yilo425/wheel-leg-robot-delivery/arm/k230_20261018/arm_k230_release_20261018/docs/evidence/cam_detect.jpg

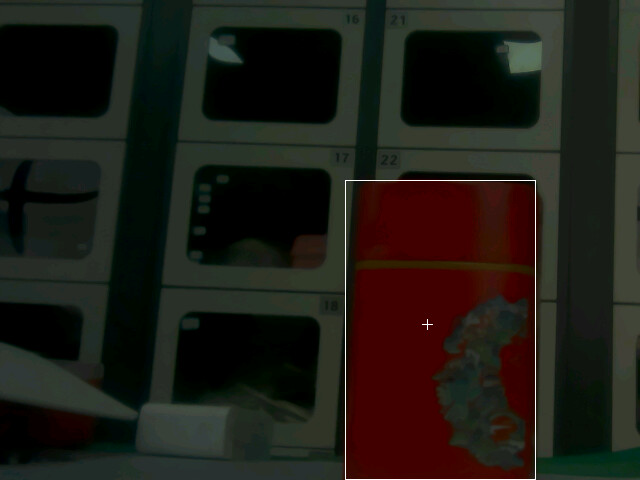
arm/k230_20261018/arm_k230_release_20261018/docs/evidence/cam_detect.jpg
