yilo425/wheel-leg-robot-delivery/doc/board_pinout.md

# ACG720 / GW5AT-138 板载资源与引脚分配

> 来源：`ACG720-138&60K通用管脚分配表.xlsx` + `ACG720-138&60K通用原理图.pdf`
> 器件：**GW5AT-138**（PBGA484A，484 球，22×22）
> 提取日期：2026-10-13

---

## 1. 器件型号的确认过程

**型号走过两次弯路，最终靠芯片自己报的 ID 定案**（详见 §8）：

| 阶段 | 判断 | 依据 | 结果 |
|---|---|---|---|
| 1 | `GW5A-25A` | 口头信息 | ❌ |
| 2 | `GW5AST-138` | 原理图 + 球号范围（22×22 需 PBGA484A） | ❌ 漏看 "S" |
| 3 | **`GW5AT-138`** | **芯片实测 ID = `0x0011081B` = `GW5AT_138_ID`** | ✅ |

### 支持这个判断的证据

| 证据 | 内容 |
|---|---|
| **芯片实测 ID** ★ | `0x0011081B`，对应高云 ID 表里的 `GW5AT_138_ID` |
| 原理图 `U1A/U1B/U1D` | `GW5AT-138K-PG484A`（**没有 S**）|
| 文件名 | "ACG720-**138&60K**通用" |
| 球号范围 | 表里有 `Y18`/`AA21`/`AB20` → 需要 **22 行**（PBGA484A）<br>GW5A-25A 的 UBGA324 只有 **18 行**，装不下 |
| 官网开发板列表 | 同时存在 `DK_START_GW5AST-LV138...` 和 `DK_START_GW5AT-LV138...` —— **两个器件都真实存在** |

> ⚠️ **注意区分**：`GW5AT-138` 和 `GW5AST-138` 是**两个不同的器件**，ID 差一位：
> ```
> 0x0011081B  GW5AT_138_ID     ← 本板
> 0x0001081B  GW5AST_138_ID
> ```

### ⚠️ 但当前装的 Gowin 版本不支持它

**Gowin EDA V1.9.11.03 Education 的器件列表里没有 `GW5AT-138`**，
所以**现在既不能综合、也不能烧录**。需要装 V1.9.12+（建议 Standard 版）。

**详见 §8。**

仿真库**仍然用 `gw5a`** —— `IDE\simlib` 下只有 `gw1n`/`gw2a`/`gw5a` 三个目录。

---

## 2. 板载固定资源（这些引脚不可改）

| 资源 | 球号 | 备注 |
|---|---|---|
| **系统时钟 50MHz** | `Y18` | FPGA_GCLK1，MRCC 时钟专用脚 |
| **按键 S0** | `F15` | |
| **按键 S1** | `A20` | |
| 按键 S2 / S3 | `B20` / `A21` | 备用 |
| **按键 S4** | `B21` | 板上标注为**复位键** |
| **LED0~LED3** | `M22` `N22` `L21` `K21` | 本工程用 |
| LED4~LED8 | `K22` `J22` `H22` `M21` `N19` | 本工程借来做状态指示 |
| **串口 RX** | `F16` | FPGA_UART_RX ← ARM TX （**2026-10-17 从 J21 改到 GPIO0_26**）|
| **串口 TX** | `C19` | FPGA_UART_TX → ARM RX （**2026-10-17 从 M15 改到 GPIO0_25**）|
| I2C SDA / SCL | `D19` / `C20` | **已接 TOF（VL53L0X）**。★ 2026-10-17 从板载 I2C 排针（`M16`/`M13`）**改到 GPIO0 扩展口**：板载那排的针序在丝印上无法确认（标签只覆盖部分列），没有万用表时插错 3V3/GND 会**烧模块**；GPIO0 每个孔都印着球号，零歧义。代价：没有板载 4.7k 上拉，靠模块自带 10k → **I2C 速率降到 100kHz** |
| 调试串口 TX | `M15` | `uart_tx_dbg`（和发给 ARM 的是同一路数据）。⚠️ 实测**接板载 USB 转串口收不到数据**，要接 USB-TTL 才能用 |
| 红外 IR | `F21` | |
| 蜂鸣器 BEEP | `N19` | ⚠️ 与 LED8 同球，需确认 |

### ⚠️ 两处要上板确认

1. **`LED8` 和 `BEEP` 都是 `N19`** —— 可能表笔误，也可能跳线二选一。
   冲突的话把 `speed_scale_dbg[1]` 改到 `GPIO0_22`（`B17`）。
2. **按键极性** —— 表里没写，本工程按**低有效**（按下=0，靠上拉）。
   上板先点灯验证：不按应该是高电平。

---

## 3. GPIO0 扩展排针（36 针，本工程的主战场）

```
GPIO0_0  = A13     GPIO0_9  = E14     GPIO0_18 = D17     GPIO0_27 = E17
GPIO0_1  = A14     GPIO0_10 = C13     GPIO0_19 = C17     GPIO0_28 = D20
GPIO0_2  = A15     GPIO0_11 = B13     GPIO0_20 = E16     GPIO0_29 = C20
GPIO0_3  = A16     GPIO0_12 = D14     GPIO0_21 = D16     GPIO0_30 = E19
GPIO0_4  = A18     GPIO0_13 = D15     GPIO0_22 = B17     GPIO0_31 = D19
GPIO0_5  = A19     GPIO0_14 = C14     GPIO0_23 = B18     GPIO0_32 = F18
GPIO0_6  = F13     GPIO0_15 = C15     GPIO0_24 = C18     GPIO0_33 = E18
GPIO0_7  = F14     GPIO0_16 = B15     GPIO0_25 = C19     GPIO0_34 = F19
GPIO0_8  = E13     GPIO0_17 = B16     GPIO0_26 = F16     GPIO0_35 = F20
```

> 这些球号同时也是**并口 AD/DA、VGA 子板**的引脚（表里 `ad_data[0]=C13` 等）。
> **不插那块子板**才能这么用。

---

## 4. 本工程的引脚分配（`constraints/pin_table.csv`）

**42 个引脚，全部来自板上真实资源，无一处猜测。**

> ⚠️ **本表以 `constraints/pin_table.csv` 为准**（综合时真正用它生成 `top.cst`）。
> 两处曾经不一致、已修（2026-10-17）：升降腿从 3 根线扩成了 6 根
> （`lift_pwm[2]` + `lift_lim_n[2]` + `lift_fault_n[2]`），这里差点没跟上。
> 图片/Excel 里的旧编号不要拿来接线。

### 4.1 板上固定（不可改）

> ⚠️ **串口已经不算"固定"了**（2026-10-17 改）：原本的 `uart_tx/uart_rx`
> 是 `M15`/`J21`，但实测照片确认它们引到板子右上角标着 `UART / TXD / RXD`
> 的**两个小焊盘**上，**插不了杜邦线**。已改到 GPIO0 扩展口的两个空闲脚
> （`C19` / `F16`），见 §4.2。板载 USB 转串口那条路这版固件不再使用。

| 信号 | 引脚 | 说明 |
|---|---|---|
| `clk_50m` | `Y18` | |
| `rst_key_n` | `B21` | S4 |
| `key[0]` / `key[1]` | `F15` / `A20` | S0 / S1 |
| `led[0..3]` | `M22` `N22` `L21` `K21` | |
| ~~`uart_tx` / `uart_rx`~~ | ~~`M15` / `J21`~~ | ❌ 只有焊盘，插不了线 → 已改到 `C19`/`F16` |

### 4.2 GPIO0 —— **建议分配，请按此接线**

> ★ **轮子编号（按位置，全项目统一）**：
> ```
> 0 = 左前 FL -> 左轮   1 = 右前 FR -> 右轮
> 2 = 左后 RL -> 左轮   3 = 右后 RR -> 右轮
> ```
> `STEER_COEF` = `+1, -1, +1, -1`（左 +1 / 右 −1）。
> **必须和 `rtl/app/motion_decision.v` 保持一致** —— 不一致会让转向整个反过来。
>
> 这是**接线约定**，不是板上固定接线。谁先定谁省事。
> 下标约定：**0=左前 1=右前 2=左后 3=右后**。
> ⚠️ 装反了车会原地打转。接好线后**先架空轮子验证转向**。

| 信号 | 引脚 | GPIO0 | 说明 |
|---|---|---|---|
| `m_pwm[0..3]` | `A13` `A14` `A15` `A16` | _0~3 | 四路 PWM |
| `m_dir[0..3]` | `A18` `A19` `F13` `F14` | _4~7 | 四路方向 |
| `m_en` | `E13` | _8 | 驱动使能（**默认下拉=上电停车**）|
| `enc_a[0]` / `enc_b[0]` | `E14` / `C13` | _9 / _10 | 左前 |
| `enc_a[1]` / `enc_b[1]` | `B13` / `D14` | _11 / _12 | 右前 |
| `enc_a[2]` / `enc_b[2]` | `D15` / `C14` | _13 / _14 | 左后 |
| `enc_a[3]` / `enc_b[3]` | `C15` / `B15` | _15 / _16 | 右后 |
| `lift_pwm[0]` / `lift_pwm[1]` | `B16` / `D17` | _17 / _18 | 输出：前腿组 / 后腿组舵机 PWM |
| `lift_lim_n[0]` / `lift_lim_n[1]` | `C17` / `B17` | _19 / _22 | 输入：前/后腿抬起到位（**低有效**）|
| `lift_fault_n[0]` / `lift_fault_n[1]` | `B18` / `C18` | _23 / _24 | 输入：前/后腿舵机故障（**低有效**，不接=1=正常）|
| `goal_reached` | `E16` | _20 | 输入：终点限位（**低有效**，接地=到达；未接=上拉=未到达）|
| `error_flag` | `D16` | _21 | 输出：故障指示 |
| **`uart_tx`** | **`C19`** | **_25** | 输出：→ ARM 的 **RX**（2026-10-17 新增）|
| **`uart_rx`** | **`F16`** | **_26** | 输入：← ARM 的 **TX**（2026-10-17 新增）|
| **`sr04_trig`** | **`F20`** | **_35** | 输出：HC-SR04 触发（`TOF_IF=1` 时用）|
| **`sr04_echo`** | **`E18`** | **_34** | 输入：HC-SR04 回波（**必须 ≤3.3V！**）|

> ★ **接 ARM 的接法（交叉！）**：
> ```
> ARM 排针 11 (UART2_TXD) ──► FPGA 的 F16 孔
> ARM 排针 13 (UART2_RXD) ◄── FPGA 的 C19 孔
> ARM GND ──────────────────── FPGA 的 GND 孔（扩展口上就印着 GND）
> ```
> 两块板都是 3.3V，直连。**GND 那根不能省**。

> ★ **接 HC-SR04 超声波（`TOF_IF=1`）**：
> ```
> 模块 Vcc  ──  3V3（底排第 6）      ⚠️ 先按 3.3V 供电，别上 5V
> 模块 Gnd  ──  GND（顶排第 6）
> 模块 Trig ──  F20（顶排第 1）
> 模块 Echo ──  E18（顶排第 2）
> ```
> ⚠️ **ECHO 是输入，模块按 5V 供电时它会输出 5V —— 会打死 3.3V 的 IO。**
> 宁可欠压不工作（3.3V 供电），也不能过压。要 5V 供电必须在 ECHO 上串
> 1k+2k 分压（5V→3.33V）。
>
> 原理：拉高 TRIG 10µs → 模块发 8 个 40kHz 波 → ECHO 高电平宽度 = 往返时间。
> 声速取 343m/s，`距离(mm) = ticks×450 >> 17`（50MHz 下，误差 <0.15%）。

### 4.3 LED4~8 借来做状态指示

| 信号 | 引脚 | 板上 |
|---|---|---|
| `state_dbg[0..2]` | `K22` `J22` `H22` | LED4~6（状态机编码）|
| `speed_scale_dbg[0..1]` | `M21` `N19` | LED7~8（速度档）|

**GPIO0 还剩 11 个（`_25`~`_35`）** + I2C 排针 + 8 个拨码开关输入，留给 IMU / 后向 TOF / 舵机反馈。

---

## 5. 为什么把两个接口从顶层去掉了

原来 `top.v` 需要 **119 位引脚**，而板子可用 IO 只有 **约 53 个** —— 超出 66 位，**物理上放不下**。

| 去掉的 | 位数 | 理由 |
|---|---|---|
| `uart_rx_ok_cnt` 等 4 个统计端口 | **64** | **纯仿真用**。板上看不到；联调信息走 TELEMETRY 从串口发出。改成 `top.v` 内部 wire，`tb_top_integration` 用层次引用读 |
| `dist_mm[15:0]` + `dist_valid` + `dist_err` | **18** | **16 位并行 TOF 现实中不存在**。真实模块走 I2C/UART（2 根线）。**已落地**：`tof_driver` 走 I2C（`M13`/`M16`），距离在片内组织成 `dist_mm`；`DIST_STUB_MM` 参数只在 `TOF_ENABLE=0` 的联调模式下生效 |

**去掉后 40 位，加上 TOF 的 2 根 I2C = 42 位，稳稳放下，还留 11 个 GPIO0 备用。**

> 这不是"砍功能"，是设计修正：统计端口只在仿真里有意义；TOF 该由一个内部驱动模块解析后输出 `dist_mm`，而不是从 16 根线进来。

---

## 6. 怎么改引脚

**不要直接编辑 `constraints/top.cst`** —— 它是生成的，会被覆盖。

```powershell
# 1) 改 constraints/pin_table.csv（只填 pin 那一列）
# 2) 重新生成
python tools/gen_cst.py
```

脚本会检查：漏填、**重复球号**、引脚名格式（防止把封装脚位序号当成球号）、电气属性取值。

> 手抄 140 行约束最危险的错误不是漏写，而是**把 `m_pwm[2]` 抄成 `m_pwm[1]` 的球号**
> —— Gowin **不会报错**，结果是两个轮子一起动。

---

## 7. 不用的板载资源

| 资源 | 引脚数 | 说明 |
|---|---|---|
| DDR3 | 48 | 本工程不用 |
| USB2.0 (CY7C68013) | 30 | 不用 |
| 以太网 | 15 | 不用 |
| HDMI ×2 | 18 | 不用 |
| TFT + 触摸屏 | 26 | 不用（除非要加显示）|
| 摄像头接口 | 15 | 不用（ARM 侧做视觉）|
| ES8388 音频 | 5 | 不用 |
| 并口 ADC/DAC | 7 | 不用（与 GPIO0 复用，插了子板就不能用 GPIO0）|
| 74HC595 数码管 | 3 | 不用 |
| SD 卡 | 6 | 不用 |

---

## 8. ★ 器件型号的最终确认（2026-10-13，实测）

**型号走过两次弯路，最终靠芯片自己报的 ID 定案。**

| 阶段 | 判断 | 依据 | 结果 |
|---|---|---|---|
| 1 | `GW5A-25A` | 口头信息 | ❌ 错 |
| 2 | `GW5AST-138` | 原理图 `GW5AT-138K-PG484A` + 引脚表球号范围（22×22 需 PBGA484A） | ❌ 仍错（漏看有无 "S"）|
| 3 | **`GW5AT-138`** | **芯片实测 ID = `0x0011081B`** | ✅ **对** |

### 怎么定的案

`programmer_cli` 连上后读出芯片 ID，再从 `jtagserver.exe` 里挖出高云自己的 ID 表：

```
u0001481B  GW5AT_60_ID
u0011081B  GW5AT_138_ID      ← 实测读到的就是这个
u0001081B  GW5AST_138_ID     ← 138 带 S 的是这个（差一位）
u0001281B  GW5A_25_ID
```

### 实测数据

```
Target Cable:  Gowin USB Cable(FT2CH)
1 device(s) found!
ID Code is:     0x0011081B
User Code is:   0x00009480
Status Code is: 0x00026020
```

### ⚠️ 由此引出的硬约束：需要支持 GW5AT-138 的 Gowin 版本

**Gowin EDA V1.9.11.03 Education 不支持 GW5AT-138**（实测）。

它的 `IDE\data\device\device_package.csv` 里 GW5AT 系列只有：

```
gw5ast138b-011  GW5AST-138B  PBGA484A
gw5ast138c-007  GW5AST-138C  PBGA484A
gw5at60b-007    GW5AT-60B    UBGA225
gw5at60b-002    GW5AT-60B    PBGA484A
```

`programmer_cli --device` 的合法取值也只有 14 个，**没有 GW5AT-138**：

```
GW1N-1P5C GW5AST-138B GW5AST-138C GW5AT-60B GW5AS-25B GW1NZ-1
GW1NSR-4C GW1N-9C GW1NR-9C GW2A-18C GW2AR-18C GW5A-25A GW5A-25B GW5ART-15A
```

**症状**：能通信、能读 ID，但 `--run 2/3` 报 `ID code mismatch`，而且**根本没法为它综合**（器件目录里没有）。

**解决**：装 **Gowin EDA V1.9.12 或更新**；建议用 **Standard 版**（免费 license，器件支持最全，教育版器件是精简的）。装的时候**路径必须纯 ASCII**。

> **最省事的办法**：直接问小梅哥 / 看课程资料用的是哪个版本。
