yilo425/wheel-leg-robot-delivery/doc/interface_delivery.md

# 接口交付文档 —— 轮足复合式机器人

> **文档定位**：这是**发给队友的第一份文件**。看到这份文档的人不需要了解 RTL 内部实现，
> 只需要知道「我要接什么线、发什么数据、给我什么数据」。
>
> **配套文档**（需要深入时再看）：
> - `design_guide.md` —— 每个模块的内部运行逻辑（FPGA 组看）
> - `uart_frame_protocol.md` —— 协议完整定义（ARM 组看）
> - `interface_spec.md` —— 模块级信号定义
> - `team_handoff.md` —— 分工与进度总览
>
> **更新时间**：2026-10-04

---

## 0. 这份文档怎么用

| 你是谁 | 优先读 | 你要产出什么 |
|---|---|---|
| **B（ARM 视觉与通信）** | §2、§3、§6 | 摄像头 → 目标检测 → UART 发 `VISION_RESULT` |
| **C（机械与集成）** | §4、§5、§6 | 填 §4 的信息表；确认 §5 的引脚接线 |
| **A（FPGA）** | 全部 | 按 §4/§5 的答复继续设计 |

**§1 所有人都要看** —— 那是整块板子的对外接口全貌。

---

## 1. FPGA 对外接口总表

**开发板**：小梅哥 ACG720 / **GW5AT-138**（`GW5AT-LV138PG484AC1/I0`，PBGA484A）
　　　　⚠️ 是 **GW5AT** 不是 GW5AST（ID 差一位）；工具链见 `doc/toolchain_gowin_modelsim.md`
**顶层模块**：`rtl/top.v`
**端口总数**：22

### 1.1 已实现且仿真验证的接口

| 端口 | 方向 | 位宽 | 电平 | 作用 | 接到哪 |
|---|---|---|---|---|---|
| `clk_50m` | in | 1 | LVCMOS33 | 板载 50MHz 晶振 | 板载 |
| `rst_key_n` | in | 1 | LVCMOS33 | 复位按键，**低有效** | 板载按键 |
| `m_pwm[3:0]` | out | 4 | LVCMOS33 | 4 路电机 PWM | 驱动板 PWM 输入 |
| `m_dir[3:0]` | out | 4 | LVCMOS33 | 4 路电机方向，**1=正转** | 驱动板 DIR 输入 |
| `m_en` | out | 1 | LVCMOS33 | 驱动器使能，**高有效** | 驱动板 EN/STBY |
| `enc_a[3:0]` | in | 4 | LVCMOS33 | 编码器 A 相 | 编码器 A |
| `enc_b[3:0]` | in | 4 | LVCMOS33 | 编码器 B 相 | 编码器 B |
| `key[1:0]` | in | 2 | LVCMOS33 | **低有效**：`key[0]`=启动/停止<br>`key[1]`=**急停** | 板载按键 |
| `led[3:0]` | out | 4 | LVCMOS33 | 状态指示，见 §6.2 | 板载 LED |
| `state_dbg[2:0]` | out | 3 | LVCMOS33 | 主状态机状态（调试） | 预留/逻辑分析仪 |
| `speed_scale_dbg[1:0]` | out | 2 | LVCMOS33 | 速度档位（调试） | 预留/逻辑分析仪 |
| `error_flag` | out | 1 | LVCMOS33 | 曾进入过安全停车（锁存） | 预留/逻辑分析仪 |

**轮编号约定**（★ 全项目统一，机械组按这个接线）：

| 索引 | 位置 | 左/右 | `STEER_COEF` |
|---|---|---|---|
| 0 | 左前 FL | 左 | **+1** |
| 1 | 右前 FR | 右 | **−1** |
| 2 | 左后 RL | 左 | **+1** |
| 3 | 右后 RR | 右 | **−1** |

> **按位置编号**（FL/FR/RL/RR），不是按左右分组。
> 系数和 = 0，所以转向不会附带整体加减速。
>
> ⚠️ **这里曾经出过一个真 bug**：`motion_decision.v` 原来按「0,1=左；2,3=右」
> （按侧面分组），而引脚表按「0=左前 1=右前 2=左后 3=右后」（按位置分组）。
> 两边各自自洽，**合起来就是错的** —— 机械组按位置接好线，转向会整个反过来。
> 2026-10-13 统一成**按位置**（也是 4 轮机器人的通用约定）。

> ⚠️ **这个编号必须由机械组确认**（见 §4）。装反了会导致转向反向。

### 1.2 已定义但**尚未接入 RTL** 的接口

这些端口在 `top.v` 上**已经引出并留了 TODO**，但内部逻辑还没接上：

| 端口 | 方向 | 位宽 | 作用 | 阻塞原因 |
|---|---|---|---|---|
| `dist_mm[15:0]` | — | 16 | TOF 距离读数（mm） | ✅ 已实现（`tof_driver`，I2C）。<br>⚠️ 这三根**不再是 top 的端口**，是 `top.v` §1.5 的内部 wire |
| `dist_valid` | — | 1 | TOF 数据有效 | 同上 |
| `dist_err` | — | 1 | TOF 读取错误 | 同上 |
| `vision_class[7:0]` | in | 8 | 视觉类别码 | **待 `uart_frame` 集成** |
| `vision_valid` | in | 1 | 视觉数据有效 | 同上 |
| `goal_reached` | in | 1 | 到达终点 | 同上 |
| `steer[15:0]` | in | 16 | 转向指令，**有符号，正=右转** | 同上 |
| `lift_done` | in | 1 | 舵机到位 | **待机械组答复（见 §4）** |
| `lift_fault` | in | 1 | 舵机故障 | 同上 |
| `lift_cmd` | out | 1 | **1=抬腿 0=放腿** | 舵机接口待定 |

### 1.3 ✅ UART 已接入（2026-10-08 完成）

**`top.v` 里的 UART 已经接好了** —— `uart_frame` + `vision_rx` + `telemetry_tx`，8 个 tb / 271 项检查全过。

```
top.v 第 125 行： //---------------- ARM 视觉结果 (待 uart_frame) ----------------
top.v 第 367 行： // TODO(uart_frame)   : vision_class / vision_valid / goal_reached / steer / manual_sel
```

**已集成**：`uart_frame` 收发的帧，视觉结果经 `vision_rx` 解析成 `vision_class`/`steer`，
状态经 `telemetry_tx` 每 100ms 回传一帧 TELEMETRY。

**集成后需要新增 2 个端口**：

| 新端口 | 方向 | 电平 | 接到哪 |
|---|---|---|---|
| `uart_tx` | out | LVCMOS33 | **ARM 的 RX** |
| `uart_rx` | in | LVCMOS33 | **ARM 的 TX** |

**接线（只有 3 根线）**：

```
FPGA uart_tx  ──────►  ARM RX
FPGA uart_rx  ◄──────  ARM TX
FPGA GND      ───────  ARM GND      ← ★ 必须共地，否则通信全乱
```

---

## 2. ARM ↔ FPGA 通信接口（UART）

> 完整的协议原文见 `uart_frame_protocol.md`。这里是**够用版**。

### 2.1 物理层

| 项 | 值 |
|---|---|
| 接口 | UART（异步串口） |
| 波特率 | **115200** |
| 数据位 / 校验 / 停止位 | **8N1**（8 数据位，无校验，1 停止位） |
| 电平 | **3.3V TTL** |
| 流控 | 无 |
| 地线 | **必须共地** |

> **电平警告**：树莓派 / K230 / Luckfox 的 GPIO UART 都是 3.3V，**可以直接接 FPGA**。
> 如果用了 5V 逻辑的 USB-TTL 模块调试，**必须加电平转换**，否则会打死 FPGA 引脚。

### 2.2 帧格式

```
+--------+--------+--------+--------+--------+---------+--------+
| 帧头   | 版本   | 帧类型 | 长度   | 数据   | 校验    | 帧尾   |
| 0xAA55 | 0x01   | 1B     | 2B大端 | N 字节 | BCC 1B  | 0x55AA |
+--------+--------+--------+--------+--------+---------+--------+
                     └──────── BCC 计算范围 ────────┘
```

| 字段 | 长度 | 说明 |
|---|---|---|
| 帧头 | 2B | 固定 `AA 55` |
| 版本 | 1B | 当前 `0x01` |
| 帧类型 | 1B | 见 §2.3 |
| 长度 | 2B | **数据段**字节数，**大端**（高字节在前） |
| 数据 | NB | 载荷 |
| 校验 | 1B | **BCC = 版本 ^ 类型 ^ 长度高 ^ 长度低 ^ 所有数据字节**<br>**不含帧头帧尾** |
| 帧尾 | 2B | 固定 `55 AA` |

**帧总长 = 9 + N 字节。**

> **易错点**：帧开销是 **9 字节**（2 头 + 1 版本 + 1 类型 + 2 长度 + 1 校验 + 2 尾），
> 不是 10。我们在自测时就把这个算错过。

### 2.3 帧类型表

| 值 | 名称 | 方向 | 载荷长度 | 说明 |
|---|---|---|---|---|
| `0x01` | `IMAGE_DATA` | FPGA→ARM | 变长 | **预留**，本方案基本不用 |
| `0x02` | **`VISION_RESULT`** | **ARM→FPGA** | 1+7n | **★ B 主要要发的** |
| `0x03` | `ACK` | 双向 | 1 | 确认收到 |
| `0x04` | `CONFIG` | 双向 | 变长 | 参数配置 |
| `0x10` | **`TELEMETRY`** | **FPGA→ARM** | **13** | **★ FPGA 回传状态**<br>（状态1 + 速度2×2 + 距离2 + 姿态2×3） |

**未知类型的处理**：FPGA 侧收到未知类型会**按长度收完但仍丢弃**（保持帧同步不丢）。
所以 ARM 侧发错类型**不会导致通信死掉**，只会被忽略。

### 2.4 载荷格式

#### `0x02 VISION_RESULT`（ARM → FPGA）★ 主要接口

```
+--------+--------+--------+--------+--------+--------+
| 目标数 | 序号   | 类别   | x 中心 | y 中心 | 置信度 |
| 1B     | 1B     | 1B     | 2B     | 2B     | 1B     |
+--------+--------+--------+--------+--------+--------+
   每个目标 7 字节，重复「目标数」次
```

| 字段 | 范围 | 说明 |
|---|---|---|
| 目标数 | 0..8 | **0 表示本帧无目标**（合法，不是错误） |
| 序号 | 0..7 | 目标索引 |
| 类别 | 见下 | 目标类别编码 |
| x 中心 | 0..65535 | **归一化**到 0..65535（与分辨率解耦） |
| y 中心 | 0..65535 | 同上 |
| 置信度 | 0..100 | 百分比 |

**类别编码 → FPGA 动作**：

| 值 | 含义 | FPGA 侧动作 |
|---|---|---|
| `0x00` | 无 | — |
| `0x01` | 人员 | 减速 + 保持距离 |
| `0x02` | 障碍物 | 绕行 |
| `0x03` | 目标点/终点 | 向目标点行进 |
| `0x04` | **低矮障碍** | **触发升降腿越障**（`VIS_LOW_OBST` 参数） |

**归一化坐标的换算**（ARM 侧）：

```python
cx_norm = int(cx_pixel / image_width  * 65535)
cy_norm = int(cy_pixel / image_height * 65535)
```

**FPGA 侧的判决门限**（也已写进协议，ARM 不用管，但知道有好处）：

| x 中心范围 | 判定 |
|---|---|
| `< 21845`（左 1/3） | 目标偏左 |
| `21845 .. 43690`（中 1/3） | 正前方 |
| `> 43690`（右 1/3） | 目标偏右 |

#### `0x10 TELEMETRY`（FPGA → ARM，建议 10Hz）

```
+--------+--------+--------+--------+--------+--------+--------+
| 状态   | 速度L  | 速度R  | 距离   | roll   | pitch  | yaw    |
| 1B     | 2B     | 2B     | 2B     | 2B     | 2B     | 2B     |
+--------+--------+--------+--------+--------+--------+--------+
```

| 字段 | 说明 |
|---|---|
| 状态 | 主状态机编码，见下表 |
| 速度L / 速度R | 编码器计数，**有符号补码，大端** |
| 距离 | TOF 距离，mm |
| roll/pitch/yaw | 姿态角，**0.01 度/LSB**，有符号补码 |

**主状态机编码**（`state_dbg` 同一套）：

| 值 | 状态 | 含义 |
|---|---|---|
| 0 | `S_IDLE` | 空闲 |
| 1 | `S_MANUAL` | 手动 |
| 2 | `S_AUTO` | 自动巡航 |
| 3 | `S_AVOID` | 避障 |
| 4 | `S_LIFT` | 越障（抬腿） |
| 5 | `S_GOAL` | 到达终点 |
| 6 | `S_ESTOP` | **急停** |

#### `0x03 ACK`

载荷 1 字节 = 被确认的帧类型值。

#### `0x04 CONFIG`（双向）

```
+--------+--------+--------+
| 参数ID | 长度   | 值 ... |
| 1B     | 1B     | N 字节 |
+--------+--------+--------+
```

| 参数 ID | 含义 | 长度 | 单位 | FPGA 侧当前默认值 |
|---|---|---|---|---|
| `0x01` | 最大速度 | 2B | 编码器计数/窗口 | 见 `motion_decision.VREF` |
| `0x02` | 避障停车距离 | 2B | mm | **200** |
| `0x03` | 测速窗口 | 2B | ms | 见 `encoder_decode` |
| `0x10` | 升降腿抬升高度 | 1B | 0..100 | — |
| `0x11` | 升降腿动作超时 | 2B | ms | **3000** |

### 2.5 FPGA 侧的健壮性设计（ARM 侧需要知道的）

这些是 **FPGA 已经实现并验证过**的行为，ARM 侧可以依赖：

| 行为 | 说明 |
|---|---|
| **帧内超时保护** | 任何中间状态超过 `FRAME_TIMEOUT`（默认 20ms）没收到下一字节 → **回帧头搜索状态并报 `rx_timeout`**。<br>**所以 ARM 发一半断掉，FPGA 不会永久卡死。** |
| **BCC 错不交付** | 校验失败 → 报 `rx_bcc_err`，**帧被丢弃**，同步自动恢复 |
| **未知类型不丢同步** | 未知类型 → 按长度收完 → 丢弃 → **下一帧照常接收** |
| **前导噪声免疫** | 帧前有任意垃圾字节（包括连续的 `AA`）**都能正确同步** |
| **长度超上限丢弃** | `N > 64` → 整帧丢弃，**缓冲区不会溢出** |

**实测验证**：`tb_uart_frame` **58 项检查全通过**，覆盖了以上全部异常场景。

> 其中最有价值的一条：**故意改坏 BCC 后，紧接着发一帧正常的，FPGA 能立刻收到** ——
> 说明同步不会因为一次错误而丢失。

### 2.6 Python 参考实现

```python
import struct

HDR  = b'\xAA\x55'
TAIL = b'\x55\xAA'
VER  = 0x01

def bcc(data: bytes) -> int:
    """校验范围：版本 + 类型 + 长度(2B) + 数据"""
    x = 0
    for b in data:
        x ^= b
    return x

def pack_frame(ftype: int, payload: bytes) -> bytes:
    body = struct.pack('>BBH', VER, ftype, len(payload)) + payload
    return HDR + body + bytes([bcc(body)]) + TAIL

def vision_result(targets):
    """targets: [(类别, cx_norm, cy_norm, 置信度), ...]"""
    p = bytes([len(targets)])
    for idx, (cls, cx, cy, conf) in enumerate(targets):
        p += struct.pack('>BBHHB', idx, cls, cx, cy, conf)
    return pack_frame(0x02, p)

# 例：1 个目标，类别=人员，中心(0.30, 0.50)，置信度 88%
frame = vision_result([(0x01, int(0.30*65535), int(0.50*65535), 88)])
print(frame.hex(' '))
```

**解析 FPGA 回传**：

```python
def parse_frames(buf: bytearray):
    """从缓冲区里尽量多地解析出完整帧，返回 (帧列表, 剩余缓冲)"""
    frames = []
    while True:
        i = buf.find(HDR)
        if i < 0:
            del buf[:-1]          # 只保留最后一个字节（可能是 0xAA）
            break
        if i > 0:
            del buf[:i]           # 丢掉帧头之前的垃圾
        if len(buf) < 6:
            break
        ver, ftype, n = struct.unpack_from('>BBH', buf, 2)
        total = 9 + n
        if len(buf) < total:
            break
        body = bytes(buf[2:6+n])
        if bcc(body) != buf[6+n] or bytes(buf[total-2:total]) != TAIL:
            del buf[:2]           # 这帧坏了，跳过这个帧头继续找
            continue
        frames.append((ftype, bytes(buf[6:6+n])))
        del buf[:total]
    return frames, buf
```

### 2.7 联调检查清单

**按这个顺序做，每一步都能独立验证：**

- [ ] **① 回环测试**（最简单）：把 ARM 的 TX 和 RX 短接，发什么收到什么 → 验证串口配置对
- [ ] **② PC 侧自测**：用 `tools/verify_uart_frame_model.py` 验证打包/解析逻辑（**已有 39/39 PASS**）
- [ ] **③ 只收不发**：跑通 ARM 接收，看 FPGA 发的 `TELEMETRY` 能不能正确解析
- [ ] **④ 只发不收**：ARM 发 `VISION_RESULT`，用逻辑分析仪/示波器抓 FPGA 的 RX 引脚，核对帧头帧尾
- [ ] **⑤ 故意改坏一个字节的校验**，确认 FPGA **丢弃且不卡死**（FPGA 侧已验证 ✓）
- [ ] **⑥ 连续跑 10 分钟**，统计误帧率；若 > 1%，升级到 CRC16 并把版本升到 `0x02`

> **调试建议**：先用 **USB-TTL 模块 + PC 串口助手**手动发几帧，确认 FPGA 能收到，
> 再接 ARM。这样能把"ARM 代码问题"和"接线/电平问题"分开。

---

## 3. ARM 侧要和 FPGA 对齐的 5 个约定

| # | 约定 | 说明 | 谁拍板 |
|---|---|---|---|
| 1 | **类别编码** | 只能用 §2.4 表里的 `0x00`~`0x04`，扩展要先商量 | B ↔ A |
| 2 | **归一化坐标** | 一律 0..65535，**不要发像素坐标** | B |
| 3 | **发送频率** | 建议 **10Hz**（100ms 一帧）。太快 FPGA 处理不过来，太慢避障反应迟钝 | B ↔ A |
| 4 | **视觉失效时的行为** | FPGA 侧**不依赖** ARM：`vision_valid=0` 时 **按"无障碍但限速"处理**，不会停车也不会飞车 | A（已实现） |
| 5 | **手动遥控通道** | `manual_sel` 已预留（`top.v` 第 216 行），需要时通过 `CONFIG` 帧下发 | 待定 |

> **第 4 条特别重要**：ARM 死机/断线时，机器人**会继续以限速直行**，而不是失控。
> 这是刻意的设计 —— **安全逻辑不能依赖上层是否正确**。

---

## 4. ⚠️ 需要机械组提供的信息（当前阻塞项）

**这份表填完之前，下面这些模块没法继续设计。请 C 逐项填写。**

| # | 需要的信息 | 为什么需要 | 阻塞哪个模块 | 填写 |
|---|---|---|---|---|
| 1 | **驱动形式**（差速 / 麦克纳姆 / 四轮独立） | 决定转向算法：差速是左右反向，麦轮要四轮合成 | `motion_decision` 的 `STEER_COEF0..3` | |
| 2 | **轮径**（mm） | 编码器计数 → 实际线速度的换算系数 | 速度换算、里程计算 | |
| 3 | **轮距 / 轴距**（mm） | 差速转向的角速度换算 | `motion_decision` | |
| 4 | **轮编号约定**（哪个是 0/1/2/3） | 装反了转向会反 | `m_pwm[3:0]` / `enc_a/b[3:0]` 的接线 | |
| 5 | **编码器 PPR**（每圈脉冲数） | 计数 → 转数换算 | 同上 | |
| 6 | **编码器输出类型**（推挽 / 开漏 / 差分） | 开漏**必须开 FPGA 内部上拉**，否则读不到高电平 | `top.cst` 的 `PULL_MODE` | |
| 7 | **编码器供电电压**（3.3V / 5V） | 5V 必须加电平转换 | 硬件接线 | |
| 8 | **电机驱动板型号** | 决定 PWM 频率、死区、使能极性 | `pwm_motor.STEP_DIV` / `ZERO_DEADBAND` | |
| 9 | **驱动板逻辑电平**（3.3V / 5V） | 5V 必须加电平转换 | 硬件接线 | |
| 10 | **★ `lift_done` 从哪来** | 是舵机位置反馈？限位开关？还是固定延时？<br>**三者的 RTL 实现完全不同** | `main_fsm` 的越障阶段 | |
| 11 | **舵机型号与控制方式** | PWM 频率、脉宽范围 | `servo_lift` | |
| 12 | **硬件急停方案** | 现在是软件急停（按键）。<br>**是否需要一路直接切断电机电源的硬件回路？** | 安全设计 | |
| 13 | **FPGA 引脚分配表** | `top.cst` 里全是 `PIN_xx` 占位值 | **上板** | |

### 4.1 第 10 项为什么最关键

`main_fsm` 的越障流程是：

```
抬腿 (lift_cmd=1) → 等 lift_done → 前进 → 放腿 (lift_cmd=0) → 等 lift_done → 完成
```

**`lift_done` 的来源决定了整个阶段的设计：**

| 如果来自… | RTL 要怎么做 |
|---|---|
| **限位开关** | 边沿检测 + 消抖（复用 `encoder_decode` 的滤波思路） |
| **舵机位置反馈**（电位器/PWM 回读） | 需要 ADC 或脉宽测量，**工作量大** |
| **固定延时** | 最简单，但**不可靠**（堵转时不知道） |

**现在 `main_fsm` 里已经用超时兜底**（`LIFT_TIMEOUT_MS = 3000`），
即使 `lift_done` 永远不来，也会在 3 秒后放弃并报 `error_flag` —— **不会卡死**。

---

## 5. 引脚分配现状与待办

### 5.1 现状

`constraints/top.cst` 里**所有管脚号都是 `PIN_xx` 占位值**。

| 端口组 | `.cst` 里有占位吗 |
|---|---|
| `clk_50m` / `rst_key_n` | ✅ |
| `m_pwm[3:0]` / `m_dir[3:0]` / `m_en` | ✅ |
| `enc_a[3:0]` / `enc_b[3:0]` | ✅ |
| `key[1:0]` / `led[3:0]` | ✅ |
| `dist_mm` / `dist_valid` / `dist_err` | ❌ **缺** |
| `vision_class` / `vision_valid` | ❌ **缺** |
| `goal_reached` / `steer` | ❌ **缺** |
| `lift_done` / `lift_fault` / `lift_cmd` | ❌ **缺** |
| `state_dbg` / `speed_scale_dbg` / `error_flag` | ❌ **缺** |
| **UART（`uart_tx` / `uart_rx`）** | ❌ **还没有这个端口** |

### 5.2 上板前的步骤

> **★ 现在不用手抄了。** 引脚改成填一张 CSV，脚本自动生成 `.cst`。
>
> ```
> 1) 编辑 constraints/pin_table.csv   （只填 pin 那一列）
> 2) python tools/gen_cst.py
> 3) 生成 constraints/top.cst
> ```
>
> 脚本会检查：漏填、**重复球号**、引脚名格式（防止把封装脚位序号
> 当成球号填进来）、电气属性取值、以及"现有 .cst 里有信号会被删掉"。
>
> 为什么值得这么做：`top.cst` 每个信号要写两条约束（IO_LOC + IO_PORT），
> 约 70 个引脚 = 140 行，而且 `PULL_MODE`/`DRIVE` 每个信号都不同。
> 手抄最危险的错误不是漏，而是**把 `m_pwm[2]` 抄成 `m_pwm[1]` 的球号**
> —— Gowin 不会报错，结果是两个轮子一起动。
>
> **芯片封装**（本地 Gowin `device_info.csv` 查得）：
>
> | 封装 | 型号 | IO 数 |
> |---|---|---|
> | MBGA121N | `GW5A-LV25MG121NC1/I0` | 82 |
> | UBGA324 | `GW5A-LV25UG324C2/I1` | 222 |
>
> ACG720 上焊的是哪个，看板子背面丝印或手册第一页。

1. 打开小梅哥 ACG720 的**引脚分配表 / 原理图**（拿 `pin_table.csv` 用）
2. 把球号填进 `constraints/pin_table.csv` 的 `pin` 列（例如 `T5`）
3. 用 Gowin IDE 的 **Pin Planner** 复核
4. **每改一次引脚，先烧一个最简 LED 流水灯，确认板子还活着**

### 5.3 电气属性约定（已写在 `.cst` 注释里）

| 信号 | 属性 | 原因 |
|---|---|---|
| 编码器 A/B | `PULL_MODE=UP` | 开漏输出 / 长线更稳 |
| `m_en` | `PULL_MODE=DOWN` | **默认下拉 = 断电停车**（安全） |
| 电机 PWM / 方向 | `DRIVE=8` | 走线较长，提高抗扰 |
| 其余 | `PULL_MODE=NONE` | |

---

## 6. 上电时序与安全逻辑

### 6.1 上电顺序（建议）

```
1. 只给 FPGA 供电，烧 LED 流水灯 → 确认板子活着、时钟在跑
2. 接编码器，手动转轮子 → 看 LED 或 state_dbg 有无变化
3. 接驱动板 + 电机（★ 先架空轮子，不要落地）
4. 接按键，测急停：按 key[1] → motor_enable 应立刻变 0 且 state 进 S_ESTOP
5. 接 TOF → 看 dist_mm 数值是否合理
6. 接 ARM（uart_tx/rx/GND）→ 跑通信联调
7. ★ 全部正常后才落地跑
```

### 6.2 LED 含义（现场调试用）

| LED | 亮表示 |
|---|---|
| `led[0]` | **复位已释放，板子活着**（最基本的心跳） |
| `led[1]` | **电机使能中** |
| `led[2]` | 正在**避障或越障** |
| `led[3]` | **曾经进入过安全停车**（锁存，需复位清除） |

### 6.3 安全逻辑（已实现，答辩素材）

| 机制 | 行为 | 为什么这样设计 |
|---|---|---|
| **急停** | `key[1]` 按下 → **组合逻辑直接断 `motor_enable`，0 拍生效** | 安全不能等状态机 |
| **急停不误报故障** | 人工急停**不**置 `error_flag`，只有超时/舵机故障才置 | 区分"人按的"和"真故障" |
| **所有等待都有超时** | 避障 5000ms / 越障 3000ms / 过障 2000ms | **没有超时就会永久卡死** |
| **视觉失效不停车** | `vision_valid=0` → 按"无障碍但限速"处理 | ARM 死机不应导致机器人停摆 |
| **传感器故障 = 限速** | TOF 报错 → 限速，不是急停 | 单个传感器坏不应让任务失败 |
| **关使能强制归零** | `enabled=0` → 内部占空比强制 0，**不依赖上层是否记得清零** | 防御性设计 |

**急停路径（0 拍生效）** —— 逻辑分两处，**不要写重**：

```verilog
// ① top.v 第 215 行：按键 -> estop 电平
wire estop_sig = ESTOP_FROM_KEY ? ~key[1] : 1'b0;   // key[1] 低有效

// ② main_fsm.v 第 395 行：estop 直接组合进 motor_enable
assign motor_enable = motor_en_r & ~estop;          // ★ 纯组合，0 拍

// ③ top.v 第 343 行：顶层直接引出，**故意不再与一次 estop**
assign m_en = motor_enable_fsm;
```

> **为什么顶层不再与一次**（`top.v` 第 339-341 行有注释说明）：
> `main_fsm` 内部已经把 estop 组合进去了，顶层再做一次是**重复逻辑**，
> 而且会让"到底是谁断的使能"变得难查。
>
> **调试提示**：如果板上没焊 `key[1]`，读到的电平不确定，会看起来像"按了急停、
> 什么都没反应"。这时把 `top.v` 的 `ESTOP_FROM_KEY` 参数置 0 即可绕过。

> 波形实测可以证明：`estop` 和 `motor_enable` **在同一时刻跳变**，状态机晚 1 拍才进 `S_ESTOP`。
> **这是答辩时最值得展示的一张波形图。**

### 6.4 Linux SBC 的启动时间问题

如果用**树莓派 / K230 / Luckfox** 做视觉，**开机要 20~30 秒**。

**结论**：
- **FPGA 不应该等 ARM** —— 上电后 FPGA 独立运行
- 建议**默认进 `S_MANUAL`**，收到第一帧 `VISION_RESULT` 后才允许进 `S_AUTO`
- 这样即使 ARM 还没起来，机器人也是可控的

---

## 7. 队友怎么自己验证（不需要 FPGA 环境）

### 7.1 静态检查（秒级，不需要 ModelSim）

```powershell
cd <工程目录>\robot_project
python tools\check_instantiations.py rtl sim    # 参数名/端口名拼写
python tools\check_literal_overflow.py rtl sim  # 数值溢出
python tools\rtl_lint.py rtl sim                # 通用 lint
python tools\check_encoding.py .                 # 编码/BOM/ASCII（.do 与 .ps1 的硬要求）
python tools\check_decl_order.py                # 先用后声明
```

### 7.2 协议模型验证（秒级，**B 最该跑这个**）

```powershell
python tools\verify_uart_frame_model.py
```

**当前结果：39 项检查全部通过。** 覆盖：
打包/解包、BCC 范围、空载荷、BCC 错、未知类型不丢同步、
前导噪声、长度超上限、帧内超时后恢复、连发多帧。

**B 可以直接在这个文件里加自己的测试用例**，改完秒级出结果 ——
不用等 ModelSim（一轮几分钟）。

### 7.3 完整仿真（分钟级，需要 ModelSim）

```powershell
cd <工程目录>\sim
powershell -ExecutionPolicy Bypass -File toolchain\run_tb.ps1 tb_uart_frame
```

**当前 8 个 Testbench 全部 PASS，共 271 项检查**：

| Testbench | 检查数 |
|---|---|
| `tb_reset_sync` | 11 |
| `tb_pwm_motor` | 21 |
| `tb_encoder_decode` | 17 |
| `tb_uart` | 17 |
| `tb_uart_frame` | **58** |
| `tb_main_fsm` | 63 |
| `tb_motion_decision` | 32 |
| `tb_top_integration` | 52 |

---

## 8. 附：当前已完成 vs 待完成

### ✅ 已完成（仿真验证，可直接用）

| 模块 | 作用 | 验证 |
|---|---|---|
| `reset_sync` | 复位同步 + POR | 11/11 |
| `pwm_motor` ×4 | PWM + 方向 + 死区 + 限幅 | 21/21 |
| `encoder_decode` ×4 | 正交解码 + 滤波 + 测速 | 17/17 |
| `uart_tx` / `uart_rx` | UART 收发 | 17/17 |
| `uart_frame` | **帧协议（含超时/校验/异常保护）** | **58/58** |
| `main_fsm` | **主状态机（避障/越障/急停）** | 63/63 |
| `motion_decision` | **速度闭环 + 转向分配** | 32/32 |
| `top` 集成 | 感知→决策→驱动 全链路 | 52/52 |

### ⏳ 待完成

| 项 | 阻塞于 | 优先级 |
|---|---|---|
| **`uart_frame` 接进 `top.v`** | **A（不需要外部信息，可立即做）** | **★ 高** |
| ~~`clk_gen`（PLL）~~ | **已完成**（`rtl/hal/clk_gen.v`）<br>默认旁路 50MHz，**现在就能上板**；<br>要 100MHz 见该文件开头的生成步骤 | ✅ |
| 引脚分配（`top.cst` 填真值） | §4 第 13 项 | ★ 高 |
| `servo_lift` | §4 第 10、11 项 | 中 |
| ~~`tof_driver`~~ | **已完成**（`rtl/driver/tof_driver.v` + `i2c_master.v`）<br>已例化进 `top.v`，引脚 `i2c_scl=M13` / `i2c_sda=M16`；<br>真实验证见 `sim/tb_top_tof_i2c.v` | ✅ |
| `imu_driver` | 同上 | 中 |
| `display_ctrl` | 需确定显示屏型号 | 低 |
| ARM 选型与采购 | 你方决策 | ★ 高（采购有周期） |

---

## 9. 一句话总结

> **FPGA 侧的"感知 → 决策 → 驱动"整数链路已经全部打通并验证（271 项检查）。**
>
> **现在最缺的三样东西**：
> 1. **`uart_frame` 接进顶层**（我这边可以做，不需要等任何人）
> 2. **机械组回答 §4 的 13 个问题**（尤其第 10 项 `lift_done` 来源）
> 3. **引脚分配表**（上板的前提）

### 1.4 ★ 联调基准帧（ARM 侧实测，已灌进 RTL 验证通过）

ARM 侧实际跑出来的一帧，**已原样灌进 ModelSim 的 `tb_top_integration` 场景 12
并验证产生预期行为**：

```
AA 55 01 02 00 08 01 00 02 80 00 80 00 02 0A 55 AA
│  │  │  │  └─┬─┘ └────┬────┘ │  │  │  │  └─┬─┘ │  │
│  │  │  │    │        │      │  │  │  │    │   │  └─ 帧尾
│  │  │  │    │        │      │  │  │  │    │   └──── BCC = 0A
│  │  │  │    │        │      │  │  │  │    └──────── 置信度 = 2
│  │  │  │    │        │      │  │  │  └───────────── cy = 32768
│  │  │  │    │        │      │  └──┴──────────────── cx = 32768（正中心）
│  │  │  │    │        │      └────────────────────── 类别 = 0x02 障碍物
│  │  │  │    │        └───────────────────────────── 序号 = 0
│  │  │  │    └────────────────────────────────────── 目标数 = 1
│  │  │  └─────────────────────────────────────────── LEN = 8（大端 00 08）
│  │  └────────────────────────────────────────────── TYPE = 0x02 VISION_RESULT
│  └───────────────────────────────────────────────── VER = 0x01
└──────────────────────────────────────────────────── 帧头
```

**总长 17 = 9 + 8** ✓  **BCC 复算 = 0x0A** ✓

FPGA 侧收到后的行为（已实测）：

| 输出 | 值 |
|---|---|
| `uart_rx_ok_cnt` | +1 |
| `uart_rx_err_cnt` | 0（无错帧）|
| `vision_frame_cnt` | +1 |
| `vision_bad_cnt` | 0（格式对）|
| **`state_dbg`** | **`S_AVOID`（3）** ← 类别 0x02 触发避障 |
| `m_en` | 1（限速绕行，不是停车）|
| `speed_scale_dbg` | `SLOW` |

> **为什么这条最有价值**：前面的测试帧都是我们按文档自己造的，
> 只能证明"我按我理解的文档实现了"。这条灌的是**对方真实跑出来的字节**，
> 它证明的是**两边的实现真的对得上**。协议哪天被改动，这里会第一时间红。
>
> 对应测试：
> - `sim/tb_top_integration.v` 场景 12（真实 RTL）
> - `tools/verify_vision_rx_model.py` 第 9 节（解析模型）

### 1.5 视觉类别表（FPGA 侧实现状态）

ARM 发 `VISION_RESULT(0x02)`，载荷里每个目标带一个**类别码**。
`main_fsm` 按这张表动作：

| 类别 | 名称 | FPGA 行为 | 实现位置 |
|---|---|---|---|
| `0x00` | 无 | 不动作（空目标帧也走这条） | — |
| `0x01` | 人员 | 不改状态；靠 `steer` 与限速 | 未实现 |
| `0x02` | 障碍物 | **进 AVOID（限速绕行）** | `VIS_OBST` |
| `0x03` | 目标点 | 不改状态；靠 `steer` 趋向 | 未实现 |
| `0x04` | 低矮障碍 | 进 LIFT（抬腿跨越） | `VIS_LOW_OBST` |

⚠️ **曾经的问题**：只实现了 `0x04`。而 ARM 侧 `camera_vision.py`
固定发 `0x02` —— 两边对不上，结果是"车看到障碍物不躲"。
现在 `0x02` 已实现。

⚠️ **`VIS_HOLD_MS`（默认 300ms）**：ARM 是 10Hz 发的，
`vision_valid` 是**单拍脉冲**。如果不加保持窗口，AVOID 只会持续
1 拍就退出，等于没避障。这个值必须 **大于帧间隔**（1000/TARGET_HZ），
否则每帧之间会解除一次。
