yilo425/wheel-leg-robot-delivery/doc/team_handoff.md

# 团队交接说明（2026-10-04）

> 目的：让组员快速接手，明确**哪些可以直接用**、**哪些卡在外部信息上**。
> 阅读顺序：§0 状态 → §2 文件位置 → §3/§4 分工与阻塞项。

---

## 0. 当前状态一句话

**FPGA 侧的驱动层与应用决策层已完成并全部仿真通过（7/7 Testbench PASS），
但"参数落地"和"上板"卡在机械/硬件接口信息上。**

| 层次 | 状态 |
|---|---|
| 工具链（Gowin ↔ ModelSim） | ✅ 打通 |
| 驱动层（PWM / 编码器 / UART / 复位） | ✅ **仿真通过** |
| 应用层（主状态机 / 运动决策） | ✅ **仿真通过** |
| 顶层集成（`top.v` 接线） | 🔶 **未接**（下一步） |
| 综合 / 布局布线 / 上板 | ⬜ 未开始（引脚是占位值） |
| TOF / IMU / 舵机 / 视觉 | ⬜ 未开始（**等接口信息**） |

---

## 1. 环境前提（组员先读这条）

| 项目 | 要求 |
|---|---|
| Gowin IDE | **`D:\Gowin\Gowin_V1.9.12_x64\Gowin_V1.9.12_x64`**（支持 **GW5AT-138**）<br>⚠️ 旧的 V1.9.11.03_Education 器件表里**没有** GW5AT-138：能综合，但**烧录报 ID code mismatch** |
| ModelSim | SE-64 2020.4，`D:\modeltech64_2020.4` |
| **work 库路径** | **必须纯 ASCII**：本工程用仓库内 `.simlib\work` —— 迁移仓库时跟着走 |
| Gowin 原语库 | 已编译到 `D:\modeltech64_2020.4\gw5a`（**必须与综合器同版本：V1.9.12**），`vsim` 要带 `-L gw5a` |
| 本机路径配置 | `sim\toolchain\toolchain.local.ps1`（不入库）。**不建它，脚本会按内置默认值把 work 库建到仓库外** |
| ModelSim GUI | ✅ **可用** —— 先设 `LM_LICENSE_FILE` 指向 LICENSE.TXT |

详细执行步骤见 `doc/runbook_verify_toolchain.md`。

---

## 2. 核心文件位置

```
robot_project/
│
├── README.md                      ★ 总入口：模块状态、验证数据、工具链说明
├── .gitignore                     ★ 提交前确认没混进 work/ 和 modelsim.ini
│
├── rtl/                           ── 可综合的 Verilog 源码
│   ├── project_config.vh          全局宏（时钟/波特率/PWM 频率）
│   ├── top.v                      ★ 顶层：还没接上 main_fsm / motion_decision
│   ├── hal/
│   │   └── reset_sync.v           复位同步 + 上电复位(POR)
│   ├── driver/                    ── 驱动层（全部已验证）
│   │   ├── pwm_motor.v            单路 PWM + 方向
│   │   ├── encoder_decode.v       正交解码 + 4 倍频 + 测速窗口
│   │   ├── uart_tx.v / uart_rx.v  串口收发（已修 3 个致命 bug）
│   └── app/                       ── 应用层（新建，已验证）
│       ├── main_fsm.v             ★ 主状态机：导航/避障/越障/急停
│       └── motion_decision.v      ★ 运动决策：意图 → 每轮转速（速度闭环）
│
├── sim/                           ── 仿真
│   ├── tb_*.v                     8 个自检 Testbench（271 项检查全部 PASS）
│   ├── tb_uart_frame.v            ★ 帧协议异常场景（58 项：BCC/超时/未知类型/噪声）
│   └── toolchain/                 一键脚本（环境预检、编译、跑测试、生成 .do）
│                                  ⚠️ 旧的 simulate.do 已删除（tb 列表过时 +
│                                     含中文注释，会误导成"全 PASS"）
│
├── constraints/
│   └── top.cst                    ⚠️ 引脚号**全是占位值** PIN_xx，上板前必须替换
│
├── doc/
│   ├── interface_spec.md          ★★ 接口规格（含每个模块的端口/时序/约定）
│   ├── uart_frame_protocol.md     ★ ARM ↔ FPGA 串口协议
│   ├── toolchain_gowin_modelsim.md 工具链原理与三个环境坑
│   ├── runbook_verify_toolchain.md 执行手册（8 道关卡 + 预设命令）
│   ├── progress_review.md         工作复盘：22 个问题及修复
│   └── team_handoff.md            本文档
│
└── tools/                         ── 自建验证工具（Python，无需额外依赖）
    ├── rtl_lint.py                静态检查（模块配平/重复声明/未声明信号）
    ├── check_decl_order.py        "先用后声明"检查（防 vlog-2730）
    ├── check_literal_overflow.py  ★ 32 位溢出检查（这个坑今天踩了 4 次）
    ├── params_check.py            参数自检（PWM 标度/波特率误差/测速窗口）
    ├── verify_uart_model.py       UART 周期精确 Python 模型
    ├── verify_main_fsm_model.py   主状态机 Python 模型（56 项）
    └── verify_motion_decision_model.py  运动决策 Python 模型（39 项）
```

**★ = 组员最需要看的文件。**

---

## 3. ✅ 已经设计完成（可直接使用，无需等待任何人）

### 3.1 驱动层（4 个模块，仿真全通过）

| 模块 | 功能 | Testbench | 结果 |
|---|---|---|---|
| `reset_sync` | 异步 assert / 同步 release + POR | `tb_reset_sync` | 11/11 PASS |
| `pwm_motor` | PWM 载波 + 方向 + 死区 + 限幅 | `tb_pwm_motor` | 21/21 PASS |
| `encoder_decode` | 正交解码 4 倍频 + 测速窗口 | `tb_encoder_decode` | 17/17 PASS |
| `uart_tx` / `uart_rx` | 串口收发（含帧错误/校验） | `tb_uart` | 17/17 PASS |

**这些模块的接口是稳定的，可以放心往上搭。**

### 3.2 应用层（2 个模块，仿真全通过）

| 模块 | 功能 | 结果 |
|---|---|---|
| `main_fsm` | 导航 / 避障 / 越障 / 急停 状态机 | **63/63 PASS** |
| `motion_decision` | 意图 → 每轮目标速度（比例闭环） | **32/32 PASS** |

**关键行为已锁定**：

| 行为 | 实现 |
|---|---|
| 急停 **0 拍**断使能 | `motor_enable = 内部使能 & ~estop`（纯组合） |
| 传感器失效 fail-safe | 限速前进，不冒进也不卡死 |
| 所有等待都有超时保护 | 避障/抬腿/放腿超时 → 安全停车 |
| 每轮独立限幅 | 单轮打滑不拖累其它轮 |

### 3.3 通信协议

- `doc/uart_frame_protocol.md` —— **ARM ↔ FPGA 帧格式已定死**，ARM 同学可直接按此实现
- `doc/interface_spec.md` §3.4/§3.5 —— 应用层端口与约定

### 3.4 验证基础设施

- 7 个自检 Testbench（含 `$fwrite` 落盘，结果不依赖屏幕输出）
- 6 个 Python 静态检查 / 行为模型工具
- 一键编译与跑测试脚本

---

## 4. ⚠️ 需要外部信息才能继续设计的部分

> **这一节是本次交接的重点。** 下面每一项都写清了"缺什么信息"和"缺了会怎样"。

### 4.1 需要【机械组】提供 —— 阻塞 4 个模块

#### (1) 底盘驱动形式 ★最高优先级

**为什么关键**：`motion_decision` 的转向逻辑完全依赖它。

| 需要回答 | 影响 |
|---|---|
| 差速？麦克纳姆？四轮独立？ | `motion_decision` 的 4 个 `STEER_COEF` 系数取值 |
| 轮径（mm）？ | 把"编码器计数/窗口"换算成 mm/s（**上报和路径规划都要用**） |
| 轮距 / 轴距（mm）？ | 转向时的差速比例 |
| 4 个轮子的**编号与位置对应关系**（哪个是左前？） | `top.v` 里通道映射、`duty0..3` 的实际含义 |
| 减速比？ | 编码器计数 → 实际转速的换算 |

**现状**：默认按"左两轮 +1、右两轮 −1"的差速配置写的。
换底盘**只需改参数、不用改逻辑**（这是刻意设计的），但必须知道改什么。

#### (2) 升降腿舵机

| 需要回答 | 影响 |
|---|---|
| 舵机型号、角度范围 | `servo_lift.v` 的脉宽标定（500~2500us？） |
| **是否有位置反馈？** | ⚠️ **`main_fsm` 的 `lift_done` 信号从哪来？** |
| 如果没有位置反馈 | 只能用"时间估计"或加限位开关 —— **这是个必须先定的方案** |
| 抬腿/放腿的动作时间 | `LIFT_TIMEOUT_MS` 阈值 |

> ⚠️ **`lift_done` 的来源是个真实的悬空问题。**
> `main_fsm` 已经预留了这个输入端口并在等它，但没有传感器就没有这个信号。
> 三个可选方案（需机械组确认）：
> 1. 舵机带位置回读 → 直接接
> 2. 加限位开关 → `main_fsm` 直接用
> 3. 都没有 → 用固定延时"假装到位"（最差方案，但能跑通演示）

#### (3) 机械安装与走线

| 需要回答 | 影响 |
|---|---|
| FPGA 板装在哪个位置 | 排线长度、是否需要差分/缓冲 |
| 传感器（TOF/IMU）朝哪个方向 | 安装坐标 → 距离/角度符号约定 |
| 急停按钮装在哪、怎么接 | **见 §4.4 安全性问题** |

### 4.2 需要【电控/机械】提供 —— 阻塞电机驱动与上板

#### (4) 电机与驱动器

| 需要回答 | 影响 |
|---|---|
| 电机型号、额定电压/电流、堵转电流 | 驱动板选型、电源容量 |
| 有刷 / 无刷 / 步进？ | 驱动方式完全不同 |
| 驱动器是**板载 H 桥**还是**外购模块**？ | 接口定义 |
| 驱动器接口形式：`PWM + DIR`？还是别的？ | `pwm_motor.v` 是否够用 |
| 驱动器**逻辑电平**：3.3V 还是 5V？ | **FPGA 是 3.3V，5V 输入需要电平转换** |
| 使能脚极性（高有效/低有效） | `motor_enable` 是否需要取反 |
| 期望 PWM 频率 | `PWM_FREQ_HZ` 参数（现默认 20kHz） |

#### (5) 编码器

| 需要回答 | 影响 |
|---|---|
| 型号、**线数（PPR）** | 测速窗口 `SPEED_WIN` 与 `VREF` 标定 |
| 输出类型：单端 / **差分**（A+/A-）？ | 差分需要额外接收芯片 |
| 输出电平、供电电压 | 电平转换 |
| **每轮一个**还是**每侧一个**？ | `encoder_decode` 例化几路 |
| 是否与电机同轴（在减速前还是后） | 计数换算 |

#### (6) FPGA 板与实际引脚

| 需要回答 | 影响 |
|---|---|
| ~~板子型号确认~~ | ✅ 已确认：**GW5AT-138**（`GW5AT-LV138PG484AC1/I0`）<br>⚠️ 是 GW5**AT** 不是 GW5**AST**（ID 差一位，见 `doc/board_pinout.md` 第 2 节）|
| 板子原理图 / 引脚分配表 | ⚠️ **`constraints/top.cst` 里现在全是占位值 `PIN_xx`** |
| 板上已占用的引脚（LED/按键/晶振/UART） | 避免冲突 |
| 晶振频率（50MHz？） | `CLK_FREQ_HZ` 参数 |

### 4.3 需要【ARM 组】确认

| 需要回答 | 影响 |
|---|---|
| **视觉类别码定义** | `main_fsm` 的 `VIS_LOW_OBST` 现在只定了 `0x04`，其余类别待定 |
| ARM 能否提供 `goal_reached`（到达终点判定） | `main_fsm` 的 `AUTO → GOAL` 转移 |
| 转向指令由谁产生、什么格式 | `motion_decision` 的 `steer` 端口现在给 0（走直线） |
| UART 参数确认 | 已在 `uart_frame_protocol.md` 定义，需 ARM 侧对齐 |
| ARM 是否也需要急停通路 | 两条独立的急停通路更安全 |

### 4.4 ⚠️ 安全性问题（必须有人拍板）

| 问题 | 说明 |
|---|---|
| **急停是硬件断电还是信号级？** | 现在的 `estop` 是**信号级**（进 FPGA 引脚）。<br>如果 FPGA 死机/程序跑飞，信号级急停**可能失效**。 |
| **强烈建议** | 急停按钮**直接串在电机电源回路**上（硬件断电），FPGA 的 `estop` 作为**第二重**保护。<br>这是竞赛答辩时的加分点，也是真正的安全要求。 |
| 电池规格 | 电压/容量 → 影响驱动板与电源方案 |
| **共地方案** | FPGA / 电机 / ARM / 电池**必须共地**，否则串口和编码器会乱 |

---

## 5. 三人分工建议

### A（FPGA 实时控制）—— 当前进度已超前

**已完成**：驱动层 + 应用层 + 验证体系
**下一步**：
1. 把 `main_fsm` + `motion_decision` 接进 `top.v`（替换占位控制律）
2. 拿到接口信息后标定参数（`VREF` / `SPEED_WIN` / PWM 频率）
3. 替换 `constraints/top.cst` 的引脚
4. 实现 `clk_gen`（PLL）、`uart_frame`、`tof_driver`、`servo_lift`
5. 上板调试

### B（ARM 视觉与通信）

**可以立即开始**（不依赖机械信息）：
1. 按 `doc/uart_frame_protocol.md` 实现双向通信
2. 视觉识别（红线：**2026-10-20 前不工作就降级**到颜色/形状识别）
3. 与 FPGA 联调（可先用 ModelSim 的 UART 模型对协议）

**需要 A 提供**：`uart_frame` 模块的最终寄存器/命令表

### C（机械与集成）

**最紧急的产出**：
1. 定底盘驱动形式（**阻塞 A 的转向逻辑**）
2. 定升降腿的到位检测方案（**阻塞 `lift_done`**）
3. 提供电机/编码器/舵机型号与接口
4. 提供 FPGA 板引脚分配表（**阻塞上板**）
5. 定急停方案（**安全要求**）

---

## 6. 组员如何自己验证（不需要 FPGA 环境）

大部分 Python 工具**只依赖标准库**，装个 Python 就能跑：

```powershell
cd robot_project

# 静态检查（不需要 ModelSim）
python tools\rtl_lint.py rtl sim
python tools\check_decl_order.py
python tools\check_literal_overflow.py rtl sim

# 行为模型验证（不需要 ModelSim）
python tools\verify_uart_model.py --clk 100000000
python tools\verify_main_fsm_model.py
python tools\verify_motion_decision_model.py
```

**这是本工程的一个刻意设计**：把"逻辑是否正确"与"工具链是否配好"解耦，
让新成员**不用先折腾环境就能开始验证**。

要跑真正的 ModelSim 仿真，见 `doc/runbook_verify_toolchain.md`。

---

## 7. 优先级（按"阻塞程度"排序）

| 优先级 | 事项 | 阻塞谁 | 需要谁拍板 |
|---|---|---|---|
| **P0** | 底盘驱动形式 + 轮径 + 轮距 | A 的转向逻辑、上报换算 | 机械 C |
| **P0** | 急停方案（硬件断电？） | 安全要求 | 全组 |
| **P0** | FPGA 板引脚分配表 | 上板 | 硬件/机械 C |
| **P1** | 升降腿到位检测方案 | `lift_done` | 机械 C |
| **P1** | 电机/驱动器接口与电平 | 驱动参数落地 | 电控 C |
| **P1** | 编码器线数/类型 | 测速标定 | 电控 C |
| **P2** | 视觉类别码定义 | `main_fsm` 视觉分支 | ARM B |
| **P2** | 转向指令格式 | `steer` 接通 | ARM B / A |

---

## 8. 附：今天修掉的缺陷（可作答辩素材）

| 分类 | 数量 | 典型 |
|---|---|---|
| 环境/工具链 | 3 | 中文路径建库失败、Gowin 原语库未编译、无构建脚本 |
| **RTL 致命缺陷** | 5 | 波特率 32 位溢出、起始位 1 拍、边沿判据写反、POR 旁路死锁、方向语义混淆 |
| RTL 静态审查 | 7 | 重复声明、先用后声明、有符号拼接、位宽截断 |
| Testbench | 7 | 测量时机、位序写反、未声明变量、层次引用 |

**其中 3 个属于"仿真几分钟发现、上板查几天"的类型**（波特率溢出、边沿判据、POR 死锁）。
完整清单见 `doc/progress_review.md`。
