yilo425/wheel-leg-robot-delivery/doc/交付说明.md

# FPGA 代码交付说明

> 交付日期：2026-10-17　提交：`ffbab92`
> 硬件：小梅哥 **ACG720**（Gowin **GW5AT-138**，`GW5AT-LV138PG484AC1/I0`，PBGA484A）
> 工具链：Gowin **V1.9.12**（综合）+ ModelSim SE-64 **2020.4**（仿真）

---

## 1. 这是什么

轮足复合式机器人的 FPGA 主控：

```
感知          决策              执行
TOF ──┐                    ┌── 电机 ×4（PWM + 方向 + 编码器闭环 + 堵转保护）
IMU ──┼─► main_fsm ────────┼── 舵机 ×4（升降腿，50Hz 位置 PWM）
ARM ──┘   (状态机)          └── LED / 串口遥测
   ↑
视觉结果（UART 帧）
```

**核心设计原则**：每个等待都有超时；安全逻辑不依赖上层；输出单拍脉冲；
每个 `always` 都有复位分支；所有阈值参数化。

---

## 2. 目录结构

| 路径 | 内容 |
|---|---|
| **`rtl/top.v`** | **顶层**：所有子模块的例化和连线。改接线、加模块从这看起 |
| `rtl/hal/` | `clk_gen`（时钟）、`reset_sync`（异步复位同步释放）|
| `rtl/driver/` | **硬件驱动层**：`uart_rx/tx`、`pwm_motor`、`encoder_decode`、`servo_lift`、`i2c_master`、`i2c_bus_arb`、`tof_driver`、`imu_driver`、`motor_guard` |
| `rtl/app/` | **应用层**：`uart_frame`（帧收发）、`vision_rx`（视觉解析）、`telemetry_tx`（10Hz 遥测）、`main_fsm`（状态机）、`motion_decision`（闭环决策）|
| **`constraints/pin_table.csv`** | ★ **引脚的唯一真源**（谁改引脚改这里）|
| `constraints/top.cst` | **生成物**，别手改（`python tools/gen_cst.py` 生成）|
| `constraints/top.sdc` | 时序约束（20ns 时钟）|
| `sim/` | 16 个 testbench + I2C 从机模型（VL53L0X / MPU6050）|
| `tools/` | `gen_cst.py`（生成约束）、`check_*.py`（5 个静态检查）、`uart_link_tool.py`（PC 侧串口联调）、`fpga_build/build_all.tcl`（综合脚本）|
| `doc/` | 文档：交接、引脚、协议、踩坑、ARM 接入…… |
| `firmware/robot.fs` | **已构建好的比特流**（就是本提交构建的，可直接烧）|

---

## 3. 怎么构建 / 怎么跑仿真

### 综合 + 生成比特流

```powershell
cd build
D:\Gowin\Gowin_V1.9.12_x64\Gowin_V1.9.12_x64\IDE\bin\gw_sh.exe ..\tools\fpga_build\build_all.tcl
# 成功标志：RESULT_OK
# 产物：build\robot\impl\pnr\robot.fs
```

⚠️ **`build_all.tcl` 里必须列出所有 `.v`** —— 漏一个会报
`ERROR (EX3937) : Instantiating unknown module 'xxx'`。

### 仿真（21 条 tb，825 项检查）

```powershell
$env:LM_LICENSE_FILE = 'D:\modeltech64_2020.4\win64\LICENSE.TXT'
cd sim
& 'D:\modeltech64_2020.4\win64\vsim.exe' -c -do compile_all.do
& 'D:\modeltech64_2020.4\win64\vsim.exe' -c -do run_sim.do
Get-ChildItem *_result.txt | Select-String '^RESULT:'
```

⚠️ **两个必踩的坑**：
1. **加/删了 `.v` 文件** → 必须先改 `sim/toolchain/emit_dofiles.ps1`（`$RtlFiles` / `$SimFiles` / `$Tbs`）
   再重新生成 `.do`，否则编译列表是旧的
2. **中文用户名**：把 `TEMP` 指到纯 ASCII 目录再跑，否则 `vsim` 会以**退出码 7** 挂掉
   （详见 `doc/踩坑与经验.md`）

### 静态检查（改完代码先跑这个，比仿真快）

```powershell
python tools/check_encoding.py .          # 文件编码 / .ps1 的 BOM
python tools/rtl_lint.py rtl sim
python tools/check_instantiations.py rtl sim   # 端口名/位宽对不上
python tools/check_decl_order.py
python tools/check_literal_overflow.py rtl sim
```

---

## 4. 当前状态

### ✅ 已在**实机**验证

| 项 | 证据 |
|---|---|
| 工具链 / 下载 / 综合 | 综合 `RESULT_OK`，SRAM 烧写退出码 0，JTAG 读到 `0x0011081B` |
| LED 冒烟 | 4 灯流水 + 按住 S4 全灭 |
| **ARM ↔ FPGA 串口双向** | 10Hz TELEMETRY（BCC 全对）；发视觉帧 → `AUTO(2)` → `AVOID(3)` |
| **舵机（升降腿）** | 50Hz PWM 稳定；`lift_cmd` 0→0.5ms / 1→2.5ms 两端都到位；`AUTO→LIFT→ESTOP` 全链路 |
| `goal_reached` 极性 bug | 已根治（低有效），`E16` 悬空即可 |

### ✅ 已在**仿真**验证（未上板）

- 电机 PWM / 方向 / 死区（`tb_pwm_motor` 21 项）
- 编码器正交解码 / 测速（`tb_encoder_decode` 17 项）
- 闭环决策（`tb_motion_decision` 32 项）
- **堵转保护 + 软启动**（`tb_motor_guard` 41 项）
- I2C 总线仲裁 / TOF 107 步初始化 / IMU（共 191 项）
- 整机联调（`tb_top_integration` 66 项）

### ⬜ 还没验证

| 项 | 卡在哪 |
|---|---|
| 电机实际转动 / 方向 / 软启动 | 等 7.4V 电池（不能用 FPGA 板供电）|
| 编码器闭环、堵转保护的真实阈值 | 等编码器接线 |
| TOF 实际测距 | **VL53L0X 未到货** |
| IMU 姿态 | MPU6050 未接 |

---

## 5. 接口约定（改之前先看）

### 5.1 引脚（`constraints/pin_table.csv` 是唯一真源）

| 功能 | FPGA 引脚 |
|---|---|
| 串口 TX / RX（**接 ARM**）| **`C19`** / **`F16`** ⚠️ 不是 M15/J21 |
| I2C SCL / SDA（TOF + IMU）| `M13` / `M16` |
| 电机 PWM `[0..3]` | `A13 A14 A15 A16`（左前/右前/左后/右后）|
| 电机方向 `[0..3]` | `A18 A19 F13 F14` |
| 电机使能 `m_en` | `E13`（**默认下拉 = 上电停车**）|
| 编码器 A/B `[0..3]` | `E14/C13` `B13/D14` `D15/C14` `C15/B15` |
| 舵机 `lift_pwm[0..1]` | `B16`（前腿组）/ `D17`（后腿组）|
| 限位 `lift_lim_n[0..1]` | `C17` / `B17`（低有效）|
| 终点限位 `goal_reached` | `E16`（**低有效**）|

### 5.2 串口协议（详见 `doc/uart_frame_protocol.md`）

```
0xAA 0x55 | VER=0x01 | TYPE | LEN(大端2B) | DATA | BCC | 0x55 0xAA
BCC = XOR(VER, TYPE, LEN_H, LEN_L, DATA...)
```

- `0x02 VISION_RESULT`：ARM → FPGA（类别 0x02 障碍物 / 0x04 低矮障碍 …）
- `0x10 TELEMETRY`：FPGA → ARM，10Hz，**13 字节**载荷

### 5.3 关键参数（`rtl/top.v` 的参数区，改这些就能调行为）

| 参数 | 默认 | 作用 |
|---|---|---|
| `TOF_ENABLE` / `IMU_ENABLE` | 1 / 1 | 器件没接时置 0，退回桩数据 |
| `VREF_FULL` | 69 | 满速对应的编码器计数（**要实车标定**）|
| `DIST_STOP_MM` / `DIST_SLOW_MM` | 200 / 500 | 避障阈值 |
| `GUARD_RAMP_STEP` | 8 | 软启动：每 1ms 最多加多少 duty |
| `GUARD_STALL_DUTY` / `STALL_MS` | 40 / 500 | 堵转判定（**要实车标定**）|
| `TELEM_RATE_HZ` | 10 | 遥测频率 |

---

## 6. 不要改的东西（铁律）

1. **`constraints/top.cst` 是生成物** —— 改 `pin_table.csv` 然后 `python tools/gen_cst.py`
   （手抄 140 行约束最危险的错误是"把 `m_pwm[2]` 抄成 `m_pwm[1]` 的球号"，
   Gowin **不报错**，结果是两个轮子一起动）
2. **`.v` 文件不能带 BOM**；`.ps1` **必须带** BOM；`.tcl`/`.sdc` **必须纯 ASCII**
   （Gowin 按 GBK 读，中文注释会烂成 `????`）
3. **Verilog-2001**：不能对 `parameter` 位选；不能在 `always` 里声明 `wire`
4. **每个 `always` 都要有复位分支**
5. **所有等待都要有超时**（串口、I2C、舵机动作都需要，否则丢一帧就永久卡死）
6. **安全逻辑不依赖上层**（急停要在最底层 0 拍生效）

---

## 7. 建议阅读顺序

| 你的角色 | 先看这些 |
|---|---|
| **只想上板跑** | §3 构建 → `firmware/robot.fs` 烧录 → `doc/board_pinout.md` 接线 |
| **改控制逻辑** | `rtl/app/main_fsm.v`（状态机）→ `rtl/app/motion_decision.v`（闭环）→ `tb_main_fsm.v` |
| **改驱动/加外设** | `rtl/top.v` → `rtl/driver/` 里最像的那个模块 → 对应的 `tb_*.v` |
| **接 ARM / 通信** | `doc/arm_bringup.md` → `doc/uart_frame_protocol.md` |
| **排障** | `doc/踩坑与经验.md`（1051 行，全是真踩过的坑）→ `doc/进度与交接.md` |

---

## 8. 一组"改了就会坏"的仿真断言（别人踩过的）

| 断言 | 背后的问题 |
|---|---|
| `tb_motor_guard` 的逐拍斜坡检查 | `motor_guard` 的"下降"必须在 **tick 之外**当拍生效，否则减速晚 1ms（= 刹车延迟）|
| `tb_top_integration` 的 5.2 舵机脉宽 | 必须**量宽度**，不能"采一个瞬间"（50Hz 里高电平只占 5%）|
| `tb_top_integration` 的软启动等待 | 加了 `motor_guard` 后占空比是**爬升**的，启动后不能立刻测 |
| `tb_top_i2c_share` 的交叉污染检查 | 两个 I2C 从机必须"只对命中地址应答"，否则共享总线会互相应答 |
| I2C 仲裁器的释放条件 | 必须"既没请求也不忙"才释放；只看 `!busy` 会提前一拍释放 → 两个 master 撞车 |

---

## 9. 联系人 / 文档索引

| 文档 | 内容 |
|---|---|
| `doc/进度与交接.md` | **总交接**：做了什么、下一步、已知问题 |
| `doc/board_pinout.md` | 板级资源、引脚分配、GPIO0 排针标注 |
| `doc/uart_frame_protocol.md` | 串口帧协议全文 + ARM 侧参考实现 |
| `doc/arm_bringup.md` | K230 接入与联调（给 ARM 侧同学）|
| `doc/踩坑与经验.md` | 工具链/Verilog/时序/脚本/硬件的坑（**排障先看这个**）|
| `doc/toolchain_gowin_modelsim.md` | Gowin ↔ ModelSim 环境配置 |
| `doc/interface_spec.md` | 模块接口规范 |
