yilo425/wheel-leg-robot-delivery/doc/交接文档_20261028.md

# 交接文档（2026-10-28）

> **给谁看**：接下来接手这个项目的人（队友 / 答辩后的自己 / 老师验收）。
> **怎么读**：§0 一句话现状 → §1 有什么 → §2 怎么跑 → §4 哪些验过哪些没验 → §6 下一步。
> **不要**从第一页读到最后，按需跳。

---

## 0. 一句话现状

**FPGA 已经能脱离电脑独立启动（固件固化进板载 Flash），FPGA↔K230 的串口在真机上验通了（276 帧 0 错误）；
车身模型可打印；但电机 / 舵机 / 传感器 / 摄像头还都没上板跑过。**

| 大块 | 状态 |
|---|---|
| RTL 设计 + 仿真 | ✅ 23 个 TB / 886 项检查全过 |
| 综合 + 布局布线 | ✅ `RESULT_OK` |
| **FPGA 独立启动** | ✅ **已实测**（断电重上电 D0 常亮）|
| **FPGA ↔ K230 串口** | ✅ **已实测**（276 帧 / BCC 0 错 / 噪声 0）|
| 车身结构 | ✅ 可打印（两文件交付）|
| **电机转动** | ❌ 未上板（缺硅胶线做动力布线）|
| **舵机动作** | ❌ 未上板 |
| **传感器 / 摄像头** | ❌ 未接 |

---

## 1. 手上有什么

### 1.1 硬件

| 部件 | 型号 | 备注 |
|---|---|---|
| FPGA 板 | 小梅哥 **ACG720**（GW5AT-LV138PG484）| 板载配置 Flash = **GD25Q128**（16MB）|
| 视觉板 | K230 **庐山派 Lite** | 跑 CanMV（MicroPython），从 TF 卡启动 |
| 电机 | **MG310P20** ×4 | 带霍尔编码器，6 线 |
| 电机驱动板 | **D24A** 四路（TB6612 类）| 12 个方向/使能脚 + 4 路 PWM |
| 舵机 | **MG996R** ×4 | 前后两组各 2 只并联使用 |
| 舵机驱动板 | **PCA9685**（16 路 12 bit）| 目前**没启用**，见 §5.4 |
| 主电源 | 3S 锂电（XT60）| 11.1~12.6V |
| 降压 1 | **UBEC 6A**（5/6/7.4V 可跳线）| 给舵机，**必须先调到 6V** |
| 降压 2 | 12V→9V（LM2596 类）| 给 FPGA，**必须先调到 9.0V** |
| 无线/电源 | 充电宝 79×35×27 | 只给 K230 |

### 1.2 软件 / 工具链

| 工具 | 路径 | 用途 |
|---|---|---|
| Gowin IDE | `D:\Gowin\Gowin_V1.9.12_x64\Gowin_V1.9.12_x64` | 综合、布局布线、烧写 |
| Gowin Programmer | 同上 `\Programmer\bin\programmer.exe` | **写 Flash 只能用 GUI** |
| ModelSim | `D:\modeltech64_2020.4` | 仿真 |
| OpenSCAD | `D:\dsh-ws\tools\openscad-2021.01\openscad.exe` | 车身建模 |
| 内置 Python | `C:\Users\忆洛\.dsh\dsh-runtimes\dsh-primary-runtime\dependencies\python\python.exe` | 工具脚本 |

---

## 2. 怎么跑起来（三条命令）

### 2.1 仿真（不需要硬件）

```powershell
cd D:\dsh-ws\robot_project
powershell -ExecutionPolicy Bypass -File sim\toolchain\run_tb.ps1
# 或只跑一个：  ... run_tb.ps1 tb_motion_decision
```

> ⚠️ **ModelSim 在中文用户名下会崩**（`filename is invalid on this platform`），
> 必须在跑之前设：`$env:TEMP='D:\dsh-ws\_tmp'; $env:TMP='D:\dsh-ws\_tmp'`

### 2.2 静态检查

```powershell
powershell -ExecutionPolicy Bypass -File tools\run_checks.ps1
```

检查项：编码 / lint / 例化 / 位宽溢出 / 声明顺序 / 4 个模型自测。

### 2.3 综合

```powershell
# 必须在纯 ASCII 目录下跑（Gowin 不认中文路径）
cd D:\dsh-ws\robot_project\tools\fpga_build
D:\Gowin\Gowin_V1.9.12_x64\Gowin_V1.9.12_x64\IDE\bin\gw_sh.exe build_all.tcl
# 成功标志：输出 RESULT_OK，产物 build\robot\impl\pnr\robot.fs
```

### 2.4 烧写

**A. 烧 SRAM（断电即失效，日常调试用，7 秒）**

```powershell
$PRG = 'D:\Gowin\Gowin_V1.9.12_x64\Gowin_V1.9.12_x64\Programmer\bin\programmer_cli.exe'
& $PRG -d GW5AT-138C --fsFile '<fs路径>' --operation_index 2
```

**B. 烧 Flash（断电不丢，交付/比赛用，约 100 秒）—— 只能用 GUI**

```
programmer.exe
 ① 放大镜 Scan（扫不到就先给板子断电重启）
 ② 双击器件行
 ③ Access Mode : External Flash Mode Arora V
 ④ Operation   : exFlash Erase, Program, Verify Arora V   ← 前后都不能带修饰
 ⑤ File name   : build\robot\impl\pnr\robot.bin            ← 用 .bin，不是 .fs
 ⑥ Save → 点绿色 ▶
```

成功日志：`Try to program spi flash: 0xC22018!` → `Program and Verify Flash successfully.`

---

## 3. 接线（只抄这张表）

> 完整版见 [`doc/接线总表.md`](接线总表.md)；**这里只放最常用的**。

### 3.1 三条红线 ⚠️

```
① FPGA 的 5V/3V3    绝不接驱动板 Vin+
② 驱动板的 5V/3V3   绝不接回 FPGA（两个稳压器倒灌发烫）
③ 舵机电源绝不要从 FPGA 取（MG996R 堵转 1~2.5A）
```

### 3.2 电源

```
电池 XT60
 ├ 红 →[5A 保险丝]→[船型开关]→ 汇流板【+12V】(3P，三格焊通)
 │                                   ├─① 电池+
 │                                   ├─② 驱动板 Vin+（18AWG）
 │                                   └─③ UBEC 红 + DC-DC 红
 └ 黑 →──────────────────────── 汇流板【GND】(3P，三格焊通)
                                     ├─① 电池− + FPGA GND（细线）
                                     ├─② 驱动板 Vin−（18AWG）
                                     └─③ UBEC 黑 + DC-DC 黑

UBEC  OUT 6V → 舵机电源正极
DC-DC OUT 9V → FPGA 的 DC 5.5×2.1 圆口   ★ 先万用表量到 9.0V 再插
充电宝 Type-C → K230
```

### 3.3 信号（FPGA 侧）

| 用途 | 信号 | 球号 | 孔位 |
|---|---|---|---|
| **电机0 左前** | PWM / 方向 / 二方向 | `A13` / `A18` / `F19` | 底20 / 底18 / 底1 |
| **电机1 右前** | | `A14` / `A19` / `F18` | 顶20 / 顶18 / 底2 |
| **电机2 左后** | | `A15` / `F13` / `E19` | 底19 / 底17 / 底3 |
| **电机3 右后** | | `A16` / `F14` / `D20` | 顶19 / 顶17 / 底4 |
| 驱动板 STBY | `m_en` | `E13` | 底16（**建议先悬空**）|
| 编码器 0~3 | A/B | `E14`/`C13`、`B13`/`D14`、`D15`/`C14`、`C15`/`B15` | 顶16/底14、顶14/底13、顶13/底12、顶12/底11 |
| **K230 TX→FPGA** | `uart_rx` | `F16` | **底5** |
| **FPGA→K230 RX** | `uart_tx` | `C19` | **顶7** |
| 升降舵机 前/后 | `lift_pwm[0/1]` | `B16` / `D17` | 顶11 / 底10 |
| 限位 前/后 | `lift_lim_n` | `C17` / `B17` | 顶10 / 底8 |
| 超声波 Trig/Echo | | `F20` / `E18` | 顶1 / 顶2 |
| PCA9685 SCL/SDA | `i2c_scl`/`sda` | `C20` / `D19` | **顶4 / 顶3** |

### 3.4 共地（必须）

| 谁的地 | 接到 |
|---|---|
| 驱动板 GND | FPGA 顶排 6 或 15 |
| 舵机电源负极 | FPGA GND（一根细线）|
| K230 排针 9/14 | FPGA GND |

---

## 4. 哪些验过、哪些没验（重要）

### ✅ 已经在真机上验过

| 项 | 证据 |
|---|---|
| FPGA 加载 / 时钟 / 复位 / LED | LED0 常亮 |
| **Flash 固化 + 独立启动** | 拔 JTAG、断电重上电，D0 仍常亮 |
| **电池→降压→FPGA 整机独立供电** | 2026-10-29 实测：3S 电池 10.92V → 洞洞板汇流 → LM2596 调到 9.2V → FPGA DC 口，**D0 常亮**；焊点带载不烫 |
| **FPGA→PCA9685→舵机（4 只）** | 2026-10-29 晚实测：SERVO_IF=1，I²C 通（D3=led[3]=pca_init_done 亮），**4 只 MG996R 同时抬腿成功**。详见 `doc/舵机链路测试指南.md` |
| **WiFi 遥控全链路** | 2026-10-30 凌晨实测：手机网页 → K230 热点(192.168.169.1:8080) → UART 0x05 帧 → FPGA rc_rx。**D2(rc_active) 常亮、D3(指令非零) 按键时闪烁** = 遥控生效 ✓（电机未接线，只验到指令层）|
| **FPGA→K230 串口** | `board_bringup.run(['listen','3'])` → 276 帧、BCC 0 错、噪声 0 |
| RTL 功能 | 23 TB / 886 检查 / 0 错误 |
| 综合时序 | `RESULT_OK` |

### ❌ 完全没上板验过（风险最高）

| 项 | 为什么重要 |
|---|---|
| **4 个电机转不转 / 方向对不对** | `MOTOR_TEST_MODE=1` 专门用来验这个，**还没跑** |
| **4 个舵机动作 / 行程对不对** | 0.5ms~2.5ms 是否真的对应放平~抬起 |
| **限位开关** | 没接就只能靠超时判到位 |
| **编码器计数** | 速度环的前提 |
| **超声波 / TOF** | 当前固件 `TOF_ENABLE=0`，距离是**桩值 2000mm** |
| **摄像头 / 视觉** | K230 侧代码在，但没接摄像头跑过 |
| **IMU 姿态** | `IMU_ENABLE=0`，roll/pitch/yaw 恒 0 |

---

## 5. 踩过的坑（照这个列表避雷）

### 5.1 工具链

| 坑 | 现象 | 解法 |
|---|---|---|
| Gowin 不认中文路径 | `alog error: failed to open log file` | 在**纯 ASCII 目录**下跑 `gw_sh` |
| 仿真 work 库路径 | ModelSim 报路径错 | 必须纯 ASCII |
| ModelSim + 中文用户名 | `filename is invalid on this platform` | 设 `TEMP`/`TMP` 到 ASCII 目录 |
| `.ps1` 文件编码 | 中文乱码 + 语法报错 | **必须存成 UTF-8 with BOM** |

### 5.2 烧写

| 坑 | 现象 | 解法 |
|---|---|---|
| CLI 写 Flash | `Spi flash not found` | **只能用 GUI**，且 Operation 不能带修饰 |
| `... Background ...` | 容易失败 | 用最普通的 `exFlash Erase,Program,Verify` |
| `... thru GAO-Bridge ...` | `No gao bridge files found` | 没厂商桥接文件，不能用 |
| 做过 SRAM Erase 后 Scan | `No Gowin devices found` | 给板子**断电重启**再扫 |
| `.fs` 当 Flash 文件 | 34.7MB，Flash 只有 16MB | 用 **`robot.bin`（4.33MB）** |
| `robot.fs` 里真正的内容 | 只有 4.33MB | `.fs` 是填充过的容器 |

### 5.3 ARM（K230）侧

| 坑 | 现象 | 解法 |
|---|---|---|
| **`uart.any()` 谎报** | 缓冲有 1320B，`any()` 返回 1 → 每拍只读 1 字节 → 缓冲溢出 → **0 帧 / 299B 噪声** | 直接 `uart.read()`，别问 `any()` |
| TELEMETRY 第 0 字节 | 显示 `UNKNOWN(64)` | `state = b0 & 7`、`flags = (b0 >> 3) & 0xF` |
| USB-CDC 不动 | 打开成功但收不到字节 | **必须拉 DTR/RTS** |
| 没装 CanMV IDE | 不知道怎么跑板端脚本 | 用 `tools/k230_repl.ps1` 直连 REPL |

### 5.4 硬件

| 坑 | 后果 | 解法 |
|---|---|---|
| `STBY` 接 3V3 | 两路稳压器并联**发烫并烧输出级** | 悬空，或由 `E13` 驱动 |
| 驱动板 `Vin−` 与 `Vout+` 看错 | 把地接稳压输出 = 短路 | 只接顶部 `Vin+`/`Vin−` |
| 电机 6 针接中间 4 针 | 电机永远不转 | M+/M− 只接**最上、最下**两针 |
| 9V 没调就插 FPGA | 烧 FPGA | **先量到 9.0V** |
| 超声波接 5V | ECHO 输出 5V 打死 3.3V IO | 一定用 **3.3V** 供电 |
| 螺丝端子夹不住细线 | 一拽就掉 | 线**折两折**再夹（或上锡 / 管型端子）|
| 面包板走 12V | 触点额定 1A，会熔化 | **绝对不行**，用螺丝端子/杠杆端子 |

### 5.5 结构（OpenSCAD）

| 坑 | 现象 | 解法 |
|---|---|---|
| 通风孔挖到定位柱柱脚 | 柱子悬空，STL 实体数从 2 变 3 | 已加 `MOD_POSTS` + `vent_hits_post()` 自动避让 |
| `use <f>` 不导入顶层变量 | 参数全是 0 | 必须用 `include` |
| 共面 | `not a valid 2-manifold` | 错开 0.1mm |
| 中文文件名 | OpenSCAD 不能 `-D PART=` | 用临时文件改 `PART` |

---

## 6. 下一步（按优先级 + 工作量）

| # | 任务 | 需要什么 | 工作量 | 备注 |
|---|---|---|---|---|
| 1 | **把修好的两个 `.py` 拷到 K230 卡** | 读卡器 | 5 min | 否则重启后又变成旧代码 |
| 2 | **验电机方向** | 5A 保险丝 + 轮子离地 | 30 min | SRAM 烧 `robot_motortest.fs` |
| 3 | **验舵机行程** | UBEC 调好 6V | 30 min | 看 0.5ms 是否真放平 |
| 4 | **正式 12V 布线** | **硅胶线（还没到）** | 2 h | 见 §3.2 |
| 5 | 验编码器计数 | 电机能转 | 1 h | 手转轮子看计数方向 |
| 6 | `goal_reached` 极性修正 | 改 1 行 + 综合 | 20 min | 现在位=1 表示"**未**到达" |
| 7 | 接超声波 / TOF | 模块 | 1 h | 要把 `TOF_ENABLE` 改 1 |
| 8 | K230 接摄像头跑视觉 | 摄像头排线 | 2 h | 代码在 `arm/` |
| 9 | IMU 姿态解算 | IMU 模块 | 1~2 天 | 目前 roll/pitch/yaw 恒 0 |
| 10 | 车身端子排槽缩到 30×10 | — | 10 min | 现在 78mm 配 5 位块太松 |

---

## 7. 文件地图（找东西先看这里）

```
robot_project/
├─ rtl/                    FPGA 源码
│   ├─ top.v               顶层（所有参数开关都在开头）
│   ├─ app/                uart_frame / vision_rx / config_rx / telemetry_tx / main_fsm / motion_decision
│   ├─ driver/             uart_tx/rx、pwm_motor、motor_guard、encoder_decode、servo_lift、i2c_master、tof_*、imu_driver
│   └─ hal/                clk_gen、reset_sync
├─ constraints/
│   ├─ pin_table.csv       ★ 引脚唯一权威（带孔位）
│   ├─ top.cst             由 csv 生成
│   └─ top.sdc             时钟约束
├─ sim/                    Testbench（23 个）+ toolchain 脚本
├─ mech/                   车身 + 零件（OpenSCAD / STL）
│   ├─ body_v5.scad        ★ 主车身（PART = lower/upper/print）
│   ├─ body_v5_print.stl   ★ 打印交付（两层并排）
│   ├─ parts_all.stl       ★ 打印交付（零件板 8 件）
│   └─ leg_70mm.scad       腿
├─ arm/                    K230 侧 Python
├─ tools/                  检查脚本 + k230_repl.ps1 + fpga_build/
├─ doc/                    ★ 文档都在这里
└─ build/                  综合产物（robot.fs / robot.bin / 报告）
```

### 文档怎么找

| 想干什么 | 看哪个 |
|---|---|
| **现在能做什么、卡在哪** | 本文 §0、§4 |
| 接线 | [`接线总表.md`](接线总表.md) |
| 供电与安全 | [`供电与接线方案.md`](供电与接线方案.md) |
| 协议细节 | [`uart_frame_protocol.md`](uart_frame_protocol.md) |
| 上板检查单 | [`明日上板检查单.md`](明日上板检查单.md) |
| 引脚 | [`board_pinout.md`](board_pinout.md) / `constraints/pin_table.csv` |
| 车身改动历史 | [`v5待改清单.md`](v5待改清单.md) |
| 装配 / 打印参数 | [`v5装配打印说明.md`](v5装配打印说明.md) |
| 最近的收工记录 | [`收工记录_20261027.md`](收工记录_20261027.md) |
| K230 板端怎么跑 | [`arm_bringup.md`](arm_bringup.md) |

---

## 8. 常用命令速查

```powershell
# 仿真（先设 TEMP 避开中文用户名）
$env:TEMP='D:\dsh-ws\_tmp'; $env:TMP='D:\dsh-ws\_tmp'
powershell -ExecutionPolicy Bypass -File sim\toolchain\run_tb.ps1

# 静态检查
powershell -ExecutionPolicy Bypass -File tools\run_checks.ps1

# 综合
cd D:\dsh-ws\robot_project\tools\fpga_build
D:\Gowin\Gowin_V1.9.12_x64\Gowin_V1.9.12_x64\IDE\bin\gw_sh.exe build_all.tcl

# 烧 SRAM（日常调试）
& 'D:\Gowin\Gowin_V1.9.12_x64\Gowin_V1.9.12_x64\Programmer\bin\programmer_cli.exe' `
  -d GW5AT-138C --fsFile 'D:\dsh-ws\robot_project\build\robot\impl\pnr\robot.fs' --operation_index 2

# 和 K230 REPL 对话（免 CanMV IDE）
powershell -ExecutionPolicy Bypass -File tools\k230_repl.ps1 `
  -Cmd "board_bringup.run(['listen','3'])" -Wait 8

# 导出车身 STL
cd mech
C:\...\openscad.exe -o body_v5_print.stl --export-format binstl body_v5.scad
```

---

## 9. 固件参数开关（`rtl/top.v` 开头）

| 参数 | 当前值 | 含义 |
|---|---|---|
| `MOTOR_TEST_MODE` | **0** | 1 = 4 轮同步脉冲自测（绕开状态机）|
| `TOF_ENABLE` | **0** | 0 = 距离用桩值 `DIST_STUB_MM=2000` |
| `TOF_IF` | **1** | 0 = I²C VL53L0X，1 = HC-SR04 |
| `SERVO_IF` | **0** | 0 = 直接 PWM（2 根脚），1 = PCA9685 |
| `IMU_ENABLE` | **0** | 1 才解算姿态（和 PCA9685 抢 I²C）|

> ⚠️ `SERVO_IF=1` 的前提是 `TOF_IF=1` 且 `IMU_ENABLE=0`（I²C 只有一条）。

---

## 10. 给接手人的三句实话

1. **RTL 不是瓶颈** —— 仿真和综合都过了，卡的是**硬件装配和实测**。
2. **最该先做的是"验电机方向"** —— 30 分钟，能把最大的不确定性消掉，而且是唯一必须"轮子离地"做的。
3. **所有"参数/引脚"改动只改两处**：`constraints/pin_table.csv`（引脚）和 `rtl/top.v` 开头的参数区（功能开关），别的地方都是派生的。
