yilo425/wheel-leg-robot-delivery/doc/交接文档_20261102.md

# 轮足机器人 · 项目交接文档

> 用途：供队友制作 PPT / 答辩材料
> 更新：2026-11-02
> 状态：**硬件全通、基本功能可用、进入联调收尾**

---

# 一、项目一句话介绍

**一台四足四轮的运动机器人**：四条腿用舵机做「站立高度调节」，四个轮子用直流减速电机做「全向移动」，主控用 **FPGA + K230 双芯片**，手机连 WiFi 就能遥控。

---

# 二、系统架构

```
        手机浏览器（WiFi）
                ↓ HTTP
    ┌───────────────────────┐
    │   K230 庐山派 Lite    │  ← MicroPython / CanMV
    │   · HTTP 服务器       │
    │   · 网页控制界面      │
    │   · 视觉（预留）      │
    └───────────┬───────────┘
                │ UART 115200（3 根线）
                ↓
    ┌───────────────────────┐
    │  FPGA GW5AT-138       │  ← Verilog，50MHz
    │   · 遥控帧解析        │
    │   · 运动决策（差速）  │
    │   · 速度闭环/开环     │
    │   · 电机 PWM 生成     │
    │   · 舵机 I²C 控制     │
    │   · 堵转保护/软启动   │
    └────┬────────────┬─────┘
         │            │
    ┌────↓────┐  ┌────↓──────┐
    │ TB6612  │  │ PCA9685   │
    │ 4 路驱动│  │ 16 路 PWM │
    └────┬────┘  └────┬──────┘
         ↓            ↓
    4× MG310     4× MG996R
    （轮子）      （腿）
```

## 为什么用双芯片

| 芯片 | 负责 | 优势 |
|---|---|---|
| **FPGA** | 实时控制（PWM、编码器、保护） | **微秒级确定性**，不卡顿 |
| **K230** | 网络、界面、视觉 | Python 开发快，能跑 AI |

**分工原则**：实时的事给 FPGA，复杂的事给 K230 ✓

---

# 三、硬件配置

## 3.1 主要器件

| 类别 | 型号 | 数量 | 说明 |
|---|---|---|---|
| **主控 FPGA** | Gowin **GW5AT-LV138**PG484 | 1 | 小梅哥 ACG720 开发板，50MHz |
| **协处理器** | **K230** 庐山派 Lite | 1 | 双核 RISC-V，跑 MicroPython |
| **电机** | **MG310** 直流减速电机 | 4 | 1:20 减速，绕组 60Ω，2S 额定 7.4V |
| **舵机** | **MG996R** | 4 | 金属齿，扭矩 9.4kg·cm |
| **电机驱动** | **TB6612FNG** 四路板 | 1 | 1.2A/路，峰值 3.2A |
| **舵机驱动** | **PCA9685** | 1 | 16 路 12 位 PWM，I²C 控制 |
| **测距** | HC-SR04 超声波 | 1 | + VL53L0X ToF（预留）|
| **电池** | 3S 锂电池 | 1 | 12.6V 满电 |

## 3.2 整机参数

| 参数 | 数值 |
|---|---|
| **车身尺寸** | 242 × 150 mm（两层，下层 45mm + 上层 50mm）|
| **轮距 W** | **230 mm** |
| **轮径 D** | 48 mm |
| **整机重量** | 约 1.2 kg（估）|
| **最大速度** | 约 1.26 m/s（实测 40% 时 0.50 m/s）|
| **最小转弯半径** | **115 mm**（= W/2，绕内侧轮原地转）|
| **站立高度调节** | 0 → 45°（舵机转动），约 2 秒行程 |

## 3.3 供电链路

```
3S 电池 12.6V
  ├─→ 5A 保险丝 ─→ 驱动板 Vin（电机）
  ├─→ LM2596 降压 ─→ 9.2V ─→ FPGA
  ├─→ UBEC 降压   ─→ 5.16V ─→ PCA9685 舵机电源
  └─→ FPGA 3.3V   ─→ PCA9685 逻辑电源
```

**⚠️ 关键**：全系统必须**共地**，否则串口通信不通 ✓

---

# 四、软件功能

## 4.1 已实现功能

| # | 功能 | 实现方式 |
|---|---|---|
| 1 | **手机 WiFi 遥控** | K230 建热点 `RobotRC`，HTTP 服务器 8080 端口 |
| 2 | **零 JS 控制网页** | 纯 HTML + 服务端渲染（手机浏览器不一定执行 JS）|
| 3 | **前进/后退/左转/右转/停止** | 差速转向 |
| 4 | **连续调速** | 0~100% 线性，可选 40% / 80% |
| 5 | **站立高度升降** | 4 舵机同步，慢速 2 秒（限流保护）|
| 6 | **限位保护** | 到位后继续按键无反应（pos 饱和）|
| 7 | **堵转保护** | 占空比大 + 编码器不动 → 断电冷却 |
| 8 | **软启动斜坡** | 占空比每毫秒最多涨 8/128，约 16ms 到满 |
| 9 | **遥控看门狗** | 500ms 收不到帧就自动停车 |
| 10 | **遥测上报** | FPGA 10Hz 上报状态/距离给 K230 |

## 4.2 通信协议

```
帧格式：AA 55 | VER | TYPE | LEN(2B) | DATA | BCC | 55 AA
BCC = XOR(VER, TYPE, LEN_H, LEN_L, DATA...)

上行（K230 → FPGA）：
  0x02 VISION_RESULT  视觉结果
  0x04 CONFIG         配置（vref/限速/站立高度/手动模式）
  0x05 RC_CMD         遥控指令（steer, speed, seq）

下行（FPGA → K230）：
  0x10 TELEMETRY      遥测（10Hz，13 字节）
```

**RC_CMD 字段**：
```
steer : int8   -100..100（正 = 右转）
speed : uint8  bit7 = 后退标志，bit6:0 = 0..100%
seq   : uint8  自增序号
```

---

# 五、关键技术点（PPT 可重点讲）

## 5.1 双芯片异构架构

```
FPGA 做实时（微秒级）
K230 做网络/AI（Python 生态）
    ↓
既保证了运动控制的确定性，又保留了上层开发的灵活性
```

## 5.2 差速转向的按比例偏置

```verilog
bias = base × steer / 100
target = base ± bias
```

```
steer = 100%  →  内侧轮 = 0，外侧轮 = 2×base
              →  绕内侧轮原地转，最小半径 R = W/2 = 115mm
steer = 0     →  直行
```

**相比"固定偏置"的优势**：转向幅度和车速联动，慢速不会转过头，快速不会转不动 ✓

## 5.3 舵机"慢速限流"升降

```
102 个计数（45°），每 20ms 走 1 个 → 约 2 秒走完
    ↓
舵机启动电流是运行电流的 3~5 倍
慢速转动 ⇒ 峰值电流小 ⇒ 不烧舵机、不拉垮电源 ✓
```

## 5.4 编码器闭环 + 开环兜底

```
正常：duty = (目标速度 - 编码器反馈) >> KP_SHIFT   ← 闭环
异常：编码器断线/极性反 → 自动切开环 duty = ±base ← 兜底
    ↓
防止"编码器坏了机器人自己跑到满速"
```

## 5.5 多层安全保护

| 层级 | 保护 |
|---|---|
| 遥控层 | 500ms 看门狗 |
| 决策层 | 急停优先级最高 |
| 驱动层 | 堵转检测 + 软启动 |
| 硬件层 | 3S 电池 + 5A 保险丝 |

---

# 六、验证与测试

## 6.1 仿真验证

| 测试平台 | 覆盖内容 | 结果 |
|---|---|---|
| `tb_reset_sync` | 复位同步 | 11 项通过 |
| `tb_pwm_motor` | PWM 生成 | 21 项通过 |
| `tb_encoder_decode` | 编码器解码 | 17 项通过 |
| `tb_uart` | 串口收发 | 17 项通过 |
| `tb_motion_decision` | 运动决策/差速 | 通过 |
| `tb_pca9685_drv` | 舵机 I²C 时序 | 通过 |
| `tb_top_integration` | 顶层集成 | 通过 |

## 6.2 静态检查

```
tools/run_checks.ps1  →  12 项全部通过
```

## 6.3 实机验证

| 项 | 结果 |
|---|---|
| 四个电机独立转动 | ✅ |
| 四个电机同时同向 | ✅ |
| 速度 40% / 80% 响应 | ✅ |
| 舵机升降（2 秒行程）| ✅ |
| 限位（到位无反应）| ✅ |
| 手机网页遥控 | ✅ |
| 串口双向通信 | ✅ |
| 30° 装配偏差补偿 | ✅ |

---

# 七、踩过的坑（很好的"工程实践"素材）

| # | 问题 | 根因 | 解决 |
|---|---|---|---|
| **1** | 网页"一直断开闪烁" | HTTP 热路径每次请求写 2~4 次 SD 卡日志，单请求 100~200ms，浏览器 100ms 轮询必然超时 | 关掉热路径日志，只保留开关 |
| **2** | 点按钮"网页无法打开" | 参数字典漏了键 → `KeyError` → 连接被掐断 | 去掉白名单，全部用 `.get()` |
| **3** | 网页只显示一半 | MicroPython 的 `socket.send()` 可能只发一部分，剩余被丢弃 | 改成循环发送直到发完 |
| **4** | 所有网址一片空白 | 文件是 **CRLF 换行**，MicroPython 在跨行表达式处报 SyntaxError → 模块导入失败 | 强制 LF 换行（加了 `.gitattributes`）|
| **5** | **电机全不转** | **STBY（待机）脚没接** → 驱动芯片一直待机 | 接 FPGA 的 E16 |
| **6** | 某一路电机永远高速 | 该路**编码器 A/B 接反** → 闭环变正反馈 → 积分跑飞 | 改开环，或修正编码器极性 |
| **7** | 驱动板单通道烧毁 | ①带电接线短路 ②电机堵转（安装螺丝压歪电机轴）| 加保险丝 + 断电接线 + 装前手转确认 |
| **8** | 每次复位行为都变 | 固件只在 SRAM，断电/复位回旧 Flash | 固化 Flash |

## 最值得讲的一条

> **"电机一转不转"这个问题，查了整整两天。**
> 最后发现是 **STBY 使能脚没接** —— 一个信号线的问题，
> 却表现为"代码、驱动板、电机全都不对"。
> **教训：排障要先确认「使能」和「供电」，再查逻辑。**

---

# 八、当前状态与局限

## 8.1 已完成 ✅

```
✅ 双芯片架构通信
✅ 手机 WiFi 遥控（前进/后退/转向/停止）
✅ 连续调速
✅ 站立高度升降 + 限位
✅ 四轮都能转动
✅ 速度指令正确响应
✅ Flash 固化（断电不丢）
```

## 8.2 已知问题 ⚠️

| # | 问题 | 影响 |
|---|---|---|
| 1 | **转向时前后轮方向不一致** | 转向会别扭（同侧前后轮反向）|
| 2 | **FPGA 两个 IO（C14/B15）已损坏** | D 通道的方向信号改用了 F19/F18 飞线 |
| 3 | 编码器极性未逐一确认 | 目前用开环控制，无闭环调速 |
| 4 | 无 5A 保险丝 | 短路时无保护 |

## 8.3 未实现（未来工作）

| # | 功能 | 说明 |
|---|---|---|
| 1 | **视觉识别** | K230 已有摄像头接口，可跑 YOLO |
| 2 | **自动寻路** | FPGA 已有避障状态机框架 |
| 3 | **精确 90° 转弯** | 需要定时发帧 + 实测标定 |
| 4 | **闭环调速** | 确认编码器极性后可恢复 |
| 5 | **越障** | 舵机抬腿 + 超声波配合 |

---

# 九、PPT 可用的数字

| 数字 | 含义 |
|---|---|
| **50 MHz** | FPGA 主频 |
| **20 kHz** | 电机 PWM 频率 |
| **100 kHz** | I²C 总线频率 |
| **115200** | 串口波特率 |
| **20 Hz** | 遥控帧发送频率 |
| **500 ms** | 遥控看门狗超时 |
| **2 秒** | 舵机从最高到最低的行程时间 |
| **1024 级** | 舵机 PWM 分辨率（12 位）|
| **115 mm** | 最小转弯半径 |
| **230 mm** | 轮距 |
| **1.26 m/s** | 理论最大速度 |
| **4.13 MB** | FPGA 固件大小 |
| **12 项** | 静态检查通过数 |
| **7 个** | 仿真测试平台 |

---

# 十、代码结构

```
robot_project/
├── rtl/                    FPGA 源码
│   ├── top.v               顶层（引脚、实例化、参数）
│   ├── app/                应用层
│   │   ├── main_fsm.v      主状态机（IDLE/MANUAL/AUTO/AVOID）
│   │   ├── motion_decision.v  运动决策（差速、速度环）
│   │   ├── rc_rx.v         遥控帧解析
│   │   ├── uart_frame.v    串口组帧/解帧
│   │   ├── config_rx.v     配置帧处理
│   │   └── stance_ctrl.v   站立高度控制
│   ├── driver/             驱动层
│   │   ├── pwm_motor.v     PWM 生成
│   │   ├── motor_guard.v   堵转保护/软启动
│   │   ├── pca9685_drv.v   舵机 I²C 驱动
│   │   └── encoder_decode.v 编码器解码
│   └── common/             通用模块
├── arm/                    K230 侧
│   ├── main.py             开机启动器
│   ├── wifi_rc.py          遥控服务器（HTTP + 网页）
│   ├── uart_proto.py       串口协议库
│   └── camera_vision.py    视觉（预留）
├── sim/                    仿真测试
├── tools/                  构建/检查/烧录脚本
├── mech/                   机械 3D 模型（OpenSCAD）
├── constraints/            引脚约束
└── doc/                    文档
```

---

# 十一、运行方式

```
① 上电（FPGA + K230）
② 手机连 WiFi：SSID = RobotRC，密码 = 12345678
③ 浏览器打开：http://192.168.169.1:8080/h
④ 点按钮控制
```

## 网页按钮

```
【升高】【降低】      站立高度
【前进 40%】【前进 80%】  前进
【右转】【左转】      差速转向
【后退】              后退（当前版本有 bug，先别用）
【停】                立即停车
```

---

# 十二、一句话总结（答辩用）

> **本项目用 FPGA + K230 双芯片架构实现了一台四足四轮机器人：**
> **FPGA 负责 50MHz 下的实时运动控制（PWM、编码器、差速、保护），**
> **K230 负责 WiFi 通信与人机交互；**
> **完成了手机网页遥控、连续调速、站立高度调节等功能，**
> **并通过 7 个仿真测试平台和 12 项静态检查验证了设计的正确性。**

---

# 十三、完整接线表

> 详见独立文档：[`doc/接线表_20261102.md`](接线表_20261102.md)
> 本节只放 PPT 用的汇总版

## 13.1 FPGA 排针坐标

```
顶排（左→右）：
 1 F20 | 2 E18 | 3 D19 | 4 C20 | 5 E17 | 6 GND | 7 C19 | 8 B18 | 9 D16 | 10 C17
11 B16 |12 C15 |13 D15 |14 B13 |15 GND |16 E14 |17 F14 |18 A19 |19 A16 |20 A14

底排（左→右）：
 1 F19 | 2 F18 | 3 E19 | 4 D20 | 5 F16 | 6 3V3 | 7 C18 | 8 B17 | 9 E16 | 10 D17
11 B15 |12 C14 |13 D14 |14 C13 |15 5V  |16 E13 |17 F13 |18 A18 |19 A15 |20 A13
```

## 13.2 四路电机（每路 3 根控制 + 2 根编码器）

| 通道 | 车轮 | PWM | 方向1 | 方向2 |
|---|---|---|---|---|
| **A** | 左前 | 顶16 `E14` | 顶18 `A19` | 顶17 `F14` |
| **B** | 左后 | 底16 `E13` | 底18 `A18` | 底17 `F13` |
| **C** | 右后 | 顶10 `C17` | 顶12 `C15` | 顶11 `B16` |
| **D** | 右前 | 底10 `D17` | **底1 `F19`** ⚠️ | **底2 `F18`** ⚠️ |

| 公共 | **STBY** | **底排 9 `E16`** ★★★ 不接全不转 |
|---|---|---|

## 13.3 其它接口

| 接口 | FPGA 孔位 | 对方 |
|---|---|---|
| **串口** | 底5 `F16`（收）/ 顶7 `C19`（发）| K230 排针 11 / 13 |
| **I²C** | 顶4 `C20`（SCL）/ 顶3 `D19`（SDA）| PCA9685 |
| **舵机电源** | 底6 `3V3` → VCC（逻辑）| PCA9685 |
| **超声波** | 顶1 `F20`（TRIG）/ 顶2 `E18`（ECHO）| HC-SR04 |
| **按键** | `F15`（启动）/ `A20`（急停）/ `B21`（复位）| |

## 13.4 供电

```
3S 电池 12.6V
 ├─ 5A 保险丝 → 驱动板 Vin+（电机）
 ├─ LM2596 → 9.2V → FPGA
 ├─ UBEC   → 5.16V → PCA9685 V+（舵机）
 └─ FPGA 3.3V → PCA9685 VCC（逻辑）
```

## 13.5 上电顺序

```
FPGA 先上电 → 看 D0/D3 亮 → UBEC 等 1~2 分钟稳定 → 给舵机供电 → K230 上电
```
