yilo425/wheel-leg-robot-delivery/doc/供电硅胶线接线表.md

# 供电硅胶线接线表（大电流 · 硅胶线）

> 2026-10-25。本文是**供电/大电流**接线，全部用**硅胶线**（软、耐流）。
> **信号/逻辑线**另见 `doc/杜邦线接线表.md`，不要混用。
> 电源选型依据见 `doc/供电与接线方案.md`（本文是它的“照做版”）。

---

## 0. 一张图看全

```
  电池 3S（XT60，11.1V 标称 / 12.6V 满电）
        │
    [5A 片式保险丝]
        │
    [船型开关 10A]
        │
   ┌────┴────┐
   │ 12V 汇流端子排 │──── 红(+12V) / 黑(GND)
   └─┬───┬───┘
     │   │
     │   ├──► 四路驱动板 Vin+/Vin−   （18AWG，电机）
     │   ├──► 12→9 降压（可调）IN    （20AWG，给 FPGA）
     │   └──► 12→6 降压（UBEC）IN    （20AWG，给舵机）
     │
     ├─ 12→9 OUT(9V) ──► 5.5×2.1 免焊插头 ──► FPGA DC 圆口
     ├─ 12→6 OUT(6V) ──► 舵机分配板/PCA9685 V+ ──[1000µF]──► 4 舵机
     │
     └─ GND 星形共地（电池负极 = 唯一参考点）

  K230 单独用【充电宝 5V】Type-C，不接主电池（隔离噪声）
```

---

## 1. 主链路（电池 → 端子排）

| # | 从 | 到 | 线径 | 颜色 | 说明 |
|---|---|---|---|---|---|
| 1 | 电池 XT60 母头 | 保险丝座 | 自带 14AWG | 红 | 正极先过保险丝 |
| 2 | 保险丝 | 船型开关 | 14~18AWG | 红 | 5A 片式保险丝（防短路）|
| 3 | 船型开关 | 端子排【红排】| 18AWG | 红 | +12V |
| 4 | 电池 XT60 | 端子排【黑排】| 14~18AWG | 黑 | GND，**不经过开关** |

> 保险丝放**最前面**（电池正极出来后第一个），后面任何一处短路都先烧保险丝。
> 开关只切**正极**，负极直通。

---

## 2. 各路负载（从 12V 汇流分出去）

### 2.1 电机驱动板（电流最大，粗线）

| 项 | 值 |
|---|---|
| 从 | 端子排 12V 汇流 |
| 到 | 四路驱动板 `Vin+` / `Vin−`（蓝色螺丝端子）|
| 线径 | **18AWG** 红 + 黑（堵转峰值 4A）|
| 电压 | 12V（固件 `V_LIMIT_DUTY=68` 限压 ≈6.4V 有效）|

### 2.2 12→9 降压（给 FPGA）

| 项 | 值 |
|---|---|
| 从 | 端子排 12V 汇流 |
| 到 | 降压模块 IN+/IN− |
| 线径 | 20AWG |
| 输出 | **9.0V** → 5.5×2.1 免焊插头 → FPGA DC 圆口 |
| ⚠️ | 模块必须是**可调版**（3~35V），先把电位器调到 9.0V 再接 |

### 2.3 12→6 降压（给舵机）

| 项 | 值 |
|---|---|
| 从 | 端子排 12V 汇流 |
| 到 | 降压模块 IN+/IN− |
| 线径 | 20AWG（推荐 18AWG 更稳，舵机峰值电流大）|
| 输出 | **5.5~6.0V** → 舵机分配板 / PCA9685 `V+` |
| ⚠️ | **别直接 12V 给舵机**（丝印 V+ 6V Max）|

---

## 3. 舵机电源分配

| # | 从 | 到 | 线径 | 说明 |
|---|---|---|---|---|
| 1 | 12→6 降压 OUT+ | 舵机分配板 / PCA9685 `V+`（螺丝端子）| 20AWG 红 | |
| 2 | 12→6 降压 OUT− | 分配板 / PCA9685 `GND` | 20AWG 黑 | **再并一根细线回 FPGA GND** |
| 3 | —— | 舵机供电轨 | —— | **并 1000µF 电容**（堵转瞬间补能，防掉压）|
| 4 | 分配板/PCA9685 ch0~3 | 4 个舵机红/黑 | 20AWG | 每个舵机一红一黑 |

> 舵机信号（黄线）是杜邦线，见杜邦线表 §6。这里只接**电源**。
> 1000µF 电容极性别接反（长脚 +，短脚 −），耐压 ≥16V。

---

## 4. 电机到驱动板（6P 扁线）

| 项 | 值 |
|---|---|
| 从 | 四路驱动板底部 4 个白色电机座 |
| 到 | 4 个 MG310 电机（6P 插头）|
| 说明 | **每一路的针序不一样**，插前对丝印；插反=烧 |
| 注意 | 电机座里自带编码器 VCC(5V)/GND/A/B 直通，不用另外接线 |

---

## 5. K230 电源（独立）

| 项 | 值 |
|---|---|
| 从 | **充电宝**（79×35×27）|
| 到 | K230 Type-C |
| 说明 | 5V/2A，**独立供电**，和主电池隔离（避免电机噪声干扰视觉）|

---

## 6. 端子排（12V 汇流）排位

用 KF301 5.08mm 可拼装端子排，拼成 3 组（共 15 位，正好塞进车身的 76mm 槽）：

| 组 | 位数 | 接什么 |
|---|---|---|
| **红排（+12V）** | 4 | ①电池+ ②驱动板Vin+ ③12→9 IN+ ④12→6 IN+ |
| **黑排（GND）** | 6 | ①电池− ②驱动板Vin− ③12→9 IN− ④12→6 IN− ⑤FPGA GND ⑥舵机 GND |
| **舵机排（5.5~6V）** | 5 | 降压 OUT 分配（或直接并电容到 PCA9685 V+）|

> 5.08mm 端子每孔能拧 2~3 根 20AWG，够用。
> 嫌挤就买 3 位/4 位的多拼几组。

---

## 7. 线径与采购汇总

| 用途 | 线径 | 颜色 | 长度(估) |
|---|---|---|---|
| 电池→保险丝→开关→端子排 | 14~18AWG | 红+黑 | 30cm |
| 端子排→驱动板 Vin | 18AWG | 红+黑 | 25cm |
| 端子排→两个降压 IN | 20AWG | 红+黑 | 20cm |
| 12→9 OUT→FPGA DC | 20AWG | 红+黑 | 25cm（带 5.5×2.1 免焊插头）|
| 12→6 OUT→舵机分配 | 20AWG | 红+黑 | 25cm |
| 舵机电源 ×4 | 20AWG | 红+黑 | 15cm |

**采购**：18AWG 硅胶线红黑各 1 米、20AWG 红黑各 2 米、XT60 母头带线、5A 片式保险丝+座、船型开关、5.5×2.1 免焊转接端子、1000µF/16V 电容、KF301 端子排（3×2P + 3×3P）。

---

## 8. 安全红线（照做，别省）

| # | 规矩 | 为什么 |
|---|---|---|
| 1 | **共地**：电池负极、驱动板 Vin−、降压 GND、FPGA GND、舵机 GND 全都要通 | 不共地 = 通信乱、舵机抖 |
| 2 | **上电前量电压**：9V 降压先调到 9.0V、6V 降压调到 5.5~6.0V | 12.6V 满电直接进 FPGA/舵机 = 烧 |
| 3 | **电容极性**别反 | 反接会爆 |
| 4 | **电机座针序**插前对丝印 | 插反烧驱动板 |
| 5 | **第一次通电轮子架空** | 转向反了会冲出去 |
| 6 | **上电顺序**：先共地 → 信号 → 最后电源；断电反过来 | 防止上电瞬间引脚灌电 |

---

## 9. 上电检查（一次量完再往下）

```
① 只接电池+端子排，不接负载 → 量红排对黑排 ≈ 11~12.6V
② 接两个降压 → 量 12→9 OUT=9.0V、12→6 OUT=5.5~6.0V（不对就调电位器）
③ 接驱动板 → 量 Vin+ 对 GND ≈ 12V、板上 5V 输出 ≈ 5V
④ 接 FPGA → 看 3V3/1V1 电源灯亮
⑤ 接舵机分配 → 量 V+ 对 GND ≈ 6V
⑥ 四组电压全对 → 才接信号线（见杜邦线表）
```

**任何一步电压不对 → 停，别往下接** ✗
