yilo425/wheel-leg-robot-delivery/doc/信号线接线表_20261030.md

# 信号线接线表（含 FPGA 具体孔位）· 2026-10-30 组装版

> **找孔最可靠的办法：板子每个孔都印着球号**（如 `A13`、`F16`），按丝印找 ✓
> 下表同时给出"顶排/底排第几孔"，方便快速定位。
> 引脚以 `constraints/pin_table.csv` 为准。

---

## 一、两张排针的全貌

### 顶排（从 `F20` 那一头数第 1 孔）

| 孔位 | 球号 | 接到哪 |
|---|---|---|
| 1 | `F20` | （原超声波 Trig，现空闲）|
| 2 | `E18` | （原超声波 Echo，现空闲）|
| **3** | **`D19`** | **PCA9685 `SDA`** |
| **4** | **`C20`** | **PCA9685 `SCL`** |
| 5 | `E17` | 空闲 |
| **6** | **`GND`** | ★ **公共地**（多处共用）|
| **7** | **`C19`** | **K230 的 RX（13 脚）** |
| 17 | **`F14`** | 电机 D 方向 1（左后）|
| 18 | **`A19`** | 电机 B 方向 1（右前）|
| 19 | **`A16`** | 电机 D PWM（左后）|
| 20 | **`A14`** | 电机 B PWM（右前）|

### 底排（从 `F19` 那一头数第 1 孔）

| 孔位 | 球号 | 接到哪 |
|---|---|---|
| **1** | **`F19`** | 电机 A 方向 2（右后）|
| **2** | **`F18`** | 电机 B 方向 2（右前）|
| **3** | **`E19`** | 电机 C 方向 2（左前）|
| **4** | **`D20`** | 电机 D 方向 2（左后）|
| **5** | **`F16`** | **K230 的 TX（11 脚）** |
| **6** | **`3V3`** | **PCA9685 `VCC`** ⚠️ 不是 5V |
| **16** | **`E13`** | 驱动板 `STBY` |
| 17 | **`F13`** | 电机 C 方向 1（左前）|
| 18 | **`A18`** | 电机 A 方向 1（右后）|
| 19 | **`A15`** | 电机 C PWM（左前）|
| 20 | **`A13`** | 电机 A PWM（右后）|

---

## 二、按部件整理的接线清单

### A. K230（3 根）

| FPGA 孔位 | 球号 | K230 |
|---|---|---|
| **顶排 7** | `C19` | **RX（13 脚）** |
| **底排 5** | `F16` | **TX（11 脚）** |
| **顶排 6** | `GND` | GND（6/9/14 任一）|

> ⚠️ 交叉接：FPGA 的 TX 接 K230 的 RX

### B. PCA9685 舵机板（5 根）

| FPGA 孔位 | 球号 | PCA9685 |
|---|---|---|
| **底排 6** | **`3V3`** | `VCC` ⚠️ 绝不能接 5V |
| **顶排 6** | `GND` | `GND` |
| **顶排 4** | `C20` | `SCL` |
| **顶排 3** | `D19` | `SDA` |
| **顶排 6** | `GND` | `OE` |

### C. 电机驱动板（13 根）

| 车轮 | 驱动板口 | 信号 | FPGA 孔位 | 球号 |
|---|---|---|---|---|
| **右后** | **A** | PWM | **底排 20** | `A13` |
| | | 方向 1 | **底排 18** | `A18` |
| | | 方向 2 | **底排 1** | `F19` |
| **右前** | **B** | PWM | **顶排 20** | `A14` |
| | | 方向 1 | **顶排 18** | `A19` |
| | | 方向 2 | **底排 2** | `F18` |
| **左前** | **C** | PWM | **底排 19** | `A15` |
| | | 方向 1 | **底排 17** | `F13` |
| | | 方向 2 | **底排 3** | `E19` |
| **左后** | **D** | PWM | **顶排 19** | `A16` |
| | | 方向 1 | **顶排 17** | `F14` |
| | | 方向 2 | **底排 4** | `D20` |
| — | — | `STBY` | **底排 16** | `E13` |
| — | — | `GND` | **顶排 6** | `GND` |

> 通道映射已按物理结构重排：**A=右后 B=右前 C=左前 D=左后** ✓
> （驱动板输出口顺时针 D-C-B-A，正好对上四个轮子的物理位置）

### D. 编码器（8 根，现在没接）

| 驱动板 | FPGA 孔位 | 球号 |
|---|---|---|
| `E1A` | 顶排 16 | `E14` |
| `E1B` | 底排 14 | `C13` |
| `E2A` | 顶排 14 | `B13` |
| `E2B` | 底排 13 | `D14` |
| `E3A` | 顶排 13 | `D15` |
| `E3B` | 底排 12 | `C14` |
| `E4A` | 顶排 12 | `C15` |
| `E4B` | 底排 11 | `B15` |

---

## 三、板上按键

| 按键 | 球号 | 作用 |
|---|---|---|
| **S4** | `B21` | 复位 |
| **S0** | `F15` | 启动 / 进 AUTO |
| **S1** | `A20` | 急停 |

---

## 四、电源与共地

| 从 | 到 |
|---|---|
| 电池 **+** | 驱动板 **`Vin+`**（顶部靠右大焊盘）|
| 电池 **−** | 驱动板 **`Vin−`** |
| 电池 → LM2596 → **9.2V** | FPGA **DC 圆口** |
| 电池 → UBEC → **5~6V** | PCA9685 舵机电源 |

**共地必连**：电池− / 驱动板 Vin− / UBEC 输入− / LM2596 输入− / FPGA GND(顶6) / PCA9685 GND

---

## 五、上电顺序

```
① FPGA 上电 → D0 亮
② D3 亮（I²C 通）
③ 等 2 分钟 ★（UBEC 软启动慢，前 2 分钟输出可能接近 12V）
④ 舵机电源上电
⑤ 手机连 RobotRC（12345678）→ http://192.168.169.1:8080/h
```

---

## 六、LED 自检

| LED | 信号 | 亮 = |
|---|---|---|
| D0 | `rst_n` | 复位完成 |
| D1 | `motor_enable_fsm` | 手动模式 |
| D2 | `avoid_active \| lift_active` | 避障/抬腿中 |
| **D3** | **`pca_init_done`** | **I²C 通 + PCA9685 就绪** ★ |
| D4~D6 | `state_dbg[2:0]` | 0=IDLE 1=MANUAL 2=AUTO 3=AVOID |
| D7~D8 | `speed_scale_dbg[1:0]` | 0=停 1=慢 2=满 |

**正常待机**：D0、D1、D3、D4、D7 亮 ✓

---

# 十、新方案（2026-10-31）：两条 2×5 排线，跨层只走一根扁平线

> 动机：FPGA 在二层、驱动板在一层，22 根散线跨层太乱。
> 关键发现：**FPGA 排针顶排全是奇数 GPIO0、底排全是偶数，同一位置上下差 1**
> —— 正好匹配 2×N 排线的 1/2 脚顺序。

## 10.1 为什么最多一条 10 根

```
顶/底排 位置 16~20  ->  GPIO0_9 ~ GPIO0_0   连续 10 个 ✓
顶/底排 位置 15     ->  GND / 5V            ← 断点 ✗
顶/底排 位置 10~14  ->  GPIO0_19 ~ GPIO0_10 连续 10 个 ✓
位置 9 及左侧       ->  GPIO0_20 起，被 LED/按键/UART/I2C 占用
```

**所以一条排线最多 10 根**，两条共 20 根，覆盖 4 PWM + 8 方向 + 8 编码器 ✓

## 10.2 排线 A → 驱动板左侧 2×6 排针（10 根）

| 驱动板行 | 左脚 | 右脚 | FPGA 位置 | **底排**(左脚) | **顶排**(右脚) | GPIO0 |
|---|---|---|---|---|---|---|
| row2 | `PWMB` | `PWMA` | **20** | `A13` | `A14` | 0 / 1 |
| row3 | `BIN2` | `AIN2` | **19** | `A15` | `A16` | 2 / 3 |
| row4 | `BIN1` | `AIN1` | **18** | `A18` | `A19` | 4 / 5 |
| row5 | `E2A` | `E1A` | **17** | `F13` | `F14` | 6 / 7 |
| row6 | `E2B` | `E1B` | **16** | `E13` | `E14` | 8 / 9 |

> row1（3V3 / STBY）不接

## 10.3 排线 B → 驱动板右侧 2×10 排针（10 根）

| 驱动板行 | 左脚 | 右脚 | FPGA 位置 | **底排**(左脚) | **顶排**(右脚) | GPIO0 |
|---|---|---|---|---|---|---|
| row6 | `PWMD` | `PWMC` | **10** | `D17` | `C17` | 18 / 19 |
| row7 | `DIN2` | `CIN2` | **11** | `B15` | `B16` | 16 / 17 |
| row8 | `DIN1` | `CIN1` | **12** | `C14` | `C15` | 14 / 15 |
| row9 | `E4A` | `E3A` | **13** | `D14` | `D15` | 12 / 13 |
| row10 | `E4B` | `E3B` | **14** | `C13` | `B13` | 10 / 11 |

> row1~5（GND/3V3/5V/ADC1）不接

## 10.4 另外两根

| 信号 | FPGA 位置 | 球号 | 说明 |
|---|---|---|---|
| **STBY** | **底排 9** | `E16` | ⚠️ 悬空电机不转（实测），必须给高 |
| **GND** | **顶排 15** | `GND` | 共地 |

## 10.5 效果

```
改前：14 根电机散线 + 8 根编码器 = 22 根散线跨层 ✗
改后：2 条 2×5 扁平排线（各 10 根）+ STBY + GND = 4 根跨层 ✓
```

## 10.6 通道对应（便于核对）

| 通道 | 车轮 | PWM | 方向1 | 方向2 | 编码器 A/B |
|---|---|---|---|---|---|
| **A** | 右后 | `A14` | `A19` | `A16` | `F14` / `E14` |
| **B** | 右前 | `A13` | `A18` | `A15` | `F13` / `E13` |
| **C** | 左前 | `C17` | `C15` | `B16` | `D15` / `B13` |
| **D** | 左后 | `D17` | `C14` | `B15` | `D14` / `C13` |

> **排线 A 管 A+B 通道，排线 B 管 C+D 通道** ✓

## 10.7 ⚠️ 改线后的验证

1. 先只插排线 A（A/B 两路），四轮离地，跑逐通道测试
2. 确认 A、B 两路转向一致、编码器反馈正常
3. 再插排线 B（C/D 两路）
4. 最后测左右转 90°

## 10.8 已释放的引脚（原超声/抬腿限位，长期未使用）

| 信号 | 原球号 | 状态 |
|---|---|---|
| `lift_pwm[0]` | `B16` | 释放（SERVO_IF=1 时不用）|
| `lift_pwm[1]` | `D17` | 释放 |
| `lift_lim_n[0]` | `C17` | 释放（一直没接）|
| `goal_reached` | `E16` | 释放（一直没接）|

---

## 10.9 ⚠️ 2026-11-01 修正：顶/底对调

按实际 2×5 连接器的物理方向（用户实测），**底排 = 驱动板左脚、顶排 = 驱动板右脚**，
与原方案相反。已在 `.cst` 中对调全部 20 个信号，本文件表格已同步。

**接完务必逐根量通断**：
```
FPGA 底排 20 (A13) ←→ 驱动板 左排针 row2 左脚 (PWMB)
FPGA 顶排 20 (A14) ←→ 驱动板 左排针 row2 右脚 (PWMA)
...
```

---

## 十一、轮距实测（2026-11-01）

| 项 | 值 |
|---|---|
| **轮距 W** | **230mm** |
| 轮径 D | 48mm |
| 40% 实测速度 | 502.7 mm/s |
| 90° 转弯时间 | TURN_MS = 360ms |
