yilo425/wheel-leg-robot-delivery/doc/同类作品调研.md

# 同类作品调研（2026-10-19）

> 目的：这个项目"一定有人做过"，先看别人怎么做，别自己乱设计。
> **说明**：以下结论标了来源。团队报告多为 `.docx` / 图片型 PDF，**正文没能完整提取**，
> 所以标「未验证」的部分是**从标题/摘要/片段推断**的，落地前要自己核对。

---

## 1. 最相关的赛题：全国大学生智能汽车竞赛

**第 20 届（2025）** 设有与我们高度相关的两个组别：

| 组别 | 和我们的关系 |
|---|---|
| **极速越野组** | 非结构化路面 + 障碍，视觉 + 高速通过 |
| **平衡轮腿组** | **轮腿复合结构** —— 就是"轮 + 腿"这个形态 |

公开的参赛技术报告（清华云盘）：

- [湘潭大学兴湘学院 - 逐曦分队 - 平衡轮腿](https://cloud.tsinghua.edu.cn/d/f4da78e59ced4da6a827/files/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)
- [集美大学 - 川崎JMU_2 - 平衡轮腿](https://cloud.tsinghua.edu.cn/d/f4da78e59ced4da6a827/files/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)
- [中国地质大学（武汉）- 地大追风队 - 极速越野](https://cloud.tsinghua.edu.cn/d/f4da78e59ced4da6a827/files/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)

**结论**：轮腿形态是**成熟赛道**，不是我们独创，可以放心沿用已被验证的思路。

---

## 2. ★ 台阶策略：我们做的和学术界一致

IEEE 有篇专门讲爬楼梯策略的：

> **Stair-Climbing Strategy in a Novel Wheel-Legged Hybrid Robot**
> "Upon entering the staircase, Kilin must prepare to **lift its front legs** to ascend the first stair"
> —— [IEEE 11533382](https://ieeexplore.ieee.org/document/11533382/figures)

**标准四步**（和我们 `main_fsm` 的 LIFT 模式 1 一模一样）：

```
① 抬前腿 → 车头上仰
② 前进 → 前轮压上台阶
③ 抬后腿（前腿保持）
④ 前进 → 后轮上台阶 → 收腿
```

✅ **这说明我们 RTL 里 `LP_F_UP → LP_F_CROSS → LP_R_UP → LP_R_CROSS` 的分段设计是对的**，
不是拍脑袋 —— 直接照抄了行业范式。

---

## 3. 腿的三种形态：我们选的这种最合适

| 形态 | 代表 | 复杂度 | 适合 3D 打印参赛？ |
|---|---|---|---|
| **摆臂式**（腿绕固定轴摆）| ← **我们选的** | 低（1 个舵机 + 1 条打印腿）| ✅ **最合适** |
| 周转式轮腿（腿绕整圈转）| [北航学报：新型周转式轮腿机器人](https://www.spacejournal.cn/bjhkhtdxxb/cn/article/pdf/preview/10.13700/j.bh.1001-5965.2022.0491.pdf) | 高（需要整周驱动 + 特殊轮）| ❌ 太重太复杂 |
| 变形轮（轮缘可变）| Design of Wheel-Legged Robot with Rim Shape Changeable Wheels | 很高（机构 + 材料）| ❌ 不适合 |

**结论**：摆臂式是**投入产出比最高的选择** ✓ 我们的方案不用改。

---

## 4. ★ 尺寸参考：别的赛事里台阶/障碍物有多大

一个"物资搬运"类赛事的场地规格（[原文 PDF](http://www.tastm.cn/static/upload/file/20231129/1701223422111230.pdf)）：

```
低层台阶：长60 × 宽30 × 【高 6cm】
高层台阶：长60 × 宽30 × 【高 12cm】
物资：      【5cm 立方体】泡沫模块
```

**这条对我们很有用**：

| 发现 | 对我们的意义 |
|---|---|
| 常见"低台阶"是 **6cm** | 我们的举升能力必须 ≥6cm（L=70mm 举升 119mm ✓ 富余很大）|
| 常见"高台阶"是 **12cm** | 12cm 必须**绕行**，别想跨 |
| 障碍物常是 **5cm 立方体** | 和你们说的"5cm 门槛"是同一量级 ✓ |

⚠️ **但要注意**：如果障碍物**本身就是 5cm 立方体**，
那"<5cm 抬腿 / >5cm 绕路"这个判据就**正好卡在边界上** ✗

**建议改成**：

```
≤ 4cm  → 不抬腿，直接压过去（4cm 以下轮子能过）
4~7cm  → 抬腿跨（0x04）
> 7cm   → 绕行（0x02）
```

留出**迟滞区间**，避免"5cm 的东西一会儿跨一会儿绕"。

---

## 5. 视觉判高度：单目可以，但要"地面假设"

学术/工程上的通用做法是**反投影 + 地面平面假设**（我们之前推导的公式就是它）：

```
已知相机高度 hc、俯仰角、焦距 f
地面上的点：row → 距离 D = hc / tan(θ(row))
物体顶边：  H = hc − D · tan(θ(row_top))
```

| 方案 | 依赖 | 可靠性 |
|---|---|---|
| 单目 + 地面假设 | 标定 hc / f / 俯仰 | ⭐⭐（近距离准，远了崩）|
| **单目 + TOF 距离** | 只标定 f | ⭐⭐⭐（我们讨论的那个方案）|
| **双 TOF 不同高度** | 装两个传感器 | ⭐⭐⭐⭐ **最稳，且不依赖颜色** |
| 双目/深度相机 | 硬件 | ⭐⭐⭐⭐ 但超预算 |

**参考**：障碍物边框 + 相机标定做平面信息提取，是已有专利做法
（[CN111179300A](https://patentimages.storage.googleapis.com/6f/25/4a/8e2672cf8bafce/CN111179300A.pdf)）。

---

## 6. 对我们项目的 8 条具体建议

| # | 建议 | 依据 | 优先级 |
|---|---|---|---|
| 1 | **分段抬腿（模式 1）保留**，别删 | 学术界标准楼梯策略 | ★★★ 已实现 |
| 2 | **摆臂式腿**继续，不要改周转式 | 复杂度/重量 | ★★★ 已确定 |
| 3 | **判据从「5cm」改成「4/7cm 双阈值」** | 5cm 是常见障碍物尺寸，卡边界会来回抖 | ★★★ **要改** |
| 4 | 用 **双 TOF（3cm / 8cm 高度）** 判高低，别只靠摄像头 | 不依赖颜色/光照 | ★★★ |
| 5 | 腿长 70mm 够用（举升 119mm ≫ 6cm 台阶） | 尺寸参考 + 我们的计算 | ★★ 已定 |
| 6 | **跨失败降级**保留 | 同类作品普遍有"失败重试/绕行" | ★★ 已实现 |
| 7 | 12cm 台阶**直接绕**，别试 | 尺寸参考 | ★★ |
| 8 | 去 B 站/论坛搜"**平衡轮腿 结构**"，看别人的摆臂怎么装在舵机上 | 视频比文档直观 | ★★ 待做 |

---

## 7. 还没查到、值得继续挖的

| 想找什么 | 去哪找 |
|---|---|
| **极速越野组的官方赛道规范**（障碍物高度/间距） | 智能车竞赛官网、各省赛区规程 PDF |
| 平衡轮腿组的**机械装配视频** | B 站搜「平衡轮腿 智能车 机械」|
| 别人的**摆臂 + 舵机盘**连接细节 | 上述团队报告的机械章节 |
| **K230 视觉识障碍物的开源代码** | GitHub 搜「K230 智能车 视觉」|

> 团队报告是 `.docx`，我这边只能看到标题和片段。
> **建议你自己下载那几份报告**（链接在上面），重点看两章：
> **「机械结构设计」**和**「障碍物识别」** —— 那正是我们现在最缺的部分。

---

## 8. 一句话总结

> **我们的技术路线是对的**（摆臂式腿 + 分段抬腿 + 视觉/TOF 分工 + 失败降级），
> 已经和公开的同类作品一致。
> **唯一明显要改的是判据**：5cm 卡在边界，改成 4/7cm 双阈值 + 迟滞。
> 剩下缺的是**机械细节**（别人怎么把腿装到舵机上），这个网上有视频，比文档直观。

---

## 9. ★★ 找到了：完整开源 CAD + 成本答案

**[Skythinker616/foc-wheel-legged-robot](https://github.com/Skythinker616/foc-wheel-legged-robot)**
—— 1800 星、271 fork、GPL-3.0、SolidWorks 2019 全套。

`solidworks/` 目录里是**完整装配体**（`总装.SLDASM`，35MB）+ 全部零件：

| 文件 | 是什么 | 对我们有什么用 |
|---|---|---|
| `总装.SLDASM` | **总装配体** | **直接看内部怎么分层摆放** |
| `底板.SLDPRT` | 底板（**亚克力**，¥5）| 分层底板怎么开孔 |
| `主控支架` / `主控支撑铜柱` / `主控板PCB` | 主控分层安装 | **FPGA 怎么固定** |
| `NanoPi.SLDPRT` / `NanoPi支架` | 上位机 + 支架 | **K230 怎么固定** |
| `电池架` / `电池支撑铜柱` / `动力锂电池` | 电池固定 | 电池怎么夹住（他说"固定不够牢固"是待改进项）|
| `大腿` / `小腿` / `关节电机支架` | 两段式腿 | 腿+电机支架的关系 |
| `推力轴承` / `MISUMI_C-SE604ZZ` | **关节双轴承** | ★ 验证了我们说的"支撑销/轴承" |
| `车轮` / `轮胎` / `驱动板` | | |

### 9.1 ★ 成本答案：**只打印"零件"，不打印"框架"**

原作者的原文：

> **大部分零件使用 3D 打印制造，底板为定制亚克力板**
> 机器人底板使用的是**白色定制亚克力板**〔¥5〕
> 其余全部结构件均在嘉立创使用白色树脂材料打印，**全部花费约 ¥100**

**这直接回答了"3D 打印太贵"的问题**：

| 做法 | 成本 | 评价 |
|---|---|---|
| 整个车身 3D 打印 | ¥300~800 | ✗ 又贵又慢，大平面还容易翘 |
| **亚克力板（分层） + 铜柱 + 只打印支架** | **¥100~150** | ✅ **别人的实际做法** |

**分层靠什么**：`主控支撑铜柱` / `电池支撑铜柱` —— **M3 铜柱**，不是打印的框架 ✓
板子是**平板亚克力**（激光切割，¥5-15/块），打印件只做**立体的支架/卡扣** ✓✓

### 9.2 关节：**一个深沟球轴承 + 一个推力轴承**

| 件 | 规格 | 价 |
|---|---|---|
| 深沟球轴承 604 | 内4 / 外12 / 厚4 | ¥1.3 |
| **推力轴承 F8-14M** | 内8 / 外14 / 厚4 | ¥2.0 |

**"每个关节都用了一个深沟球轴承 + 一个推力轴承"** ——
这就是我们之前讨论的"舵机轴不能受弯矩"的正解：
- **深沟球轴承** 抗**径向**力（腿的侧向/上下载荷）
- **推力轴承** 抗**轴向**力（腿往外推的力）

> ✅ **这条直接验证了我给你的建议**：腿的另一端要加支撑。
> 对舵机来说，就是"腿根外侧装一个 604 轴承套在舵机盘外圈上"。

### 9.3 ★ 作者自己列的"踩坑"，对我们全是预警

原文「改进方向」：

| 作者原话 | 对我们的意义 |
|---|---|
| **关节电机扭矩无法完成跨越动作** | ⚠️ 他 0.22 N·m 的 4010 都不够！我们 MG996R 1.27 N·m（降额 0.64）**比它大 3 倍**，但也要警惕 |
| **车轮电机扭矩无法越过较高障碍** | ⚠️ 12cm 台阶别硬上（和我们调研的 6/12cm 一致）|
| 电池固定不够牢固 | 电池**必须做机械夹持**，不能只靠扎带 |
| 轮电机安装方式不方便 | 换轮子要方便 |

### 9.4 他的器件选型（可作参考）

| 项 | 规格 | 重量 | 价 |
|---|---|---|---|
| 关节电机 | 4010 无刷 (12V, 0.22 N·m, 11 对极) | 125g | ¥50 |
| 车轮电机 | 2804 无刷 (12V, 0.04 N·m, 7 对极) | 24g | ¥13 |
| 电池 | **3S 800mAh 25C** | **57g** | ¥28 |
| 轮胎 | **自粘海绵胶条**（缓震好、抓地强，但**耐磨差**）| — | — |
| 螺丝 | 扁平头 M2 / M2.5 / M3 / M4 | — | — |

> 他的电池只有 **57g / 800mAh**，续航 20-30 分钟 ——
> 比我们计划的 3000mAh/约 180g **轻得多**。这提示我们：
> **电池选小一点**（1500mAh 够用），能省 100g 重量、还能降低重心 ✓

---

## 10. ★ 内部布局建议（照抄他的思路，适配我们的 4 轮 + 4 舵机）

### 10.1 先纠正你现在的分层

| 你的方案 | 问题 |
|---|---|
| 下层：4 舵机 + 电源 | ✅ 对（重的在下面）|
| 中层：FPGA | ✅ 对 |
| **顶层：ARM + 充电宝** | ❌ **充电宝是最重的单体（~200g），放最高层 = 重心最高** |

**充电宝在顶上会有什么后果**：
- 重心抬高 → 转弯侧倾大、越障时容易翻
- 我们算过"倾覆校核"，重心高度 <45mm 才安全

### 10.2 建议的三层布局

```
  ┌─────────────────────────────────┐
  │ ③ 顶板（亚克力 3mm）            │  ← K230 + 摄像头（轻，视野好）
  │    铜柱 M3×4 (25mm)             │
  ├─────────────────────────────────┤
  │ ② 中板（亚克力 3mm）            │  ← FPGA + 四路驱动板
  │    铜柱 M3×4 (25mm)             │
  ├─────────────────────────────────┤
  │ ① 底板（亚克力 3mm）            │  ← 电池 + 充电宝 + 4 舵机（最重的都在底层）
  └─────────────────────────────────┘
       ○ 轮                    轮 ○
```

| 层 | 放什么 | 理由 |
|---|---|---|
| **底** | 电池、**充电宝**、4 舵机 | 最重的贴地 → 重心低 ✓ |
| **中** | FPGA、四路驱动板、降压模块 | 中等重量、接线集中 |
| **顶** | K230、摄像头、大电容 | 轻；摄像头要高才有视野 |

> **注意**：摄像头在**顶板前沿**，才能"看到 50cm 处的 5cm 障碍"
> （我们算过：相机高 10cm、水平、50cm 处能看到）→ 顶板高度要 ~100mm ✓

### 10.3 结构怎么搭（省钱版）

| 件 | 材料 | 价 |
|---|---|---|
| 3 块层板 | **亚克力 3mm，激光切割** | ¥5~15/块 |
| 立柱 | **M3 铜柱**（25/30mm）| ¥0.5/根 × 12 |
| 舵机支架 | 3D 打印 | ¥5/个 × 4 |
| FPGA 支架 | 3D 打印 | ¥8 |
| 相机支架 | 3D 打印 | ¥5 |
| 电池卡扣 | 3D 打印（**必须做**，他说扎带不牢）| ¥8 |
| **合计** | | **¥100~150** |

**关键**：亚克力板**只开孔**（螺丝孔、过线孔），**不打印大平面** ✓
- 平板打印又慢又容易翘
- 激光切割亚克力又快又平又便宜

### 10.4 ★ 布线怎么不太头疼（你的另一个痛点）

| 做法 | 具体 |
|---|---|
| **每层板开过线孔** | φ8~10，**位置错开**（上层和下层不在一条直线上，线不打架）|
| **分侧走线** | 电源线走**右侧**、信号线走**左侧**，避免平行干扰 |
| **边缘集束** | 每层的线在板边汇成一束，用**螺旋缠绕管**（¥5/米）包起来 |
| **扎带固定点** | 板上开 φ3 孔，尼龙扎带穿孔绑线 |
| **接插件同侧** | 所有插头朝**同一个方向**（比如都朝车尾），维修时不用翻车 |
| **锁扣接插件** | 用 **JST-XH（带锁扣）** 而不是杜邦（会松）|
| **电源线加粗** | 电机/舵机 18~20AWG，信号 24AWG |

**照着做的好处**：拆装一次不用"重新理线"，坏一根能单独换 ✓

---

## 11. 立刻能做的三件事

| # | 做什么 | 花多久 |
|---|---|---|
| 1 | **下载 `总装.SLDASM`**（35MB），用 SolidWorks 打开看内部布局 | 10 分钟 |
| 2 | 把**充电宝从顶层挪到底层** | 改设计时 |
| 3 | 层板改成**亚克力激光切割**，只打印支架 | 省 ¥200+ |

> SolidWorks 文件需要 SolidWorks 打开（或用 eDrawings 免费查看器）。
> 下载地址：<https://github.com/Skythinker616/foc-wheel-legged-robot/tree/master/solidworks>
> 或者直接 clone 整个仓库（61MB）。
