yilo425/wheel-leg-robot-delivery/doc/四足轮腿结构参考.md

# 四足轮腿结构参考（2026-10-22）

> 针对你们的构型：**高机身 + 腿从侧面伸出 + 轮子在腿末端**。
> 这类机器人有专门的名称：**四足轮腿（wheel-legged quadruped）**，
> 和我之前找的"低矮底盘 + 独立举升臂"是两回事。

---

## 1. 你的构型叫什么

学术/产业里的叫法：

| 叫法 | 说明 |
|---|---|
| **轮足机器人 / 轮腿机器人** | wheel-legged robot |
| **四足轮腿** | 4 条腿，每条腿末端一个轮 |
| **轮足复合结构** | wheel-foot composite |

**一个专利把结构描述得很准**（[CN111976859A](http://patentimages.storage.googleapis.com/f3/ab/41/0223b91a5bc4a1/CN111976859A.pdf)）：

> "多个机械腿组件的**一端沿支撑载体下侧的周向均匀布置**，
> **车轮安装在机械腿组件的另一端**"

—— 就是"腿从机身四周伸出去，轮在腿尖" ✓ 和你的图一致。

---

## 2. ★ 三个能直接用的开源资源

### ① 达妙科技 四足轮腿（Gitee）—— 最接近

**[gitee.com/daya35/wheel-legged](https://gitee.com/daya35/wheel-legged)**（原始仓库 `kit-miao/wheel-legged`）

原文描述：

> "达妙科技开源四足仓，使用 **4 个 DM4310**（关节电机）**两个 DM60 轮毂**（驱动轮）
> 一个 DM-MC02 开发板，**结构件可以使用 3D 打印件**，也可以使用开源的机加件。"

| 能给我们什么 | 价值 |
|---|---|
| **4 腿 + 2 轮** 的构型 | 说明"不是每条腿都要有轮" |
| **关节电机 + 轮毂电机** 的搭配 | 对比我们的"舵机 + MG310" |
| **3D 打印结构件** | 直接看打印件怎么设计 |
| 机加件版本 | 说明受力大的地方不能打印 |

> ⚠️ 我看不到 README 正文（Gitee 页面是 JS 渲染的），
> **建议你自己 clone 下来看 `doc/` 和图片**：`git clone https://gitee.com/daya35/wheel-legged.git`

### ② 立创 OSHWHUB：IronBen 四足轮腿

**[oshwhub.com/birdd/ironben-si-zu-lun-tui-ji-qi-ren-kai-yuan-_r](https://oshwhub.com/birdd/ironben-si-zu-lun-tui-ji-qi-ren-kai-yuan-_r)**

立创开源硬件平台的**整机项目**（含 PCB + 结构），适合看"电路板怎么塞进机身"。

### ③ 专利 CN111976859A（并联结构轮足）

[PDF 原文](http://patentimages.storage.googleapis.com/f3/ab/41/0223b91a5bc4a1/CN111976859A.pdf)

**专利用途**：看**腿的布置方式**和**受力路径**的描述（专利画得很细）。
另一个相关专利：[CN111003074A](https://patentimages.storage.googleapis.com/83/2b/b4/cf5c6baa63033f/CN111003074A.pdf)

---

## 3. ★ 你这个构型的 4 个工程要点

### ① 高机身的代价：重心高

你的图里机身是**竖着的高方块**。

| 问题 | 后果 |
|---|---|
| 重心高 | 转弯/加速时**容易侧翻** |
| 腿长 + 重心高 | 越障时力矩叠加 |

**建议**：
- 机身做**矮一点、宽一点**（同样体积，重心降低 30~40%）
- 最重的东西（电池）**放最底下**
- 高度只留够装板子的（FPGA + K230 叠起来约 60mm）

> 之前算过：重心要 **< 45mm** 才安全。你画的高机身很难做到 ✗

### ② 腿是**悬臂梁**，根部弯矩最大

```
机身 ┃
     ┃
     ┗━━━━━ 腿（悬臂）━━━━ ● 轮
                            ↑
                     电机 + 轮的重量全在这
```

- 腿根弯矩 = (电机 + 轮) × 腿长
- **腿根是全机应力最大的地方** → 加厚、加钢销、圆角

### ③ 几条腿有轮？（关键）

| 方案 | 驱动 | 转向 |
|---|---|---|
| **4 腿都有轮**（4 驱）| 越野强 | 差速转向 ✓（我们 RTL 就是这个）|
| **2 腿有轮**（达妙那种）| 轻 | 需要平衡控制 ✗ 我们没有 |

**达妙是 4 关节 + 2 轮毂** → 那 2 条没轮的腿是"支撑/摆臂"。

> ★ **我们已经有 4 个 MG310 电机** → 建议**4 腿都装轮** ✓
> 这样转向逻辑（`STEER_COEF=+1,+1,-1,-1`）直接可用，不用做平衡控制。

### ④ 腿的布置方式

| 布置 | 特点 |
|---|---|
| **四角**（我们的假设）| 差速转向最自然，和 RTL 一致 ✓ |
| **周向均布**（专利那种）| 更像"蜘蛛"，转向需要特殊策略 ✗ |

**建议**：四角布置（左前/右前/左后/右后）✓ 和引脚表的编号约定一致。

---

## 4. 需要你确认的两件事

| # | 问题 | 为什么重要 |
|---|---|---|
| 1 | **几条腿末端有轮？** 4 条都装，还是只有 2 条？ | 决定转向方式（差速 vs 平衡）|
| 2 | **腿是 1 段还是 2 段？** | 1 段简单、2 段能抬更高但复杂 |

你的图里我看到 **3 个"臂 + 圆"**（上、中、下各一个），
不确定是"同一个腿的 3 个角度"还是"3 条腿"。**这个必须说清楚**：
- 如果是**同一腿的 3 个姿态** → 那是"姿态示意图"，我们要 1 段腿就够
- 如果是**3 条腿** → 那是侧视图，说明是 4 腿 4 轮

---

## 5. 下一步建议

| 优先级 | 做什么 |
|---|---|
| 1 | **clone 达妙那个仓库**，看 `图片/结构` 和 3D 打印件尺寸 |
| 2 | 确认上面的两个问题（几条腿有轮 / 腿几段）|
| 3 | 定机身尺寸（**矮一点**），按"四角布置"画俯视图 |
| 4 | 腿根做加厚 + 钢销（悬臂梁的受力点）|

---

## 6. 一句话

> **你的构型叫"四足轮腿"，是成熟品类**，达妙和 IronBen 都有开源整机可参考。
> **但你的机身画得太高** —— 能矮 30% 就矮 30%，重心是这类机器人翻车的头号原因。
