yilo425/wheel-leg-robot-delivery/doc/四路板接线说明.md

# 四路驱动板接线说明（2026-10-19 到货）

> 依据：板子实物照片的丝印 + `constraints/pin_table.csv`（引脚权威）。
> 本文只管**这块板怎么和 FPGA、电机、舵机、电源连**。
> 总表见 `接线总表.md`；本文件可直接拿着对孔位接。

---

## 0. 今天这次演示的边界

| 项 | 状态 |
|---|---|
| 4 路驱动板 | ✅ 到了 |
| **舵机控制板 / 分配板** | ❌ **还没到** |
| **舵机独立 5~6V 电源模块** | ❌ **还没有** |
| 通电 | ❌ **本次不通电**，只接线 + 目视核对 |

**所以本次只接：信号线 + 地线。**
舵机的 `+` / `−` **两根线今天都别接**（原因见 §4）。

---

## 1. 板子上的接口（照丝印对）

### 1.1 顶部

| 丝印 | 是什么 | 怎么用 |
|---|---|---|
| `Vin+` / `−`（**蓝色 2 位接线柱**）| 电机/逻辑**总电源输入** | 接电池（4.5~15V）|
| `SW1`（**三位拨动开关**，标 `ON` / `OFF`）| 板上电源开关 | 接线时拨到 **OFF** |
| `GND GND GND` / `3V3 3V3 3V3` / `5V 5V 5V` | 板上稳压器的**输出**排针 | **别接回 FPGA**（见 §5 红线）|

> ⚠️ `Vin` 有极性、**没有反接保护**。接线前先确认 `Vin+` 是对应电池正极。

### 1.2 左侧逻辑输入排（2×6，对应通道 A / B）

从上到下（丝印）：

```
3V3    STBY
PWMB   PWMA
BIN2   AIN2
BIN1   AIN1
E2A    E1A
E2B    E1B
```

### 1.3 右侧逻辑输入排（2×6，对应通道 C / D + 电流采样）

```
ADC    GND
PWMD   PWMC
DIN2   CIN2
DIN1   CIN1
E4A    E3A
E4B    E3B
```

> ★ `ADC` 很可能是**电流采样输出**（板上通常有个分流电阻）。
> 如果确认是，它正好能用来做"堵转检测"（比现在的"靠超时猜"强得多）。
> **本次先不接、不依赖，等用万用表确认再说。**

### 1.4 四个电机接口（白色插头，底部 + 左右）

| 接口 | 丝印引脚顺序（从照片读）|
|---|---|
| `Motor_A`（左）| `AO2` `3V3` `E1A` `E1B` `GND` `AO1` |
| `Motor_B`（底左）| `BO2` `3V3` `E2B` `E2A` `3V3` `BO1` |
| `Motor_C`（底右）| `CO1` `GND` `E3A` `E3B` `3V3` `CO2` |
| `Motor_D`（右）| `DO2` `3V3` `E4B` `E4A` `GND` `DO1` |

**含义**：
- `?O1` / `?O2` = 电机两根线（**接 MG310 最粗的红黑**）
- `3V3` = 编码器电源
- `?Ax` / `?Bx` = 编码器 A/B 相
- `GND` = 编码器地
- ⚠️ **B / C 两个口的 3V3 有 2 个、GND 是 3V3** —— 这块板四个口的针序**不完全一样**，
  接线时**按各自丝印**，别照搬 A 口的顺序 ✗

> 编码器信号在板上有**两处**：
> ① 电机接口里（给电机插头用）
> ② 逻辑输入排的 `E1A/E1B ... E4A/E4B`（**这才是接 FPGA 的**）
> 二选一即可，别两个都接。

---

## 2. ★ 本次演示接线表（不上电，只接线）

### 2.1 电源（**今天不接**）

| 板子 | 接 | 今天 |
|---|---|---|
| `Vin+` | 电池正极 | ❌ 不接 |
| `Vin−` | 电池负极 | ❌ 不接 |
| `SW1` | —— | 拨到 **OFF** |

### 2.2 逻辑信号（FPGA → 板子）

| 通道 | 用途 | FPGA 信号 | 球号 | **孔位** | 板上引脚 |
|---|---|---|---|---|---|
| **A 左前** | PWM | `m_pwm[0]` | `A13` | **底排 20** | `PWMA` |
| | 方向1 | `m_dir[0]` | `A18` | **底排 18** | `AIN1` |
| | 方向2 | `m_dir2[0]` | `F19` | **底排 1** | `AIN2` |
| **B 右前** | PWM | `m_pwm[1]` | `A14` | **顶排 20** | `PWMB` |
| | 方向1 | `m_dir[1]` | `A19` | **顶排 18** | `BIN1` |
| | 方向2 | `m_dir2[1]` | `F18` | **底排 2** | `BIN2` |
| **C 左后** | PWM | `m_pwm[2]` | `A15` | **底排 19** | `PWMC` |
| | 方向1 | `m_dir[2]` | `F13` | **底排 17** | `CIN1` |
| | 方向2 | `m_dir2[2]` | `E19` | **底排 3** | `CIN2` |
| **D 右后** | PWM | `m_pwm[3]` | `A16` | **顶排 19** | `PWMD` |
| | 方向1 | `m_dir[3]` | `F14` | **顶排 17** | `DIN1` |
| | 方向2 | `m_dir2[3]` | `D20` | **底排 4** | `DIN2` |
| **使能** | STBY | `m_en` | `E13` | **底排 16** | `STBY` |
| **地** | —— | `GND` | —— | **顶排 6 或 15** | 板上 `GND` |

> **12 + 1 + 1 = 14 根信号线**（4 通道 × 3 + STBY + GND）

### 2.3 编码器（板子 → FPGA，8 根）

| 通道 | 板上 | FPGA 信号 | 球号 | **孔位** |
|---|---|---|---|---|
| A | `E1A` | `enc_a[0]` | `E14` | **顶排 16** |
| A | `E1B` | `enc_b[0]` | `C13` | **底排 14** |
| B | `E2A` | `enc_a[1]` | `B13` | **顶排 14** |
| B | `E2B` | `enc_b[1]` | `D14` | **底排 13** |
| C | `E3A` | `enc_a[2]` | `D15` | **顶排 13** |
| C | `E3B` | `enc_b[2]` | `C14` | **底排 12** |
| D | `E4A` | `enc_a[3]` | `C15` | **顶排 12** |
| D | `E4B` | `enc_b[3]` | `B15` | **底排 11** |

### 2.4 电机（4 根 × 2）

| 电机口 | MG310 的线 |
|---|---|
| `Motor_A` 的 `AO1` / `AO2` | 左前电机的**最粗红黑**（不分正负）|
| `Motor_B` 的 `BO1` / `BO2` | 右前 |
| `Motor_C` 的 `CO1` / `CO2` | 左后 |
| `Motor_D` 的 `DO1` / `DO2` | 右后 |

### 2.5 舵机（4 个，**没有控制板**）

| 舵机 | 信号 → FPGA | 电源 | 今天 |
|---|---|---|---|
| 前腿 ×2 | `lift_pwm[0]` = **`B16`（顶排 11）** | 外部 5~6V | **信号接，电源不接** |
| 后腿 ×2 | `lift_pwm[1]` = **`D17`（底排 10）** | 外部 5~6V | 同上 |
| 地 | 舵机 `−` → FPGA `GND` | —— | ✅ **要接**（共地）|

> 4 个舵机共用 2 路信号是**设计如此**（同组一起动），
> 一个 FPGA 引脚带 2 个舵机信号输入没问题（输入是高阻）✓

### 2.6 限位开关（可选，今天建议接上）

| 腿 | FPGA 信号 | 球号 | **孔位** |
|---|---|---|---|
| 前腿 | `lift_lim_n[0]` | `C17` | **顶排 10** |
| 后腿 | `lift_lim_n[1]` | `B17` | **底排 8** |

接法：**开关一端接 GND，另一端接信号脚**（内部上拉，按下=0）

---

## 3. 不上电的核对清单（今天做完这些就算成功）

| # | 核对 | 判据 |
|---|---|---|
| 1 | `SW1` 在 **OFF** | 目视 |
| 2 | **没有**任何线接到 `Vin+`/`Vin−` | 目视 |
| 3 | **没有**任何线接到板的 `3V3` / `5V` 输出排 | 目视 |
| 4 | 舵机的红（+）线**完全悬空** | 逐个捏一遍 |
| 5 | 舵机的棕/黑（−）已接 FPGA GND | 通断档量（万用表）|
| 6 | 12 根逻辑线 + 1 根 STBY + 1 根地 | 按 §2.2 逐根对 |
| 7 | 编码器 8 根 | 按 §2.3 逐根对 |
| 8 | `Vin` 极性：`+` 对着将来电池的正极 | 目视 |
| 9 | 4 个电机插头都插到底 | 手感 |

> **第 4 条最重要**：舵机电源线悬空是今天唯一能出事的地方（万一有人顺手通电）。

---

## 4. 为什么舵机电源今天不能接

| 尝试 | 后果 |
|---|---|
| 舵机 `+` 接 FPGA 的 `5V`（底排 15）| ✗ 4 个 MG996R 要 2~4A，FPGA 的 5V 只有 ~0.5A → **FPGA 复位** |
| 舵机 `+` 接板的 `5V` 输出排 | ✗ 那是**逻辑用**的小稳压器（几十 mA），会烧 |
| 舵机 `+` 接 `Vin+`（12V）| ✗ **12V 直接烧舵机** |

**正确做法（等电源模块到了）**：
```
电池 → DC-DC 5V/5A → 舵机分配板 → 4×舵机
                     ↑
           并 1000µF 电容
```

---

## 5. 三条红线（通电前必须再确认一次）

1. **FPGA 的 3V3 / 5V 绝不接** 板的 `Vin`、舵机电源、电机电源。
2. **板的 `3V3` / `5V` / `ADC` 排针绝不接回** FPGA（两个稳压器并联会倒灌发烫，
   上次烧掉一块板就是这个原因）。
3. **`Vin` 反接 = 报废**（无保护）。

---

## 6. 引脚分配的逻辑（为什么是这些球号）

### 6.1 第一层约束：**只有 GPIO0 扩展口能用**

| 位置 | 能不能接杜邦线 | 结论 |
|---|---|---|
| **GPIO0 2×20 排针** | ✅ 母座 + 每个孔旁边**印着球号** | **全部功能都放这里** |
| 板上 UART 焊盘（M15/J21）| ❌ 是焊盘不是排针 | 弃用（调试串口另接 USB-TTL）|
| 板载 I2C 排针 | ⚠️ 丝印有歧义，插错就烧 | 弃用（I2C 也挪到 GPIO0）|

**所以 49 个引脚全在 GPIO0 上** —— 这是唯一"能接线、能核对"的地方。

### 6.2 第二层：**按功能分块，块内相邻**

```
底排 20 ~ 顶排 17   →  电机 PWM / 方向      （12 根，连成一条扁带）
顶排 16 ~ 底排 11   →  编码器 4 组 A/B      （每组两根相邻）
顶排 11 / 底排 10   →  舵机 2 路
顶排 10 / 底排 8    →  限位 2 路
顶排 7 / 底排 5     →  串口 TX/RX
```

好处：**每一束线走一条边**，不会在板子中间交叉 ✓

### 6.3 第三层：**下标约定全项目统一**

```
0 = 左前  1 = 右前  2 = 左后  3 = 右后
```

**为什么重要**：这个顺序必须和 `motion_decision.v` 的 `STEER_COEF = +1,+1,-1,-1`
一致。曾经 RTL 按"左右"分组、引脚表按"位置"编号 → **转向整个反过来** ✗

### 6.4 第四层：**上拉/下拉按信号类型配**

| 信号类型 | 配置 | 为什么 |
|---|---|---|
| 编码器 A/B | `PULL_MODE=UP` | 霍尔是**开漏**，必须上拉；不接时读稳定高（不计数）|
| 限位开关 | `UP` | 常开到 GND，未按=1、按下=0 |
| 超声波 ECHO | **`DOWN`** | 模块没接时读 0（=没有回波），不会乱飘 |
| 舵机 PWM / 电机 | `NONE` | 推挽输出，不需要上下拉 |
| 串口 RX | `UP` | 空闲高电平（UART 的 idle 状态）|
| **`m_en`（STBY）** | **`DOWN`** | **上电默认停车**（安全默认值）|

> `STBY` 配 `DOWN` 是有意的：FPGA 没配置好之前，板上驱动是关闭的 ✓

### 6.5 第五层：**留余量**

| 剩余资源 | 用途 |
|---|---|
| `E17`（顶排 5）| **唯一空闲的 GPIO0 脚** —— 留给将来的电流采样 / 第 5 路信号 |
| 板上拨码开关 SW0~7（8 个输入）| 可做模式选择，不占 GPIO0 |
| 板上 LED4~8 | 已用于 `state_dbg` / `speed_scale_dbg` |

### 6.6 一个已知未确认项

`N19` 同时被标为 **LED8** 和**无源蜂鸣器 BEEP** —— 下次上板用万用表量一下，
如果真冲突，`speed_scale_dbg[1]` 要换脚（文档里备选写的是 B17，
但 B17 现在被 `lift_lim_n[1]` 占了，**需要重新选**）。

---

## 7. 接线顺序（今天按这个来）

```
① 所有电源不接（Vin、舵机+、电池）
② SW1 拨到 OFF
③ 先接【地】：FPGA GND ↔ 板 GND ↔ 舵机 −（3 个点连通）
④ 再接【电机线】：4 组 AO1/AO2 ...（粗线，注意别插到编码器针上）
⑤ 再接【逻辑】：12 根（§2.2）+ STBY + 编码器 8 根（§2.3）
⑥ 最后接【舵机信号】：2 根（B16 / D17）
⑦ 按 §3 清单逐条核对
⑧ 拍照留档（以后拆了能对着接回去）
```

---

## 8. 下次通电前还要补的东西

| 缺什么 | 影响 | 买什么 |
|---|---|---|
| 舵机 5~6V/5A 电源 | 舵机不能动 | DC-DC 模块 ¥10~15 |
| 1000µF 电容 | 舵机启动会把 DC-DC 拉保护 | ¥2 |
| 舵机分配板（或 Y 线）| 4 个舵机接线乱 | ¥5~15 / ¥3 |
| 电池 + 开关 | 没法供电 | 见 `接线总表.md` §6 |
| （可选）电流采样接到 `ADC` | 能做真堵转检测 | 先量一下 `ADC` 是不是采样输出 |
