yilo425/wheel-leg-robot-delivery/doc/接线表_20261102.md

# 轮足机器人 · 完整接线表

> 依据：`constraints/top.cst`（2026-11-02 实机核对定稿）
> 固件：Flash 里的生产版（`MOTOR_TEST_MODE=0`、`FORCE_OPEN_LOOP=1`、`DIR_INV_MASK=4'b0100`）

---

## 一、FPGA 排针坐标速查

### 顶排（丝印从左到右）

```
位置:  1    2    3    4    5    6    7    8    9    10   11   12   13   14   15   16   17   18   19   20
球号: F20  E18  D19  C20  E17  GND  C19  B18  D16  C17  B16  C15  D15  B13  GND  E14  F14  A19  A16  A14
```

### 底排（丝印从左到右）

```
位置:  1    2    3    4    5    6    7    8    9    10   11   12   13   14   15   16   17   18   19   20
球号: F19  F18  E19  D20  F16  3V3  C18  B17  E16  D17  B15  C14  D14  C13  5V   E13  F13  A18  A15  A13
```

**电源孔**：顶排 6 = GND、顶排 15 = GND、底排 6 = 3V3、底排 15 = 5V

---

## 二、电机驱动板 TB6612（4 路 × 5 根 + STBY）

| 通道 | 车轮 | 信号 | 驱动板引脚 | FPGA 球号 | **FPGA 孔位** |
|---|---|---|---|---|---|
| **A** | 左前 | PWM | `PWMA` | `E14` | **顶排 16** |
| | | 方向1 | `AIN1` | `A19` | **顶排 18** |
| | | 方向2 | `AIN2` | `F14` | **顶排 17** |
| | | 编码器A | `E1A` | `A16` | **顶排 19** |
| | | 编码器B | `E1B` | `A14` | **顶排 20** |
| **B** | 左后 | PWM | `PWMB` | `E13` | **底排 16** |
| | | 方向1 | `BIN1` | `A18` | **底排 18** |
| | | 方向2 | `BIN2` | `F13` | **底排 17** |
| | | 编码器A | `E2A` | `A15` | **底排 19** |
| | | 编码器B | `E2B` | `A13` | **底排 20** |
| **C** | 右后 | PWM | `PWMC` | `C17` | **顶排 10** |
| | | 方向1 | `CIN1` | `C15` | **顶排 12** |
| | | 方向2 | `CIN2` | `B16` | **顶排 11** |
| | | 编码器A | `E3A` | `D15` | **顶排 13** |
| | | 编码器B | `E3B` | `B13` | **顶排 14** |
| **D** | 右前 | PWM | `PWMD` | `D17` | **底排 10** |
| | | 方向1 | `DIN1` | `F19` | **底排 1** ⚠️ |
| | | 方向2 | `DIN2` | `F18` | **底排 2** ⚠️ |
| | | 编码器A | `E4A` | `D14` | **底排 13** |
| | | 编码器B | `E4B` | `C13` | **底排 14** |
| **公共** | | **STBY** | `STBY` | `E16` | **底排 9** ★★★ |

### ⚠️ 三个必须注意的点

| # | 注意 |
|---|---|
| **1** | **STBY 必须接**（底排 9）—— 不接则驱动芯片待机，**任何电机都不转** |
| **2** | **D 通道的方向脚走飞线**（底排 1/2），因为 **C14、B15 两个 FPGA 引脚已损坏** |
| **3** | 方向1 / 方向2 **不是顺序排列**（如 C：12 是 IN1、11 是 IN2）|

---

## 三、舵机驱动 PCA9685（5 根）

| FPGA 孔位 | 球号 | PCA9685 |
|---|---|---|
| **顶排 4** | `C20` | `SCL` |
| **顶排 3** | `D19` | `SDA` |
| **底排 6** | `3V3` | `VCC` ⚠️ **必须 3.3V，不能接 5V** |
| **顶排 6** | `GND` | `GND` |
| **顶排 6** | `GND` | `OE`（拉低使能）|

### PCA9685 → 舵机

| 通道 | 舵机 |
|---|---|
| 0 | 前腿左 |
| 1 | 前腿右 |
| 2 | 后腿左 |
| 3 | 后腿右 |

**舵机三根线**：橙/黄 = 信号（PWM 针）| 红 = 电源（V+ 排）| 棕/黑 = 地（GND 排）

---

## 四、K230 ↔ FPGA 串口（3 根，交叉接）

| K230 排针 | 方向 | FPGA 球号 | **FPGA 孔位** |
|---|---|---|---|
| **11**（UART2_TXD）| → | `F16` | **底排 5** |
| **13**（UART2_RXD）| ← | `C19` | **顶排 7** |
| **9 或 14**（GND）| ↔ | GND | **顶排 15** |

> ⚠️ **交叉接**：K230 的 TX 接 FPGA 的 F16（不是 C19）
> ⚠️ **GND 必接**：K230 用充电宝供电时尤其关键，否则串口不通

---

## 五、超声波 HC-SR04（4 根）

| FPGA 孔位 | 球号 | HC-SR04 |
|---|---|---|
| **顶排 1** | `F20` | `TRIG` |
| **顶排 2** | `E18` | `ECHO` |
| 顶排 6/15 | GND | `GND` |
| 底排 15 | 5V | `VCC` |

---

## 六、按键（3 个）

| 功能 | FPGA 球号 | 位置 |
|---|---|---|
| **启动**（进自动模式）| `F15` | 按键 S0 |
| **急停** | `A20` | 按键 S1 |
| **复位** | `B21` | 按键 S4 |

---

## 七、LED 指示灯

| LED | 球号 | 含义 |
|---|---|---|
| **D0** | `M22` | 复位完成（`rst_n`）|
| **D1** | `N22` | 电机使能（`motor_enable_fsm`）|
| **D2** | `L21` | 避障/抬腿动作中 |
| **D3** | `K21` | **I²C 通 + PCA9685 就绪** ★ |
| **D4** | `K22` | 状态位0（0=IDLE 1=MANUAL）|
| **D5** | `J22` | 状态位1（2=AUTO 3=AVOID）|
| **D6** | `H22` | 状态位2 |
| **D7** | `M21` | 速度档位0 |
| **D8** | `N19` | 速度档位1 |

**正常待机**：D0 / D1 / D3 / D4 / D7 亮 ✓

---

## 八、电源接线

```
3S 锂电池 12.6V
  │
  ├─→ 5A 保险丝 ─→ 驱动板 Vin+ ─→ 电机（4 路）
  │               驱动板 Vin− ─→ 电池负极
  │
  ├─→ LM2596 降压模块
  │     ├─ 输入+ ← 电池正极
  │     ├─ 输入− ← 电池负极
  │     └─ 输出+ = 9.2V ─→ FPGA DC 圆口
  │
  ├─→ UBEC 降压模块（12V → 5V）
  │     ├─ 输入+ ← 电池正极
  │     ├─ 输入− ← 电池负极
  │     └─ 输出+ = 5.16V ─→ PCA9685 的 V+（舵机电源）
  │
  └─→ FPGA 3.3V（底排 6）─→ PCA9685 的 VCC（逻辑电源）
```

### 共地清单（全部必须连在一起）

```
电池− / 驱动板 Vin− / UBEC 输入− / LM2596 输入− /
FPGA GND（顶排 6 或 15）/ PCA9685 GND / K230 GND
```

---

## 九、上电顺序

```
① FPGA 先上电（LM2596 输出 9.2V）
② 看 D0 亮、D3 亮（I²C / PCA9685 就绪）
③ UBEC 通电，等 1~2 分钟（它刚上电会先输出 ~11.8V，慢慢降到 5.16V）
④ 确认稳定后再给舵机供电（PCA9685 的 V+）
⑤ K230 上电（USB 或充电宝）
```

> ⚠️ UBEC 未稳定时给舵机供电会烧舵机 ✗

---

## 十、接线后自检（15 分钟，非常值得）

```
□ 1. 万用表蜂鸣档，逐根验排线（一端按 FPGA 孔，一端按驱动板脚）
□ 2. 任意两根信号线之间不导通（不短路）
□ 3. STBY（底排 9）接了没有
□ 4. 所有 GND 是否共地
□ 5. 手转每个电机，确认顺滑（不卡）
□ 6. 上电：D0 / D1 / D3 / D4 / D7 亮
□ 7. 舵机通电后往里收 30°（腿垂直）
```

---

## 十一、通道 → 车轮 映射

| 通道 | 车轮 | 驱动板座 |
|---|---|---|
| **A** | **左前** | `Motor_A` |
| **B** | **左后** | `Motor_B` |
| **C** | **右后** | `Motor_C` |
| **D** | **右前** | `Motor_D` |

**转向系数**（`STEER_COEF`）：A=+1、B=+1、C=−1、D=−1（左轮加速、右轮减速）

**方向取反**（`DIR_INV_MASK`）：`4'b0100`（只取反 C）

---

## 十二、⚠️ 已知硬件问题

| # | 问题 | 处理 |
|---|---|---|
| 1 | **FPGA 的 C14、B15 两个 IO 已损坏** | D 的方向脚改用 F19（底排1）/ F18（底排2）飞线 |
| 2 | 转向时前后轮方向不一致 | 待最终接线后逐通道核对，用 `DIR_INV_MASK` 修正 |
| 3 | 无 5A 保险丝 | 待装 |
| 4 | 编码器极性未逐一确认 | 当前用开环控制，不依赖编码器 |
