yilo425/wheel-leg-robot-delivery/doc/收工记录_20261027.md

# 2026-10-27 晚 收工记录

> 一句话：**FPGA 能自己启动了，FPGA↔K230 串口通了，车身改到可打印。**

---

## 1. 今天完成的三件事

### ① FPGA 掉电保存（重大进度）

| 项 | 结果 |
|---|---|
| 板载配置 Flash | **GD25Q128**（16MB，JEDEC `0xC22018`）|
| 比特流 | `robot.bin` **4.33MB**（`robot.fs` 34.7MB 是填充容器，别用错）|
| 烧写方式 | **只能 GUI**：`External Flash Mode` → `exFlash Erase,Program,Verify Arora V` → 102 秒 |
| 验证 | 拔掉 JTAG、断电重上电，**D0 常亮** ✓ 完全脱离电脑 |
| 现在 Flash 里 | 安全版固件（`MOTOR_TEST_MODE=0`，电机不转）|

详细步骤 + 三个坑见 [`doc/明日上板检查单.md`](明日上板检查单.md) 的「★★ 掉电保存」一节。

### ② FPGA ↔ K230 串口打通（实机验证）

接线（3 根，交叉）：

| K230 排针 | | FPGA | 孔位 |
|---|---|---|---|
| 11 (UART2_TXD) | → | `F16` (uart_rx) | 底排第 5 |
| 13 (UART2_RXD) | ← | `C19` (uart_tx) | 顶排第 7 |
| 9 / 14 (GND) | ↔ | GND | 顶排 6 / 15 |

验收结果：**276 帧、BCC/帧尾/版本错误全 0、噪声 0** ✓

### ③ 车身第六批改动 + 定位柱避让 bug

- 电机板 4 柱 → **(21, −2)**；电池挡板 P1 删除（刻槽保留）；两道分区墙都没了
- **修了个真 bug**：柱脚落到通风孔上会悬空（STL `Volumes` 从 2 变 3）→ 新增 `MOD_POSTS` + `vent_hits_post()`，通风孔自动避开定位柱 5mm
- lower STL：`Volumes 2`、0 非流形、242×150×45

---

## 2. 抓到并修掉的两个 ARM 侧真 Bug

### ① `uart.any()` 谎报（"0 帧"的真凶）

```
u.any()  → 1        ← 假的
u.read() → 1320 B   ← 实际有这么多
```

旧 `_read_available()` 按 `any()` 的数量读 → **每 10ms 只读 1 字节**（≈100 B/s），
而 FPGA 以 220 B/s 发 → 缓冲溢出丢字节 → 帧永远拼不完整。

> 现象就是那句 `收到 0 帧；噪声 299B`，而 299 ≈ 3 秒 × 100 B/s，完全吻合。

**已改**：不再问 `any()`，直接 `uart.read()`（`timeout=0` 仍非阻塞）。

### ② 遥测第 0 字节拆错

格式是 `{1'b0, flags[3:0], state[2:0]}`，旧代码把整字节当 state → 打出 `UNKNOWN(64)`。
**已改**：`state = b0 & 7`、`flags = (b0 >> 3) & 0xF`（文档里的 `>>2` 也一并修正）。

---

## 3. ⚠️ 明天第一件事（5 分钟）

**把修好的两个文件拷到 K230 卡里**（和 `board_bringup.py` 同目录），
否则断电重启后又会用回旧代码：

```
arm/k230_20261018/arm_k230_release_20261018/arm/camera_vision.py
arm/k230_20261018/arm_k230_release_20261018/arm/uart_proto.py
```

拷完重跑一次确认：

```powershell
cd D:\dsh-ws\robot_project
powershell -ExecutionPolicy Bypass -File .\tools\k230_repl.ps1 `
  -Cmd "board_bringup.run(['listen','3'])" -Wait 8
```

判据：`好帧 > 0`、`噪声 0B`、状态显示 `S_IDLE`（不是 `UNKNOWN(64)`）。

---

## 4. 本周剩下的事（按优先级）

| # | 事 | 需要什么 | 备注 |
|---|---|---|---|
| 1 | 拷文件到卡 + 复验串口 | 读卡器 | 5 分钟 |
| 2 | 验电机方向 | **轮子离地** + 5A 保险丝 | 用 SRAM 烧 `robot_motortest.fs`，不影响 Flash |
| 3 | 正式 12V 布线 | **硅胶线（还没到）** | 端子排 3P=+12V / 2P=GND |
| 4 | `goal_reached` 语义反了 | 改 1 行 + 重新综合 | 现在位=1 表示"**未**到达" |
| 5 | 车身端子排槽缩到 30×10 | — | 现在 78mm 配 5 位块太松 |
| 6 | IMU 姿态解算 | — | roll/pitch/yaw 现在恒 0 |

---

## 5. 现在各东西的状态（都安全）

| 东西 | 状态 |
|---|---|
| FPGA 板 | Flash 里是**安全版固件**，上电自动跑，电机不转 ✓ |
| K230 卡 | 还是旧代码（串口能通，只是丢字节）✓ 不影响使用 |
| 车身 SCAD/STL | 已提交，可打印 ✓ |
| 硬件连接 | 3 根杜邦线接着，断电即可，不会烧东西 ✓ |

**可以直接关电脑、拔电，明天插上就能继续。**
