yilo425/wheel-leg-robot-delivery/doc/杜邦线接线表.md

# 杜邦线接线表（信号线 · 低压低电流）

> 2026-10-25。本文是**信号/逻辑**接线，全部用**杜邦线**（3.3V 逻辑，细线）。
> **供电/大电流线**另见 `doc/供电硅胶线接线表.md`，不要混用。

---

## 0. 怎么找孔（先看这里）

GPIO0 扩展口是 2×20 母排。每个孔旁边**丝印着 FPGA 球号**（如 `A13`、`C19`），
**以球号为准** —— 这是唯一零歧义的方法。

| 排 | 孔 1 | 2 | 3 | 4 | 5 | 6 | 7 | 8 | 9 | 10 | 11 | 12 | 13 | 14 | 15 | 16 | 17 | 18 | 19 | 20 |
|---|---|---|---|---|---|---|---|---|---|---|---|---|---|---|---|---|---|---|---|---|---|
| **顶排**（有 F20）| F20 | E18 | D19 | C20 | E17 | GND | C19 | B18 | D16 | C17 | B16 | C15 | D15 | B13 | GND | E14 | F14 | A19 | A16 | A14 |
| **底排**（有 A13）| F19 | F18 | E19 | D20 | F16 | 3V3 | C18 | B17 | E16 | D17 | B15 | C14 | D14 | C13 | 5V | E13 | F13 | A18 | A15 | A13 |

> ⚠️ **已知文档冲突**：`constraints/pin_table.csv` 的 note 列和 `doc/board_pinout.md §3`
> 那套「GPIO0_N」编号，在 **E18 / F19** 上有出入（一个写 E18=_34，另一个 E18=_33）。
> **别按 GPIO0_N 数孔**，直接看丝印球号，这张表列的就是球号，不会错。

---

## 1. 电机驱动板逻辑信号（14 根）

> 驱动板是 4 通道 RZ7899 类。两排逻辑排针（左/右各 8 针），
> 针名见丝印（PWMA/AIN1/AIN2/E1A/E1B…）。

| # | FPGA 球号 | 孔位 | 驱动板脚 | 说明 |
|---|---|---|---|---|
| 1 | `A13` | 底 20 | `PWMA` | 电机0(左前) PWM |
| 2 | `A14` | 顶 20 | `PWMB` | 电机1(右前) PWM |
| 3 | `A15` | 底 19 | `PWMC` | 电机2(左后) PWM |
| 4 | `A16` | 顶 19 | `PWMD` | 电机3(右后) PWM |
| 5 | `A18` | 底 18 | `AIN1` | 电机0 方向1 |
| 6 | `A19` | 顶 18 | `BIN1` | 电机1 方向1 |
| 7 | `F13` | 底 17 | `CIN1` | 电机2 方向1 |
| 8 | `F14` | 顶 17 | `DIN1` | 电机3 方向1 |
| 9 | `F19` | 底 1 | `AIN2` | 电机0 方向2（不接则 AIN2 接地）|
| 10 | `F18` | 底 2 | `BIN2` | 电机1 方向2 |
| 11 | `E19` | 底 3 | `CIN2` | 电机2 方向2 |
| 12 | `D20` | 底 4 | `DIN2` | 电机3 方向2 |
| 13 | `E13` | 底 16 | `STBY` | 驱动使能（默认下拉=上电停车）|
| 14 | **GND** | 顶 6 | 驱动板 `GND`（逻辑排那个）| 共地，**不能省** |

> ⚠️ 板上还有 `3V3` / `5V` / `ADC` 输出脚：**一律不接回 FPGA**。
> `ADC` 疑似电流采样，未验证前别碰。

---

## 2. 编码器（8 根，从驱动板直通 → FPGA）

> MG310 编码器在**电机 6P 插座里**，驱动板把它直通到 `E1A/E1B…` 逻辑脚。
> 这里直接把驱动板的 E 脚接到 FPGA，别去电机那头单独接线。

| # | FPGA 球号 | 孔位 | 驱动板脚 | 轮 |
|---|---|---|---|---|
| 1 | `E14` | 顶 16 | `E1A` | 左前 A |
| 2 | `C13` | 底 14 | `E1B` | 左前 B |
| 3 | `B13` | 顶 14 | `E2A` | 右前 A |
| 4 | `D14` | 底 13 | `E2B` | 右前 B |
| 5 | `D15` | 顶 13 | `E3A` | 左后 A |
| 6 | `C14` | 底 12 | `E3B` | 左后 B |
| 7 | `C15` | 顶 12 | `E4A` | 右后 A |
| 8 | `B15` | 底 11 | `E4B` | 右后 B |

> 规律：A 相全在**顶排**（16/14/13/12），B 相全在**底排**（14/13/12/11）。
> 编码器是 5V 供电、3.3V 输出（多数 MG310），电源由驱动板电机座提供，不另接线。
> 上板前先量编码器输出高电平是不是 3.3V。

---

## 3. K230（ARM）串口（3 根，交叉）

| # | FPGA 球号 | 孔位 | 接到 ARM | 说明 |
|---|---|---|---|---|
| 1 | `C19` | 顶 7 | ARM **RX** | FPGA 发 |
| 2 | `F16` | 底 5 | ARM **TX** | FPGA 收 |
| 3 | **GND** | 顶 6 | ARM GND | 共地，**不能省** |

> 两块板都 3.3V，直连。**TX↔RX 交叉**，别同向。
> 想看 PC 串口：接 USB-TTL 到 `C19`/`F16`（不是插板子 USB 口）。

---

## 4. HC-SR04 超声波（4 根）

| # | FPGA 球号 | 孔位 | 模块脚 | 说明 |
|---|---|---|---|---|
| 1 | `F20` | 顶 1 | `TRIG` | 输出触发 |
| 2 | `E18` | 顶 2 | `ECHO` | 输入回波 |
| 3 | **3V3** | 底 6 | `VCC` | ⚠️ **先按 3.3V 供电**，别上 5V |
| 4 | **GND** | 顶 6 | `GND` | |

> ⚠️ **ECHO 是输入**：模块按 5V 供电时它输出 5V，会打死 3.3V 的 FPGA IO。
> 宁可 3.3V 欠压，不能 5V 过压。要 5V 供电必须在 ECHO 串 1k+2k 分压。

---

## 5. 限位开关 ×2（6 根）

| # | FPGA 球号 | 孔位 | 模块脚 | 说明 |
|---|---|---|---|---|
| 1 | `C17` | 顶 10 | 前腿 OUT | `lift_lim_n[0]` 前腿到位（低有效）|
| 2 | `B17` | 底 8 | 后腿 OUT | `lift_lim_n[1]` 后腿到位（低有效）|
| 3 | **3V3** | 底 6 | 前腿 VCC | ⚠️ **绝不能接 5V** |
| 4 | **3V3** | 底 6 | 后腿 VCC | 同上 |
| 5 | **GND** | 顶 6 | 前腿 GND | |
| 6 | **GND** | 顶 6 | 后腿 GND | |

> ⚠️ 限位模块 VCC=5V 时 OUT 也是 5V → 灌进 3.3V IO 打死 FPGA。
> **必须 3V3**。接前用万用表量 OUT 极性（不触发 3.3V / 触发 0V 才对）。

---

## 6. 舵机信号（二选一）

### 6.1 ★ 用 PCA9685（`SERVO_IF=1`，无需 Y 线，已 26 项验证）

| # | FPGA 球号 | 孔位 | PCA9685 脚 | 说明 |
|---|---|---|---|---|
| 1 | `C20` | 顶 4 | `SCL` | I2C 时钟（板上自带 10k 上拉）|
| 2 | `D19` | 顶 3 | `SDA` | I2C 数据 |
| 3 | **3V3** | 底 6 | `VCC` | ⚠️ 逻辑电平，**绝不能 5V** |
| 4 | **GND** | 顶 6 | `GND` | |

> 4 个舵机直接插 PCA9685 的 ch0~ch3（前左/前右/后左/后右）。
> 舵机**电源**（6V）走硅胶线表，不是这里。

### 6.2 直驱（`SERVO_IF=0`，需 2 根 Y 线）

| # | FPGA 球号 | 孔位 | 说明 |
|---|---|---|---|
| 1 | `B16` | 顶 11 | `lift_pwm[0]` 前腿组 → Y 线 → 前左+前右舵机信号 |
| 2 | `D17` | 底 10 | `lift_pwm[1]` 后腿组 → Y 线 → 后左+后右舵机信号 |

> Y 线 1 母→2 公，把信号（黄）分给同组两个舵机。**电源走硅胶线表**。

---

## 7. 可选

| 信号 | 球号 | 孔位 | 说明 |
|---|---|---|---|
| `uart_tx_dbg` | `M15` | 板上 USB 转串口焊盘 | 调试串口 TX，接 USB-TTL 才能看（板载 USB 收不到）|
| `i2c_scl`/`i2c_sda` | `C20`/`D19` | 顶 4 / 顶 3 | 若改用 VL53L0X（TOF_IF=0）时挂 TOF；和 PCA9685 共用总线 |

---

## 8. 汇总与采购

| 用途 | 根数 |
|---|---|
| 电机驱动逻辑 | 14 |
| 编码器 | 8 |
| K230 串口 | 3 |
| HC-SR04 | 4 |
| 限位 ×2 | 6 |
| 舵机（PCA9685）| 4 |
| **合计（PCA9685 方案）** | **39 根** |

**杜邦线采购**：公-母杜邦线 40 根（40cm）+ 备用几根；再备 **2× 母-母**（接 Y 线/分线用）。

> 换直驱方案时：舵机那 4 根换成 2 根（B16/D17）+ 2 根 Y 线，总根数少 2。
