yilo425/wheel-leg-robot-delivery/doc/给队友的交接摘要.md

# 给队友的交接摘要（2026-10-19）

> 直接转发即可。谁负责哪块看 §5。

---

## 1. 一句话现状

**FPGA 侧代码基本完成：21 条测试 / 835 项检查全过，两个比特流已预编译好。**
现在卡在**机械和接线**，硬件到了就能上板。

| 模块 | 状态 |
|---|---|
| FPGA RTL（状态机/视觉/遥测/电机/舵机/避障） | ✅ 完成，835 项回归全过 |
| 与 ARM 的串口协议 | ✅ 双向实测通过（FPGA↔K230）|
| 摄像头 → 视觉类别 → 状态切换 | ✅ 实测 <500ms |
| 四路驱动板接线表 | ✅ 已按实物丝印写好 |
| **机械结构 / 内部布局** | ⚠️ **进行中，有待定项**（见 §4）|
| 4 舵机 + 电源模块 | ❌ **还没到货** |

---

## 2. 这几天新增了 8 个提交，重点看这三个

| 提交 | 内容 | 为什么重要 |
|---|---|---|
| `357d312` | **修速度环：纯 P 只能跑到目标的 31% → 加积分项 100%** | ★ 之前所有测试都是开环，这个缺陷一直没暴露；不加的话车永远跑不到设计速度 |
| `3f9b6eb` | **越障失败降级**：抬腿跨不过去 → 收腿绕行，不再停车等人 | ★ 之前"跨不过去"= 整台车卡死，比赛里就是事故 |
| `6a959bd` | 四路板接线说明（按实物丝印）| 今天接线对着做 |

其余：`check_always_reset`（新静态检查）、`tb_telemetry_payload`（验载荷字段）、`CONFIG 0x10/0x11` 真正生效、`m_dir2` 第二方向脚。

---

## 3. ★ 六个已经定下来的结论（别再重复讨论）

### ① 低矮障碍判据：5cm → **4 / 7cm 双阈值**

```
≤ 4cm   → 不抬腿，直接压过去
4~7cm   → 抬腿跨（发 0x04）
> 7cm    → 绕行（发 0x02）
```
**原因**：常见障碍物就是 **5cm 立方体**（查到的同类赛事场地规格），
判据卡在 5cm 会"一会儿跨一会儿绕"来回抖。

### ② 充电宝**不能放顶层**

最重的单体（~200g）放最高层 = 重心最高 → 转弯侧倾、越障易翻。
**挪到最底层**（和电池、舵机一起）。

### ③ 腿长 **70mm**，但**收起角不能用 45°**

`45° 收起时腿尖离地 = 舵机轴高 − 49.5mm` → 轴高不够就是**负的（扎地里）**。
- 要么舵机轴装到 ≥65mm 高
- 要么腿缩短到 50~55mm
- **这个数现在就能量**：拿打印件比一下

### ④ 舵机接法：用**原厂 25 齿舵机盘**，埋进腿根的 U 型槽

- **绝不自己打印花键**（25 齿精度打印不出来）
- 盘的一条臂埋进腿根槽里，**2 颗 M2 穿透**（用最内 + 最外两个孔，间距 14mm）
- 另一条臂**切掉**
- 力矩余量 10~30 倍 ✓

### ⑤ 层板用**亚克力 + 铜柱**，只打印支架 → 省 ¥200+

参考开源项目（1800⭐）的做法：**底板亚克力 ¥5，全部打印件 ¥100**。
- 层板：激光切割亚克力 3mm（¥5~15/块）
- 分层：**M3 铜柱**，不是打印框架
- 打印件只做支架/卡扣（舵机架、FPGA 架、相机架、电池夹）

### ⑥ 腿不能只靠舵机轴，**要加轴承**

开源项目在**每个关节**都放了：深沟球 604（抗径向）+ 推力轴承 F8-14M（抗轴向）。
舵机输出轴受弯矩会很快旷掉。

---

## 4. ⚠️ 还没定的 / 有风险的点

| # | 问题 | 谁定 | 备注 |
|---|---|---|---|
| 1 | **目标台阶高度到底多少** | 机械 + 看规则 | 决定腿长；>50mm 要换 20kg·cm 舵机 |
| 2 | 腿的**收起角**（保证离地 15~20mm）| 机械 | 拿打印件量一下就知道 |
| 3 | 4 舵机的**独立 5~6V/5A 电源** | 采购 | **必须独立**，接 FPGA 的 5V 会拉垮 FPGA |
| 4 | **电池容量**（建议 1500mAh 左右，别 3000）| 采购 | 开源项目只用 800mAh/57g，续航 20-30 分钟 |
| 5 | 双 TOF 判高度（3cm / 8cm 两个高度）| 采购 + FPGA | 比单目视觉稳，但要买第二个 TOF |
| 6 | **限位开关怎么装** | 机械 | 不装也能跑（靠超时兜底），但不可靠 |

---

## 5. 分工

| 人 | 负责 | 现在要做的 |
|---|---|---|
| **A（FPGA）** | RTL / 回归 / 接线表 | 等硬件；可选做"双 TOF 高度判别" |
| **B（ARM）** | K230 视觉 | ① 判据改 4/7cm ② 上电自动运行 `/sdcard/main.py` |
| **C（机械）** | 车身 / 腿 / 装配 | ① 量舵机轴高和腿尖离地 ② 层板改亚克力 ③ 充电宝挪底层 |
| **采购** | 电源模块 / TOF / 舵机板 | 5V/5A 降压 ×2、1000µF、第二路 TOF |

---

## 6. 今天要做的事（接线，**不通电**）

板子到货：**四路驱动板**。舵机控制板和电源模块**还没到**。

**所以今天只接：信号线 + 地线。**

```
① 所有电源不接，SW1 拨 OFF
② 先接地（FPGA GND ↔ 板 GND ↔ 舵机 −，三点连通）
③ 电机线（粗线，别插到编码器针上）
④ 逻辑 12 根 + STBY + 编码器 8 根
⑤ 舵机信号 2 根
⑥ 核对清单
⑦ 拍照存档
```

⚠️ **舵机的红线（+）今天必须完全悬空** —— 没有 5V 电源时，
接到 FPGA 的 5V 会拉垮 FPGA，接 12V 直接烧舵机。

**完整接线表见 `doc/四路板接线说明.md`**（含每根线的球号 + 物理孔位）。

---

## 7. 文件在哪

| 文件 | 内容 |
|---|---|
| `doc/四路板接线说明.md` | ★ **今天接线看这个** |
| `doc/接线总表.md` | 全部部件连线（含孔位）|
| `doc/同类作品调研.md` | ★ **开源 CAD 资源 + 内部布局 + 成本方案** |
| `doc/腿结构与尺寸设计.md` | 腿的尺寸/打印/接法 |
| `doc/进度与交接.md` | 整体进度 |
| `doc/踩坑与经验.md` | **踩过的坑，上板前必读** |
| `doc/明日上板检查单.md` | 上板步骤 |

## 8. 关键资源（机械必看）

**开源轮腿机器人，完整 SolidWorks 装配体**：
<https://github.com/Skythinker616/foc-wheel-legged-robot>

- `solidworks/总装.SLDASM`（35MB）= **总装配体，直接看内部怎么摆**
- 里面有 `底板` `主控支架` `电池架` `NanoPi支架` `大腿` `小腿` `推力轴承` 等全部零件
- **看一眼比我们瞎设计强 10 倍**

---

## 9. 板上怎么判断状态（没接串口时看灯）

| 灯 | 含义 |
|---|---|
| D0 | 复位完成（常亮 = 板子活着）|
| D1 | 电机使能中 |
| D2 | 正在避障 / 越障 |
| D3 | 故障 |
| D4/D5/D6 | 状态机：2=AUTO `010`、3=AVOID `011`、4=LIFT `100`、6=ESTOP `110` |

> ⚠️ **D5 亮在 state=2 和 6 时都成立**（它只是 bit1）。
> 判断 AUTO 要看"**D5 亮 + D6 灭 + D4 灭**"。
