yilo425/wheel-leg-robot-delivery/doc/进度与交接.md

# 进度与交接

> 更新：2026-10-17 13:10
> 仓库：**`D:\dsh-ws\robot_project`**（纯 ASCII，已从中文路径迁出）
> **上板验证：下载链路 + LED 冒烟 已通过**（GW5AT-138，ID `0x0011081B`；
> 　　4 灯流水正常、按住 S4 全灭；SRAM 烧写退出码 0）
> **★ ARM 联调已通**：庐山派 Lite-K230D 从 TF 卡启动 CanMV v1.8 →
> 　　USB CDC `COM9` → **FPGA→ARM（10Hz telemetry，BCC 对）与
> 　　ARM→FPGA（发障碍物帧 → `AUTO(2)`→`AVOID(3)`）双向实测通过**。
> 　　接线/协议/坑全记在 **`doc/arm_bringup.md`**（给接手 ARM 的同学）
> **★ 上板还验过的**：舵机（MG996R）50Hz PWM + `AUTO→LIFT→ESTOP` 全链路
> 　　（`lift_cmd` 0→0.5ms / 1→2.5ms 两个端点都到位）；`goal_reached` 的
> 　　"未接=已到终点"bug **已根治**（改成低有效，`E16` 不用再外接 GND）
> 全量回归：**21/21 PASS，835 项检查**（2026-10-19）
> 本轮新增：**电机护栏 `motor_guard`（软启动 + 堵转保护）**
> 本轮新增：**I2C 总线仲裁 `i2c_bus_arb` + `imu_driver` 集成进 `top.v`**（TOF 与 IMU 共总线）
> 工具链：**Gowin V1.9.12 ↔ ModelSim 已验证** —— 原语库原来是用 **V1.9.11**
> 　　　　建的（过期且不报错），已重建为 V1.9.12；新增 `tb_gowin_prim` 永久盯这条链
> 整机综合：**Gowin 综合 + 布局布线 + 比特流 通过**（`RESULT_OK`）
> 　　TNS = 0（Setup/Hold 都是 0.000），最差 setup slack = **2.09 ns**
> 　　产物 `build/robot/impl/pnr/robot.fs`（34,690,860 B）

---

## 一、这次做完的：TOF 集成进 `top.v` ✅

上一版交接文档的"明天第一件"就是这个，已经做完了。

| # | 做了什么 | 关键文件 |
|---|---|---|
| 1 | **`top.v` §1.5 例化 `tof_driver`**，`dist_mm/dist_valid/dist_err` 从常量桩换成模块输出 | `rtl/top.v` |
| 2 | 加了 **`TOF_ENABLE` 开关**：`1`（默认）= 真实驱动；`0` = 退回 `DIST_STUB_MM` 桩 | `rtl/top.v` |
| 3 | **I2C 引脚进引脚表**：`i2c_scl=M13` / `i2c_sda=M16`，重新生成 `.cst`（42 个引脚） | `constraints/pin_table.csv` → `top.cst` |
| 4 | 新增 **`tb_top_tof_i2c`（42 项）+ `vl53l0x_slave_model`**：走真实 I2C，**一个 force 都没有** | `sim/` |
| 5 | `tb_top_integration` 改跑 `TOF_ENABLE=0`（保留 force 的确定性场景），两条 tb 分工 | `sim/tb_top_integration.v` |
| 6 | 修掉接口文档里的错参数名：`SAMPLE_PERIOD` → **`SAMPLE_MS`** | `doc/interface_spec.md` |

**为什么保留 `TOF_ENABLE=0` 这条桩分支**：硬件没到 / 只想验证 FSM+电机+舵机时，
置 0 就能把链路一段段打通，不用等 TOF 模块。
⚠️ 但**整机试跑必须 `TOF_ENABLE=1`**，否则等于告诉车"前方永远 2m 通畅"，
它不会避障，而且**不会有任何报错**。

**两条 tb 的分工**（别把它们的职责搞混）：

| tb | 跑什么 | 目的 |
|---|---|---|
| `tb_top_integration`（66 项） | `TOF_ENABLE=0` + force 灌距离 | FSM 每个分支都要确定性走一遍 |
| `tb_top_tof_i2c`（42 项） | `TOF_ENABLE=1`，真实 I2C，**无 force** | 接线到底通没通：初始化/启动/轮询/读数/清中断 + 距离真的能改变车辆行为 |

---

## 二、明天从哪继续

### 第一件：**上板实测 TOF**

> ✅ **2026-10-17：板子已经验证可用** —— 下载链路 + LED 冒烟都过了：
> 下载器 `Gowin USB Cable(FT2CH)`、JTAG 读到 **GW5AT-138 / ID `0x0011081B`**、
> SRAM 烧写退出码 0、**4 个 LED 正常流水、按住 S4 全灭**。
> 也就是说"工具链 / 引脚 / 下载"这三件事已经排除，剩下的是**传感器本身**。
>
> ⚠️ 做冒烟时发现 `led_smoke/` 有三个问题（已修）：器件写成了 `GW5AST`、
> `.sdc` 里 `get_clocks` 缺花括号（V1.9.12 报 TA2000）、产物目录指向仓库外旧路径。
> 另外 **`--run` 的编号别照旧文档抄**：`--run 3` 是 **SRAM Read（回读）**，
> 烧写+校验要用 `--run 4`，只烧不校验是 `--run 2`
> （详见 `doc/踩坑与经验.md` §1.9，那里有实测的完整编号表）。

上板顺序（不要跳）：

1. ~~先烧 `tools/fpga_build/led_smoke/`，确认板子/工具链/下载都活~~ ✅ 已做
2. 再烧整机 `build/robot/impl/pnr/robot.fs`
3. 用示波器/逻辑分析仪看 `M13`/`M16`：**上电后应该能看到 I2C 起始条件**
   —— 先是一**长串**初始化写（官方 tuning 表，约百笔），
   之后每次采样是"一串 stop_variable 写 → 启动测距 → 轮询 0x13 → 读 0x1E/0x1F → 清中断"
4. 看 LED：`led[0]`=活着，`led[1]`=电机使能中，`led[3]`=故障

> ⚠️ 烧整机前先想清楚：当前 `robot.fs` 是 **TOF_ENABLE=1 + IMU_ENABLE=1**。
> 如果 VL53L0X / MPU6050 没插在 I2C 排针上，它们会一直 NACK →
> `dist_err` / `imu_err` → FSM 走"限速"fail-safe（不会乱冲，但别误判成坏了）。
> 只想先验证 FSM/电机/舵机时，把 `IMU_ENABLE` 置 0、`TOF_ENABLE` 置 0 重新综合。

### ⚠️ 上板第一个坑：TOF 的官方初始化（**已修正认知**）

原来以为"把官方那 80 条 tuning 表贴进 INIT 表就行，其余逻辑不用改"。
**2026-10-15 查证后发现这个前提是错的** —— 官方单次测距流程除了 tuning 表，
还必须有下面这些，缺一个都可能"读不到数"：

| # | 缺什么 | 为什么不是"贴表"能解决的 |
|---|---|---|
| 1 | **读 `0x91` 得到 `stop_variable`**，并在**每次启动测距前**写回一串寄存器 | 需要一个**读**步骤 + 一个变量 + 每次测距前的固定序列（现有 INIT 是纯写的） |
| 2 | `0x60` 与 `0x84` 是**读-改-写** | `0x60 = 读(0x60) \| 0x12`、`0x84 = 读(0x84) & ~0x10`，不是写常量 |
| 3 | 官方 tuning 表（约 80 条，含 `0xFF` 页切换） | 这部分确实是"贴表"，但要按**原顺序**、含页切换 |
| 4 | 参考校准 VHV + phase（带轮询 `0x13`） | 需要"写→轮询→清中断"的小序列 |
| 5 | 顺序 | 上面四步的**先后顺序**不能变 |

**来源**：`https://raw.githubusercontent.com/TheLostLambda/ESP32-VL53L0X/master/vl53l0x.c`
（该文件注明 "Based on https://github.com/pololu/vl53l0x-arduino"，
表即 ST API 的 `DefaultTuningSettings` / `VL53L0X_load_tuning_settings()`）。

**⚠️ 两条如实说明（别当成"已与官方逐字节核对"）**：

1. 本次只拿到**这一份**来源。想抓第二份独立副本做交叉核对时网络超时
   （`raw.githubusercontent.com` 连不上），所以有**单一来源风险**：
   上板若仍不出数，第一件事就是拿官方 API 的 `DefaultTuningSettings` 再逐字节比一遍。
2. 这次**有意跳过**两项，都在代码注释里写明后果：
   - **SPAD 管理**（读 `0x92` 取 spad_count/type、读改 `0xB0~0xB5` 再写回）
     → 沿用器件 NVM 默认，通常仍能出数，精度可能略降；
   - **动态 timing budget 计算**（读 `0x46/0x51/0x52/0x70/0x71/0x72` 算宏周期再写回 `0x71/0x72`）
     → 保留 tuning 表给的默认超时值，测量时间/精度不是算出来的最优值。

**现状**：✅ 已完成并验证（`tof_driver.v` 改为 7 种步骤、107 步的官方序列；
`tb_tof_driver` 43→**68 项**，含"写入总数=104"与 32 位校验和 `0x7F80F14A`
两条防篡改断言；`tb_top_tof_i2c` 也照常通过）。见 §三 的回归数字。

### 没有硬件时的下一件：`imu_driver` ✅ 已完成（独立模块）

`i2c_master` 已经验证过（TOF 和 MPU6050 的访问方式完全一样：复合读），
`imu_driver` 已照 `tof_driver` 的结构实现并验证：
- `rtl/driver/imu_driver.v` + `sim/mpu6050_slave_model.v` + `sim/tb_imu_driver.v`（**53 项全过**）
- roll/pitch 用加速度小角度近似、yaw 用陀螺 Z 积分（0.01°/LSB，无除法）
- ⚠️ **还没集成进 `top.v`**：必须先做 §四 的 I2C 总线仲裁（否则两个 master 挂一条总线）；
  集成时把 `imu_driver` 的 `roll/pitch/yaw` 接到 `telemetry_tx` 那三个 `16'sd0`（`top.v` §3.5）
- ⚠️ roll/pitch 是**小角度线性近似**（45° 误差 ~4.5°），要更准需分段/除法；
  陀螺零偏未标定，**yaw 会漂**（模块头注释已写明）

### 后向 TOF（收腿现在只靠"时间兜底"）

⚠️ **先想清楚地址冲突**：两块 VL53L0X 出厂都是 `0x29`，**不能直接并挂**。
两条路：
- 用 `XSHUT` 逐个上电、把其中一块改成别的地址（`tof_driver` 的 `DEV_ADDR` 就是为此留的）
- 或者第二条 I2C 总线（用 GPIO0 剩下的针脚软件模拟，`0x29` 就不用改）

---

## 三、已完成

### ★ 2026-10-18 上板实测通过（**核心链路全部打通**）

| 链路 | 结果 | 证据（数字，不是"看灯"） |
|---|---|---|
| **ARM ↔ FPGA 双向串口** | ✅ | 2 秒 598 次电平跳变；解析出 75 帧 telemetry |
| **超声波测距（HC-SR04）** | ✅ | telemetry 里 `dist` = 51/64/77mm，随手移动变化 |
| **摄像头（GC2093 / CSI2）** | ✅ | 30fps；红色识别 **142/142 帧** |
| **视觉 → 状态机决策** | ✅ | 第一帧视觉数据到达后 **<500ms**，`state` 2(AUTO) → **3(AVOID)** |
| **CONFIG 帧远程改参数** | ✅ | 停车距离改 50mm 后，`dist=51mm` 稳定停在 AUTO；不改则必然 AVOID |
| **AVOID 超时保护** | ✅ | 挡住不退时**正好 5 秒**（`AVOID_TIMEOUT_MS=5000`）→ ESTOP |
| **★ 越障失败降级** | ✅ | 抬腿超时 → **收腿绕行**（不是停车）；锁定期 3 秒内禁止再抬腿；**连续 3 次**才真 ESTOP |
| **舵机 / 升降腿** | ✅ | 之前已验证（LIFT 2.5ms、限位、超时回位） |
| **LED / 按键** | ✅ | 三个键（S0/S1/S4）实测都有效 |

**一句话**：`摄像头 → 识别 → UART → FPGA → 避障决策` 和
`超声波 → 距离 → 同一套决策` 两条感知通路都通了，`CONFIG` 和 `telemetry` 双向也通了。

> ⚠️ **电机还没接**（TB6612 是焊接式端子，要焊线），所以"决策 → 电机"这一段只验到 PWM 输出为止。

### ★ 2026-10-18 夜：不做硬件也能收尾的活（已全部完成）

| 项 | 内容 |
|---|---|
| **CONFIG x10/0x11 真正生效** | 抬腿高度接进 servo_lift（编译期常数换算，无除法器）；抬腿超时接进 main_fsm（	_up 改数毫秒，省掉 16x16 乘法器）。除 x03 外**协议表里所有参数都已生效** |
| **m_dir2 第二方向脚** | TB6612 要两个互补方向脚才能正反转；原来 AIN2 接地 -> **倒不了车**。新增 4 根 = ~m_dir（F19/F18/E19/D20）|
| **速度环加积分项** | ★ **抓到真缺陷**：纯 P 控制只能跑到目标的 31%（闭环仿真实测），加 PI 后 100%，且对增益变化鲁棒 |
| **MOTOR_TEST_MODE 参数** | 把上板的电机自测做进产品固件，不用再单独烧诊断工程 |
| **check_always_reset.py** | 把"每个 always 都要有复位"变成机器检查（编译器不报，上板才会咬人）|
| **	b_telemetry_payload** | 验 13 字节载荷的字段内容（大端/有符号/饱和）|
| **两个 .fs 预编译** | 
obot.fs（正式）+ D:\dsh-ws\robot_motortest.fs（自测），明天到工位不用等综合 |

### 此前完成

| 项 | 说明 |
|---|---|
| **电机护栏 `motor_guard`** | 软启动（上升每 1ms 最多 +8，**下降当拍生效**）+ 堵转保护（duty 大且编码器不动 500ms → 该轮断电 + 1s 冷却 + 断续试探）；`tb_motor_guard` 41 项 |
| **I2C 总线仲裁 + IMU 集成** | `i2c_bus_arb`（轮询授权）+ `imu_driver` 进 `top.v`（`IMU_ENABLE` 默认 1，姿态进 telemetry）；`tb_top_i2c_share` 28 项（含交叉污染检查） |
| **TOF 官方初始化序列** | `tof_driver` 3 条寄存器 → **107 步官方序列**（tuning 表 + stop_variable 前导 + 读改写 + 参考校准），`tb_tof_driver` 43→68 项 |
| **`imu_driver`（MPU6050）** | 模块 + 从机模型 + **53 项**单模块自检（roll/pitch/yaw，0.01°/LSB，无除法） |
| **TOF 集成** | `top.v` §1.5，真实 I2C 通路，有 42 项无 force 的集成自检 |
| **2-bit 升降腿** | `lift_cmd[1:0]`、8 个越障子阶段、两种模式 |
| **两种越障模式** | 模式 0（小石头）四腿一起抬；模式 1（台阶）两腿分段 |
| **`servo_lift.v`** | 舵机 PWM + 限位消抖 + 极性转换，**不需要外挂舵机驱动板** |
| **修了 3 个真 bug** | 限位极性反了 / `lift_fault` 上拉误报 / `LP_CROSS` 提前收腿 |
| **`STEER_COEF` 统一** | `top.v` 之前覆盖了 `motion_decision.v` 的修正值，实际没生效 |
| **`VREF_FULL` 60→69** | 按实购 MG310（1:20，13 线）重标定 |
| **`top.sdc`** | 整机时序约束（之前完全没有） |
| **`led_test.sdc` 重写** | 原文件中文烂成 `????`、用 `//` 当注释符 |
| **`i2c_master` + `tof_driver`** | 43 项自检一次跑过 |
| **整机综合** | 许可到位、时序满足，产出 `robot.fs` |

**测试**：`tb_config_rx`(126) / `tb_main_fsm`(100) / `tb_tof_driver`(68) /
`tb_top_integration`(67) / `tb_uart_frame`(58) / `tb_imu_driver`(53) /
`tb_sr04_driver`(53) / `tb_top_tof_i2c`(42) / `tb_motor_guard`(41) /
`tb_motion_decision`(32) / `tb_top_i2c_share`(28) / `tb_telemetry_payload`(27) /
`tb_servo_lift`(25) / `tb_pwm_motor`(21) / `tb_encoder_decode`(17) /
`tb_gowin_prim`(17) / `tb_uart`(17) / `tb_reset_sync`(11) / `tb_motion_loop`(10) /
`tb_clk_gen`(9) / `tb_telemetry_check`(3)
—— 共 **21 条 tb、835 项**，全 PASS。

> 2026-10-18 夜新增的三条，每条都补的是**真缺口**：
>
> | tb | 补什么缺口 |
> |---|---|
> | `tb_telemetry_check`(3) | 原来所有 tb 都只声明 `wire uart_tx` **却从不解码**，telemetry 发送路径一直没有断言覆盖 |
> | `tb_telemetry_payload`(27) | 只验了"有没有发"，没验**载荷 13 字节的字段对不对**（大端/有符号/饱和）—— 而 ARM 依赖的正是这些字段 |
> | `tb_motion_loop`(10) | 以前全是**开环**（给 spd_fb 看 duty），看不出稳态残差。闭环一跑就发现纯 P 只能到目标的 **31%**，加积分项后 **100%** |

> ⚠️ 读结果文件要**等几秒**：`run_sim.do` 里每条 tb 是一次嵌套 vsim，文件是异步写完的
> （等 10~20 秒最稳；否则会看到"最后几条 tb 结果文件是空的"这种假故障）。

---

## 四、还没做

| # | 项 | 依赖 |
|---|---|---|
| 1 | **上板实测 TOF**（官方初始化序列已离线补齐并验证，只差真机实测标定） | 硬件到货 ← **第一件** |
| 2 | ~~`imu_driver`~~ ✅ 模块 + **集成进 `top.v` 都已做完**（`IMU_ENABLE` 默认 1，姿态进 telemetry） | 见 §二 / §四 的"设计冲突" |
| 3 | `manual_sel` 输入源（现在是 `wire manual_sel = 1'b0` 硬写死，手动模式进不去） | 需要和 B 约定 CONFIG 帧 |
| 4 | ~~堵转保护 / 软启动~~ ✅ **已实现**（`motor_guard`，见 §三；`tb_motor_guard` 41 项） | 参数（`STALL_DUTY`/`STALL_MS`）要**实车调**：`STALL_DUTY` 必须高于正常低速巡航的 duty，否则爬行会被误判 |
| 5 | 后向 TOF 接口（现在收腿只靠"时间兜底"） | 要先解决 I2C 地址冲突（见 §二） |
| 6 | **真 PLL 生成**（`clk_gen.v` 的 `g_pll` 分支现在是空的） | 器件选 **GW5AT-138** + Gowin **V1.9.12**；⚠️ 上 100MHz 前必须先给 `main_fsm` 输出打一拍 —— 现在 `dist_mm → m_en` 那条路径 slack 只有 2.09ns，周期换成 10ns 必然为负 |
| 7 | ~~I2C 总线共享仲裁~~ ✅ **已实现**（`i2c_bus_arb`，见下面的"设计冲突"） | 已由 `tb_top_i2c_share` 28 项验证 |

---

### ★ 已发现的设计冲突：一条 I2C 总线只能有一个 master

**现状**：✅ **已解决**（2026-10-15）。

原来 `tof_driver` **内部**例化了自己的 `i2c_master`，`imu_driver` 照抄同样的结构
→ 两者**各自驱动 `i2c_scl`/`i2c_sda`**，两个 master 同时说话，事务互相打断、
读回的数据是坏的，而且**不会报错**。

> `i2c_master.v` 头注释写着"TOF 和 MPU6050 共用一路 I2C，所以本模块只做通用搬运工"——
> 那句注释的意图是对的，但当时的接法没落实它。

**实际实现（和最初设想的"引脚级 mux"不一样，别照旧稿看）**：

```
     tof_driver ──┐ bus_req/bus_busy                 ┌── 各自的 i2c_master（保留）
                  ├──► i2c_bus_arb ──► bus_grant     │
     imu_driver ──┘                                  └──► scl/sda 直接**线与**到
                                                          i2c_scl / i2c_sda（板上）
```

1. **不需要 mux**：I2C 是**开漏**总线，两个驱动的 scl/sda 直接并到同一根线
   就是"线与"（任一拉低即为低），电气上本来就成立。
   ⚠️ 而"片内三态 mux"是**不能综合**的（FPGA 内部没有三态资源）——这条路走不通。
2. 真正缺的只有"同一时刻只允许一个 master 说话"：新增 `i2c_bus_arb`
   （轮询授权），每个驱动加 3 个端口 `bus_grant/bus_req/bus_busy`，
   把发车条件改成 `t_pending && !i2c_busy && bus_grant`。
3. ⚠️ **仲裁器释放 grant 的条件必须是"既没请求、也不忙"**
   （`!req && !busy`），**不能只看 `!busy`**：驱动"决定发车"的那一拍
   `t_pending` 还没清、`t_busy` 还没起（都是非阻塞赋值），只看 busy 会当场误释放
   → 另一个驱动立刻被授权 → **两个 master 同时上总线**。
   这个 bug 真发生了，是 `tb_top_i2c_share` 抓出来的（症状：MPU 寄存器里出现
   VL53L0X tuning 表的 0x44，两边初始化都跑不完）。
4. 板上收益：MPU6050 `0x68`、VL53L0X `0x29` 不冲突，可以并挂；
   **两块 VL53L0X 仍会冲突**（后向 TOF），得靠 `XSHUT` 改地址。

**验证**：`tb_top_i2c_share`（28 项）—— 两个真实从机模型挂同一条总线，
除了"两边都出数"，还有**交叉污染检查**：MPU 只写的 `0x19` 在 VL53L0X 模型里
必须仍是初值、VL53L0X 只写的 `0x4E` 在 MPU 模型里必须仍是初值。
从机模型也一并修成"**只有地址命中才 ACK / 才处理后续字节**"
（原来对任何地址都应答，单器件时看不出，挂一条总线上就会互相应答）。

---

## 五、等别人的

| 项 | 等谁 | 说明 |
|---|---|---|
| **视觉类别码 `0x05` = 台阶** | **B（ARM）** | 代码已就绪，B 加了跨台阶就能用 |
| **Gowin license** | — | ✅ 已解决（`C:\Gowin\gowin.lic`），整机综合已通过 |
| **硬件到货** | 用户/C | 到了要实测标定 `VREF_FULL`；TOF 的官方初始化序列已在离线实现（见 §二），上板只需验证 |

---

## 六、环境备忘（踩过的坑）

| 坑 | 说明 |
|---|---|
| **ModelSim 不能用中文路径** | 工作库必须在纯 ASCII 路径。已迁到 `D:\dsh-ws\robot_project\.simlib\work` |
| **★ ModelSim 批处理输出被"管道"捕获 + 中文用户名 → `vsimk` 退出码 7** | 2026-10-15 踩到：把 `vsim -c -do run_sim.do` 的输出用 PowerShell 管道接走（`\| Select-String ...`）时，ModelSim 会把 stdout 溢出内容写到 `%TEMP%` 的 `VSOUTxxxx` 文件；本机 `%TEMP% = C:\Users\忆洛\AppData\Local\Temp`，中文用户名被 ANSI 化成 `????` → `Error while reopening stdout stream! ... filename is invalid on this platform` → **`** Fatal: vsimk is exiting with code 7`**，跑一半就断（症状：最后几条 tb 的结果文件是空的或没生成，看起来像 tb 崩了，其实和 tb 无关）。**对策**：① 把 `TEMP`/`TMP` 指到纯 ASCII 目录再跑（`set TEMP=D:\dsh-ws\_tmp`）；② 输出用**文件重定向**（`cmd /c "... > sim_full.log 2>&1"`）而不是管道。输出量小时不会触发，所以很容易误判成"某条 tb 有问题" |
| **`vsim` 报 `Error loading design` 时** | **只有 `vopt` 会报真实错误** |
| **`vsim` 要加 `-voptargs="+acc"`** | 否则内存引用（`dut.xxx`）被优化掉 |
| **`sim/*.do` 是生成物** | 别在两个仓库间 robocopy 同步，会覆盖成旧版。**加了新文件要重跑 `emit_dofiles.ps1`**（见 §七） |
| **`.ps1` 必须有 UTF-8 BOM** | 丢了 PowerShell 按 GBK 读中文注释 → 解析失败。**用 AI/编辑器改 `.ps1` 后特别容易丢 BOM**（很多工具写回的是不带 BOM 的 UTF-8）→ 改完必须确认头三个字节是 `EF BB BF` |
| **PowerShell 变量大小写不敏感** | `$r` 会覆盖 `$R` —— 本项目踩过两次 |
| **`parameter` 不能位选** | Verilog-2001 限制，先转定宽 `localparam [31:0]` |
| **`.sdc`/`.tcl` 必须纯 ASCII** | Gowin 按 GBK 读 |
| **ModelSim task 端口 `[255:0]` 只装 32 字节** | 检查名太长会丢开头的字（本工程已加宽到 `[1023:0]`） |
| **测试里"等毫秒"要用 `wait_ms` task** | 1ms = 50000 拍，`repeat(60)` 差三个数量级 |
| **单拍脉冲只能"数"，不能"采"** | `dist_valid`/`dist_err` 是单拍脉冲；而且 `tof_driver` 用非阻塞赋值更新它们，tb 在同一拍读到的是**上一拍**的值 —— 所以要让监视块计数，断言盯计数，别直接采那根线 |
| **本会话的沙箱写权限** | 实测 shell 只能写工作区**根**目录，`rtl/`/`sim/`/`build/` 等子目录写入被拒（`POLICY_DENIED`）。跑 ModelSim / `gen_cst.py` / Gowin 综合要单独申请提权（或把会话切到完全权限）。**文件编辑走原生工具不受影响** —— 但正因为这样，`.ps1` 的 BOM 就是这么丢的 |
| **★ Gowin 原语库的版本必须与综合器一致** | 2026-10-15 发现：ModelSim 里的 `gw5a` 库是 **V1.9.11** 的 `prim_sim.v` 建的，而综合用 **V1.9.12** —— 仿真模型和综合器不是一个版本。判法：`vdir -lib D:/modeltech64_2020.4/gw5a \| findstr "MODULE DQS"`，**有输出 = 旧版**（V1.9.12 已把 `DQS` 移出 `prim_sim.v`），无输出 = V1.9.12（132 个模块）。详见 `doc/toolchain_gowin_modelsim.md` 的「2026-10-15 更新」 |
| **★ 多版本 Gowin 共存时别靠"第一个找到的"** | 本机同时装着 V1.9.11 和 V1.9.12，目录枚举顺序不保证。已让 `setup_gowin_modelsim.ps1` **按版本号取最新**（否则又会拿旧版建库） |
| **★ `toolchain.local.ps1` 必须存在** | 它在 `.gitignore` 里（每台机器一份）。**不建它**：`emit_dofiles.ps1` 走内置默认值，会把 work 库写到仓库外的 `D:\gowin_lib\work`，而工程一直用 `.simlib\work` —— 库一分家，换机器就找不到，且不报错。已按本机建好 |

---

## 七、跑回归的标准命令

```powershell
Set-Location D:\dsh-ws\robot_project\sim
$env:LM_LICENSE_FILE   = 'D:\modeltech64_2020.4\win64\LICENSE.TXT'
$env:MGLS_LICENSE_FILE = 'D:\modeltech64_2020.4\win64\LICENSE.TXT'

# 编译（含仿真专用模型 vl53l0x_slave_model.v）
& 'D:\modeltech64_2020.4\win64\vsim.exe' -c -do compile_all.do

# 全量跑（13 个 tb，含工具链冒烟 tb_gowin_prim）
& 'D:\modeltech64_2020.4\win64\vsim.exe' -c -do run_sim.do

# 只跑工具链冒烟（17 项，最快确认"原语库挂上了、版本对"）
& 'D:\modeltech64_2020.4\win64\vsim.exe' -c -do "set TB_SEL tb_gowin_prim; do run_sim.do"

# 判原语库版本（无输出 = V1.9.12，正确；有输出 = V1.9.11，过期）
& 'D:\modeltech64_2020.4\win64\vdir.exe' -lib 'D:/modeltech64_2020.4/gw5a' | findstr "MODULE DQS"

# 只跑一条（★ 不要用 $argv 传 tb 名，vsim 会把自己的开关漏进 argv）
& 'D:\modeltech64_2020.4\win64\vsim.exe' -c -do "set TB_SEL tb_top_tof_i2c; do run_sim.do"

# 结果在各 <tb名>_result.txt 里（等 3~4 秒让嵌套 vsim 写完再读）
```

**重新生成 `.do`**（加了新文件之后 —— **必须做，否则新 tb 根本不会被编译/运行**）：

```powershell
# 路径自动从 toolchain.local.ps1 读，**不需要传参**
Set-Location D:\dsh-ws\robot_project\sim\toolchain
powershell -ExecutionPolicy Bypass -File emit_dofiles.ps1

# 只有在"没有 toolchain.local.ps1"的机器上才需要显式传参：
#   -LibName gw5a -LibPath 'D:\modeltech64_2020.4\gw5a' `
#   -WorkDir 'D:\dsh-ws\robot_project\.simlib\work' `
#   -OutDir  'D:\dsh-ws\robot_project\sim' `
#   -ModelsimIni 'D:\modeltech64_2020.4\modelsim.ini'
```

> ⚠️ 仿真专用模型（如 `vl53l0x_slave_model.v`）加在脚本的 **`-SimFiles`**，
> **不要**加进 `-Tbs` —— 那个列表会进 `run_sim.do` 的 `TB_LIST`，
> 被当成 testbench 去加载（模型里没有 `initial/$stop`，会一直挂着，看起来像"仿真卡死"）。

**整机综合**（Gowin，需要许可）：

```powershell
Set-Location D:\dsh-ws\robot_project\build
& 'D:\Gowin\Gowin_V1.9.12_x64\Gowin_V1.9.12_x64\IDE\bin\gw_sh.exe' `
  'D:\dsh-ws\robot_project\tools\fpga_build\build_all.tcl'
# 看到 RESULT_OK；然后核对 build/robot/impl/pnr/robot.pin.html 的引脚落点
```

**本次综合实测结果**（`robot.rpt.txt` / 时序报告）：

- `i2c_scl → M13/3`、`i2c_sda → M16/3`，都是 `io` + `LVCMOS33` + `NONE` 上拉 ✓
- TNS（Setup / Hold）= 0.000 / 0.000，无时序违例
- 最差 setup 路径：`u_main_fsm/dist_r_8_s0/Q → m_en_obuf/O`，slack **2.09 ns**
  —— ★ 这条路径现在就是"TOF 距离 → 停车"那条，**换 100MHz PLL 前要重新看它**
- 资源：LUT 3635 + ALU 391（不算多），寄存器 2317/139095 = 2%
- ⚠️ 一条正常警告：`clk_gen` 被优化掉（`PLL_BYPASS=1` 时它是纯旁路，属预期）
