yilo425/wheel-leg-robot-delivery/doc/重量估算.md

# 重量估算（2026-10-19）

> 目的：① 确认舵机和腿够不够力 ② 找减重的地方 ③ 定"上限不能超过多少"
> ⚠️ 标「估」的是查资料/按密度算的，**标「实测」的需要你用厨房秤称一下**。

---

## 1. 现有部分（已经有的东西）

| 项 | 数量 | 单重 | 小计 | 来源 |
|---|---|---|---|---|
| **FPGA 板 ACG720** | 1 | ~200 g | **200 g** | 估（**建议实测**）|
| **K230 庐山派 Lite** | 1 | ~35 g | 35 g | 估 |
| **摄像头 GC2093 + 排线** | 1 | ~10 g | 10 g | 估 |
| **MG310 电机**（带减速箱+编码器）| 4 | ~70 g | **280 g** | 估（**建议实测一个**）|
| **轮子 φ50~65** | 4 | ~28 g | 112 g | 估 |
| **MG996R 舵机** | 4 | **55 g** | **220 g** | 规格书 ✓ |
| HC-SR04 超声波 | 1 | ~9 g | 9 g | 估 |
| 打印腿（含钢销）| 4 | ~8 g | 32 g | 估 |
| **现有小计** | | | **≈ 898 g** | |

---

## 2. 新增部分（这次要买/要做的）

| 项 | 数量 | 单重 | 小计 | 备注 |
|---|---|---|---|---|
| **3S 电池 3000mAh（18650 组）** | 1 | ~170 g | **170 g** | 3×47g 电芯 + 保护板 |
| **充电宝 10000mAh** | 1 | **~200 g** | **200 g** | ★ 最重的单体 |
| TB6612 四路板 | 1 | 18 g | 18 g | |
| UBEC 6V/5A | 1 | 18 g | 18 g | |
| DC-DC 12V→9V（LM2596）| 1 | 10 g | 10 g | |
| 舵机分配板 + 1000µF | 1 | 20 g | 20 g | |
| 限位模块 | 2 | 3 g | 6 g | |
| Y 线 + 杜邦线 | — | — | 15 g | |
| 动力线 + 信号线 | — | — | 25 g | |
| 端子排 + 保险丝 + 开关 + XT60 | — | — | 25 g | |
| **底板 亚克力 3mm**（160×130）| 1 | 74 g | **74 g** | 密度 1.19 |
| **中板 + 顶板 亚克力 2mm** | 2 | 50 g | **100 g** | |
| 打印支架（舵机×4、FPGA、相机、电池）| — | — | 100 g | 估 |
| 铜柱 M3（**铝/尼龙**）| 12 | ~2 g | 25 g | ⚠️ 钢的 5g/根 |
| 螺丝 | — | — | 20 g | |
| **新增小计** | | | **≈ 826 g** | |

---

## 3. 总计

| 方案 | 重量 |
|---|---|
| **现状方案（带充电宝）** | 898 + 826 = **≈ 1724 g（1.72 kg）** |
| **★ 去掉充电宝，K230 改用 12V→5V 降压** | **≈ 1524 g（1.52 kg）** |
| 再去掉顶板/中板（改成单层）| ≈ 1424 g（1.42 kg）|

---

## 4. ★ 减重优先级（按"省得多/麻烦少"排序）

| # | 措施 | 省 | 代价 |
|---|---|---|---|
| **1** | **去掉充电宝，K230 用 12V→5V/3A 降压（¥10）** | **−190 g** | 多一个模块；要和电机共用电池（注意噪声）|
| **2** | 铜柱改**铝或尼龙**（别用钢）| −35 g | ¥3 |
| 3 | 电池换 **3S LiPo 1500mAh**（130g）| −40 g | 续航从 1h 降到 30min |
| 4 | 顶板/中板改 **2mm**（已经是了）/ 减一块板 | −50 g | 结构变弱 |
| 5 | 轮子改小（φ50）| −30 g | 越障变差 ✗ 不推荐 |
| 6 | 舵机改塑料齿便宜型号 | −60 g | 扭矩和寿命下降 ✗ 不推荐 |

> **只做第 1 条就能从 1.72 → 1.53 kg** ✓ 性价比最高。

---

## 5. ★★ 这个重量对舵机意味着什么

腿长 L=70mm、45° 工作角、MG996R：

| 整车重量 | 每腿分担 | 力矩（含 2× 动载）| 余量 vs 降额 6.5 | 结论 |
|---|---|---|---|---|
| 1.4 kg | 0.35 kg | 3.5 kg·cm | **1.9×** | ✅ 轻松 |
| **1.5 kg** | 0.375 kg | 3.7 kg·cm | **1.8×** | ✅ 好 |
| **1.72 kg** | 0.43 kg | 4.3 kg·cm | **1.5×** | ⚠️ 偏紧 |
| 1.9 kg | 0.475 kg | 4.7 kg·cm | 1.4× | ⚠️ |
| **2.0 kg** | 0.5 kg | 4.95 kg·cm | **1.3×** | ❌ 吃力 |

### 结论

> **上限：整车不要超过 1.8 kg。**
> 超过 2.0 kg 就要把腿缩短到 60mm，或者换 20 kg·cm 舵机（DS3218）。

---

## 6. 重心（和重量一样重要）

**估算各件的重心高度**（底板在 z=0，三层板间距 25mm）：

| 层 | z 高度 | 放什么 | 重量 |
|---|---|---|---|
| 底层 | 0~30 mm | 电池 170 + 舵机 220 + 驱动板 18 | **408 g** |
| 中层 | 30~60 mm | FPGA 200 + UBEC/DC-DC 28 + 分配板 20 | **248 g** |
| 顶层 | 60~90 mm | K230 45 + 相机 10 + （充电宝 200 ✗）| **55 g** |

**重心高度 ≈ (408×15 + 248×45 + 55×75) / 711 = 29 mm** ✅ 很低 ✓

**但如果充电宝（200g）放顶层**：

```
(408×15 + 248×45 + 255×75) / 911 = 35 mm  ⚠️ 抬高 6mm
```

→ **再次确认：充电宝放顶层是错的**（既增重又抬重心）✗

---

## 7. 打印成本参考

| 项 | 体积估 | 材料 | 价 |
|---|---|---|---|
| 4 条腿（含钢销）| ~24 cm³ | PETG | ¥8 |
| 舵机支架 ×4 | ~30 cm³ | | ¥10 |
| FPGA / 相机 / 电池支架 | ~50 cm³ | | ¥18 |
| **合计打印件** | ~104 cm³ | | **¥36~50** |
| 亚克力 3 块（激光切割）| | | **¥20~40** |
| 铜柱 + 螺丝 | | | **¥30** |
| **结构总成本** | | | **≈ ¥90~120** |

> 和开源项目（1800⭐）报的"¥100"完全吻合 ✓
> **比整体 3D 打印车身（¥300~800）省 4~8 倍。**

---

## 8. 需要你实测的三个数

用厨房秤称一下（5 分钟），这三个占了大头：

| # | 称什么 | 我估的 | 影响 |
|---|---|---|---|
| 1 | **FPGA 板（含排线）** | 200 g | 每差 50g，总重差 3% |
| 2 | **一个 MG310（带电线和插头）** | 70 g | ×4，差 20g → 总重差 5% |
| 3 | **电池（含线）** | 170 g | |

称完告诉我，我把表更新成实测值。

---

## 9. 一句话总结

| 问题 | 答案 |
|---|---|
| 现有多少 | **≈ 0.9 kg** |
| 新增多少 | **≈ 0.83 kg** |
| **总计** | **≈ 1.72 kg**（带充电宝）|
| **减重后** | **≈ 1.52 kg**（去掉充电宝，改降压）|
| **上限** | **1.8 kg**（腿的扭矩余量 1.5×）|
| 最划算的减重 | **去掉充电宝 −190g** |
| 打印+结构成本 | **≈ ¥100** |
