yilo425/wheel-leg-robot-delivery/handoff/B_arm.md

# B —— ARM 视觉与通信

> **你的定位**：FPGA 负责全部**实时控制**，你负责**视觉**，通过 UART 把识别结果交给 FPGA。
> **你的优势**：协议已冻结，**你可以完全独立开发，不用等任何人**。

---

## 0. 三个数字先记住

| 数字 | 含义 |
|---|---|
| **9** | 帧固定开销（2头+1版本+1类型+2长度+1校验+2尾）—— **不是 10，我们算错过一次** |
| **10 Hz** | 你发 `VISION_RESULT` 的频率 |
| **0..65535** | 坐标必须归一化到这个范围，**不发像素坐标** |

---

## 1. ⚠️ 今天最紧急的事：**下单买板**

**这是整条关键路径上最慢的一环，AI 帮不上忙。**

| 买什么 | 建议 | 参考价 |
|---|---|---|
| **主选** | 树莓派 Zero 2W（或 4B/5，预算够就上） | ¥150~250 |
| **次选** | 庐山派 K230 CanMV（含摄像头） | ¥228 |
| **建议** | **两个都买**（约 ¥400），谁先跑通用谁 | — |
| **配件** | 摄像头（CSI/MIPI）、TF 卡、USB-TTL 模块、杜邦线 | — |

> 详细对比见 [`doc/interface_delivery.md`](../doc/interface_delivery.md) 的 `arm_selection` 部分，
> 或问 A 要选型结论。

**⚠️ 买摄像头注意**：树莓派 **Zero 系列是窄口 mini-CSI**，和 4B/5 的排线**不通用**。

---

## 2. 任务清单

### 里程碑 0：不需要任何硬件（**今天就能开始**）

| # | 任务 | 验收标准 | 状态 |
|---|---|---|---|
| **B0.1** | **下单买板 + 摄像头 + TF卡 + USB-TTL** | 下单号发群里 | ⬜ |
| **B0.2** | 跑通协议库自测：`cd arm && python uart_proto.py` | `RESULT: PASS (31 项)` | ⬜ |
| **B0.3** | 看帧长什么样：`python fpga_link.py --dry-run` | 能对照着看懂每个字节 | ⬜ |
| **B0.4** | **PC 上完成收发闭环**（虚拟串口对 com0com） | A 端发 `VISION_RESULT`，B 端解出同样的目标 | ⬜ |
| **B0.5** | 跑 `python detect_from_image.py --demo-frame`（**不需要图片和 OpenCV**） | 看懂"目标 → 帧"的映射 | ⬜ |
| **B0.6** | `--make-test-image` 造图，再 `--image test.jpg --debug out.jpg` | 能框出色块、输出合理坐标 | ⬜ |

**里程碑 0 全部做完，ARM 侧协议这一层就等于**"上板即可用"**。**

> **`detect_from_image.py` 已经给你写好了**，不用从零开始。
> 里面有：HSV 颜色阈值（**现场要重调**）、轮廓找中心、归一化、`--debug` 输出标注图。
> 板子到货后，把 `cv2.imread(图片)` 换成摄像头取帧即可，**其余代码不用动**。

### 里程碑 1：板子到货后（3~5 天）

| # | 任务 | 验收标准 | 阻塞于 |
|---|---|---|---|
| **B1.1** | 板子装系统、能 SSH/串口登录 | 能跑 `python3 -c "print(1)"` | 硬件 |
| **B1.2** | 点亮摄像头，能存一张图 | 存出 `test.jpg` 且能打开 | B1.1 |
| **B1.3** | 跑通一个**颜色识别** demo | 能框出红色/绿色色块 | B1.2 |
| **B1.4** | 把识别结果接进 `uart_proto.make_vision_result()` | 10Hz 稳定发送，无 BCC 错 | B1.3 |
| **B1.5** | **接 FPGA 实测** | FPGA 侧 `verify/` 报告显示能收到 | A 完成 `uart_frame` 集成 |

### 里程碑 2：联调与实用化

| # | 任务 | 验收标准 |
|---|---|---|
| **B2.1** | 颜色/形状识别做到**比赛可用** | 在比赛场地的光照下能稳定识别 |
| **B2.2** | 加**低矮障碍识别**（类别 `0x04`） | FPGA 能触发升降腿 |
| **B2.3** | 加**目标点识别**（类别 `0x03`） | 终点标志能识别 |
| **B2.4** | 联调 10 分钟，统计误帧率 | **< 1%** |
| **B2.5** | 解析 `TELEMETRY` 并显示 | 能看到 FPGA 的状态/速度/距离 |

> **⚠️ 红线提醒**：如果 **2026-10-20** 前视觉做不出来，按预案**降级到纯颜色/形状识别**
> （那只需要 OpenCV 的 HSV 阈值 + 轮廓，工作量小得多）。

---

## 3. 可直接粘贴给 DSH 的提示词

### 提示词 1：开场（每次新会话先发这个）

```
【项目背景】
轮足复合式 FPGA 实时感知与自主控制机器人，参加 2026 全国大学生嵌入式芯片与系统设计竞赛
（高云 FPGA 赛道）。队伍三人：A 做 FPGA 实时控制，B 做 ARM 视觉与通信（我是 B），
C 做机械与集成。

分工原则：FPGA 负责全部实时控制（传感器采集、电机闭环、避障状态机、升降腿），
ARM 只负责视觉，通过 UART 把识别结果交给 FPGA。

【请先读这几个文件，再动手】
1. doc/interface_delivery.md   —— 接口全貌；重点读 §0（怎么用）、§2（UART 协议）、§3（对齐约定）
2. doc/uart_frame_protocol.md  —— 协议完整定义
3. arm/README.md               —— 已经给我准备好的协议代码和用法
4. handoff/B_arm.md            —— 我的任务清单
5. doc/team_sync_guide.md      —— 团队协作规则（Git 工作流、接口冻结）

【当前状态】
- FPGA 侧 uart_frame 模块已写完并通过 58 项仿真检查，但还没接进 top.v（A 在做）
- 协议已经冻结，我可以独立开发，不需要等 FPGA
- arm/uart_proto.py 已自测 31/31 PASS，可以直接用
- 我的 ARM 板还没买 ← 这是当前最紧急的事

【硬约束 —— 这些不要违反】
- 帧格式已冻结：AA 55 | VER | TYPE | LEN(2字节大端) | DATA | BCC | 55 AA
- 帧固定开销 9 字节（不是 10）
- BCC = VER ^ TYPE ^ LEN_H ^ LEN_L ^ DATA，**不含帧头帧尾**
- 类别编码只能用 0x00~0x04（见协议文档）
- 坐标必须归一化到 0..65535，**不要发像素坐标**
- 发送频率 10Hz
- 改动协议必须先在群里确认，并同步改文档 + 升版本号到 0x02

【现在请你】
读完上述文件后，用不超过 20 行总结：
  ① 我在整条链路里负责哪一段
  ② 我的第一个可执行任务是什么
  ③ 我有什么是被别人阻塞的
然后等我确认，不要直接改代码。
```

### 提示词 2：里程碑 0（不需要硬件，今天做）

```
我的 ARM 板还没到货，但我想把协议这一层先在 PC 上验证完。

请帮我在 arm/ 目录下完成以下工作：

1) 先跑一遍现有自测，确认基线是对的：
     python uart_proto.py
     python fpga_link.py --dry-run

2) 写一个 arm/test_loopback.py：用**纯内存**模拟一次完整往返（不需要串口）
   - 用 uart_proto.make_vision_result() 生成若干帧
   - 逐字节（不是整帧）喂给一个 FrameParser 实例
   - 断言解出来的内容和发出去的一致
   - 覆盖：空目标 / 1 个目标 / 8 个目标（上限）/ 两个目标
   - 再插几帧 BCC 错的、未知类型的、带前导噪声的，断言"坏帧被丢但后续好帧照样收到"
   - 末尾打印 "RESULT: PASS/FAIL (N 项)"

3) 写一个 arm/detect_from_image.py：读一张本地图片，用 OpenCV 做**颜色识别**，
   把结果转成 uart_proto 的目标格式并打印帧的十六进制。
   - 如果没装 OpenCV，给出明确的安装提示，不要报一堆 traceback
   - 颜色阈值要写成常量放在文件顶部，方便我在比赛场地现场调

要求：
- 不要修改 arm/uart_proto.py 的对外接口（FPGA 侧已经按这个协议实现并验证过了）
- 中文注释，风格和现有文件保持一致
- 写完先自己跑一遍，把实际输出贴给我

验收：python test_loopback.py 输出 RESULT: PASS
```

### 提示词 3：板子到货后接摄像头

```
ARM 板到了，型号是 <填你的型号>，摄像头是 <填型号>。

请帮我写 arm/camera_vision.py，把真实摄像头接进现有的联调框架：

1) 实现一个 CameraVision 类，接口和 fpga_link.py 里的 FakeVision **完全一致**：
       class CameraVision:
           def __init__(self, width, height, ...): ...
           def targets(self, t) -> [(类别, cx归一化, cy归一化, 置信度), ...]

   这样 fpga_link.py 的主循环**一行都不用改**就能换成真摄像头。

2) 先做**颜色识别**（这是红线预案，最稳）：
   - 转 HSV，颜色阈值写成模块级常量
   - 找最大轮廓，算外接矩形中心
   - 用 uart_proto.norm_to_u16() 归一化
   - 置信度先用"轮廓面积占比"折算到 0..100

3) 再做**形状区分**：圆形/矩形/三角形 → 映射到不同类别

4) 加一个 --debug 开关，把识别结果画框存成图片，方便我现场调阈值

5) 给出可以直接跑的命令，以及在你机器上实测的输出

注意：
- 不要动 arm/uart_proto.py
- 摄像头分辨率变了不用改 FPGA 代码（归一化坐标的意义就在这）
- 如果帧率上不去 10Hz，告诉我实际能到多少，我们商量降频
```

### 提示词 4：要改协议时（**警告：这是最危险的改动**）

```
我想给协议加一个字段。

⚠️ 在动手之前，请先帮我做这几件事：

1) 读 doc/uart_frame_protocol.md 和 doc/interface_delivery.md §3，
   告诉我现有协议里有没有别的办法达到目的（不一定要改协议）

2) 如果确实必须改，帮我列出**完整的影响面清单**：
   - ARM 侧要改哪些函数（arm/uart_proto.py）
   - FPGA 侧要改哪个模块（rtl/app/uart_frame.v）和哪几行
   - 文档要改哪几处
   - 现有测试（arm/uart_proto.py 自测、sim/tb_uart_frame.v）哪些会失效

3) 检查是否符合"不兼容变更必须升版本号"的规则

4) 给出一个**独立 commit** 的改动方案，commit message 按 team_sync_guide.md §7 的格式写

**先不要改代码**，把清单给我，我去群里和 A 确认。
```

---

## 4. 你要读的文件（按顺序）

| 顺序 | 文件 | 读什么 |
|---|---|---|
| 1 | [`doc/interface_delivery.md`](../doc/interface_delivery.md) | §0 怎么用、§2 UART 协议、§3 对齐约定 |
| 2 | [`arm/README.md`](../arm/README.md) | 协议库怎么用、怎么联调 |
| 3 | [`doc/uart_frame_protocol.md`](../doc/uart_frame_protocol.md) | 协议完整定义（含联调检查清单 §6） |
| 4 | [`doc/team_sync_guide.md`](../doc/team_sync_guide.md) | Git 工作流、接口冻结规则 |
| 5 | `arm/uart_proto.py` | 源码，遇到疑问直接看实现 |

---

## 5. 硬约束（**违反了会浪费很多时间**）

| # | 约束 | 为什么 |
|---|---|---|
| 1 | **不要改 `uart_proto.py` 的对外接口** | FPGA 侧 `uart_frame.v` 已按这个协议实现并通过 58 项检查 |
| 2 | **坐标必须归一化** | 否则换摄像头就要改 FPGA 代码 |
| 3 | **帧开销是 9 不是 10** | 我们算错过一次，导致 5 个测试全挂 |
| 4 | **BCC 不含帧头帧尾** | 同上 |
| 5 | **类别只能用 0x00~0x04** | FPGA 侧 `main_fsm` 只认这几个 |
| 6 | **改协议必须双方确认** | 这是唯一的耦合点，一边改一边不改 = 联调全是乱码 |

---

## 6. 常见的坑

| 现象 | 原因 | 怎么办 |
|---|---|---|
| FPGA 收到乱码 | **没共地** | 三根线：TX、RX、**GND** |
| 通信时好时坏 | 波特率不对 / 用了 5V 电平 | 确认 **115200 8N1** + **3.3V** |
| FPGA 完全不响应 | 引脚接反 | ARM 的 TX 接 FPGA 的 **RX**（交叉） |
| 帧被丢弃但没报错 | 类别码不在 0x00~0x04 | 未知类型 FPGA **静默丢弃**（设计如此） |
| 误帧率 > 1% | 线太长 / 没屏蔽 / 波特率误差 | 先查线，再考虑升级 CRC16 |

---

## 7. 你不需要做的事

| 不用做 | 为什么 |
|---|---|
| 不用实现 UART 收发底层 | FPGA 侧 `uart_tx`/`uart_rx` 已验证 17/17 |
| 不用实现帧校验/超时/重同步 | FPGA 侧 `uart_frame` 已验证 58/58 |
| 不用管电机、编码器、避障 | 那是 FPGA 的活 |
| **不用等 FPGA** | 协议已冻结，你现在就能独立开工 |
