yilo425/wheel-leg-robot-delivery/handoff/C_mech.md

# C —— 机械与集成

> **你的两个关键作用**：
> 1. **填接口表** —— 你现在是 A（FPGA）的**最大阻塞源**，填完他才能继续做舵机和 TOF
> 2. **把东西真的造出来并装起来** —— 这是 AI 完全帮不上忙的部分

---

## 0. ⚠️ 最优先的事（今天就做）

**A 有 6 个模块做不下去，全部卡在你这里：**

```
servo_lift（升降腿）  ← 卡在：lift_done 从哪来？舵机型号？
tof_driver（测距）    ← 卡在：TOF 型号与接口
imu_driver（姿态）    ← 卡在：IMU 型号与接口
pwm_motor 参数        ← 卡在：驱动板型号、电机接口电平
motion_decision 转向  ← 卡在：驱动形式（差速/麦轮/四轮）
top.cst 引脚分配      ← 卡在：板卡引脚表
```

**把这些信息填进下面的表，A 就能立刻继续。**

---

## 1. 请填这张表（**第 10 项最关键**）

> 填法：把「填写」列补上，然后提交（见 §5）。
> **不确定的写"待确认"**，不要留空 —— 留空和"确认过了"看起来一样。

| # | 需要的信息 | 为什么需要 | 阻塞谁 | 填写 |
|---|---|---|---|---|
| 1 | **驱动形式**：差速 / 麦克纳姆 / 四轮独立 | 决定转向算法：差速是左右反向，麦轮要四轮合成 | `motion_decision` 的 `STEER_COEF0..3` | |
| 2 | **轮径**（mm） | 编码器计数 → 实际线速度的换算系数 | 速度换算、里程 | |
| 3 | **轮距 / 轴距**（mm） | 差速转向的角速度换算 | `motion_decision` | |
| 4 | **轮编号约定**：哪个是 0/1/2/3 | 装反了转向会反 | `m_pwm[3:0]` / `enc_a/b[3:0]` 接线 | |
| 5 | **编码器 PPR**（每圈脉冲数） | 计数 → 转数换算 | 速度换算 | |
| 6 | **编码器输出类型**：推挽 / 开漏 / 差分 | **开漏必须开 FPGA 内部上拉**，否则读不到高电平 | `top.cst` 的 `PULL_MODE` | |
| 7 | **编码器供电电压**：3.3V / 5V | 5V 必须加电平转换 | 硬件接线 | |
| 8 | **电机驱动板型号**（TB6612 / DRV8833 / 其他） | 决定 PWM 频率、死区、使能极性 | `pwm_motor` 参数 | |
| 9 | **驱动板逻辑电平**：3.3V / 5V | 5V 必须加电平转换 | 硬件接线 | |
| **10** | **★ `lift_done` 从哪来**：<br>限位开关？舵机位置反馈？固定延时？ | **三者的 RTL 实现完全不同** | `main_fsm` 越障阶段 | |
| 11 | **舵机型号与控制方式** | PWM 频率、脉宽范围 | `servo_lift` | |
| 12 | **硬件急停方案**：<br>现在是软件急停（按键）。<br>是否需要一路**直接切断电机电源**的硬件回路？ | 安全设计，可能影响结构布局 | 安全设计 | |
| 13 | **板卡引脚分配表** | `top.cst` 里全是 `PIN_xx` 占位值 | **上板** | |

### 第 10 项为什么最关键

FPGA 的越障流程是：

```
抬腿 (lift_cmd=1) → 等 lift_done → 前进 → 放腿 (lift_cmd=0) → 等 lift_done → 完成
```

**`lift_done` 的来源决定了整个阶段怎么写：**

| 如果来自… | FPGA 要怎么做 | 你的工作量 |
|---|---|---|
| **限位开关** | 边沿检测 + 消抖（复用省事的滤波逻辑） | 加两个开关 + 走线 |
| **舵机位置反馈**（电位器） | 需要 ADC 或脉宽测量，**工作量大** | 舵机要带反馈线 |
| **固定延时** | 最简单，但**不可靠**（堵转时不知道） | 零 |

> **好消息**：FPGA 侧已经用超时兜底（`LIFT_TIMEOUT_MS = 3000`）。
> 即使 `lift_done` 永远不来，3 秒后也会放弃并报 `error_flag` —— **不会卡死**。
> 所以这一项不填，A 也能先做，只是做不完整。

---

## 2. 任务清单

### 里程碑 0：解锁 A（**今天~明天**）

| # | 任务 | 验收标准 | 状态 |
|---|---|---|---|
| **C0.1** | **填完 §1 的表**（不确定的写"待确认"） | 表里没有空格 | ⬜ |
| ~~C0.2~~ | ~~拿到板卡引脚分配表~~ | ✅ **已完成**（`constraints/pin_table.csv` 已填 37 个引脚）| ✅ |
| **C0.3** | 确定底盘方案（驱动形式 + 尺寸） | 画出草图或写清参数 | ⬜ |

### 里程碑 1：设计与采购（3~7 天）

| # | 任务 | 验收标准 | 阻塞于 |
|---|---|---|---|
| **C1.1** | 出**采购清单**（电机/编码器/驱动板/舵机/轮子/结构件/电池） | 清单含型号、数量、价格、链接 | C0.3 |
| **C1.2** | **下单采购**（★ 注意交期！） | 下单号发群里 | C1.1 |
| **C1.3** | 底盘 3D 设计（或选现成底盘改装） | 能导出加工文件 | C0.3 |
| **C1.4** | 确定**升降腿机构**方案 | 说明用什么舵机、怎么传动、`lift_done` 怎么来 | C0.1 第10项 |
| **C1.5** | 确定**摄像头安装位置与角度**（给 B） | 视场角能覆盖前方障碍 | — |
| **C1.6** | 确定**TOF 安装位置**（给 A） | 朝向正确，不被结构遮挡 | — |

### 里程碑 2：装配与联调

| # | 任务 | 验收标准 |
|---|---|---|
| **C2.1** | 结构件加工 / 3D 打印 | 到手能用 |
| **C2.2** | **装配底盘**：电机、编码器、轮子 | 手动转轮子，编码器有输出 |
| **C2.3** | **架空轮子**测电机方向（★ 不要落地！） | 每个轮子转向符合约定 |
| **C2.4** | 装升降腿机构 | 舵机能把腿抬起来 |
| **C2.5** | 装传感器（TOF / 摄像头） | 线接好，不挡视线 |
| **C2.6** | 装电池 + 电源分配 | 各板子电压正确 |
| **C2.7** | **落地测试**（★ 必须 A 在场，手里拿着急停） | 能直线走、能转向 |
| **C2.8** | 硬件急停按钮（如果决定做） | 按下能切断电机电源 |

---

## 3. 可直接粘贴给 DSH 的提示词

### 提示词 1：开场

```
【项目背景】
轮足复合式 FPGA 实时感知与自主控制机器人，参加 2026 全国大学生嵌入式芯片与系统设计竞赛
（高云 FPGA 赛道）。队伍三人：A 做 FPGA 实时控制，B 做 ARM 视觉，C 做机械与集成（我是 C）。

机器人形态：四轮 + 可升降腿，能跨越低矮障碍。

【请先读这几个文件】
1. doc/interface_delivery.md   —— 接口全貌；重点读 §1（FPGA 对外接口）、§4（需要我提供的信息）、§5（引脚）
2. handoff/C_mech.md           —— 我的任务清单（就是这份）
3. doc/interface_spec.md       —— 模块级接口，需要时会查

【我现在的状况】
- A（FPGA）有 6 个模块做不下去，全部卡在我这里
- 我还没确定驱动形式、轮径、编码器规格、电机驱动板、升降腿方案
- 板卡引脚分配表还没拿到

【现在请你】
读完文件后，帮我做这件事：

把 handoff/C_mech.md §1 的 13 项表，逐项整理成一份**我需要去确认的问题清单**，
每个问题给出：
  - 为什么 FPGA 需要这个信息（用一句话说清）
  - 我该去查什么资料 / 问谁 / 量哪里
  - 如果我给不出，有没有**替代方案或默认值**能让 A 先往下做

输出成一份 Markdown，标题「机械组待确认清单」。
不要编造具体数值，不知道的就写"需实测/需查手册"。
```

### 提示词 2：底盘方案设计

```
我们已经确定：
- 驱动形式：<填：差速/麦轮/四轮独立>
- 目标尺寸：<填>
- 用途：能爬过 <填>mm 的低矮障碍

请帮我做底盘方案设计，要求：

1) 给出**总体布局图**（用 ASCII 或 Mermaid 画俯视图），标明：
   - 四个轮子的位置和编号（0/1/2/3）
   - 电机和编码器的安装位置
   - FPGA 板、ARM 板、电池、驱动板的位置
   - TOF 和摄像头的安装位置与朝向
   - 升降腿机构的位置

2) 计算并给出**关键尺寸**：
   - 轮距、轴距
   - 重心位置（大致）
   - 离地间隙（要能过障碍）

3) 列出**结构件清单**：需要哪些板/支架/连接件，能否用现成的

4) 标出**装配顺序**和每一步的**验证方法**
   （比如"装完电机先架空测试转向"）

先给方案，不要直接开始画图文件。我确认后再动手。
```

### 提示词 3：升降腿机构（对应第 10 项）

```
我要设计机器人的升降腿机构。请帮我分析三种方案的取舍：

方案 A：限位开关
方案 B：舵机位置反馈（电位器）
方案 C：固定延时（不反馈）

对每种方案，请给出：
1) 需要什么零件、大概成本
2) 机械复杂度（要不要额外的连杆/凸轮）
3) **对 FPGA 侧的影响** —— 具体说清 A 要写什么逻辑
   （参考 doc/interface_delivery.md §4.1 那张表）
4) 失效模式：如果卡住了会怎样
5) 调试难度

最后给出你的推荐，并说明理由。

【重要】不要假设 FPGA 侧已经支持某个方案 —— 现在 main_fsm 只有"等 lift_done + 3 秒超时"，
任何更复杂的方案都要 A 改代码，所以要评估工作量。
```

### 提示词 4：装配与联调检查表

```
底盘零件都到货了，我要开始装配。请帮我写一份**装配与联调检查表**。

要求：
1) 按**严格顺序**排列，每一步都是"做完才能做下一步"
2) 每步包含：
   - 做什么
   - **怎么验证做对了**（要具体、可观测）
   - 做错了会有什么现象
3) 必须包含这几条安全项：
   - 第一次给电机通电时**轮子必须架空**
   - 测电机方向时不能落地
   - 落地测试必须有人手扶急停
4) 参考 doc/interface_delivery.md §6.1 的上电顺序，但要展开成可执行步骤
5) 最后加一列"签字"，方便我和 A/B 分工确认

输出成 Markdown 表格，我可以打印出来贴在工位上。
```

---

## 4. 你要读的文件

| 顺序 | 文件 | 读什么 |
|---|---|---|
| 1 | [`doc/interface_delivery.md`](../doc/interface_delivery.md) | **§1 接口总表、§4 需要你提供的信息、§5 引脚现状、§6 上电时序** |
| 2 | [`handoff/C_mech.md`](C_mech.md) | 本文件 |
| 3 | [`doc/interface_spec.md`](../doc/interface_spec.md) | 需要精确信号定义时查 |

**你不用读** `rtl/` 里的任何 Verilog —— 那是 A 的活。

---

## 5. 怎么提交你在表里填的内容

**表填完后，让 A 帮你提交**（或者自己走 Git）：

```bash
cd <工程目录>/robot_project
git checkout mech
# 编辑 handoff/C_mech.md，把表填上
git add handoff/C_mech.md
git commit -m "机械: 填写接口确认表（13 项）"
git push
```

然后**在群里 @A**，他就知道可以继续了。

> Git 用法详见 [`doc/team_sync_guide.md`](../doc/team_sync_guide.md)。
> 不熟的话，**直接把填好的表发群里也行** —— 别因为不会用 Git 就拖着不填。

---

## 6. 安全红线（**这几条不能省**）

| # | 规矩 | 为什么 |
|---|---|---|
| 1 | **第一次给电机通电，轮子必须架空** | 转向反了机器人会直接冲出去 |
| 2 | **落地测试必须有人手扶急停** | 状态机可能没调好 |
| 3 | **电池要能一键断电** | 出问题时能立刻断 |
| 4 | **接线前先确认电压** | 5V 接到 FPGA 引脚会烧 |
| 5 | **共地** | FPGA / ARM / 驱动板必须共地，否则通信全乱 |

---

## 7. 你不需要做的事

| 不用做 | 为什么 |
|---|---|
| 不用写 Verilog | 那是 A 的活 |
| 不用懂 UART 协议 | 那是 B 和 A 的约定 |
| 不用选 ARM 板 | B 在选 |
| **但"填表"不能拖** | **A 卡在这里** |
