yilo425/wheel-leg-robot-delivery/mech/body_layout.png

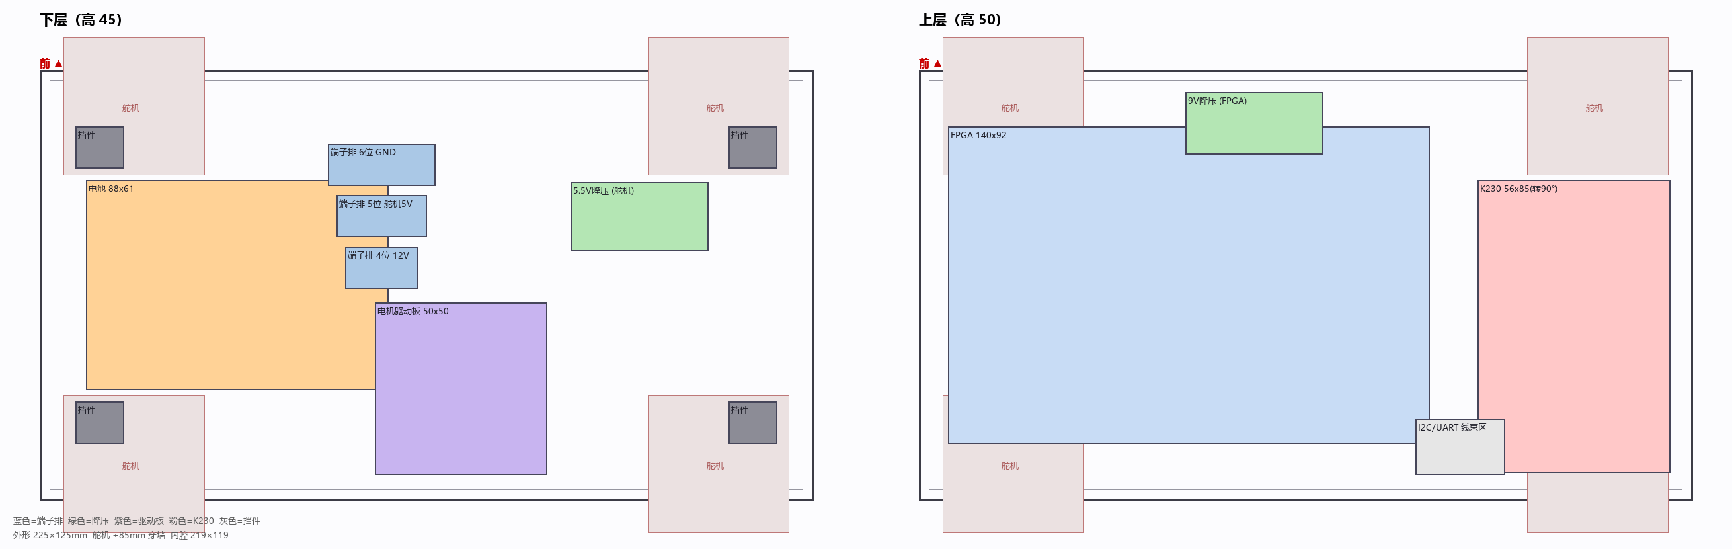
mech/body_layout.png
