yilo425/wheel-leg-robot-delivery/mech/body_v4_demo.png

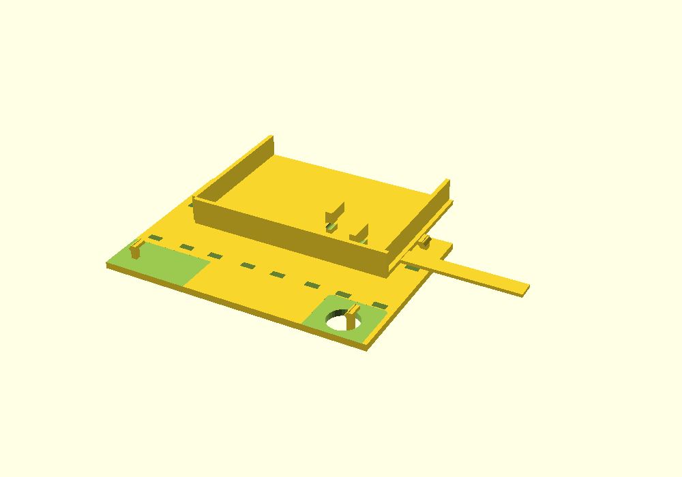
mech/body_v4_demo.png
