yilo425/wheel-leg-robot-delivery/mech/body_v4_layers.png

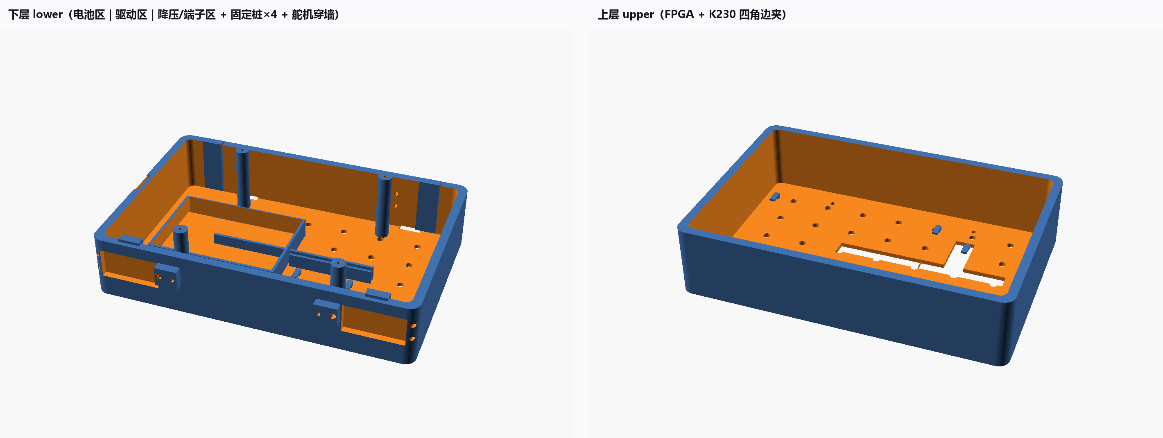
mech/body_v4_layers.png
