yilo425/wheel-leg-robot-delivery/mech/body_v5_clamp.png

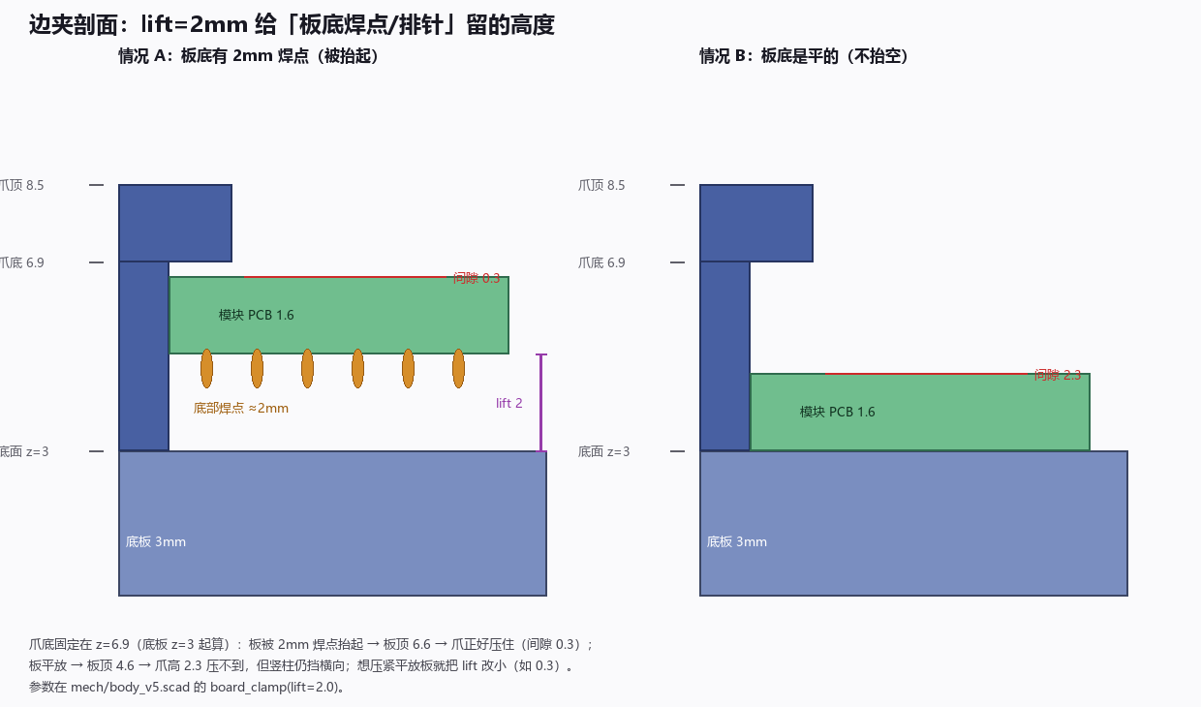
mech/body_v5_clamp.png
