yilo425/wheel-leg-robot-delivery/mech/body_v5_ext_pb.png

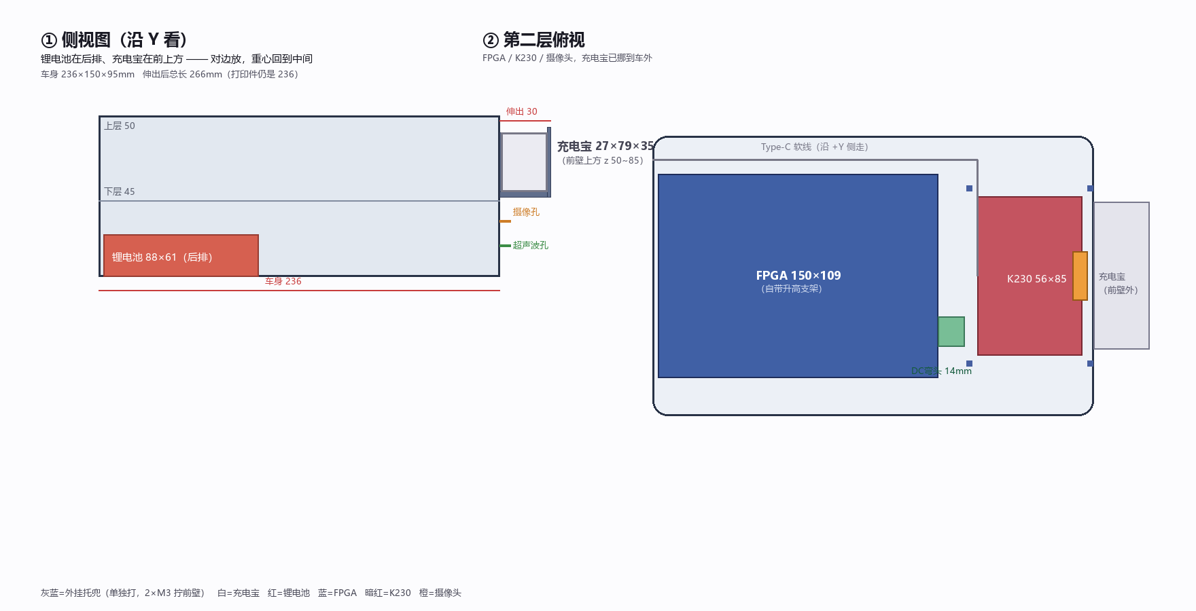
mech/body_v5_ext_pb.png
