yilo425/wheel-leg-robot-delivery/mech/body_v5_layer2_3d.png

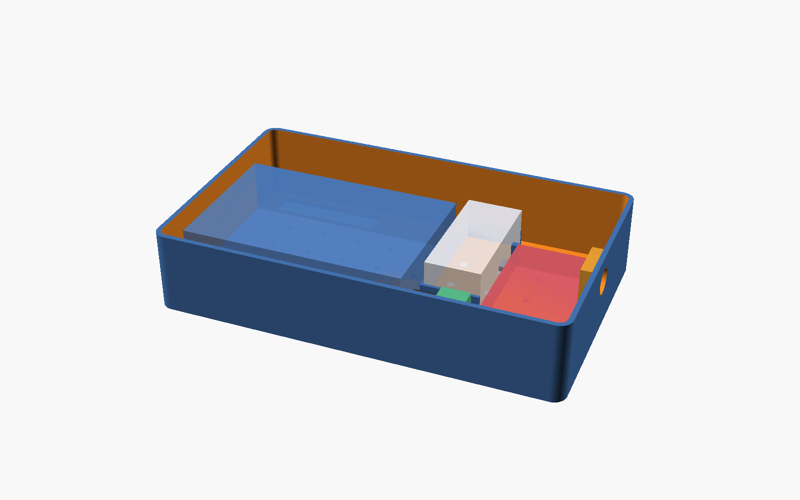
mech/body_v5_layer2_3d.png
