yilo425/wheel-leg-robot-delivery/mech/body_v5_layout2.png

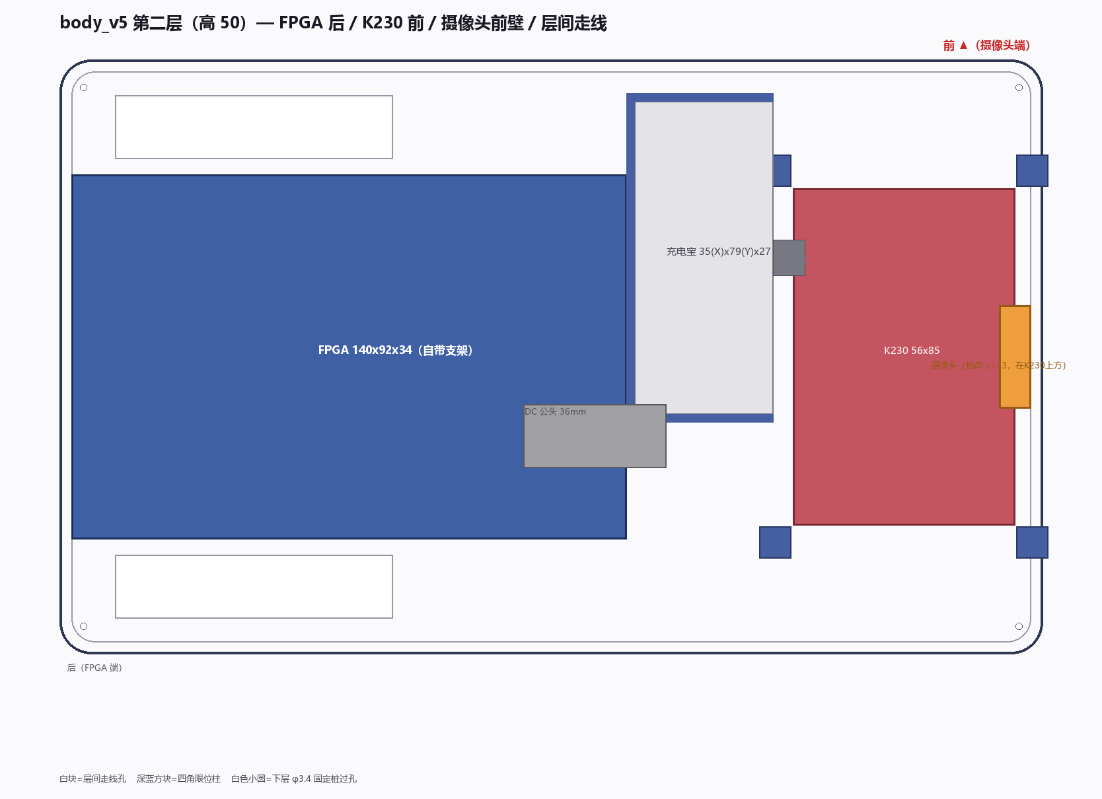
mech/body_v5_layout2.png
