yilo425/wheel-leg-robot-delivery/mech/body_v5_layout.png

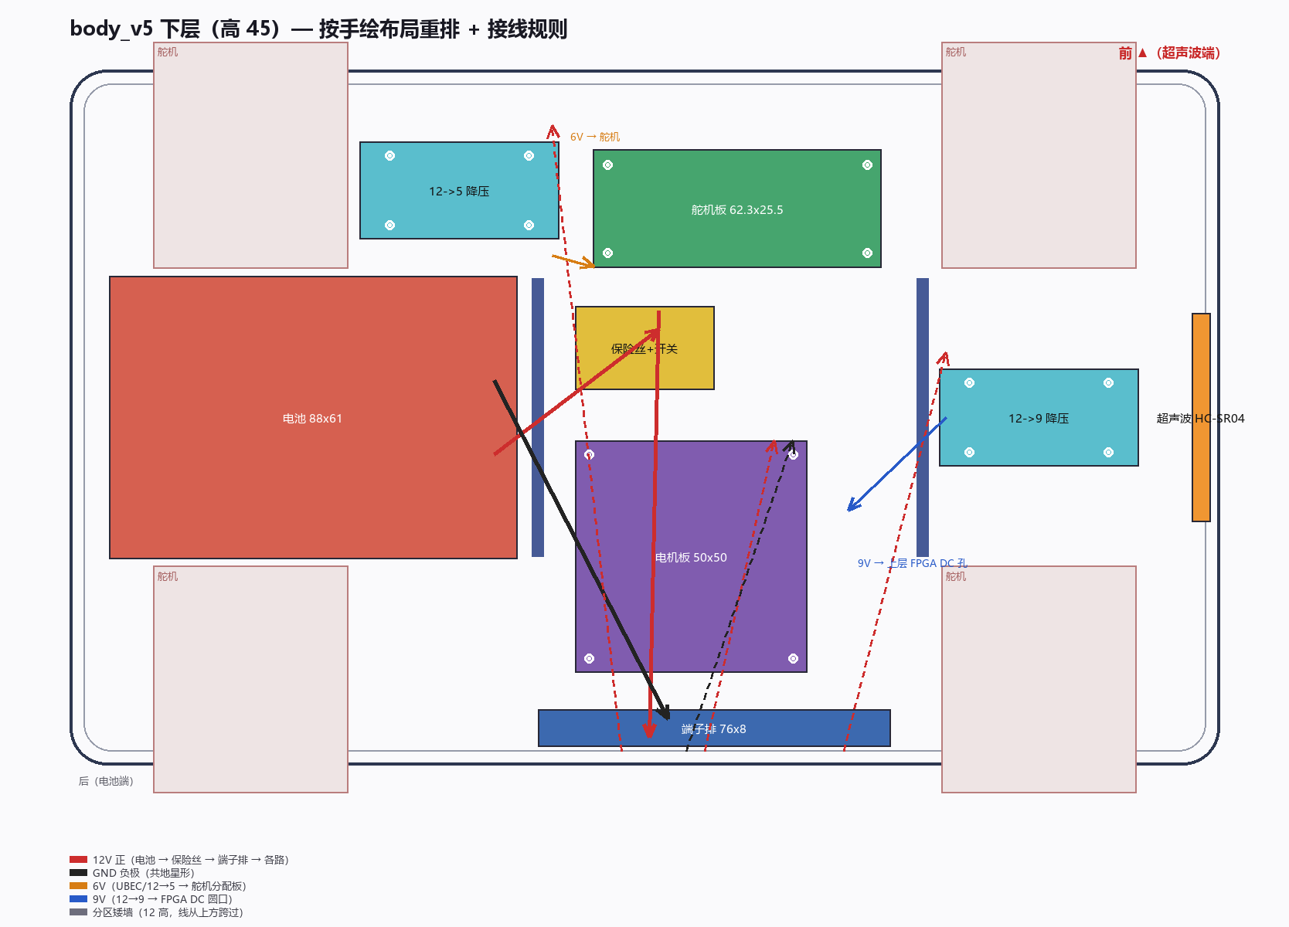
mech/body_v5_layout.png
