yilo425/wheel-leg-robot-delivery/mech/body_v5_plan_v2.png

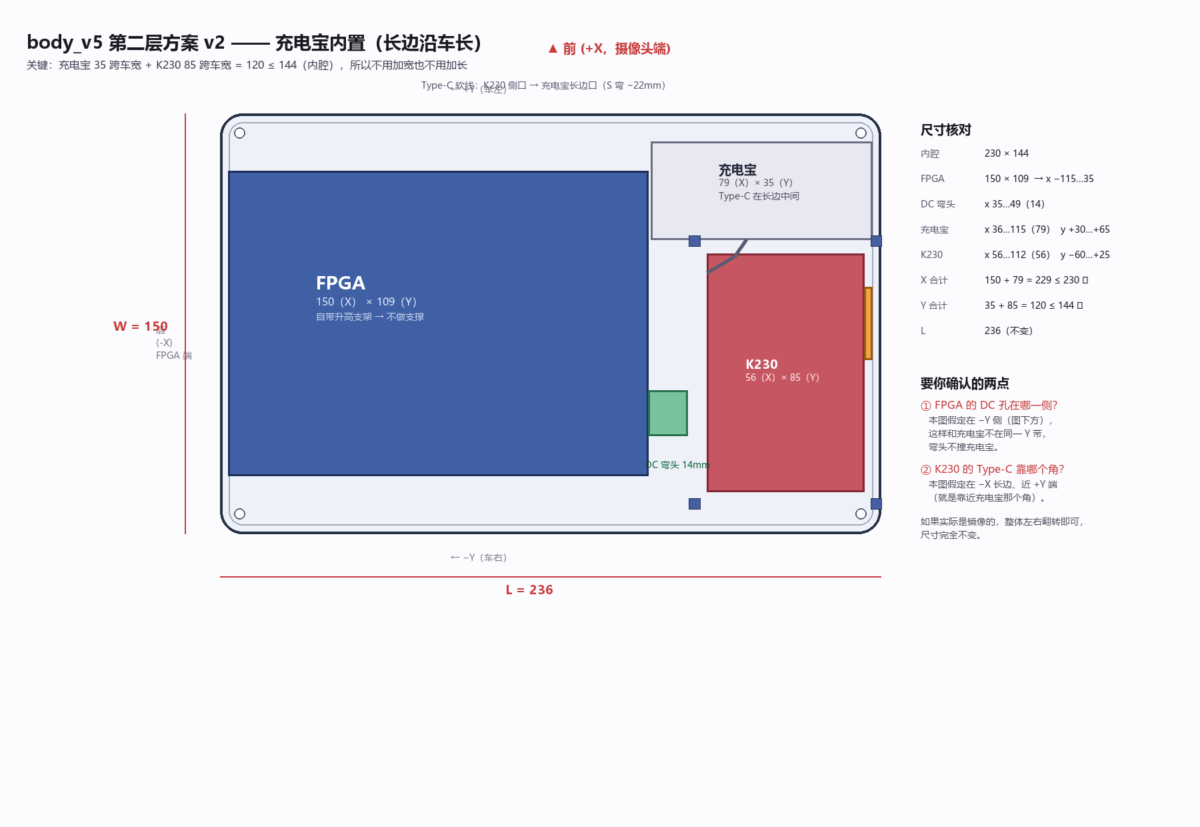
mech/body_v5_plan_v2.png
