yilo425/wheel-leg-robot-delivery/mech/body_v5_plan_v3.png

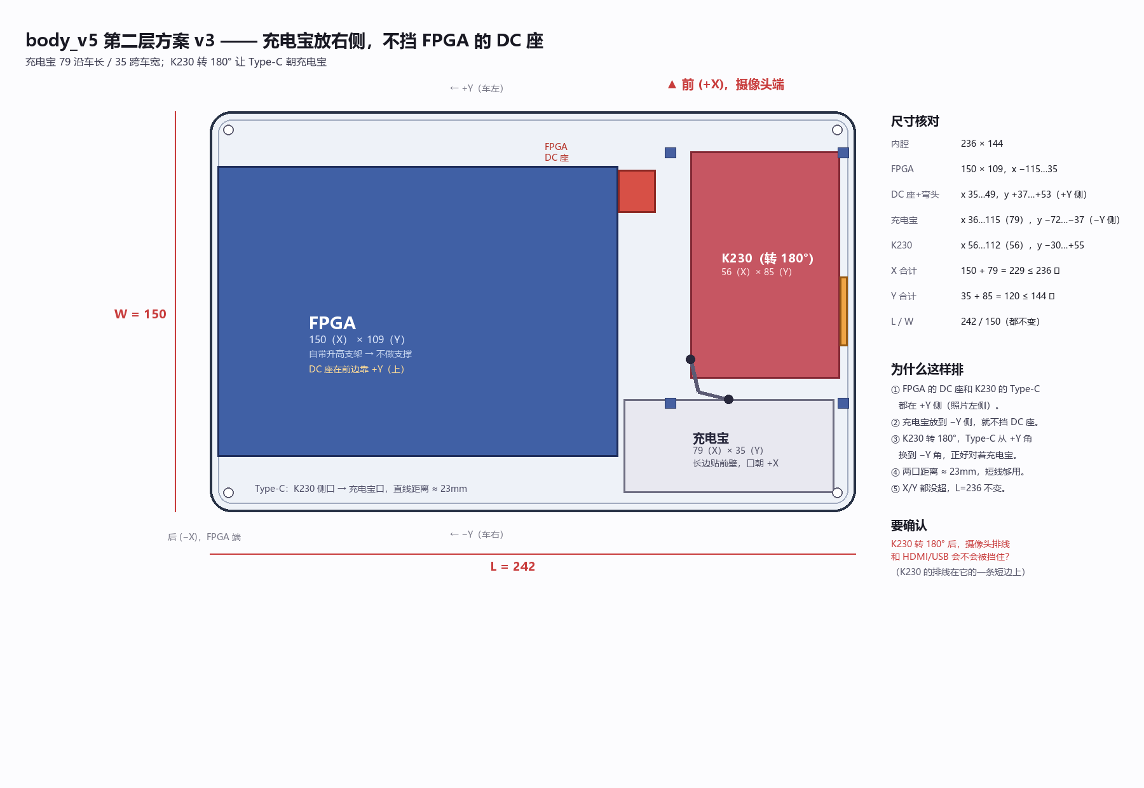
mech/body_v5_plan_v3.png
