yilo425/wheel-leg-robot-delivery/mech/body_v5_upper_plan.png

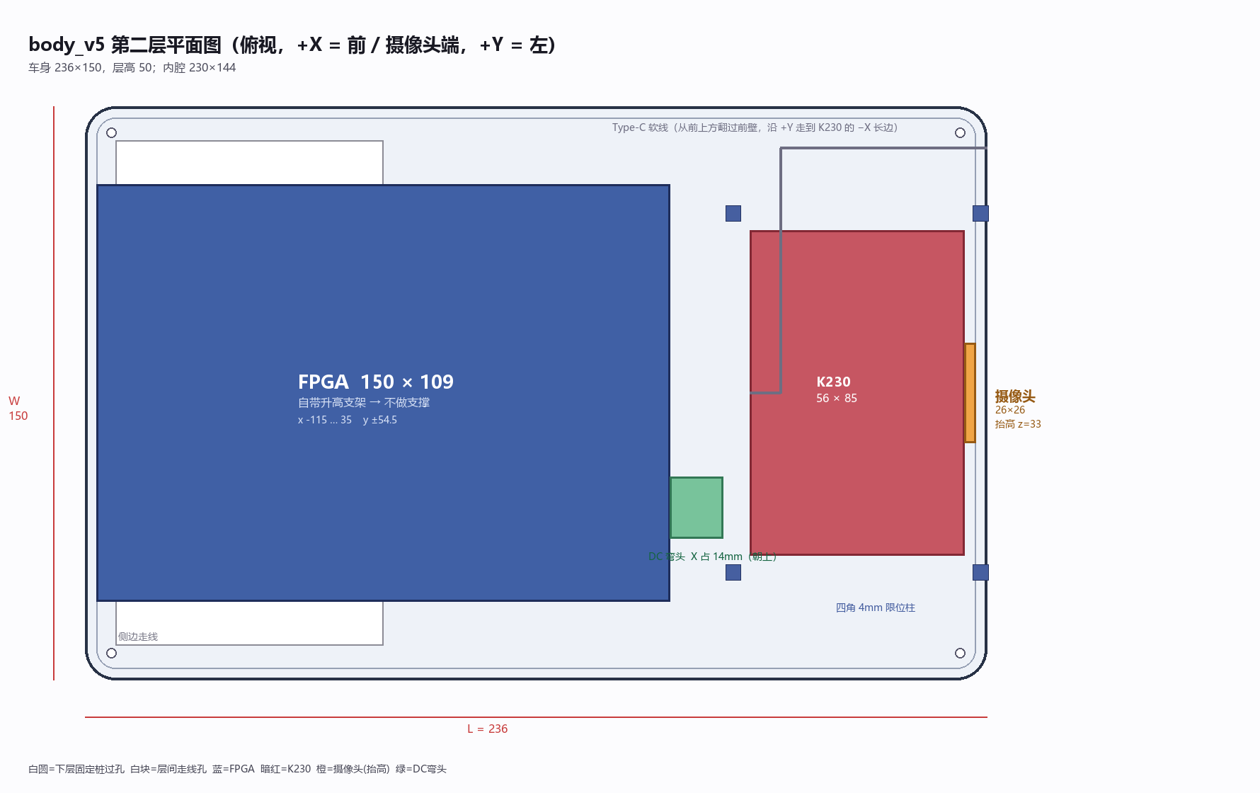
mech/body_v5_upper_plan.png
