yilo425/wheel-leg-robot-delivery/mech/leg_3d.png

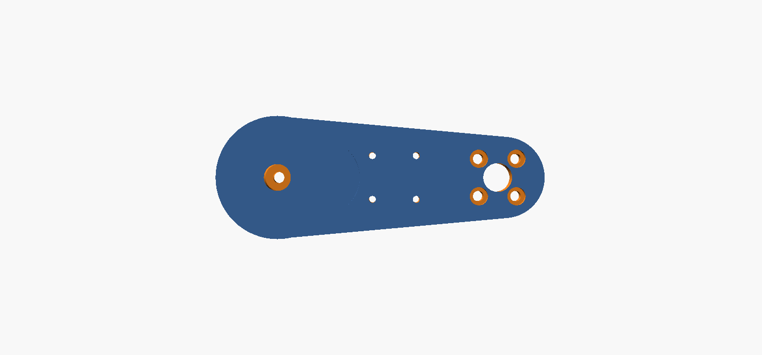
mech/leg_3d.png
