yilo425/wheel-leg-robot-delivery/mech/leg_70mm_preview.png

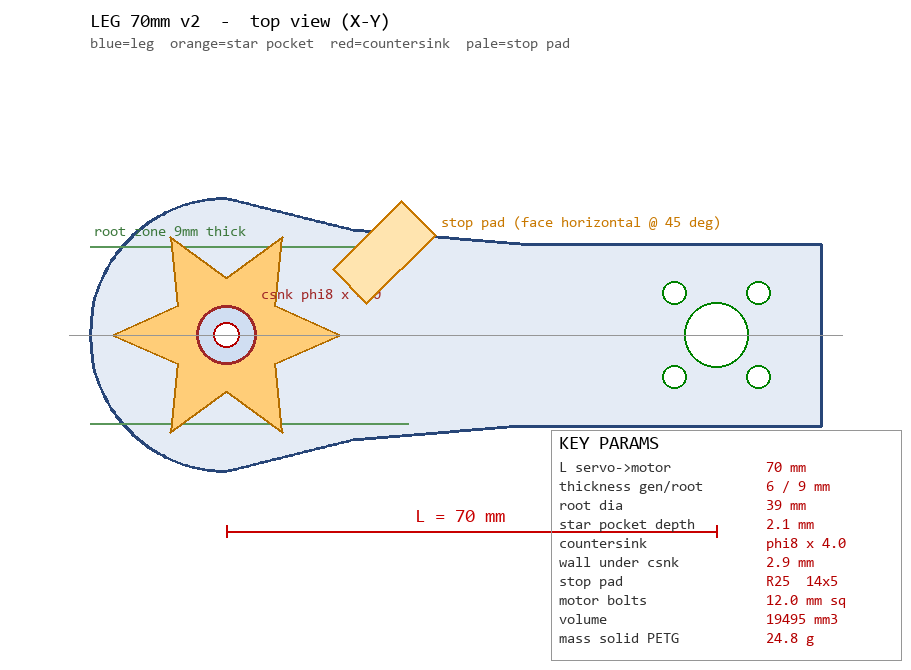
mech/leg_70mm_preview.png
