yilo425/wheel-leg-robot-delivery/mech/leg_iso.png

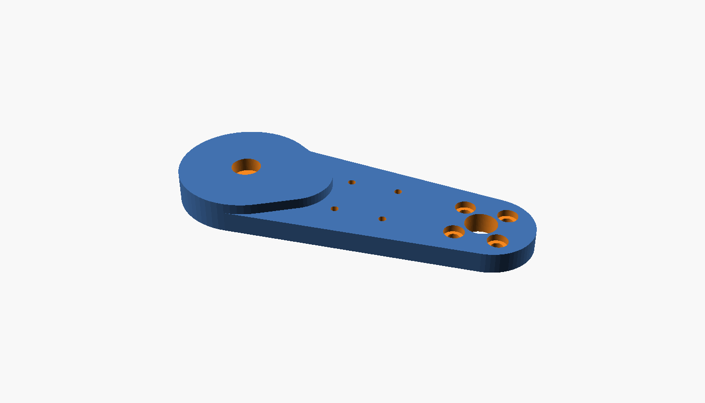
mech/leg_iso.png
