yilo425/wheel-leg-robot-delivery/mech/leg_pocket_2d.png

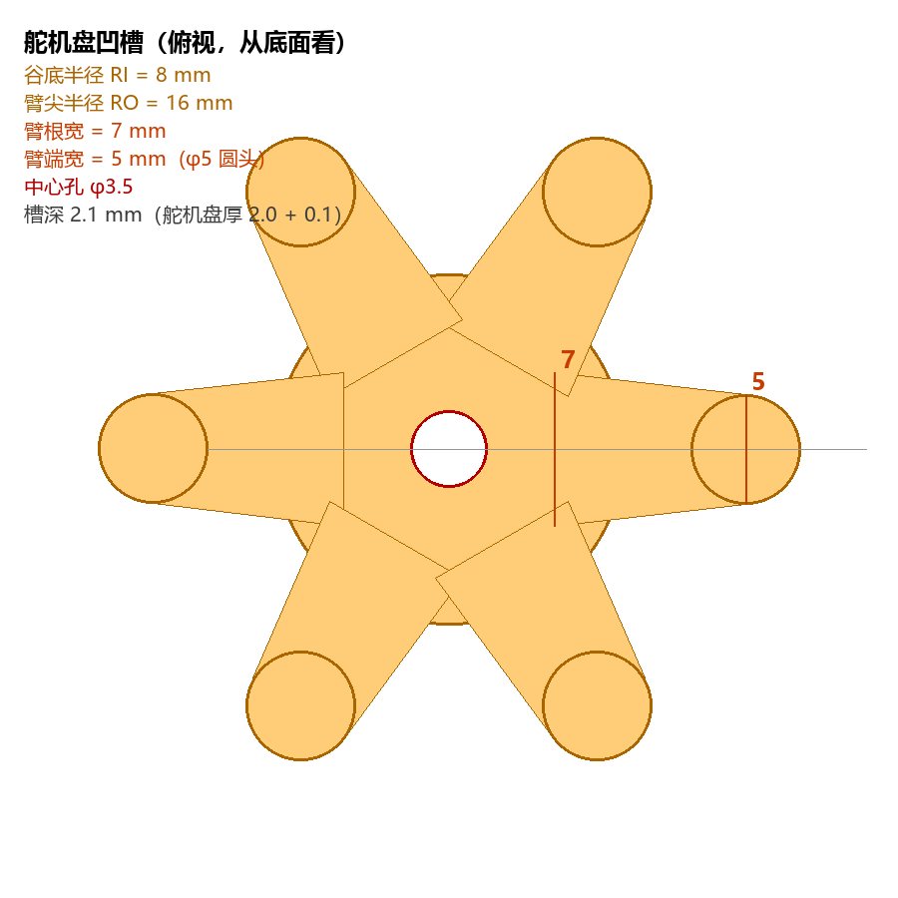
mech/leg_pocket_2d.png
