yilo425/wheel-leg-robot-delivery/mech/leg_pocket_zoom.png

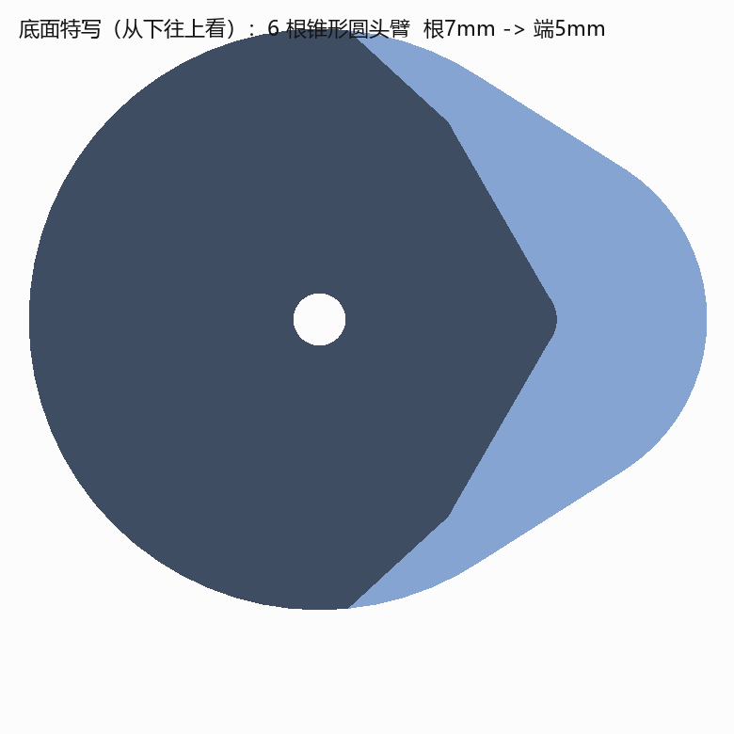
mech/leg_pocket_zoom.png
