yilo425/wheel-leg-robot-delivery/mech/leg_stop_pad.png

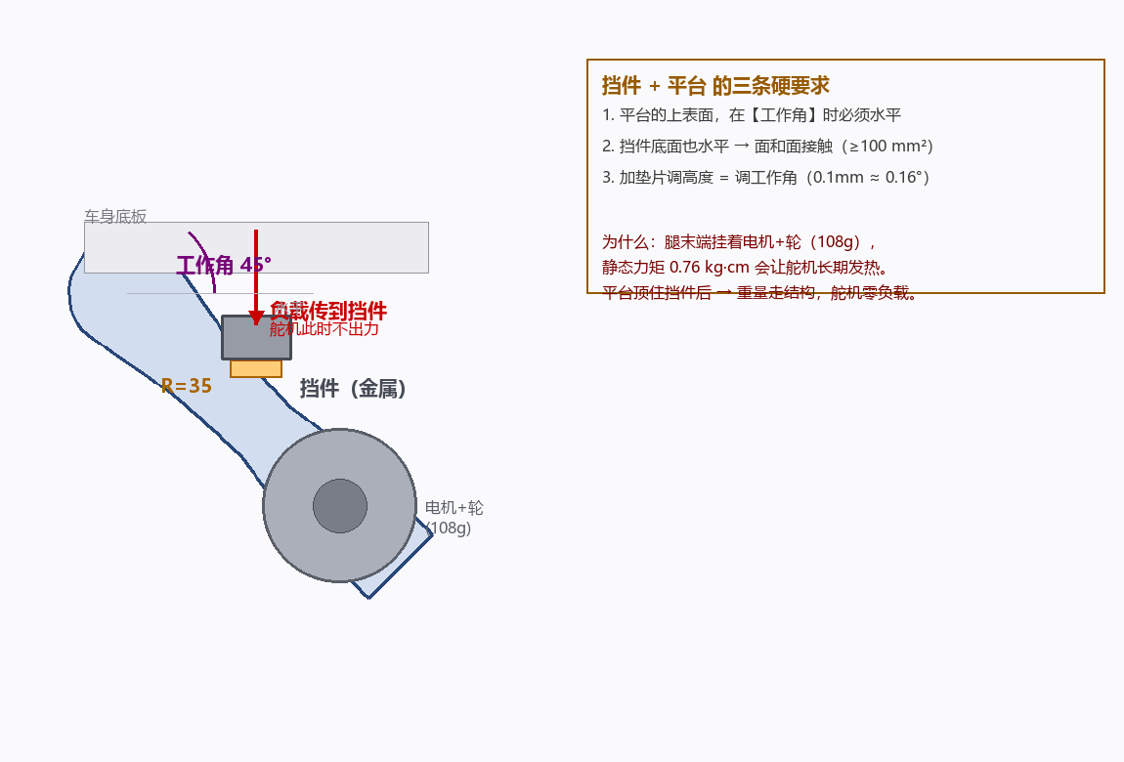
mech/leg_stop_pad.png
