yilo425/wheel-leg-robot-delivery/mech/lower_after.png

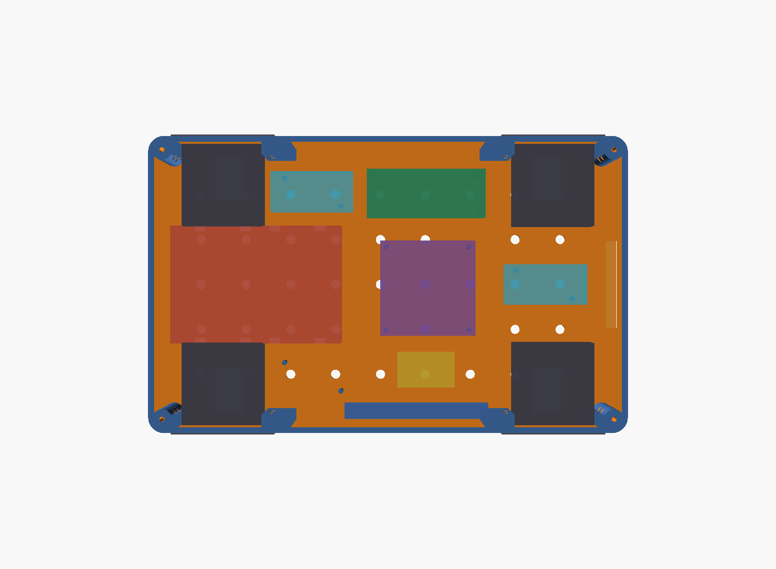
mech/lower_after.png
