yilo425/wheel-leg-robot-delivery/mech/stop_block.png

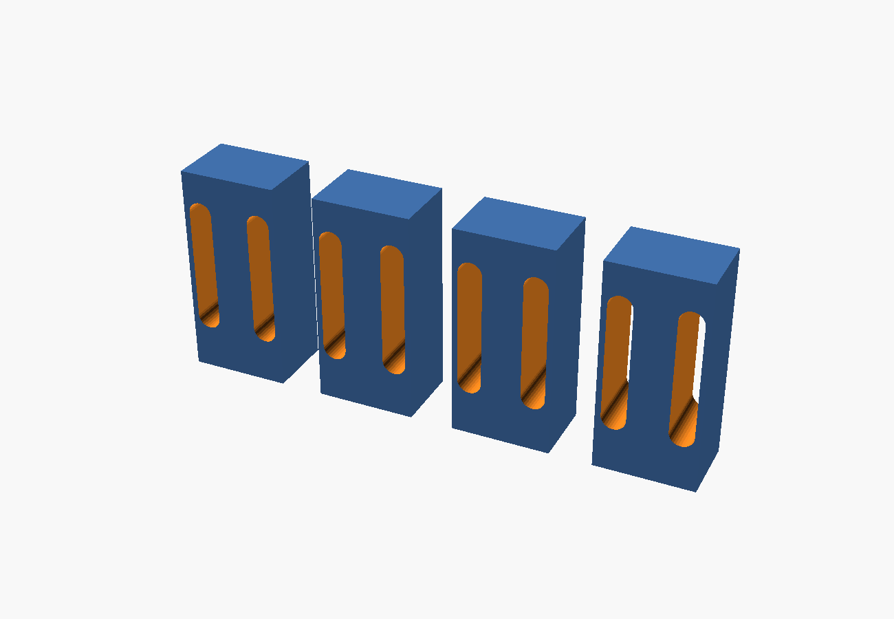
mech/stop_block.png
