yilo425/wheel-leg-robot-delivery/mech/stop_block_bottom.png

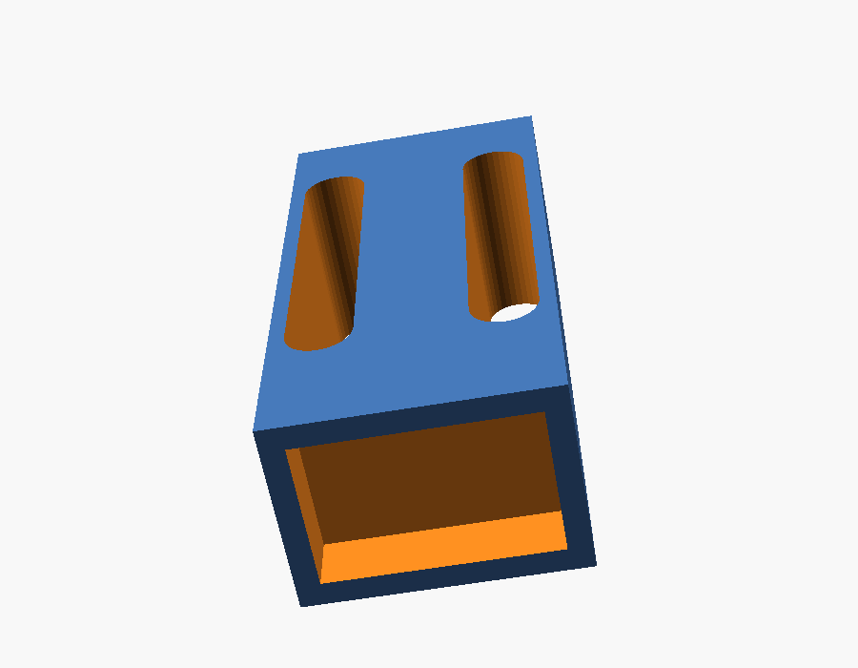
mech/stop_block_bottom.png
