yilo425/wheel-leg-robot-delivery/mech/upper_v2.png

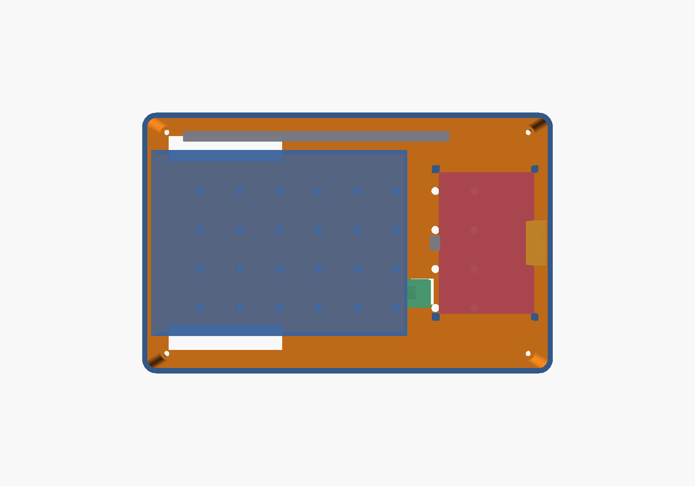
mech/upper_v2.png
