yilo425/wheel-leg-robot-delivery/mech/v5_final_iso.png

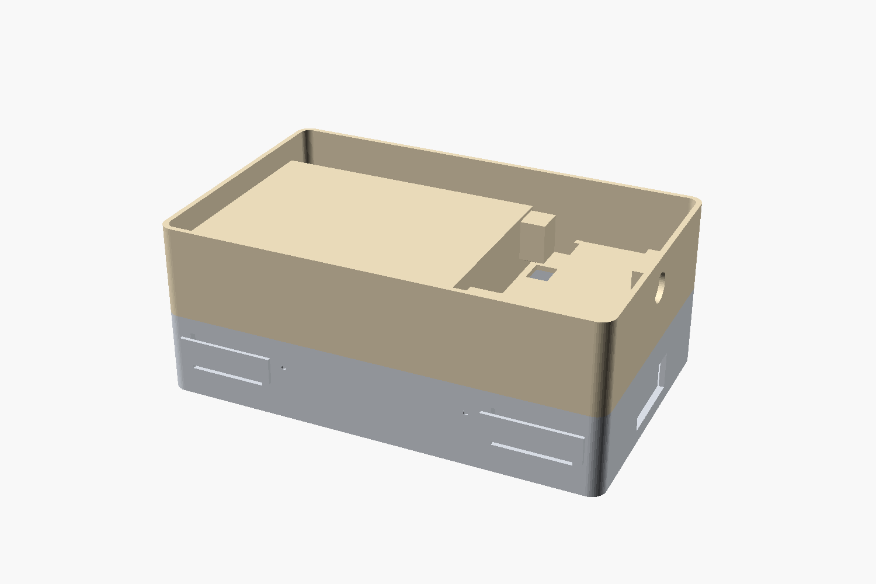
mech/v5_final_iso.png
