yilo425/wheel-leg-robot-delivery/mech/v5_final_top.png

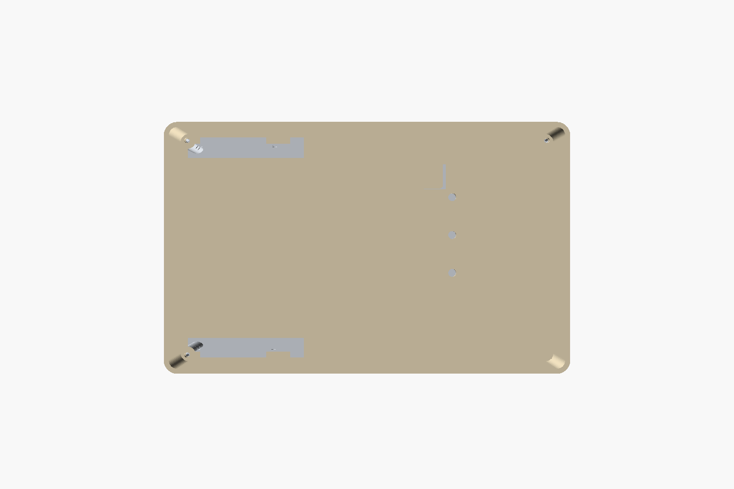
mech/v5_final_top.png
