yilo425/wheel-leg-robot-delivery/doc/v5待改清单.md

# body_v5 待改清单（累积中）

> 规则：能确定的直接改；缺数据的先记在这里等补齐，**不要猜着改**（改错要重打）。
> 每次改完都重出 STL + 重跑校验（0 非流形）。

---

## ✅ 已在 2026-10-27 改完（提交见 git log）

| # | 部位 | 改动 | 状态 |
|---|---|---|---|
| 1 | **舵机板定位柱** | 高度 **10 → 5mm**（减一半）、直径 **φ2.6 → φ1.6**（减 1mm）| ✅ 已改 |
| 2 | **12→5 / 12→9 降压定位柱** | 每块由 4 根改成 **2 根对角**（左上 + 右下），因为 LM2596 只有 2 个圆孔；新增 `pcb_posts_2()` | ✅ 已改 |
| 3 | **舵机内壁加强筋** | **整个删掉**（`servo_boss`）。原因：筋比墙内表面高 6mm，耳片两头被顶起、中间悬空，舵机卡不住 | ✅ 已改 |

**改动后校验**：lower STL `0 非流形`，包围盒 242×162×45 ✓

> ⚠️ 删掉加强筋后，舵机耳片的 M3 自攻只咬 **3mm 墙厚**（原来咬 6mm 筋 + 3mm 墙）。
> 4 颗螺丝分担，小舵机负载够用；如果试装发现滑牙，下一步可加 **1.5mm 高的整片凸台**
> （覆盖耳片全长 49×12，让咬合变成 4.5mm），而不再是原来那种"两头高中间低"的筋。

---

## ✅ 2026-10-27 第二轮也改完了

| # | 改动 | 具体数值 | 状态 |
|---|---|---|---|
| 4 | **再放一组对称的 2 柱**（给第二块 LM / UBEC 托板）| 把 B5 的柱阵按 `Y=0` **镜像** → `(-55, -56.5)` 和 `(-25, -41.5)`；实现成 `pcb_posts_2(B5_CX, -B5_CY, ...)`，**改 B5_CX/B5_CY 这组会跟着走** | ✅ 已改 |
| 5 | **电机板 4 柱** 往左平移 5mm | `DRV_CY: -30 → -25`（柱阵 44×44 本来就居中于 50×50 板）| ✅ 已改 |
| 6 | **舵机板 4 柱** 往下平移 3mm | `SB_CX: 20 → 17` | ✅ 已改 |

**校验**：lower STL `0 非流形`（242×162×45）；布局脚本全过（模块无重叠、都在内腔、不撞舵机区、不撞分区墙）。

### ⚠️ 方向约定（如果平移方向反了，改这两个数就行）

我把"左/下"理解成**俯视图**里的方向：

| 你的说法 | 我的理解 | 对应参数 |
|---|---|---|
| 电机板柱**往左** 5mm | 车左 = **+Y** | `DRV_CY` −30 → **−25** |
| 舵机板柱**往下** 3mm | 朝车尾 = **−X** | `SB_CX` 20 → **17** |

> 如果实际是反的（比如"下"是 −Y），把上面两个数反向改一下重新导出即可，我可以代改。

### 第 4 条那组柱子如果位置不对

它现在是 **B5 的镜像**（`B5_CX, -B5_CY`）。要挪就改这两处之一：
- 直接改 `B5_CX` / `B5_CY`（两组一起动）
- 或者把那行改成写死坐标：`pcb_posts_2(你想要的X, 你想要的Y, ...)`

## 其他（等你补充）

| # | 部位 | 问题 | 备注 |
|---|---|---|---|
| （待填）| | | |

---

## ✅ 2026-10-27 第三轮（对着 OpenSCAD 截图给的方向）

> ⚠️ **方向约定更正**：你说的是**屏幕里的方向**（俯视图），我上一轮按"车体方向"理解错了轴，已改正：
> 屏幕左 = **−X**（朝电池/车尾）、屏幕下 = **−Y**

| # | 改动 | 具体值 | 状态 |
|---|---|---|---|
| 7 | **电机板 4 孔** 左移 7、下移 10 | `DRV_CX 17→10`、`DRV_CY −25→−35`（上一轮错加的 +Y 5 已一并抵消）| ✅ |
| 8 | **舵机板 4 孔** 下移 3 | `SB_CY 45→42`（`SB_CX` 回退成 20）| ✅ |
| 9 | **挡件凸台删掉**（图 3 那个）| 注释掉 `stop_boss()`；**4 个 M3 底孔保留**（左右各 2、共面）| ✅ |
| 10 | **分区矮墙 P1 删掉**（图 2 那个）| 注释掉 `partition(P1_X)`；P2 保留 | ✅ |
| — | 舵机内壁加强筋 | **恢复**（它在墙内侧，不挡舵机；给耳孔螺丝多 6mm 咬合）| ✅ |

**校验**：lower STL `0 非流形`；包围盒回到 **242×150×45**（凸台没了）；布局脚本全过。

### ⚠️ 第 9 条的代价（要知道）

凸台删掉后，**挡件的 M3 自攻只咬 3mm 侧壁**（原来 3mm 墙 + 6mm 凸台 = 9mm）。
挡件受力约 8.4N，2 颗螺丝够用；如果试装发现松，两个备选：
1. 用 **M3×8** 自攻（别用太长的，会顶穿）
2. 我在墙外侧加一个 **1.5mm 高的浅凸台**（只比墙高 1.5，不会像原来 6mm 那样顶到舵机耳片）

---

## ✅ 2026-10-27 第四轮（用户更正：是**正方向**）

| # | 改动 | 前 → 后 | 状态 |
|---|---|---|---|
| 11 | **电机板 4 柱** 沿 Y **+20**、沿 X **+14** | (10, −35) → **(24, −15)** | ✅ |
| 12 | **舵机板 4 柱** 沿 Y **+6** | (20, 42) → **(20, 48)** | ✅ |
| 13 | **分区矮墙** 改正：**保留 P1（靠电池）**、**删掉 P2** | 与上一轮相反 | ✅ |
| 14 | **保险丝座跟着挪** Y 15 → **22** | 电机板后沿到了 y=+10，原保险丝(y 6…24)会撞 → 往上挪 7mm | ⚠️ 连带改动 |

**校验**：lower STL `0 非流形`（242×150×45）；布局脚本全过。

### 这一版的完整坐标（方便你核对）

| 模块 | 中心 | 占用范围 |
|---|---|---|
| 电池 | (−68.5, 0) | x −114…−23，y ±32 |
| **电机板** | **(24, −15)** | x −1…49，y −40…10 |
| **舵机板** | **(20, 48)** | x −11…51，y 35…61 |
| **保险丝/开关** | **(20, 22)** | x 5…35，y 13…31 |
| 12→5 降压 | (−40, 49) | x −61…−18，y 38…60 |
| 12→9 降压 | (83, 0) | x 61…104，y −10…10 |
| 端子排 | (15, −67) | x −23…53，y −71…−63 |
| 分区墙 | **P1 保留**（x=−20）/ P2 已删 | y ±30 |

## 已经提过但还没定的

| 项 | 状态 |
|---|---|
| 量 5 个实物尺寸（FPGA 高度 / K230 高度 / 电池 / 充电宝 / 驱动板电容）| ⏳ 未量，影响上层是否顶到 |
| 12→9 的 LM2596 要**先用万用表调到 9.0V** 再接 FPGA | ⚠️ 安全提醒 |
| 6A UBEC 要**先用万用表确认 6V** 再接舵机 | ⚠️ 安全提醒 |
