yilo425/wheel-leg-robot-delivery/doc/采购清单.md

# ACG720 轮足机器人 · 采购清单

> 版本：v1.0　日期：2026-10-13
> 编写：A（FPGA）　消费：C（机械）下单
> **本清单由 FPGA 代码的实际端口需求倒推**，每一项都对应一个已写好的接口。
>
> 器件型号：**GW5AT-138**（小梅哥 ACG720，138K 版本）
> 估价为淘宝散买参考价，**下单前请重新核对**。

---

## 0. 先明确整车形态（**新理解，重要**）

```
        ┌─────────────────────┐
        │      车  身          │   ← FPGA 板 / ARM 板 / 电池
        └──┬──────────────┬───┘
          │              │
        ┌─┴─┐          ┌─┴─┐      ← 四条腿（可摆动/伸缩）
        │ 腿 │   ...    │ 腿 │
        └─┬─┘          └─┬─┘
          │              │
         (O)            (O)         ← ★ 轮子在腿【末端】
```

**关键结论：**
- **移动全靠轮子**，轮子在**腿末端**，随腿一起动
- **腿大部分时间蜷缩** → 车身贴近地面 → 就是普通轮式车
- **腿只负责把车身顶起来**（不是把轮子抬高！）→ 抬高离地间隙

**三种障碍策略：**

| 障碍 | 判定 | 动作 | 代码状态 |
|---|---|---|---|
| **小石头**（长度 < 整车） | 视觉 `0x04` | **四腿一起抬** → 开过去 | `S_LIFT`（现有） |
| **大障碍**（长度 ≫ 整车） | 视觉 `0x02` | 抬腿无用 → **绕行** | `S_AVOID`（现有） |
| **台阶/门槛** | 视觉 `0x05`（**待 B 新增**） | **前腿抬→走→后腿抬→走** | ❌ **待实现** |

---

## 1. 运动部分（轮子 + 电机）

### 1.1 减速电机 ×4 ★核心

| 项 | 要求 | 说明 |
|---|---|---|
| **数量** | **4** | 每条腿末端一个 |
| **类型** | **有刷直流减速电机** | ⚠️ **不要无刷/轮毂电机** —— 需要 FOC 驱动，FPGA 做不了 |
| **电压** | **12V** | 和电池/驱动板匹配 |
| **减速比** | **1:20 ~ 1:30** | 要扭矩不要转速 |
| **编码器** | **必须带 AB 相霍尔编码器** | 代码需要 4 路 AB 相做闭环 |
| **PPR** | 11 或 13 线 | 够用，不用纠结（见 §5 标定） |
| **⚠️ 供电** | **编码器要能 3.3V 供电** | **FPGA IO 是 3.3V，5V 输出会打死 IO！**<br>买之前**问卖家**：编码器能不能 3.3V 供电<br>不行的话要加买**电平转换模块**（见 1.4） |

**推荐型号**：`JGB37-520`（12V，1:30，带霍尔编码器）
**备选**：`MG310`（Wheeltec 智能车常用）
**估价**：¥35-60 / 个　→　**¥140-240**

> ⚠️ **给 C 的提醒**：电机装在**腿末端**，重量会**直接加到舵机负载**上。
> 选电机时**体积和重量也是指标**，别只看扭矩。

### 1.2 电机驱动板 ×2

| 项 | 要求 |
|---|---|
| 型号 | **TB6612FNG** |
| 数量 | **2 片**（每片双路，共 4 路） |
| **关键** | 逻辑电平必须 **3.3V 兼容**（TB6612 是 2.7-5.5V ✓） |
| 电流 | 1.2A/路（连续），峰值 3.2A |

**接口**：每路 3 根线 —— `PWM` + `DIR` + 使能（4 路共用 `m_en`）
**估价**：¥8-15 / 片　→　**¥16-30**

### 1.3 轮子 + 轮毂 ×4

| 项 | 要求 |
|---|---|
| 数量 | 4 |
| **孔径** | **必须匹配电机轴**（JGB37-520 是 **D 型轴 6mm**） |
| 轮径 | **¥40-65mm**（腿末端空间有限，别太大） |
| 材质 | 橡胶胎面（抓地） |

**⚠️ 最容易买错的一项** —— 下单前把电机轴的型号/直径发给卖家确认。
**估价**：¥10-20 / 个　→　**¥40-80**

### 1.4 电平转换模块（**条件购买**）

**只有编码器不支持 3.3V 供电时才需要。**

| 项 | 要求 |
|---|---|
| 型号 | **TXS0108E**（8 路双向）或 74LVC245 |
| 数量 | **2 个**（8 路编码器信号） |
| 估价 | ¥5-8 / 个　→　**¥10-16** |

---

## 2. 腿部分（★ 本项目最难的部分）

### 2.1 舵机 ×4

| 项 | 要求 | 说明 |
|---|---|---|
| 数量 | **4** | 每条腿 1 个 |
| 类型 | **180° 位置舵机** | ⚠️ **不要 360° 连续旋转型！**<br>代码发的是位置 PWM（0.5~2.5ms） |
| 扭矩 | **≥ 13 kg·cm** | 见下面扭矩估算 |
| 齿轮 | **金属齿** | 承重必须金属齿 |
| 供电 | **4.8-6V** | 独立供电，不能从 FPGA 板取电 |

**推荐型号**：`MG996R`（金属齿，13kg·cm，¥15-30）
**备选**：`DS3218`（20kg·cm 数字舵机，¥40-60）

**估价**：¥20-35 / 个　→　**¥80-140**

### 2.2 ★ 扭矩估算（C 必须自己复核）

```
整车估重        ≈ 1.5 kg（电池 0.25 + 板子 0.2 + 结构 0.6 + 电机轮子 0.45）
每条腿分担      ≈ 0.4 kg
连杆有效力臂    ≈ 3~5 cm
所需扭矩        ≈ 0.4 × 5 cm = 2.0 kg·cm

MG996R = 13 kg·cm  →  余量 6.5 倍  ✓ 够用
```

**但有余量不等于可以长期承重 —— 见 §2.4。**

### 2.3 ⚠️ 舵机电源（**这条最容易出事**）

| 项 | 要求 |
|---|---|
| **独立降压模块** | **5V / ≥5A**（DC-DC 可调降压） |
| 输入 | 接电池（12V） |
| 输出 | **只给舵机**，不走 FPGA 板 |
| **大电容** | **1000µF 以上**并在舵机电源上，吸收堵转冲击 |
| 线径 | **≥22AWG**，电源线短而粗 |

> **为什么必须独立供电**：
> MG996R 堵转电流 **2.5A**，4 个同时动可达 **10A**。
> 和 FPGA 共用一路 → 电压跌落 → **FPGA 复位**。
> **这是这类机器人最常见的"莫名其妙重启"原因。**

**估价**：¥15-25

### 2.4 ⚠️⚠️ 给 C 的机械设计硬约束

**舵机不能长期承重！**

腿"放下/蜷缩"是**默认状态，占 99% 的时间**。如果整车重量**一直压在舵机上**：
- 舵机会持续发热
- 会抖动（堵转电流大）
- 会缩短寿命甚至烧毁

**必须做：**
1. **腿到极限位置要有机械止挡**（金属/打印件顶住，让重量走结构不走舵机）
2. 或加**扭簧 / 气弹簧**分担静态负载
3. 或腿用**自锁机构**（蜗轮蜗杆 / 丝杆）

**这一条没做好的话，跑 10 分钟舵机就烫手了。**

### 2.5 限位开关 ×4

| 项 | 要求 |
|---|---|
| 数量 | **4**（前腿 1 + 后腿 1 + 备用 2） |
| 类型 | **常开（NO）微动开关 / 行程开关** |
| 接法 | 一端接 **GND**，另一端接 FPGA 输入（代码里已配**上拉**） |
| 作用 | 确认腿**抬起到位** |

**买常开型**（未按下断开）—— 和 FPGA 的上拉配置匹配。
**估价**：¥1-3 / 个　→　**¥4-12**

> **注意**：代码里已有**时间兜底**（`LIFT_TIMEOUT_MS = 3000`），
> 所以限位开关坏了不会卡死，只会超时进安全停车。

---

## 3. 感知部分

### 3.1 TOF 激光测距 ×2 ★建议买 2 个

| 项 | 要求 |
|---|---|
| 型号 | **VL53L0X**（I2C，2~200cm） |
| **数量** | **2** —— **前向 1 个 + 后向 1 个** |
| 接口 | **I2C**，接板上 I2C 排针（`SDA=M16`、`SCL=M13`） |
| 地址 | VL53L0X 默认地址相同，两个要用 I2C 多路复用或改地址 |

**为什么买 2 个（重要）：**

现有代码判断"越障完成"用的是**前向 TOF 距离变远**（`path_clear`）。
但小石头的定义是**长度小于整车** —— 车头过了石头时，**后轮还没过**。
**只有前向 TOF 会在错误的时机收腿，石头会磕到后部。**

**加一个后向 TOF → 前后都通畅才收腿** ✓

> 也可以不加，改用"时间判定"（我改代码即可）。但**有后向 TOF 更可靠**。

**估价**：¥15-30 / 个　→　**¥30-60**

### 3.2 IMU ×1

| 项 | 要求 |
|---|---|
| 型号 | **MPU6050**（I2C，6 轴） |
| 作用 | 遥测里的 `roll / pitch / yaw`（现在是写死的 0） |
| 接口 | 同样走 I2C 总线 |

**估价**：¥8-15

> **可选** —— 不是核心任务，预算紧可以后买。

---

## 4. 电源部分

### 4.1 电池 ×1

| 项 | 要求 |
|---|---|
| 类型 | **3S 锂聚合物电池（11.1V）** |
| 容量 | **≥ 3000mAh** |
| 放电倍率 | **≥ 20C** |
| 插头 | XT60 或 T 插 |

**估价**：¥70-130

> ⚠️ **电压注意**：ACG720 官方规格 **6~12V**，3S 满电 **12.6V**，**超了 0.6V**。
> 板载降压是 TPS54531（输入 3.5~28V），理论上没事，但超规格。
> **保守做法**：给 FPGA 板加一个降压模块降到 **9V**（见 4.3）。

### 4.2 充电器 ×1

| 项 | 要求 |
|---|---|
| 类型 | **B3 / B6 平衡充** |
| 电压 | 匹配 3S |

**估价**：¥45-90

### 4.3 降压模块 ×2

| 用途 | 规格 | 估价 |
|---|---|---|
| **舵机供电** | 输入 12V → 输出 **5V / 5A** | ¥15-25 |
| **FPGA 板供电** | 输入 12V → 输出 **9V / 2A**（保守，避免超 12V 规格） | ¥10-20 |

**也可以直接买一个多路输出的 DC-DC 板。**

### 4.4 其他电气

| 项 | 说明 | 估价 |
|---|---|---|
| 总电源开关 | 船型开关 10A | ¥3-8 |
| 保险丝 | 10A 快熔 + 座 | ¥5 |
| 接线端子 | XT60 公母头 ×2 对 | ¥10 |
| 杜邦线 | 母对母 40P ×2 排 | ¥10 |
| 硅胶线 | 22AWG 红黑各 2m | ¥15 |

---

## 5. ★ 电机标定（买回来后要做的）

代码里的满速参考值是：

```verilog
// rtl/top.v
parameter integer SPEED_WIN = 500_000;   // 测速窗口 = 10ms @50MHz
parameter integer VREF_FULL = 60;        // 满速目标计数/窗口
```

**标定公式**（`encoder_decode.v` 是 **4 倍频**解码）：

```
每轮一圈的计数 = PPR × 4 × 减速比

VREF_FULL = (目标转速RPM / 60) × (PPR × 4 × 减速比) × 窗口秒数
```

**例**（PPR=11，减速比 1:30，窗口 10ms）：

```
每圈计数 = 11 × 4 × 30 = 1320
VREF     = (RPM/60) × 1320 × 0.01 = RPM × 0.22
当前 VREF=60  →  对应 273 RPM  ✓ 合理
```

> **买回来后请把「减速比 + PPR」告诉我，我把 `VREF_FULL` 重新算准。**
> 这个值决定"满速档"实际跑多快。

---

## 6. 总价汇总

| 类别 | 明细 | 小计 |
|---|---|---|
| **运动** | 电机×4 + 驱动×2 + 轮子×4 | **¥196-350** |
| **腿** | 舵机×4 + 独立电源 + 限位×4 | **¥99-177** |
| **感知** | TOF×2 + IMU×1 | **¥38-75** |
| **电源** | 电池 + 充电器 + 降压×2 | **¥140-265** |
| **电气杂项** | 开关/保险丝/端子/线材 | **¥43-48** |
| **合计** | | **≈ ¥516-915** |
| 可选 | 电平转换×2（编码器不兼容时） | +¥10-16 |

**不含**：FPGA 板（已有）、ARM 板（B 负责）、底盘结构件 / 3D 打印

---

## 7. 采购优先级（预算/时间紧时）

| 优先级 | 买什么 | 理由 |
|---|---|---|
| **P0** | 电机×4、TB6612×2、轮子×4、电池、充电器 | **没有这些车动不了** |
| **P0** | 舵机×4、5V/5A 降压、限位开关 | 越障是核心任务 |
| **P1** | **前向 TOF**、后向 TOF | 避障 + 越障完成判定 |
| **P2** | IMU、电平转换 | 非核心 |
| **P2** | 底盘结构件 | C 可先 3D 打印验证 |

**P0 部分约 ¥350-500 —— 这周就能下单。**

---

## 8. 下单前必须确认的 4 件事

| # | 确认什么 | 为什么 |
|---|---|---|
| **1** | **编码器能不能 3.3V 供电？** | 5V 输出会**打死 FPGA 的 3.3V IO** |
| **2** | **电机轴是什么型号/直径？** | 决定买什么孔径的轮子，**最容易买错** |
| **3** | **发我「减速比 + PPR」** | 我要标定 `VREF_FULL` |
| **4** | **舵机是 180° 位置型，不是 360° 连续型？** | 代码发的是位置 PWM |

---

## 9. FPGA 侧会用到哪些引脚（供 C 接线参考）

> 完整表见 `doc/board_pinout.md`。这里是**本次清单相关**的部分。

| 信号 | 引脚 | 板载丝印 | 接什么 |
|---|---|---|---|
| `m_pwm[0..3]` | A13 A14 A15 A16 | GPIO0_0..3 | TB6612 的 PWM 输入 |
| `m_dir[0..3]` | A18 A19 F13 F14 | GPIO0_4..7 | TB6612 的方向输入 |
| `m_en` | E13 | GPIO0_8 | TB6612 的 STBY |
| `enc_a[0..3]` | E14 B13 D15 C15 | GPIO0_9/11/13/15 | 编码器 A 相 |
| `enc_b[0..3]` | C13 D14 C14 B15 | GPIO0_10/12/14/16 | 编码器 B 相 |
| `lift_pwm[1:0]` | **待定** | GPIO0_17/18 | 前后腿舵机信号 |
| `lift_lim_n[1:0]` | **待定** | GPIO0_19/20 | 限位开关 |
| `I2C_SDA` | M16 | I2C 排针 | TOF / IMU |
| `I2C_SCL` | M13 | I2C 排针 | TOF / IMU |

> ⚠️ **轮子编号**（务必按此接线）：
> `0 = 左前  1 = 右前  2 = 左后  3 = 右后`
> 接反会导致**转向整个反过来**。

---

## 10. 待办（挂在别人身上）

| # | 事项 | 谁 | 影响 |
|---|---|---|---|
| 1 | **新增视觉类别码 `0x05 = 台阶/门槛`** | **B（ARM）** | 没有它，跨台阶功能无法触发 |
| 2 | 确认腿的机构形式（舵机连杆 / 推杆） | C | 决定舵机型号和数量 |
| 3 | 确认是否需要"高度可调"（多档舵机角度） | C | 现在代码只有"放下/抬起"两档 |
| 4 | 确认舵机止挡 / 自锁方案 | C | **不做会烧舵机** |

---

## 附：不在本清单里的东西（已有或别人负责）

| 项 | 归属 |
|---|---|
| ACG720 开发板（GW5AT-138） | ✅ 已有 |
| USB 下载线 + 驱动 | ✅ 已有 |
| ARM 视觉板（K230 / 庐山派） | B 负责 |
| ModelSim 仿真 | ✅ 已有 |
| 底盘结构件、3D 打印件 | C 负责（本清单不含） |
