yilo425/wheel-leg-robot-delivery/mech/parts_all.png

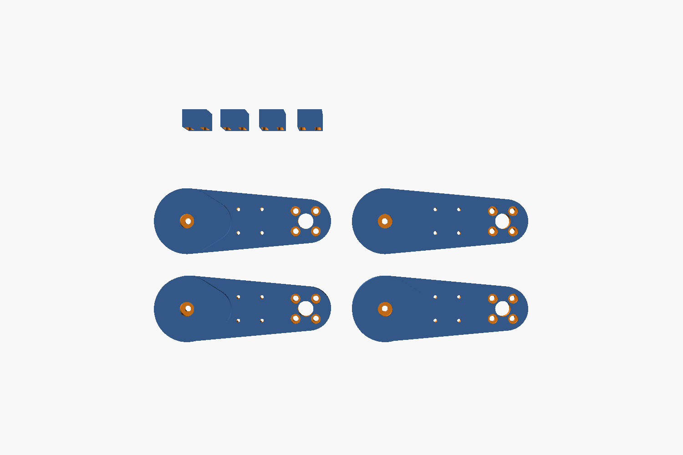
mech/parts_all.png
