yilo425/wheel-leg-robot-delivery/mech/parts_iso.png

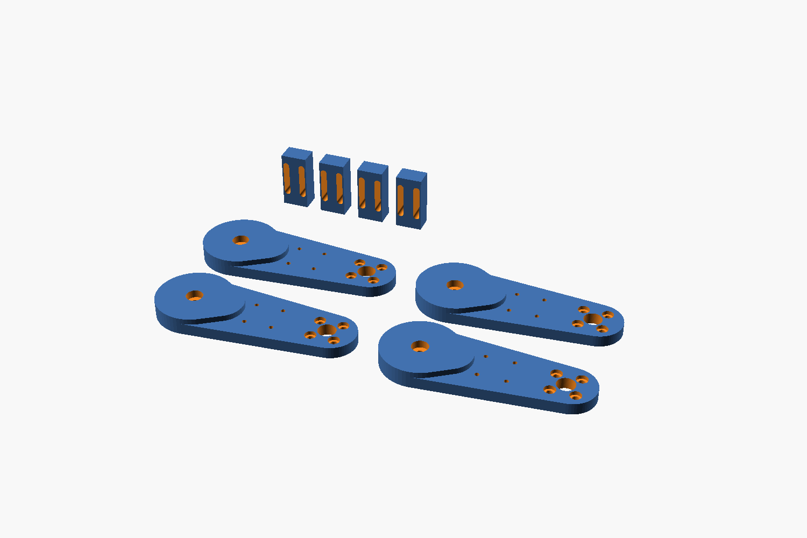
mech/parts_iso.png
