yilo425/wheel-leg-robot-delivery/mech/body_v5_upper_lid.stl

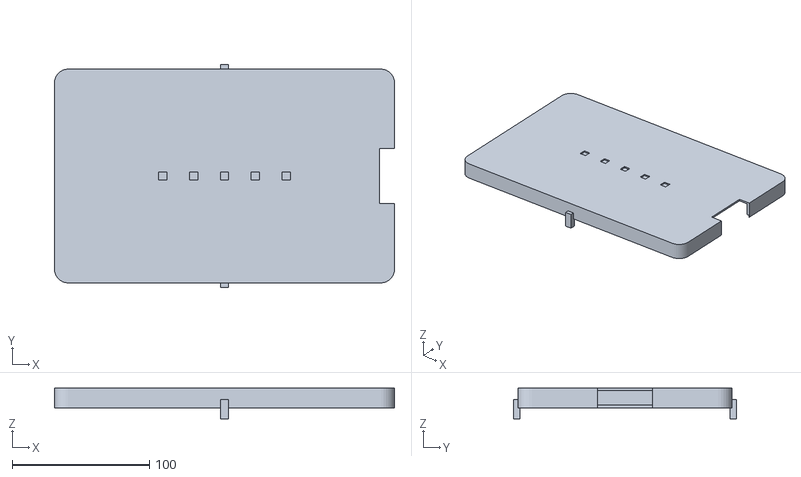
[picture p29: CAD file, 2026-11-03]
mech/body_v5_upper_lid.stl
248.0 x 163.0 x 22.5
