yilo425/wheel-leg-robot-delivery/mech/parts_all.stl

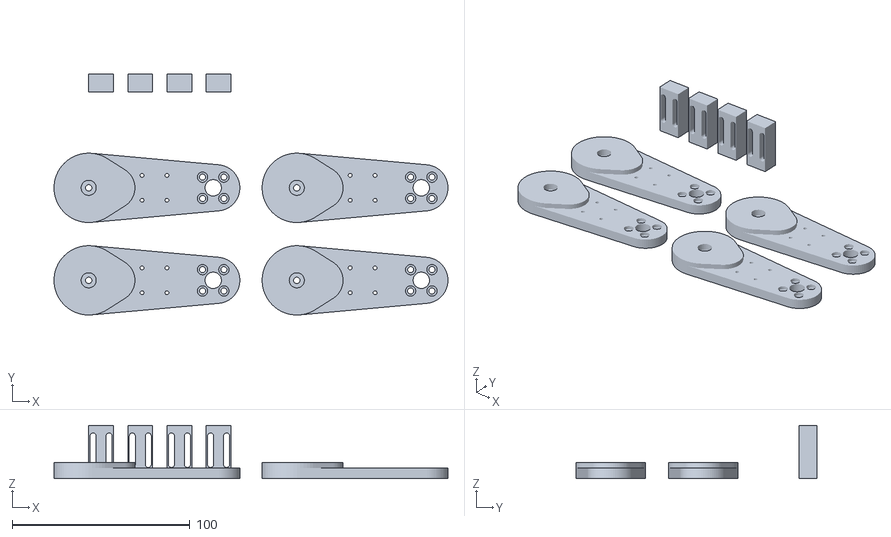
[picture p30: CAD file, 2026-11-03]
mech/parts_all.stl
221.5 x 135.5 x 30.0
