yilo425/wheel-leg-robot-delivery/mech/body_v5_print.stl

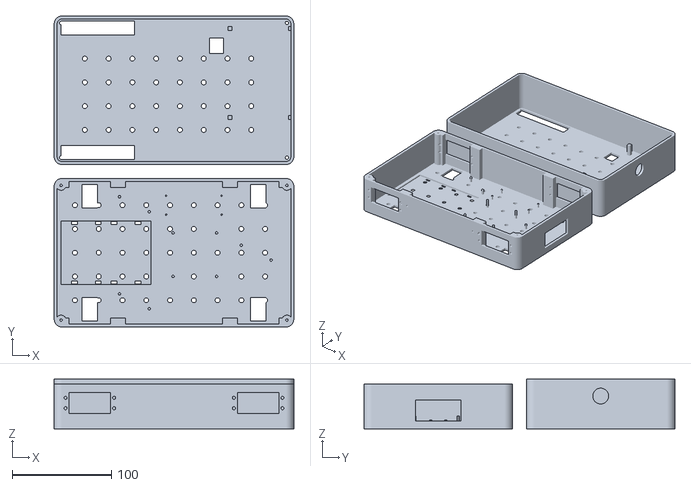
[picture p31: CAD file, 2026-11-03]
mech/body_v5_print.stl
242.0 x 314.0 x 50.0
