yilo425/wheel-leg-robot-delivery/mech/horn_fit.stl

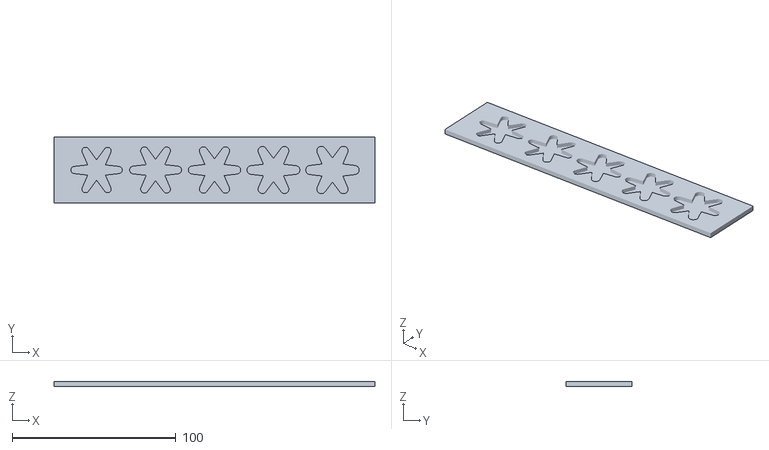
[picture p32: CAD file, 2026-11-03]
mech/horn_fit.stl
196.0 x 40.0 x 3.00
