yilo425/wheel-leg-robot-delivery/mech/leg_70mm.stl

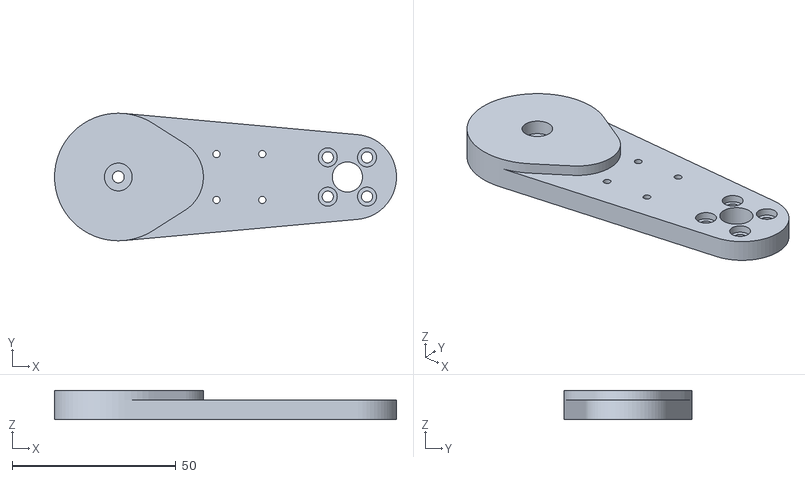
[picture p33: CAD file, 2026-11-03]
mech/leg_70mm.stl
104.5 x 39.0 x 9.00
