yilo425/wheel-leg-robot-delivery/mech/stop_block.stl

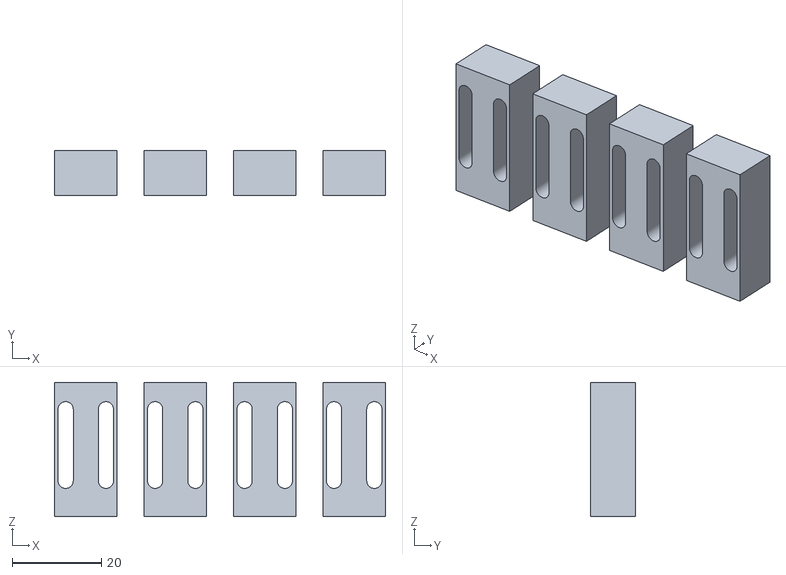
[picture p34: CAD file, 2026-11-03]
mech/stop_block.stl
74.0 x 10.0 x 30.0
