yilo425/wheel-leg-robot-delivery/mech/body_v5_upper.stl

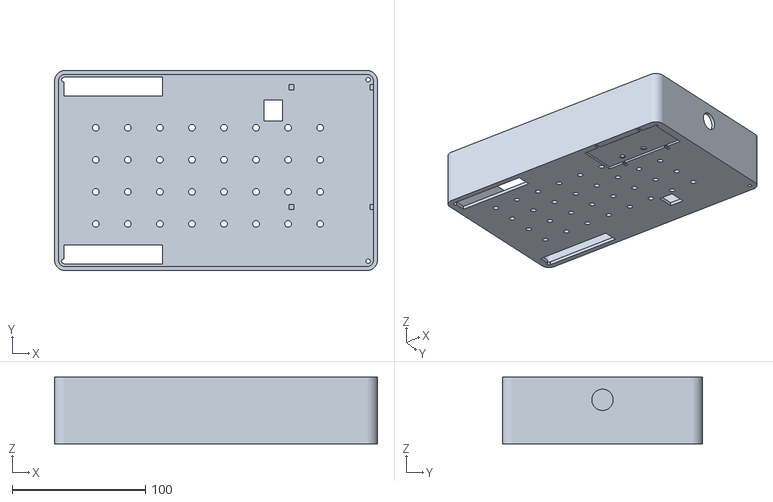
[picture p35: CAD file, 2026-11-03]
mech/body_v5_upper.stl
242.0 x 150.0 x 50.0
