yilo425/wheel-leg-robot-delivery/mech/body_v5_lower.stl

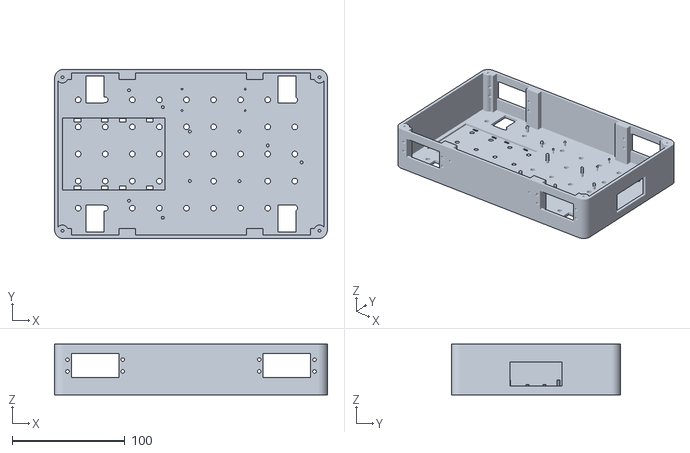
[picture p36: CAD file, 2026-11-03]
mech/body_v5_lower.stl
242.0 x 150.0 x 45.0
