yilo425/wheel-leg-robot-delivery/(list of files, cad)

Other CAD files:
mech/body_v4.scad
