yilo425/wheel-leg-robot-delivery/doc/v5装配打印说明.md

# body_v5 装配与打印说明（最终版）

> 对应提交：`body_v5.scad` L=242 版
> 打印件 4 类 + 五金 + 接线；接线细节见 [`接线总表.md`](接线总表.md)、[`杜邦线接线表.md`](杜邦线接线表.md)、[`供电硅胶线接线表.md`](供电硅胶线接线表.md)

---

## 〇、交付打印室：**2 个文件**

| 文件 | 内容 | 外形 (mm) | 说明 |
|---|---|---|---|
| **`mech/body_v5_print.stl`** | 车身下层 + 上层（**两个独立实体**）| 242 × 320 × 50 | 252 台面**放不下两个**，切片软件里 *Split to objects* 拆开后分两次打 |
| **`mech/parts_all.stl`** | **4 条腿 + 4 个挡件**（8 个独立实体）| 222 × 136 × 30 | 一板打完 ✓ |

> 如果打印室要求“一文件一零件”，单件 STL 也都导好了（见下表）。

### 两个文件的打印参数

| 文件 | 层高 | 壁 | 填充 | 支撑 | 台面 |
|---|---|---|---|---|---|
| **车身（2 层）** | 0.2 | 3 圈 | 15% | 不需要 | 242×162 → X 每边只剩 **5mm**，brim ≤ 3mm |
| **零件（腿+挡件）** | 0.2 | **4 圈** | **50~60%** | 不需要 | 222×136 → 很宽松 ✓ |

> 零件板混装，取折中值：腿要受力（4 圈壁必须），挡件只受 ~8N，
> 50~60% 填充两者都够，不用分两次打。

---

## 一、零件清单

| # | 文件 | 件数 | 尺寸 | 打印参数 |
|---|---|---|---|---|
| 1 | `mech/body_v5.scad` → `PART="lower"` | 1 | **242 × 162 × 45** | PETG / 0.2 / 3 壁 / 15% / 平放（底面朝下）|
| 2 | `mech/body_v5.scad` → `PART="upper"` | 1 | **242 × 150 × 50** | 同上 |
| 3 | `mech/leg_70mm.scad` | **4** | 104.5 × 39 × 9 | PETG / 0.2 / **4 壁 / 60~80% 填充** / 平躺（厚度朝 Z）|
| 4 | `mech/stop_block.scad` | **4** | 14 × 10 × 30 | PETG / 0.2 / **50~100% 填充** / 底面朝下 |
| — | `mech/horn_fit.scad` | 1（试装件）| — | 建议先打这个验证舵机盘六芒星配合 |

**已经导出的 STL**（可直接送打）：

```
mech/body_v5_print.stl   1.30 MB   ← 交付①  两层并排（2 个实体）
mech/parts_all.stl       1.12 MB   ← 交付②  4 腿 + 4 挡件（8 个实体）
mech/body_v5_lower.stl    915 KB   单件备用
mech/body_v5_upper.stl    384 KB   单件备用
mech/leg_70mm.stl         252 KB   单件备用（×4）
mech/stop_block.stl        62 KB   单件备用（×4）
```

> 下层 242×**162**：162 是两侧挡件凸台（各外伸 6mm）撑出来的，本体仍是 150。

### ⚠️ 台面 & 支撑

- **台面需 ≥ 242 × 162**；你的 252 台面 X 方向只剩 **5mm**（Y 方向很宽松）
  → **brim 最多 3mm，或者不用 brim**（底面是大平板，翘边风险低）
- 支撑：**不需要**（相机沉台/舵机孔都是小悬空，PETG 能扛）
- 若相机沉台顶部下垂：只在该处加局部支撑

---

## 二、五金清单

### 螺丝

| 用途 | 规格 | 数量 | 说明 |
|---|---|---|---|
| **上下层对接** | M3×12 自攻 | **4** | 穿过上层 φ3.4 孔 → 下层 φ2.6 底孔（深 10）|
| **挡件** | M3×16 自攻 | **8** | 穿过挡件 10mm + 凸台 6mm；每件 2 颗 |
| **腿 → 舵机盘** | M3×10（或舵机自带）| **4** | 腿根部 φ3.6 通孔 + φ8.5×4 沉孔 |
| **电机 → 腿** | M3×8 | **16** | 每腿 4 颗，孔距 12mm 方阵，沉孔 φ5.8×2 |
| **舵机 → 车身** | MG996R 自带自攻 | 16 | 每舵机 4 颗，耳孔 φ3.2 |

### 扎带 / 其他

| 用途 | 规格 | 数量 |
|---|---|---|
| 电池 2 处 | 3×100 | 2 |
| 充电宝 2 处 | 3×100 | 2 |
| 两个降压各 2 处 | 3×100 | 4 |
| 端子排 3 处 | 3×100 | 3 |
| 保险丝/开关 2 处 | 3×100 | 2 |
| 腿走线 每腿 2 处 | 2.5×80 | 8 |
| **合计** | | **约 24 根（买 30）** |
| 挡件橡胶垫 | 3mm 厚 | 4 片（剪 12×8）|

---

## 三、关键尺寸（核对用）

### 车身

| 项 | 值 |
|---|---|
| 内腔 | 236 × 144（L/W 各减 2×壁厚 3）|
| 下层高 / 上层高 | 45 / 50 |
| 四角固定桩 | φ10，位于 **(±114, ±68)**，下层 φ2.6 底孔深 10，上层 φ3.4 通孔 |
| 舵机穿墙孔 | 42(X)×21(Z)，中心 **(±85, ±57)**，z=26；耳孔 φ3.2 ×4 |
| 电机线孔 | 16×24，在 (±77, ±(75−18)−12)|
| 超声波孔 | 前壁 46×21，z 8…29，内沉台 2mm |
| 摄像孔 | 前壁 26×26 沉台 2mm + φ14 通孔，**中心 z=33（抬高）** |
| 挡件凸台 | 16×6×14，中心 **(±55, ±75)**，z 23…37；M3 底孔 φ2.8 ×2（z=30，间距 9）|

### 下层模块位置

| 模块 | 中心 | 尺寸 | Y 范围 |
|---|---|---|---|
| 锂电池 | (−68.5, **0**) | 88×61 | ±30.5 |
| 电机驱动板 | (17, −30) | 50×50 | −55…−5 |
| 舵机板 | (20, 45) | 62.3×25.5 | 32.5…57.5 |
| 端子排 | (15, −67) | 76×8 | −71…−63 |
| 保险丝/开关 | (20, 15) | 30×18 | 6…24 |
| 12→5 降压 | (−40, 49) | 43×21 | 38.5…59.5 |
| 12→9 降压 | (83, 0) | 43×21 | −10.5…10.5 |
| 分区矮墙 | P1 x=−20、P2 x=58 | 2.5 厚 × 12 高 | ±30 |

### 上层模块位置

| 模块 | X 范围 | Y 范围 | 说明 |
|---|---|---|---|
| FPGA | −118…**32** | ±54.5 | 紧贴后壁，自带支架 |
| **DC 弯头** | 32…46 | **+37…+53（车左）** | 插 FPGA 的 DC 座 |
| **充电宝** | 34…113（79）| **−68…−33（车右）** | 内置，2mm 槽 + 2 扎带 |
| K230 | 59…115（56）| −25…60（85）| **转 180°**，四角 4mm 限位柱 |
| 摄像头 | 115…118 | ±13 | z=33，在 K230 上方 |

**两个充电口距离 ≈ 21mm**（充电宝线 15cm，够）✓

---

## 四、装配顺序

### 第 1 步：下层（车身底）

1. **装 4 个舵机**：从**外侧**塞进侧壁的 42×21 穿墙孔，舵机盘朝外，耳片 4 颗自攻拧进 φ3.2 耳孔
   - 注意：前后两个舵机的输出轴方向要一致（都朝车外）
2. **锂电池**：放进后排 2mm 浅槽，2 根扎带从槽两侧孔穿过去压紧
   - 电池**居中**放（左右偏了会顶舵机，见第六节）
3. **端子排**（KF301-5.0，15 位）：放 (15, −67) 的浅槽，3 根扎带
4. **保险丝座 + 船型开关**：放 (20, 15) 沉台，2 根扎带
5. **电机驱动板**：4 个 φ2.6 定位柱穿过四角孔（孔距 44×44）
6. **舵机板 PCA9685**：4 个定位柱（孔距 56×19）
7. **12→5 降压**（舵机用）：放 (−40, 49)，2 根扎带
8. **12→9 降压**（FPGA 用）：放 (83, 0)，2 根扎带
9. **超声波 HC-SR04**：卡进前壁 46×21 孔的内沉台
10. **按接线表接下层线**（见 [`供电硅胶线接线表.md`](供电硅胶线接线表.md)）

### 第 2 步：合上层

11. 上层对准放下，4 根固定桩插进下层
12. **4× M3×12 自攻**，从上层孔拧进下层底孔

### 第 3 步：上层模块

13. **FPGA**：它的自带升高支架放到最靠后（贴后壁），不上螺丝
14. **K230**：**转 180° 放**（Type-C 朝车右/−Y），四角 4mm 限位柱卡住
    - 摄像头排线朝**车头**方向（转 180° 后接口在靠车尾侧，排线从上面绕过 K230 到摄像头）
15. **摄像头**：卡进前壁 26×26 沉台（z=33，在 K230 上方），镜头对准 φ14 孔
16. **充电宝**：放车右的 2mm 槽，2 根扎带；Type-C 那头朝 +Y（对着 K230 的 −X 长边）
17. **DC 弯头**：插进 FPGA 的 DC 座（车左 +Y 侧），弯头朝上，9V 线从下面的孔穿上来拧进端子
18. **Type-C 线**：充电宝口 → K230 口，直线 ~21mm，S 弯即可

### 第 4 步：腿 & 挡件

19. **电机装到腿尖**：4× M3×8（孔距 12 方阵），螺丝头藏进 φ5.8 沉孔
20. **腿装到舵机盘**：腿根部六芒星凹槽套上舵机盘，M3×10 穿过中心孔，垫片+螺丝头藏进 φ8.5 沉孔
    - **先打 `horn_fit.scad` 试配合**，紧了就用刀修凹槽臂宽
21. **挡件**：贴到侧壁外侧的凸台（y=±75+6），2× M3×16；橡胶垫塞进底面槽
22. **调挡件高度**：松开螺丝，上下滑到「腿在工作角 45° 时刚好顶住腿的挡件平台」，拧紧
    - 挡件有 16mm 长槽，±8mm 连续可调
23. **腿走线**：电机线沿腿走，每腿 2 处扎带（横向跨过腿宽）

---

## 五、接线索引

| 内容 | 看哪份文档 |
|---|---|
| 12V 汇流 / 保险丝 / 开关 / 端子排 | [`供电硅胶线接线表.md`](供电硅胶线接线表.md) |
| 所有信号线（FPGA↔驱动板↔舵机板↔传感器）| [`杜邦线接线表.md`](杜邦线接线表.md) |
| 完整接线总表 + 引脚对照 | [`接线总表.md`](接线总表.md) |
| 舵机板（PCA9685）接法 | [`舵机接线表.md`](舵机接线表.md)、[`PCA9685舵机板接入说明.md`](PCA9685舵机板接入说明.md) |
| FPGA 引脚丝印对照 | [`board_pinout.md`](board_pinout.md) |

**供电链路**（复习）：

```
3S 电池 XT60 → 5A 片式保险丝 → 船型开关 → 端子排(12V汇流)
  ├→ 四路驱动板 Vin±（18AWG）
  ├→ UBEC 12→6V/5A → 舵机板(+1000µF) → 4 舵机
  └→ LM2596 12→9V/2A → 5.5×2.1 弯头 → FPGA DC 圆口
充电宝（独立）→ Type-C → K230
```

---

## 六、⚠️ 三个必须知道的约束（踩过的坑）

### 1. 锂电池只能居中放，不能放左侧

4 个腿舵机在 **x=±85**、从左右侧壁向内侵入到 **y≈±30**。电池（61 宽）在后排正好跨过舵机的 x 位置，**偏 Y 就会撞舵机**（脚本验证：偏 2mm 就撞）。

- 现状：电池居中，侧向重心偏约 **5mm**（充电宝 100g 在车右造成）
- 影响：占总宽 3%，**可以忽略**
- 前后方向已经做到"电池在后、充电宝在前"对边放 ✓

### 2. K230 必须转 180°

- K230 的 Type-C 和 FPGA 的 DC 座**本来在同一侧**（车左），会挡住充电宝
- 转 180° 后 Type-C 跑到车右，正对充电宝，两口距离 ~21mm

### 3. 相机抬高到 z=33

- K230 高 16（z 3…19），相机的 26 高放到 z=33 就占 z 20…46，**正好在 K230 正上方**
- 这样相机不占 X 空间，是把车压到 242 的关键
- 平面图上相机和 K230 **重叠是正常的**（不同高度）

---

## 七、打印检查清单

- [ ] 4 类件全部打印完成（下层/上层/腿×4/挡件×4）
- [ ] 舵机盘试装件 `horn_fit` 配合 OK（不松不紧，稍微用力能压进）
- [ ] 腿的六芒星凹槽能套上舵机盘
- [ ] 4 根固定桩能插进下层（紧了修倒角）
- [ ] K230 四角 4mm 限位柱能卡住板子
- [ ] 充电宝能放进槽里、扎带能扣上
- [ ] 挡件能滑到正确高度顶住腿
- [ ] 电机线孔 16×24 能过 6P 排线插头
- [ ] 上下层合上后无干涉（尤其电容/排针高度）

---

## 八、已知可优化项（不影响使用）

| 项 | 说明 |
|---|---|
| 电容高度 | 驱动板上的电解电容可能顶到上层，装之前目测一下 |
| FPGA 高度 | 按 34mm 建模；若带排针超 46mm 会顶到上层顶（上层高 50）|
| K230 限位柱 4mm | 为了省 X 缩到 4×4；K230 很轻，够用，但别用蛮力压 |
| 充电宝线长度 | 15cm，两口距离 21mm，**确保 S 弯不绷紧** |
