yilo425/wheel-leg-robot-delivery/mech/body_print_top.png

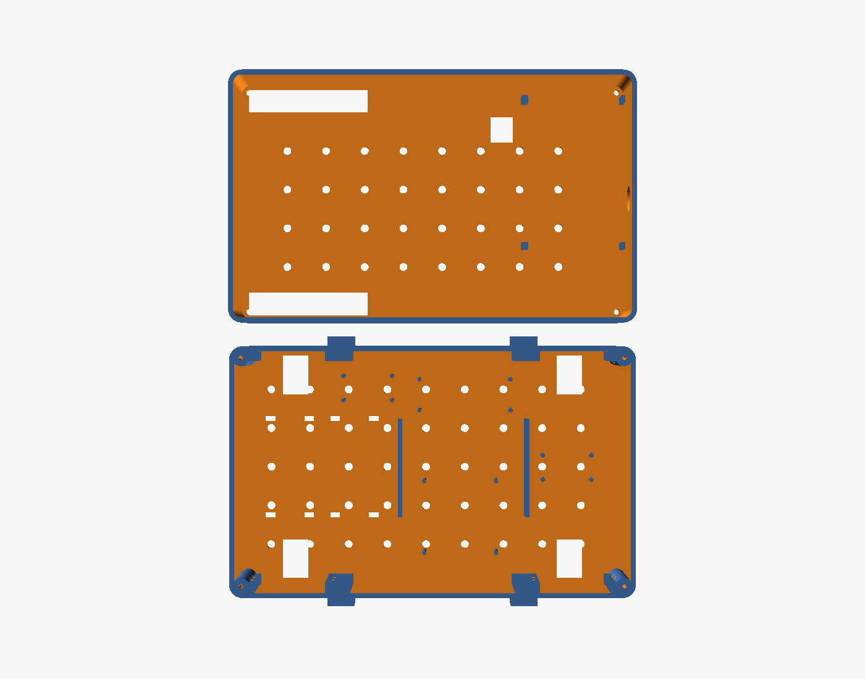
mech/body_print_top.png
