yilo425/wheel-leg-robot-delivery/mech/leg_assembly.png

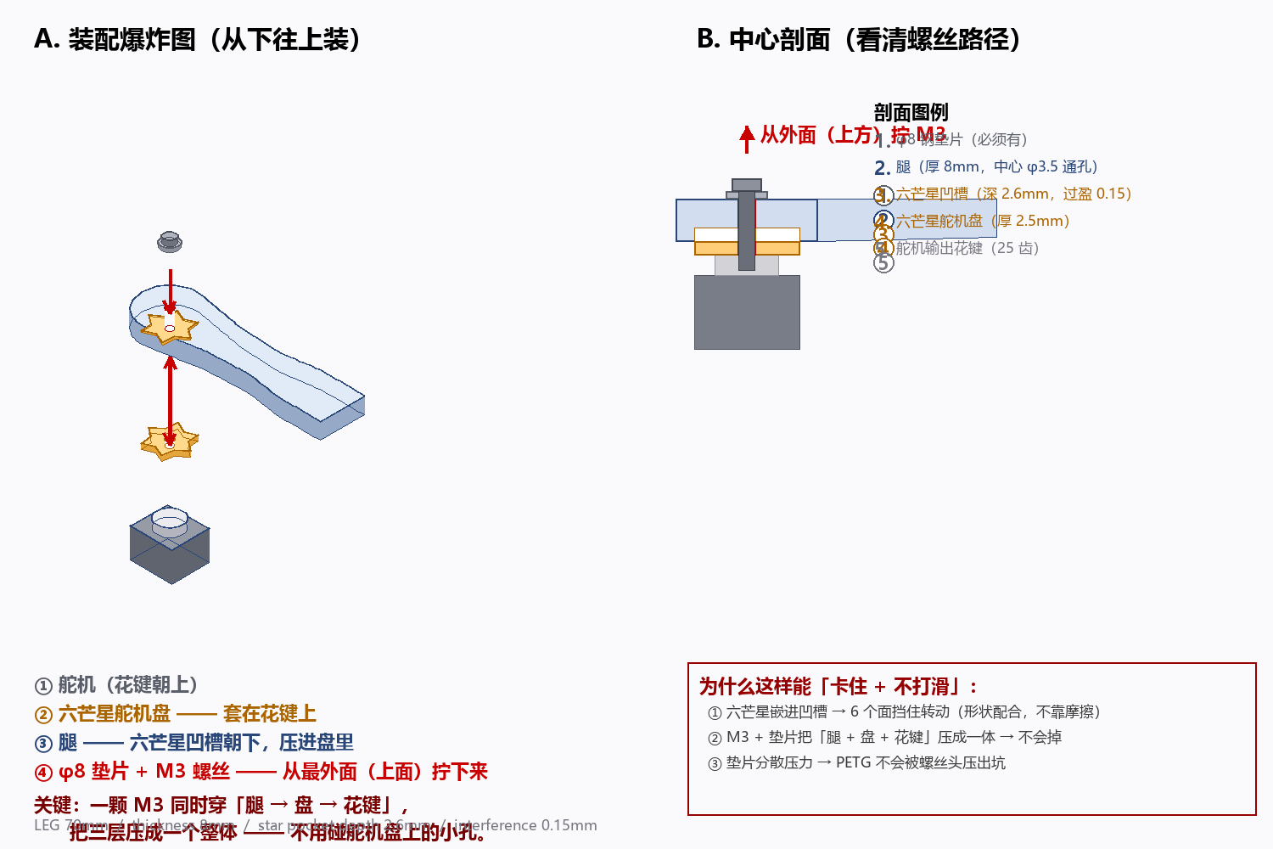
mech/leg_assembly.png
