yilo425/wheel-leg-robot-delivery/sim/imu_driver_result.txt

=== tb_imu_driver: MPU6050 驱动自检 ===
  参数: SCL=1000000Hz SAMPLE=1ms TIMEOUT=1ms BOOT=1ms ADDR=0x68
  说明: 仿真里 SCL 1MHz / 三个 ms 参数 1ms 是为了缩短时间,
        比例关系与真实配置(400kHz/20ms/100ms)一致。
  期望值(手算): ACC_GAIN=(5729*1024)/16384=358,  GYRO_GAIN=(100*1*65536)/131000=50

--- 1. 复位 ---
  [ OK ] 1.1 复位后 SCL 释放为高 : 1
  [ OK ] 1.2 复位后 SDA 释放为高 : 1
  [ OK ] 1.3 复位后 imu_valid=0 : 0
  [ OK ] 1.4 复位后 imu_err=0 : 0
  [ OK ] 1.5 复位后 roll=0 : 0
  [ OK ] 1.6 复位后 pitch=0 : 0
  [ OK ] 1.7 复位后 yaw=0 : 0

--- 2. 正常一帧（初始化 + 读 12 字节 + 换算）---
  [ OK ] 2.1 收到 imu_valid 脉冲 : 1
  [ OK ] 2.2 ★roll  == 2864 : 2864
  [ OK ] 2.3 ★pitch == 0 : 0
  [ OK ] 2.4 ★yaw   == 1 (陀螺积分1帧) : 1
  [ OK ] 2.5  init 写 0x6B = 0x00 (唤醒) : 0
  [ OK ] 2.6  init 写 0x1C = 0x00 (±2g) : 0
  [ OK ] 2.7  init 写 0x1B = 0x00 (±250°/s) : 0
  [ OK ] 2.8  init 写 0x19 = 0x09 (100Hz) : 9
  [ OK ] 2.9  init 一共写了 4 条寄存器 : 4
  [ OK ] 2.10 读过 0x3B(加速度起始) : 1
  [ OK ] 2.11 读过 0x43(陀螺起始) : 1
  [ OK ] 2.12 读方向移出 12 个数据字节 : 12

--- 3. I2C 协议 ---
  [ OK ] 3.1 出现过 START : 1
  [ OK ] 3.2 出现过 STOP : 1
  [ OK ] 3.3 收到 地址+W : 1
  [ OK ] 3.4 收到 地址+R : 1
  [ OK ] 3.5 ★复合读用了重复START : 1
  [ OK ] 3.6 地址没错过 : 0
  [ OK ] 3.7 ★SCL 高时 SDA 稳定 : 0

--- 4. 第二帧（pitch 反号 + gz=0 时 yaw 不动）---
  [ OK ] 4.1 第二帧有效 : 1
  [ OK ] 4.2 ★pitch == +2864 : 2864
  [ OK ] 4.3 roll 仍为 2864 : 2864
  [ OK ] 4.4 ★gz=0 -> yaw 保持 1 : 1

--- 5. 第三帧（roll 负方向）---
  [ OK ] 5.1 第三帧有效 : 1
  [ OK ] 5.2 ★roll == -2864 : -2864

--- 6. 数据不合理（加速度全 0）---
  [ OK ] 6.1 全 0 加速度 -> imu_err : 1
  [ OK ] 6.2 无效帧不刷新 roll : -2864
  [ OK ] 6.3 无效帧不刷新 pitch : 0
  [ OK ] 6.4 无效帧不刷新 yaw : 1

--- 7. 从机 NACK ---
  [ OK ] 7.1 NACK -> imu_err : 1
  [ OK ] 7.2 NACK 不刷新 roll : -2864
  [ OK ] 7.3 NACK 不刷新 pitch : 0
  [ OK ] 7.4 NACK 不刷新 yaw : 1

--- 8. 恢复 ---
  [ OK ] 8.1 恢复后收到 imu_valid : 1
  [ OK ] 8.2 恢复后 roll == 2864 : 2864
  [ OK ] 8.3 恢复后 pitch == 0 : 0

--- 9. 单拍脉冲 / 采样周期 ---
  [ OK ] 9.1 imu_valid 是单拍脉冲 : 0
  [ OK ] 9.2 imu_err   是单拍脉冲 : 0
  [ OK ] 9.3 采样间隔 >= SAMPLE_MS : 1
  [ OK ] 9.4 采样间隔 <= 4*SAMPLE_MS : 1

--- 10. 复位清状态 ---
  [ OK ] 10.1 复位期间 imu_valid=0 : 0
  [ OK ] 10.2 复位期间 imu_err=0 : 0
  [ OK ] 10.3 复位后 roll=0 : 0
  [ OK ] 10.4 复位后 pitch=0 : 0
  [ OK ] 10.5 复位后 yaw=0 : 0
  [ OK ] 10.6 复位后总线释放 : 1

=== tb_imu_driver: 53 checks, 0 errors ===
RESULT: PASS
