yilo425/wheel-leg-robot-delivery/sim/servo_lift_result.txt

=== tb_servo_lift: servo_lift 模块自检 ===
  参数: PERIOD=100us MIN=20us MAX=80us DEBOUNCE=1ms
  换算: PERIOD=10000拍 MIN=2000拍 MAX=8000拍 消抖=100000拍

--- 1. 复位 ---
  [ OK ] ��后 lift_done=0（未到位） : 0
  [ OK ] �后 lift_fault=0（无故障） : 0

--- 2. 舵机 PWM: 放下位置（短脉宽）---
  [info] 放下时高电平 = 2000 拍（期望 2000）
  [ OK ] 1 放下前腿: 脉宽 = PWM_MIN : 1
  [info] 周期 = 10000 拍（期望 10000）
  [ OK ] 2.2 PWM 周期正确 : 1

--- 3. 舵机 PWM: 抬起位置（长脉宽）---
  [info] 抬起时高电平 = 8000 拍（期望 8000）
  [ OK ] 1 抬起前腿: 脉宽 = PWM_MAX : 1
  [ OK ] 3.2 抬起脉宽 > 放下脉宽 : 1
  [ OK ] ��腿仍是放下（短脉宽） : 1

--- 4. ★限位开关极性（低有效 -> 高有效）---
  [ OK ] 未按下(引脚=1): lift_done=0 : 0
  [ OK ] ��下(引脚=0): lift_done=2'b11 : 3
  [ OK ] .3 只按前腿: lift_done=2'b01 : 1
  [ OK ] 4.4 松开: lift_done 回 0 : 0

--- 5. ★消抖：抖动不被采信 ---
  [ OK ] 5.1 稳定未按下: lift_done=0 : 0
  [ OK ] 后仍为 0（没被误采信） : 0
  [ OK ] 5.3 抖完稳定: 仍是 0 : 0
  [ OK ]  持续按下够久: 采信为 1 : 3

--- 6. 故障输入（低有效，不接=正常）---
  [ OK ] =1): lift_fault=0（无故障） : 0
  [ OK ] �障(引脚=0): lift_fault=2'b10 : 2
  [ OK ] 3 故障消除: lift_fault 回 0 : 0

--- 7. 复位清状态 ---
  [ OK ] 7.1 复位前: lift_done=2'b11 : 3
  [ OK ] 7.2 复位后立刻: lift_done=0 : 0

--- 8. 抬腿高度（0x10）---
  [ OK ] 8.1 height=100 -> 脉宽=MAX_US : 8000
  [ OK ] 8.2 height=50 -> 脉宽=中值 : 5000
  [ OK ] 8.3 height=0 -> 脉宽=MIN_US : 2000
  [ OK ] 8.4 height=200 钳到 100 : 8000
  [ OK ] �脉宽与高度无关（=MIN） : 2000

=== tb_servo_lift: 25 checks, 0 errors ===
RESULT: PASS
