yilo425/wheel-leg-robot-delivery/sim/telemetry_payload_result.txt

=== tb_telemetry_payload ===

--- 1. 帧头字段 ---
  [ OK ] 1.1 发过 tx_req : 1
  [ OK ] 1.2 tx_len = 13 : 13
  [ OK ] 1.3 tx_type = 0x10 : 16

--- 2. 典型值（大端 + 有符号）---
  [ OK ] 2.1  [0] state=2 : 2
  [ OK ] 2.2  [1] spd_l 高字节 : 4
  [ OK ] 2.3  [2] spd_l 低字节 : 210
  [ OK ] 2.4  [3] spd_r 高字节 : 251
  [ OK ] 2.5  [4] spd_r 低字节 : 46
  [ OK ] 2.6  [5] dist 高字节 : 4
  [ OK ] 2.7  [6] dist 低字节 : 210
  [ OK ] 2.8  [7] roll 高字节 : 1
  [ OK ] 2.9  [8] roll 低字节 : 44
  [ OK ] 2.10 [9] pitch 高字节 : 255
  [ OK ] 2.11 [10] pitch 低字节 : 56
  [ OK ] 2.12 [11] yaw 高字节 : 1
  [ OK ] 2.13 [12] yaw 低字节 : 194

--- 3. 速度饱和（24->16 有符号）---
  [ OK ] 40000 饱和到 +32767 高字节 : 127
  [ OK ] 40000 饱和到 +32767 低字节 : 255
  [ OK ] 40000 饱和到 -32768 高字节 : 128
  [ OK ] 40000 饱和到 -32768 低字节 : 0
  [ OK ] �态位只有 3 位（state=1） : 1

--- 4. 距离边界 ---
  [ OK ] 4.1  dist=0 高字节 : 0
  [ OK ] 4.2  dist=0 低字节 : 0
  [ OK ] 4.3  dist=65535 高字节 : 255
  [ OK ] 4.4  dist=65535 低字节 : 255

--- 5. 每轮字节数 ---
  [ OK ] 5.1 一轮正好写 13 字节 : 13
  [ OK ]  没有写到 13 号地址之外 : 238

=== tb_telemetry_payload: 27 checks, 0 errors ===
RESULT: PASS
