yilo425/wheel-leg-robot-delivery/sim/top_i2c_share_result.txt

=== tb_top_i2c_share: TOF + IMU 共享一条 I2C 总线 ===
  SCL=1000000Hz  SAMPLE=1ms  TOF_ADDR=0x29  IMU_ADDR=0x68
  从机: TOF 给 1234mm;  IMU 给 ay=8192 -> 期望 roll=2864

--- 1. 复位 ---
  [ OK ] 1.1 复位中 SCL 释放为高 : 1
  [ OK ] 1.2 复位中 SDA 释放为高 : 1

--- 2. 两个器件都出数 ---
  [ OK ] 2.1 TOF 出了有效帧 : 1
  [ OK ] 2.2 ★TOF 距离 == 1234 : 1234
  [ OK ] 2.3 IMU 出了有效帧 : 1
  [ OK ] 2.4 ★IMU roll == 2864 : 2864

--- 3. 各自的初始化到达各自的器件 ---
  [ OK ] 3.1 VL53L0X 收到 0x88=0x00 : 0
  [ OK ] 3.3 VL53L0X 收到 0x4E=0x2C : 44
  [ OK ] 3.2 VL53L0X 收到过 0x00=0x01（启动过测距） : 1
  [ OK ] 3.4 MPU6050 收到 0x6B=0x00 : 0
  [ OK ] 3.5 MPU6050 收到 0x19=0x09 : 9
  [ OK ] 3.6 TOF 模型收到过自己的地址+W : 1
  [ OK ] 3.7 IMU 模型收到过自己的地址+W : 1

--- 4. ★ 交叉污染检查 ---
  [ OK ] 4.1 ★VL53L0X 的 0x19 未被 MPU 事务污染 : 0
  [ OK ] 4.2 ★MPU6050 的 0x4E 未被 TOF 事务污染 : 0

--- 5. I2C 协议与授权 ---
  [ OK ] 5.1 TOF 侧：SCL 高时 SDA 稳定 : 0
  [ OK ] 5.2 IMU 侧：SCL 高时 SDA 稳定 : 0
  [ OK ] 5.3 TOF 拿到过 grant : 1
  [ OK ] 5.4 IMU 拿到过 grant : 1
  [ OK ] 5.5 两个驱动都用过总线（TOF 有事务） : 1
  [ OK ] 5.6 两个驱动都用过总线（IMU 有事务） : 1

--- 6. ★ 连续多帧稳定 ---
  [ OK ] 6.1 12 轮里 TOF 距离始终正确（跳变次数=0） : 0
  [ OK ] 6.2 12 轮里 IMU roll 始终正确（跳变次数=0） : 0
  [ OK ] 6.3 期间 TOF 帧数 >= 12 : 1
  [ OK ] 6.4 期间 IMU 帧数 >= 12 : 1

--- 7. TOF 仍驱动车辆行为 ---
  [ OK ] 7.1 启动后 state=AUTO : 2
  [ OK ] 7.2 距离 1234mm -> speed=FULL : 2
  [ OK ] 7.3 编号 3.4 之后 IMU 仍在出数 : 1

  [info] TOF 帧=15  IMU 帧=18  TOF grant 拍=486233  IMU grant 拍=460900

=== tb_top_i2c_share: 28 checks, 0 errors ===
RESULT: PASS
