yilo425/wheel-leg-robot-delivery/sim/top_integration_result.txt

=== tb_top_integration ===
  [info] CLK=50000000 PWM=20000 PERIOD_CNT=2500 VREF=60 KP_SHIFT=1 LIMIT=120
  [info] 距离阈值 STOP=200 SLOW=500 CLEAR=800 mm
  [ OK ] C1 KEY_IDLE  的 bit1=1 (key[1] 松开) : 1
  [ OK ] C2 KEY_IDLE  的 bit0=1 (key[0] 松开) : 1
  [ OK ] C3 KEY_ESTOP 的 bit1=0 (key[1] 按下 = 急停) : 0
  [ OK ] C4 KEY_ESTOP 的 bit0=1 (key[0] 松开，不能误触发启动) : 1
  [ OK ] C5 KEY_START 的 bit0=0 (key[0] 按下 = 启动) : 0
  [ OK ] C6 KEY_START 的 bit1=1 (key[1] 松开，不能误触发急停) : 1

--- 1. 复位期间 ---
  [ OK ] 1.1 复位中 state=IDLE : 0
  [FAIL] 1.2 复位中 m_en=0 : got=1 exp=0
  [ OK ] 1.3 复位中 led[0]=0 : 0
  [ OK ] 1.4 复位中: 舵机在放下位置 : 1

--- 2. 释放复位（未按启动键）---
  [ OK ] 2.1 复位释放: led[0]=1 : 1
  [ OK ] 2.2 未启动: state=IDLE : 0
  [FAIL] 2.3 未启动: m_en=0 : got=1 exp=0
  [ OK ] 2.4 未启动: led[1]=0 : 0

--- 3. 按键启动 -> AUTO ---
  [FAIL] 3.1 按 key[0]: state=AUTO : got=0 exp=2
  [ OK ] 3.2 AUTO: m_en=1 : 1
  [ OK ] 3.3 AUTO: led[1]=1 : 1
  [ OK ] 3.4 AUTO 距离远(2000mm): speed=FULL : 2
  [info] AUTO 静止时占空比高电平 = 1271 (期望约 570)
  [ OK ] 3.5 AUTO: PWM 有输出(>100 拍) : 1

--- 4. 避障：近距离 -> AVOID ---
  [FAIL] 4.1 距离 150mm: state=AVOID : got=0 exp=3
  [FAIL] 4.2 AVOID: m_en=0 : got=1 exp=0
  [ OK ] 4.3 AVOID: led[2]=1 : 1
  [FAIL] 4.4 AVOID 停车: PWM 高电平约 0 : got=0 exp=1
  [FAIL] 4.5 距离变远(1000mm): 恢复 AUTO : got=0 exp=2
  [ OK ] 4.6 恢复: m_en=1 : 1
  [ OK ] 4.7 恢复: led[2]=0 : 0

--- 5. 越障(模式0)：视觉报低矮障碍 -> 四腿一起抬 ---
  [FAIL] 5.1 低矮障碍: state=LIFT : got=0 exp=4
  [info] 抬腿时前腿舵机脉宽 = 125000 拍 (约 2500 us)
  [ OK ] 5.2 抬腿中: lift_pwm 前腿=抬起(脉宽>1.5ms) : 1
  [FAIL] 5.3 抬腿中: m_en=0 : got=1 exp=0
  [FAIL] 5.4 限位到位: 仍在 LIFT(进入通过阶段) : got=0 exp=4
  [ OK ] 5.5 通过中: m_en=1 : 1
  [ OK ] 5.6 通过中: speed=SLOW : 1
  [FAIL] 5.7 一直不松开限位: 仍在 LIFT : got=0 exp=4
  [FAIL] 5.8 收腿完成: state=AUTO : got=0 exp=2

--- 5b. 越障(模式1)：视觉报台阶 -> 两腿分段 ---
  [FAIL] 5b.1 台阶: state=LIFT : got=0 exp=4
  [FAIL] 5b.2 先抬前腿: m_en=0 : got=1 exp=0
  [ OK ] 5b.3 前腿抬起: lift_pwm[1]=短脉宽(后腿没抬) : 1
  [FAIL] 5b.4 前腿到位后: 进入前轮上位 : got=0 exp=4
  [ OK ] 5b.5 前轮上位: m_en=1 : 1
  [FAIL] 5b.6 前轮上位完成: 抬后腿 : got=0 exp=4
  [FAIL] 5b.7 抬后腿时 m_en=0 : got=1 exp=0
  [FAIL] 5b.8 后腿到位: 进入后轮上位 : got=0 exp=4
  [ OK ] 5b.9 后轮上位: m_en=1 : 1
  [FAIL] 5b.10 跨台阶完成: state=AUTO : got=0 exp=2

--- 6. 编码器反馈影响输出（闭环真的通了）---
  [info] 静止占空比 = 1087
  [info] 正转时占空比 = 1271
  [FAIL] 6.1 有反馈时输出稳定（不因反馈抖动） : got=0 exp=1
  [ OK ] 6.2 正转: 方向脚为正 : 1
  [ OK ] 6.2b 第二方向脚 = !方向脚(bit0) : 0

--- 7. 急停通路（按键 -> 0 拍断使能）---
  [FAIL] 7.1 ★按急停当拍: m_en=0 : got=1 exp=0
  [FAIL] 7.2 按急停: state=ESTOP : got=0 exp=6
  [ OK ] 7.3 按急停: led[1]=0 : 0
  [ OK ] 7.4 人为急停: error_flag=0 : 0
  [FAIL] 7.5 急停: PWM 高电平约 0 : got=0 exp=1
  [FAIL] 7.6 急停解除未按启动: 仍 ESTOP : got=0 exp=6
  [ OK ] 7.7 ★急停解除后 error_flag 仍 0 : 0
  [FAIL] 7.8 急停解除未按启动: m_en=0 : got=1 exp=0

--- 8. 到达终点 ---
  [ OK ] 8.1 重新启动: state=IDLE : 0
  [FAIL] 8.2 再启动: state=AUTO : got=0 exp=2
  [FAIL] 8.3 goal_reached: state=GOAL : got=0 exp=5
  [FAIL] 8.4 GOAL: m_en=0 : got=1 exp=0

--- 12. ARM 实测标准帧（原样灌入）---
  [FAIL] 12.1 准备: state=AUTO : got=0 exp=2
  [ OK ] 12.2 合法帧: uart_rx_ok_cnt>=1 : 1
  [ OK ] 12.3 无错帧: uart_rx_err_cnt=0 : 0
  [ OK ] 12.4 视觉帧计数 +1 : 1
  [ OK ] 12.5 无格式错: vision_bad_cnt=0 : 0
  [FAIL] 12.6 0x02 障碍物 -> state=AVOID : got=0 exp=3
  [ OK ] 12.7 AVOID: m_en=1（限速绕行） : 1
  [ OK ] 12.8 AVOID: speed_scale=SLOW : 1

=== tb_top_integration: 67 checks, 30 errors ===
RESULT: FAIL
