yilo425/wheel-leg-robot-delivery/sim/top_servo_pca_result.txt

=== tb_top_servo_pca（SERVO_IF=1，挂 PCA9685 从机模型）===
  [ OK ] 1.1 复位期间 pca_init_done=0 : 0
  [ OK ] 1.2 复位期间 I2C 无事务 : 0

--- 2. 初始化序列 ---
  [ OK ] 2.1 初始化完成 init_done=1 : 1
  [ OK ] 2.2 init_done 那一刻正好 4 次事务 : 4
  [ OK ] 2.3 SCL 有翻转（总线真的动了） : 1
  [ OK ] 2.4 MODE1 先写过 SLEEP(0x10) : 1
  [ OK ] 2.5 PRE_SCALE=121（50Hz） : 121
  [ OK ] 2.6 MODE2=0x04（OUTDRV） : 4
  [ OK ] 2.7 MODE1 最后=0x20（AI+唤醒） : 32

--- 3. PCA9685 有应答（ACK）---
  [ OK ] 3.1 没有 NACK（err_sticky=0） : 0
  [ OK ] 3.2 地址全对（addr_bad_cnt=0） : 0
  [ OK ] 3.3 I2C 时序无违规（hold_err=0） : 0

--- 4. 抬腿命令触发 16 次写入 ---
  [ OK ] 4.1 新增 16 次 I2C 事务 : 16
  [ OK ] 4.2 本轮 4 个通道都写了 OFF : 4
  [ OK ] 4.3 ch0（前左）=102+50*4=302 : 302
  [ OK ] 4.4 ch1（前右）=302 : 302
  [ OK ] 4.5 ch2（后左）=302 : 302
  [ OK ] 4.6 ch3（后右）=302 : 302

--- 5. 目标不变不重复写 ---
  [ OK ] 5.1 10ms 内事务数不增加 : 0

--- 6. 改高度再写 16 次 ---
  [ OK ] 6.1 新增 16 次 I2C 事务 : 16
  [ OK ] 6.2 本轮又写 4 个通道 OFF : 4
  [ OK ] 6.3 ch0=102+80*4=422 : 422
  [ OK ] 6.4 ch3=422 : 422

--- 7. 其它通路正常 ---
  [ OK ] 7.1 state_dbg 不是 X : 1
  [ OK ] 7.2 m_en 是确定值 : 1
  [ OK ] 7.3 uart_tx 是确定值 : 1

=== tb_top_servo_pca: 26 checks, 0 errors ===
RESULT: PASS
