yilo425/wheel-leg-robot-delivery/sim/gowin_prim_result.txt

=== tb_gowin_prim: Gowin 原语库 ↔ ModelSim 链路冒烟 ===
  [info] 本 tb 例化真实 Gowin 原语（LUT4/IOBUF/GSR/OSC）。
  [info] 库缺失 / 版本不对 / 路径不对 -> 编译或 elaborate 会直接失败。
  [info] 判版本：库里有 MODULE DQS = V1.9.11 建的（过期）；没有 = V1.9.12。

--- 0. 起步状态 ---
  [ OK ] 0.1 IOBUF 释放 + 上拉 -> 线为高 : 1

--- 1. LUT4 查表（INIT=16'h8000）---
  [ OK ] 1.1 0000 -> F=0 : 0
  [ OK ] 1.2 1000 -> F=0 : 0
  [ OK ] 1.3 0111 -> F=0 : 0
  [ OK ] 1.4 1110 -> F=0 : 0
  [ OK ] 1.5 1111 -> F=1（位序正确） : 1

--- 2. IOBUF 三态 ---
  [ OK ] 2.1 OEN=0 I=1 -> 驱动线为高 : 1
  [ OK ] 2.2 OEN=0 I=1 -> O=1 : 1
  [ OK ] 2.3 OEN=0 I=0 -> 驱动线为低 : 1
  [ OK ] 2.4 OEN=0 I=0 -> O=0 : 1
  [ OK ] 2.5 OEN=1 释放 -> 靠上拉为高 : 1
  [ OK ] 2.6 OEN=1 O 跟随 IO(高) : 1
  [ OK ] 2.7 OEN=1 对端拉低 -> 线为低 : 1
  [ OK ] 2.8 OEN=1 O 跟随 IO(低) : 1

--- 3. GSR ---
  [ OK ] 3.1 GSR 例化成功（能跑到这里即证明） : 1

--- 4. OSC 振荡器 ---
  [ OK ] 4.1 OSC 2000ns 内上升沿 >= 50 : 1
  [ OK ] 4.2 OSCOUT 不是 x : 1

=== tb_gowin_prim: 17 checks, 0 errors ===
RESULT: PASS
