yilo425/wheel-leg-robot-delivery/sim/motion_loop_result.txt

=== tb_motion_loop (闭环) ===
  VREF=69 KP_SHIFT=1 被控对象 G=1 TAU=3

  win  duty  spd
    0    34    11
    5    45    37
   10    54    50
   15    60    57
   20    64    62
   25    66    64
   30    67    66
   35    69    67
   40    69    68
   45    70    68
   50    70    68
   55    71    69
   60    71    69
   65    71    69
   70    71    69
   75    71    69
   80    71    69
   85    71    69
   90    71    69
   95    71    69
  100    71    69
  105    71    69
  110    71    69
  115    71    69
  120    71    69
  125    71    69
  130    71    69
  135    71    69
  140    71    69
  145    71    69
  150    71    69
  155    71    69

  稳态（最后 10 窗口）: min=69 max=69 avg=69, 目标=69
  占目标比例: 100%
  理论预期 spd_ss = VREF*G/(G+KP分母) = 23

--- 1. 结构性 ---
  [ OK ] 有占空比输出（不是 0） : 1
  [ OK ]  电机转起来了（spd > 0） : 1
  [ OK ] 1.3 方向为正（前进） : 1
  [ OK ] .4 占空比没超过 LIMIT_DUTY : 1

--- 2. 收敛性 ---
  [ OK ] ��（最后 10 窗极差 <= 1） : 1
  [ OK ] ��（spd 全程 <= 目标*1.2） : 1

--- 3. 稳态精度（★ 这一条反映控制律设计）---
  [info] 稳态 69 / 目标 69 = 100%
  [ OK ] 3.1 稳态误差在 10%% 以内 : 1

--- 4. 鲁棒性：被控对象增益翻倍（G=2）---
  [info] G=2 稳态 69 / 目标 69 = 100%，极差 0
  [ OK ] 态仍接近目标（10%% 内） : 1
  [ OK ] 时没有振荡（极差 <= 2） : 1
  [ OK ] �没有跑飞（<= 目标*1.2） : 1

=== tb_motion_loop: 10 checks, 0 errors ===
RESULT: PASS
