yilo425/wheel-leg-robot-delivery/sim/pca9685_drv_result.txt

=== tb_pca9685_drv ===
  CLK=50000000 PRESCALE 应为 121

--- 1. 上电初始化 ---
  [ OK ] 1.1 复位期间 init_done=0 : 0
  [ OK ] 1.2 PRE_SCALE = 121 : 121
  [ OK ] 3 MODE1 最终 = 0x20(AI+唤醒) : 32
  [ OK ] 1.4 MODE2 = 0x04(推挽) : 4
  [ OK ] 1.5 初始化完成 init_done=1 : 1
  [ OK ] 1.6 没有 NACK 错误 : 0

--- 2. 通道寄存器布局 ---
  [ OK ] 2.1 通道0 ON_L=0 : 0
  [ OK ] 2.2 通道0 ON_H=0 : 0
  [ OK ] 2.3 通道1 ON_L=0 : 0
  [ OK ] 2.4 通道2 ON_L=0 : 0
  [ OK ] 2.5 通道3 ON_L=0 : 0

--- 3. 全部放下 ---
  [ OK ] 3.1 通道0 计数值=102 : 102
  [ OK ] 3.2 通道3 计数值=102 : 102

--- 4. 全部抬起，高度 50 ---
  [ OK ] 4.1 通道0 计数值=302 : 302
  [ OK ] 4.2 通道1 计数值=302 : 302
  [ OK ] 4.3 通道2 计数值=302 : 302
  [ OK ] 4.4 通道3 计数值=302 : 302

--- 5. ★ 只有前腿抬起（验证通道独立）---
  [ OK ] 5.1 通道0(前) 计数值=502 : 502
  [ OK ] 5.2 通道1(前) 计数值=502 : 502
  [ OK ] 5.3 通道2(后) 计数值=102 : 102
  [ OK ] 5.4 通道3(后) 计数值=102 : 102

--- 6. 高度超范围钳位 ---
  [ OK ] 6.1 height=200 钳到 100 -> 502 : 502

--- 7. 不重复写 ---
  [ OK ] �标没变 -> 事务数不增加 : 0

--- 8. 改高度会触发重写 ---
  [ OK ] 8.1 事务数增加 16 条 : 16
  [ OK ] 8.2 新计数值 = 102+240=342 : 342

=== tb_pca9685_drv: 25 checks, 0 errors ===
RESULT: PASS
