yilo425/wheel-leg-robot-delivery/sim/tof_driver_result.txt

=== tb_tof_driver: VL53L0X 驱动自检 ===
  参数: SCL=1000000Hz SAMPLE=1ms TIMEOUT=1ms BOOT=1ms DIST_MAX=2000mm
  说明: 仿真里 SCL 1MHz / 三个 ms 参数 1ms 是为了缩短时间,
        比例关系与真实配置(400kHz/50ms/100ms)一致。

--- 1. 复位 ---
  [ OK ] 1.1 复位后 SCL 释放为高 : 1
  [ OK ] 1.2 复位后 SDA 释放为高 : 1
  [ OK ] 1.3 复位后 dist_valid=0 : 0
  [ OK ] 1.4 复位后 dist_err=0 : 0

--- 2. 正常测距（官方初始化 + 前导 + 启动 + 轮询 + 读数）---
  [ OK ] 2.1 收到 dist_valid 脉冲 : 1
  [ OK ] 2.2 dist_mm==1234 : 1234
  [ OK ] 2.3 init 写 0x88=0x00 : 0
  [ OK ] 2.4 init 写 0x44=0x00 : 0
  [ OK ] 2.5 init 写 0x45=0x20 : 32
  [ OK ] 2.6 写 0x00=0x01 启动 : 1
  [ OK ] 2.7 写 0x0B=0x01 清中断 : 1
  [ OK ] 2.8 轮询 0x13 达 2 次 : 1
  [ OK ] 2.9 读过寄存器 0x1E : 1
  [ OK ] 2.10 读过寄存器 0x1F : 1
  [info] 初始化阶段写入 104 笔, 校验和 = 0x7f80f14a (期望 0x7f80f14a)
  [info] 闭窗后第一笔写 = 0x80=0x01 (期望 0x80=0x01)
  [ OK ] 2.11 init 写入总数=104 : 104
  [ OK ] 2.12 init 序列校验和匹配 : 1
  [ OK ] 2.13 闭窗后首笔=0x80=0x01 : 1
  [ OK ] 2.14 tuning 0x4E=0x2C : 44
  [ OK ] 2.15 tuning 0x52=0x96 : 150
  [ OK ] 2.16 tuning 0x51=0x00 写过 : 1
  [ OK ] 2.17 tuning 0x70=0x04 : 4
  [ OK ] 2.18 tuning 0x71=0x01 : 1
  [ OK ] 2.19 tuning 0x72=0xFE : 254
  [ OK ] 2.20 翻页 0xFF=0x01 写过 : 1
  [ OK ] 2.21 停在页 0 (0xFF=0x00) : 0
  [ OK ] 2.22 写 0x01=0xF8 一次 : 1
  [ OK ] 2.23 最终 0x01=0xE8 : 232
  [ OK ] 2.24 写 0x0A=0x04 : 4
  [ OK ] 2.25 0x60 读改写 |=0x12 : 210
  [ OK ] 2.26 0x84 读改写 &=~0x10 : 239
  [ OK ] 2.27 0x84 最终值=0xEF : 239
  [ OK ] 2.28 校准VHV命令0x41写1次 : 1
  [ OK ] 2.29 校准后轮询过 0x13 : 1
  [ OK ] 2.30 stop_var 读回并回写=0x5A : 90
  [ OK ] 2.31 相位校准命令0x01=0x02 : 1

--- 3. I2C 时序与协议 ---
  [ OK ] 3.1 总线上出现过 START : 1
  [ OK ] 3.2 总线上出现过 STOP : 1
  [ OK ] 3.3 从机收 地址+W : 1
  [ OK ] 3.4 从机收 地址+R : 1
  [ OK ] 3.5 没有出现地址不匹配 : 0
  [ OK ] 3.6 ★复合读用重复START : 1
  [ OK ] 3.7 主机末字节发NACK : 1
  [ OK ] 3.8 ★SCL高时SDA稳定 : 0

--- 4. 周期采样 / 单拍脉冲 ---
  [ OK ] 4.1 出现第二帧 : 1
  [ OK ] 4.2 采样间隔 >= SAMPLE_MS : 1
  [ OK ] 4.3 采样间隔 <= 3*SAMPLE_MS : 1
  [ OK ] 4.4 dist_valid 单拍 : 0
  [ OK ] 4.5 dist_err 单拍 : 0
  [ OK ] 4.6 每帧前写 0x91=stop_var : 1

--- 5. 读数合理性检查 ---
  [ OK ] 5.1 超量程->dist_err : 1
  [ OK ] 5.2 超量程无 valid : 1
  [ OK ] 5.3 无效不刷 dist_mm : 1234
  [ OK ] 5.4 读数为 0 -> dist_err : 1
  [ OK ] 5.5 恢复->dist_valid : 1
  [ OK ] 5.6 恢复后 dist_mm == 1500 : 1500

--- 6. 从机不应答 ---
  [ OK ] 6.1 NACK->dist_err : 1
  [ OK ] 6.2 NACK 无 valid : 1

--- 7. ★时钟拉伸 / 超时保护 ---
  [ OK ] 7.1 ★拉低SCL->超时 : 1
  [ OK ] 7.2 ★超时后 SCL 释放 : 1
  [ OK ] 7.3 ★超时后 SDA 释放 : 1

--- 8. 恢复 ---
  [ OK ] 8.1 恢复->dist_valid : 1
  [ OK ] 8.2 恢复后 dist_mm == 800 : 800
  [ OK ] 8.3 再次初始化 0x60 读改写=0x13 : 19
  [ OK ] 8.4 再次初始化 0x84 读改写=0x00 : 0
  [ OK ] 8.5 再次回写 stop_var=0x3C : 60

--- 9. 复位清状态 ---
  [ OK ] 9.1 复位期间 dist_valid=0 : 0
  [ OK ] 9.2 复位期间 dist_err=0 : 0
  [ OK ] 9.3 复位总线释放 : 1

=== tb_tof_driver: 68 checks, 0 errors ===
RESULT: PASS
