yilo425/wheel-leg-robot-delivery/arm/k230_20261018/arm_k230_release_20261018/arm/assets/debug_test_red.png

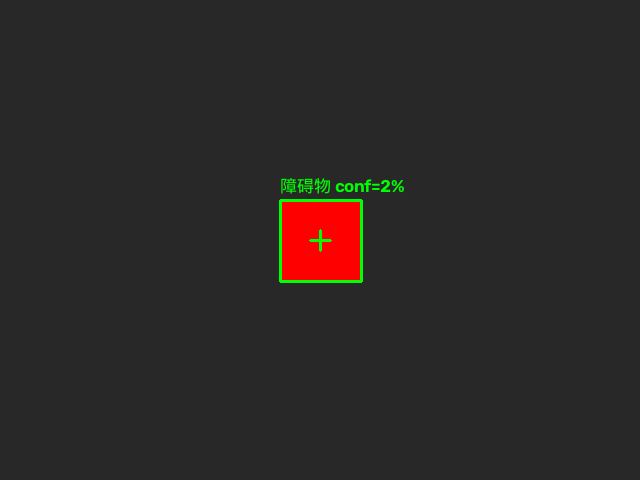
arm/k230_20261018/arm_k230_release_20261018/arm/assets/debug_test_red.png
