yilo425/wheel-leg-robot-delivery/fix/README.md

# fix/ —— 待验证的修复版本

> 这里放**还没上板验证**的修复/改进版。
> 生产版始终在 `arm/` 下，`fix/` 里任何东西**都不影响**生产环境 ✓

## 目录

| 目录 | 内容 | 状态 |
|---|---|---|
| **`20261101_后退修复/`** | `wifi_rc_revfix.py`（36929 字节）—— 修好【后退】按钮 | ⬜ **待上板验证** |

---

## 使用方式（统一）

```
① K230 断电 → 插上 → 等 CanMV 盘
② 把该目录里的 .py 拖进 CanMV\sdcard\，改名为 wifi_rc.py 覆盖
③ 断电 → 上电 → 等 25 秒
④ 手机开 http://192.168.169.1:8080/h
⑤ 打开 http://192.168.169.1:8080/ver 确认版本号带后缀
```

## 回退方式（统一）

```
把 arm\wifi_rc.py 拖回卡里覆盖即可 ✓
```

---

## 当前生产版（冻结，别动）

| 文件 | 大小 | 说明 |
|---|---|---|
| `arm/wifi_rc.py` | **36220** | 遥控可用版（**后退是坏的，别按**）|
| `arm/uart_proto.py` | 23963 | 协议库 |
| `arm/main.py` | 3180 | 开机启动器 |

## 实验区（不影响生产）

| 位置 | 内容 |
|---|---|
| `exp/rc_ext/wifi_rc_ext.py` | 扩展版：手动/自动、前后左右、90°转弯、升降（自检 70/70 绿，未上板）|
| `exp/rc_ext/README.md` | 13 条血泪经验（LF/memoryview/try-except/零JS…）|
